danwerner21/ISA_IO/VIDEO/pico/README.md

## This work is derived from the AppleII VGA project located here: https://github.com/markadev/AppleII-VGA
## Many thanks to Mark Aikens and David Kuder for their work on this project

# Set Up Raspberry Pi Pico SDK and build the firmware

## Windows Subsystem for Linux (WSL)
Windows Subsystem for Linux (WSL) allows you to install a complete Ubuntu terminal environment in minutes on your Windows machine, allowing you to develop cross-platform applications without leaving Windows. [Install Ubuntu on WSL for Windows](https://ubuntu.com/tutorials/install-ubuntu-on-wsl2-on-windows-10#1-overview)

## Install development packages
```shell
sudo apt update
sudo apt install -y build-essential git cmake gcc-arm-none-eabi
```

## Download the Pico SDK
```shell
git clone https://github.com/raspberrypi/pico-sdk.git ~/pico-sdk
git -C ~/pico-sdk submodule update --init
```

## Build the firmware 
```shell
cd pico
mkdir build
cd build
cmake  ..
make
## Install the firmware
Hold down the BOOTSEL button and connect the Raspberry Pi Pico to your PC via micro USB cable. Once Pico is
connected release the BOOTSEL button. Pi Pico should be connected to PC with USB mass storage device mode.

A disk volume called RPI-RP2 will appear on your computer. Drag and drop the applevga.uf2 file to that volume.
RPI-RP2 will unmount and Pico will start the program.
