danwerner21/ISA_IO/VIDEO/pico/build/picotool/tmp/picotoolBuild-cfgcmd.txt

cmd='/usr/bin/cmake;--no-warn-unused-cli;-DCMAKE_MAKE_PROGRAM:FILEPATH=/usr/bin/gmake;-DPICO_SDK_PATH:FILEPATH=/home/dwerner/pico-sdk;-DPICOTOOL_NO_LIBUSB=1;-DPICOTOOL_FLAT_INSTALL=1;-DCMAKE_INSTALL_PREFIX=/mnt/fileserver/Vintage/Projects/ISA_IO/VIDEO/pico/build/_deps;-DCMAKE_RULE_MESSAGES=OFF;-DCMAKE_INSTALL_MESSAGE=NEVER;-GUnix Makefiles;<SOURCE_DIR><SOURCE_SUBDIR>'
