danwerner21/ISA_IO/SOUND/schematicv0.95.pdf

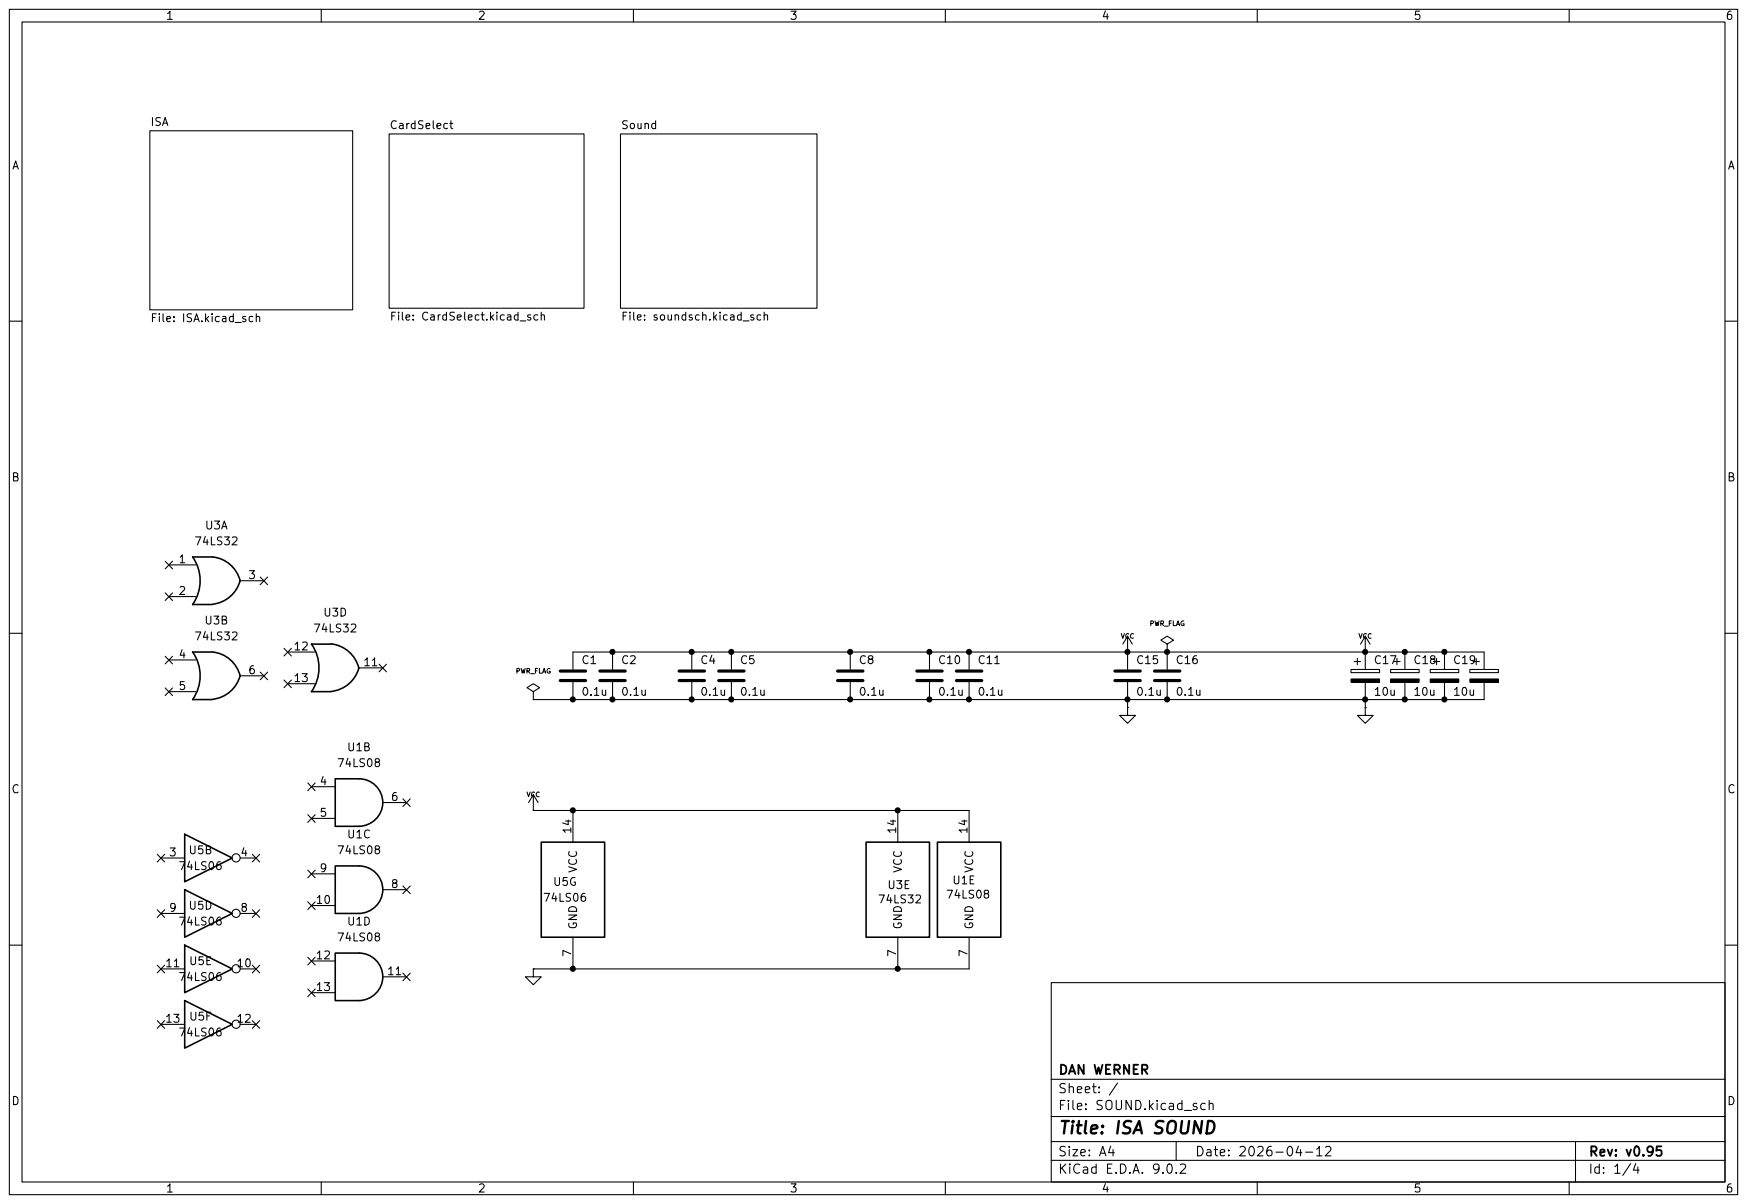
[picture p1: page 1]

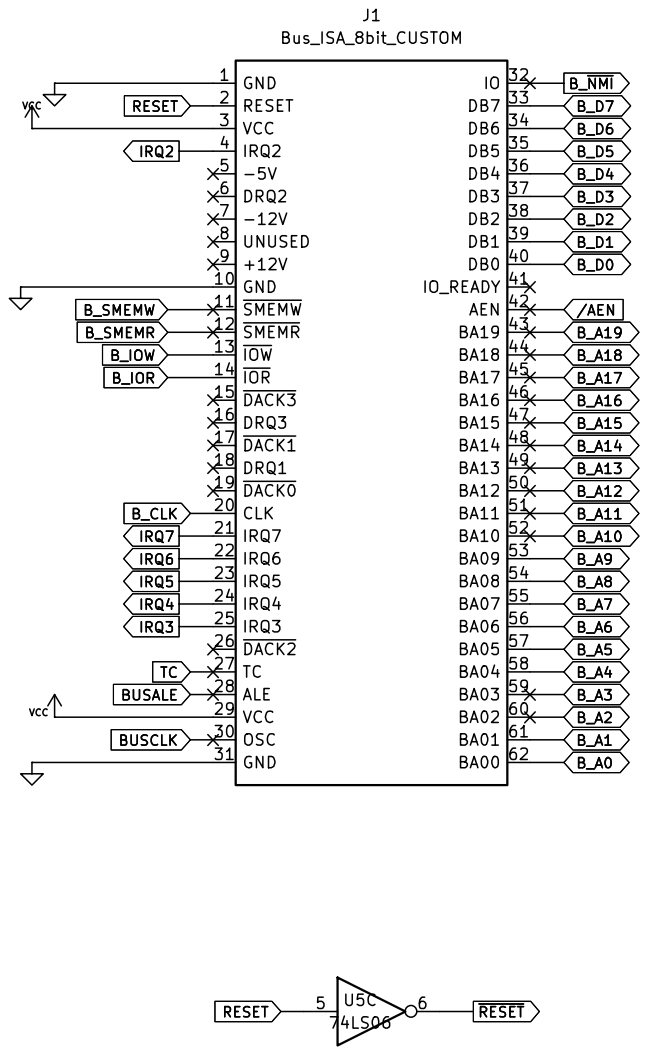
[picture p2: page 2]

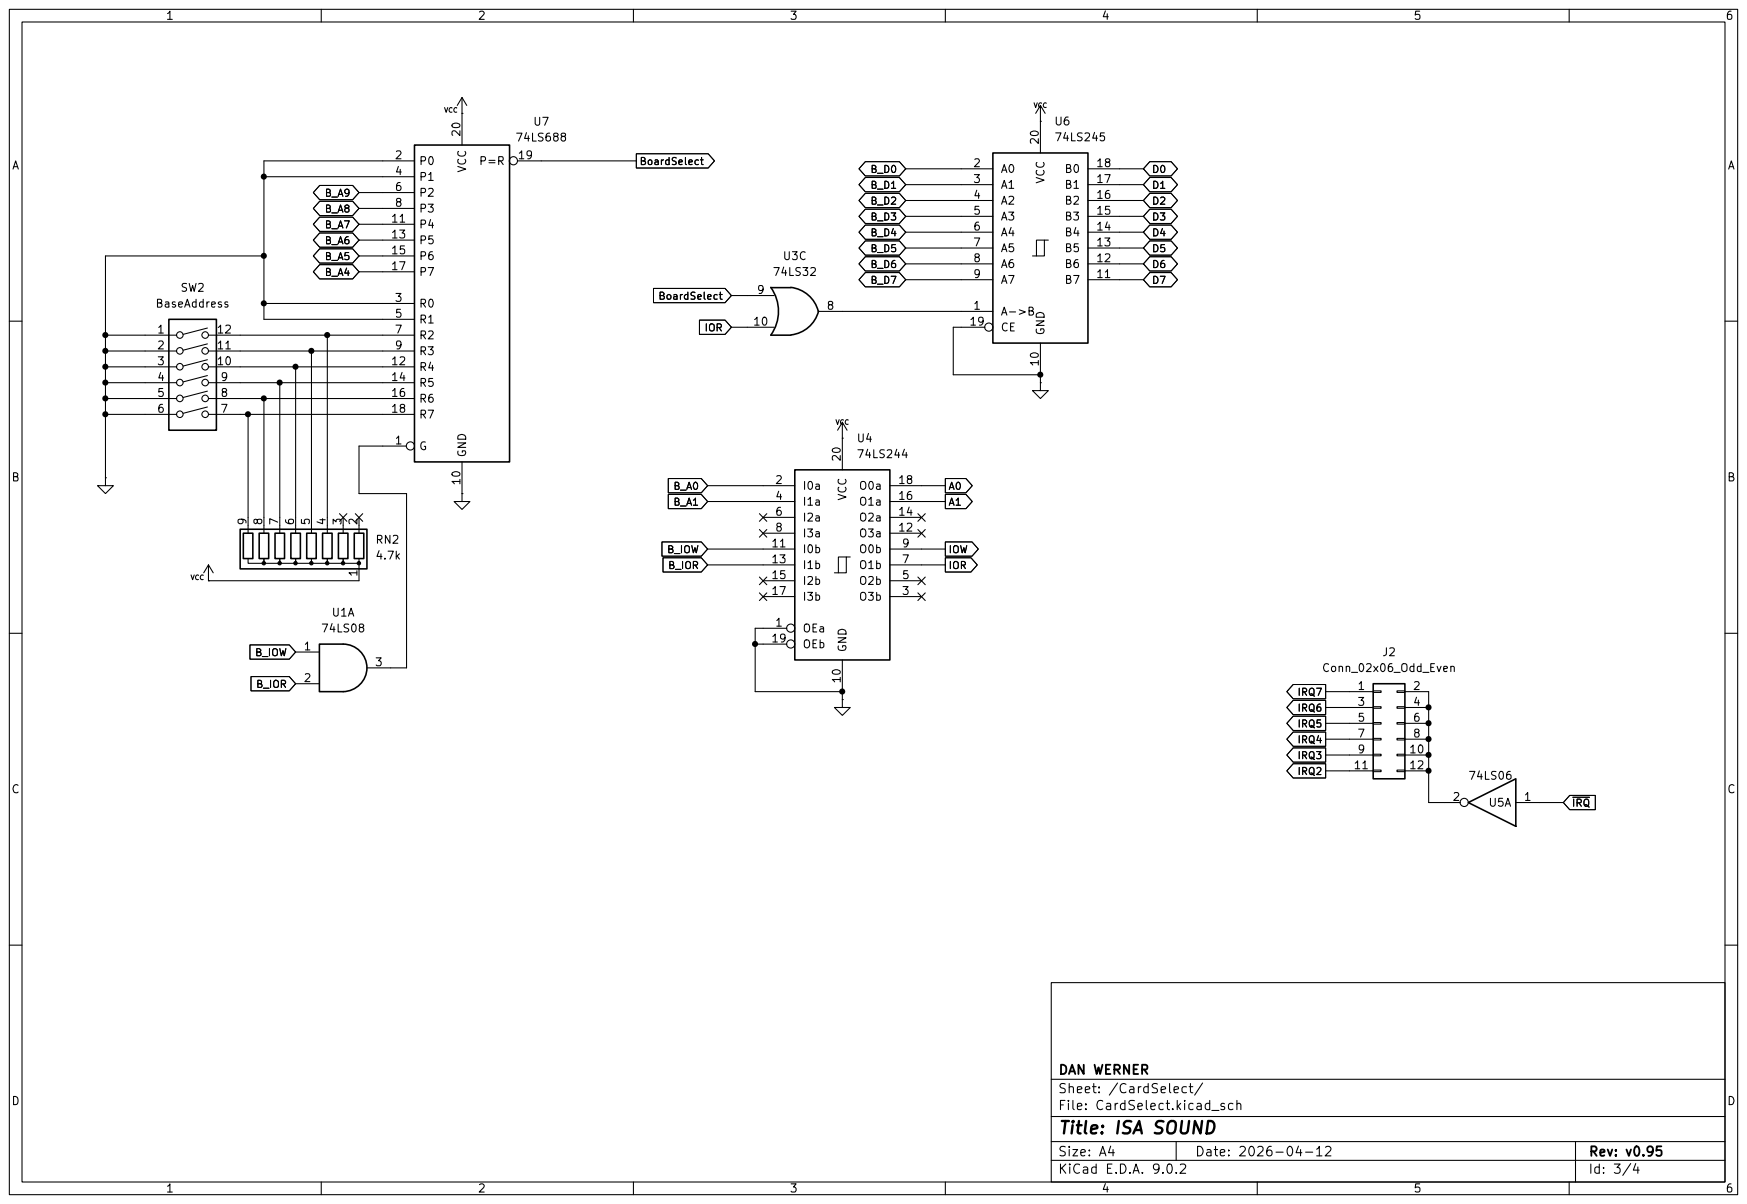
[picture p3: page 3]

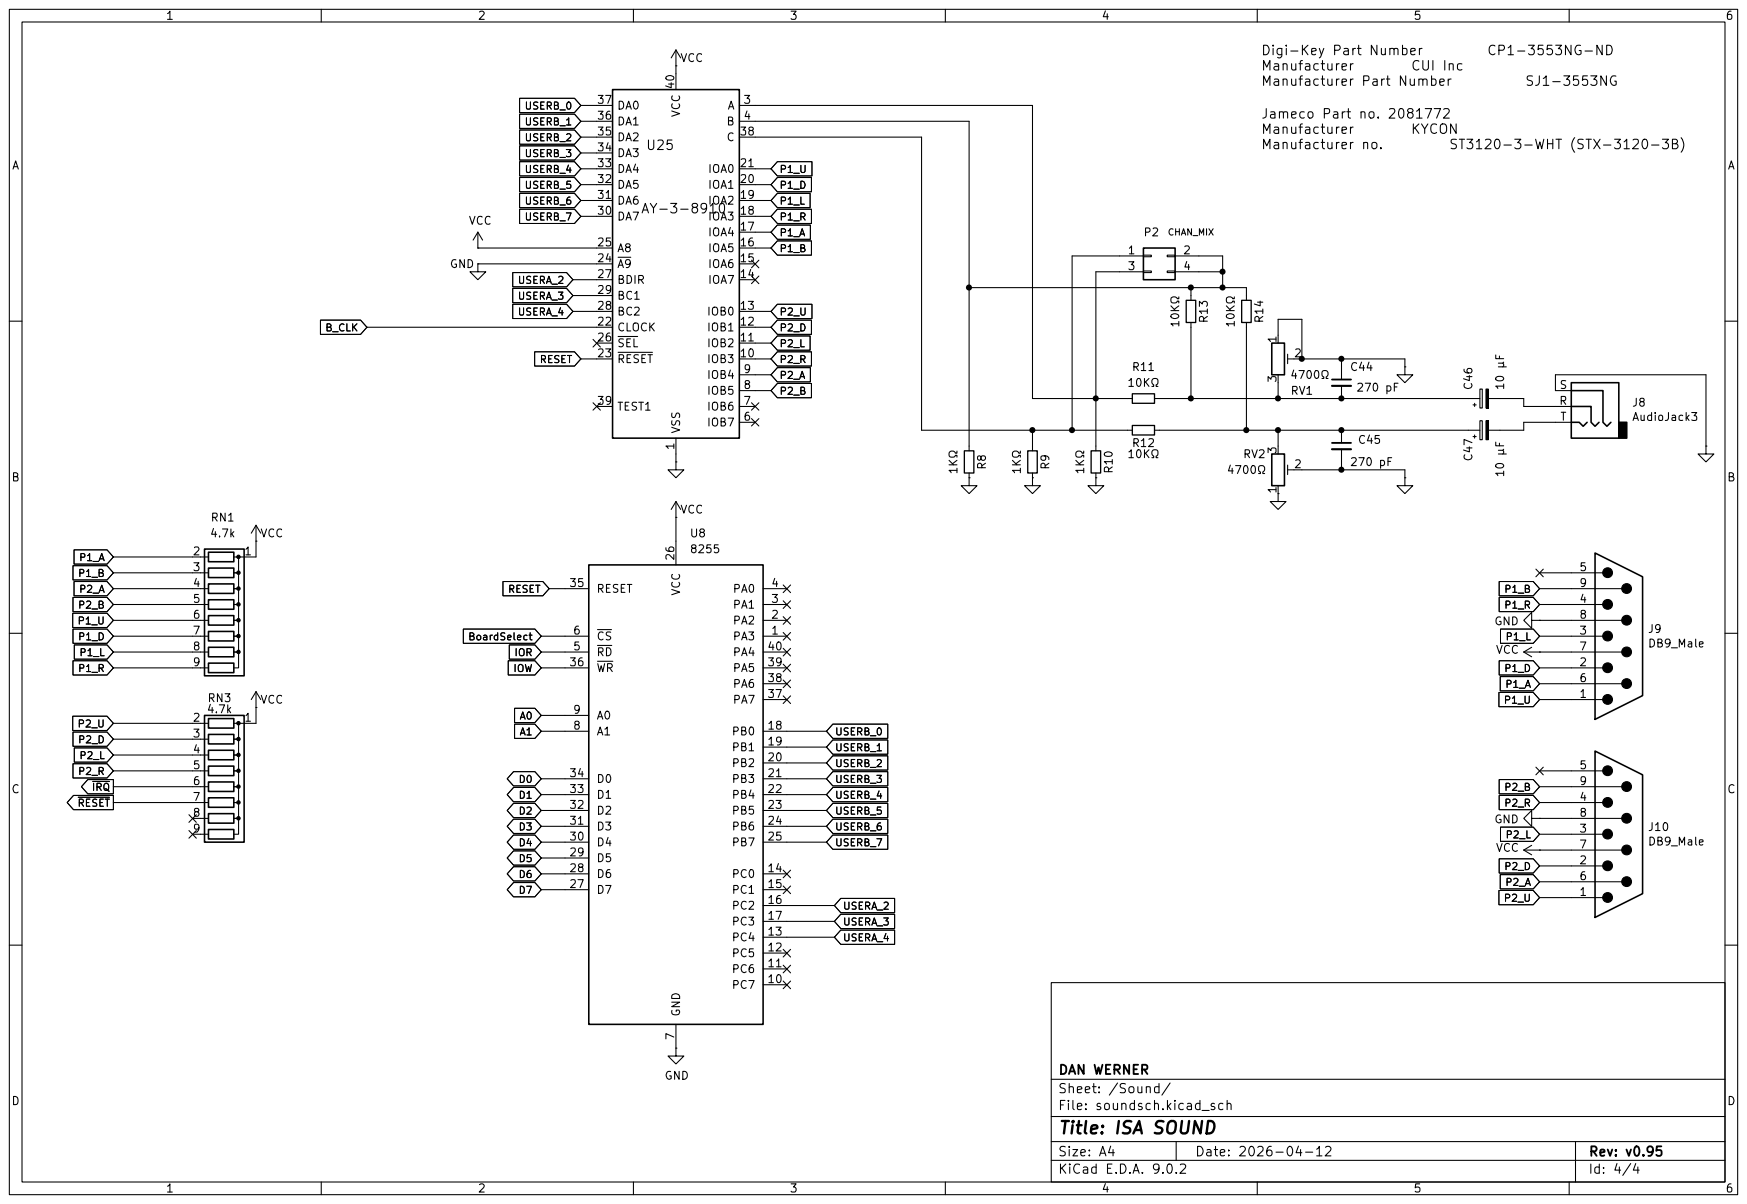
[picture p4: page 4]
