danwerner21/ISA_IO/SOUND/schematicv0.9.pdf

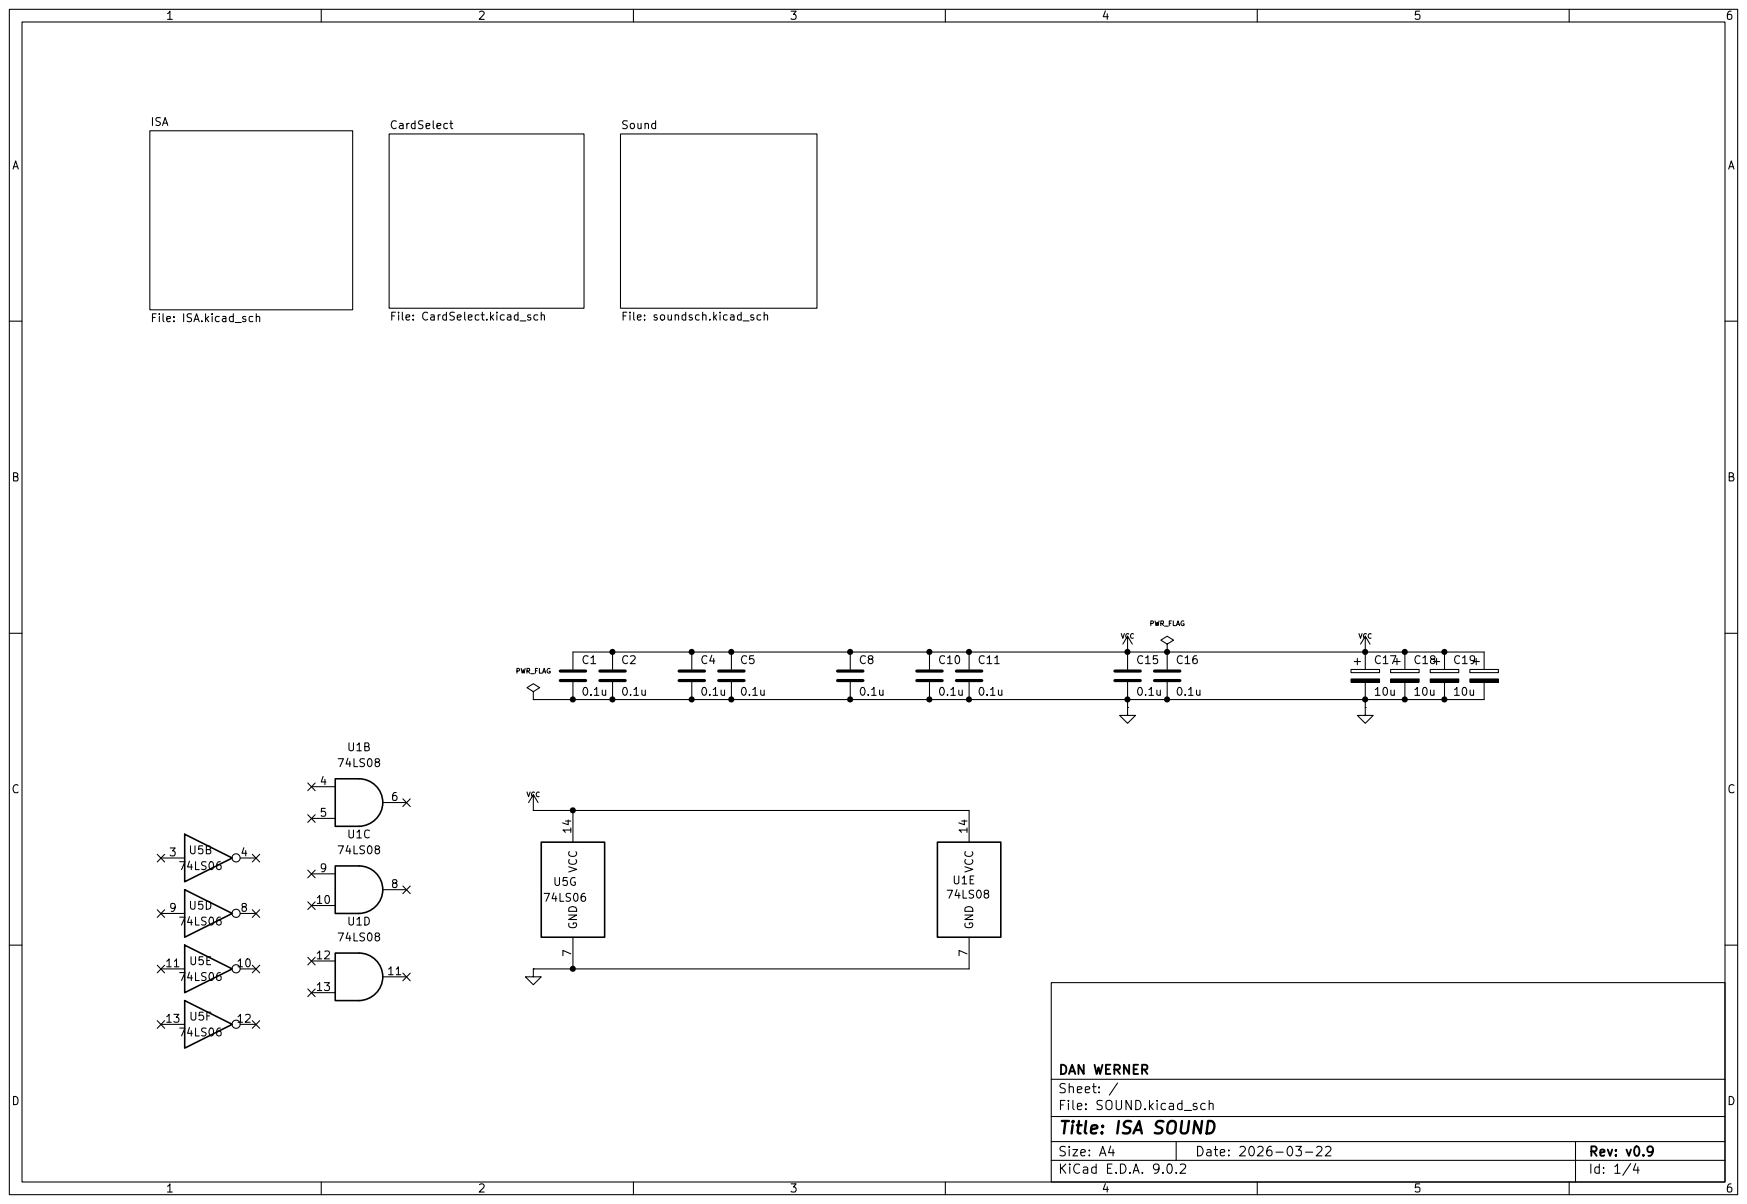
[picture p9: page 1]

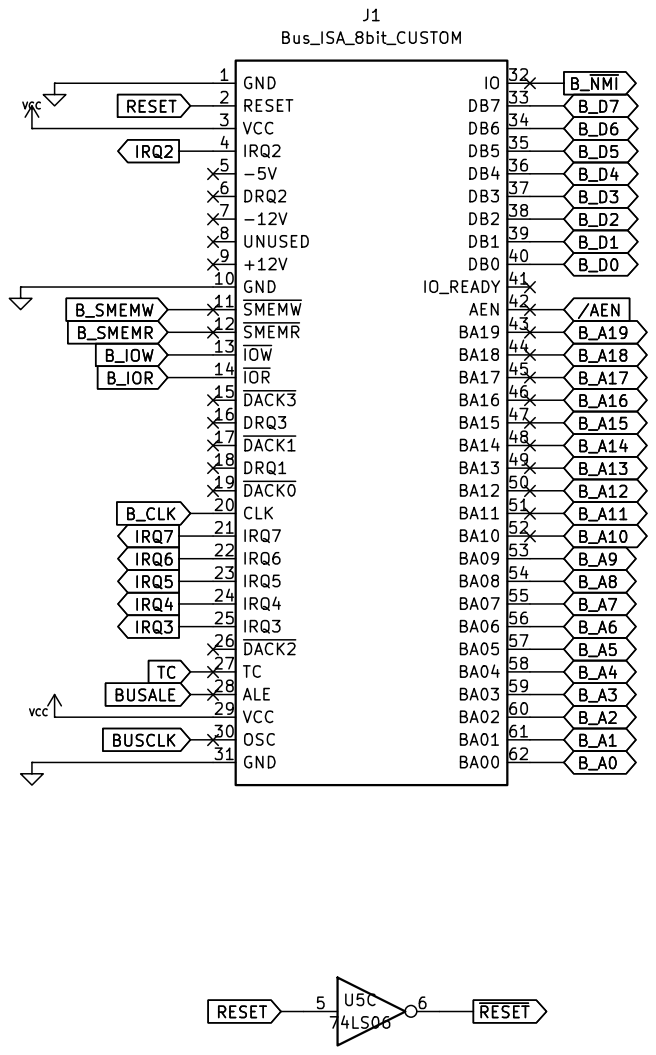
[picture p10: page 2]

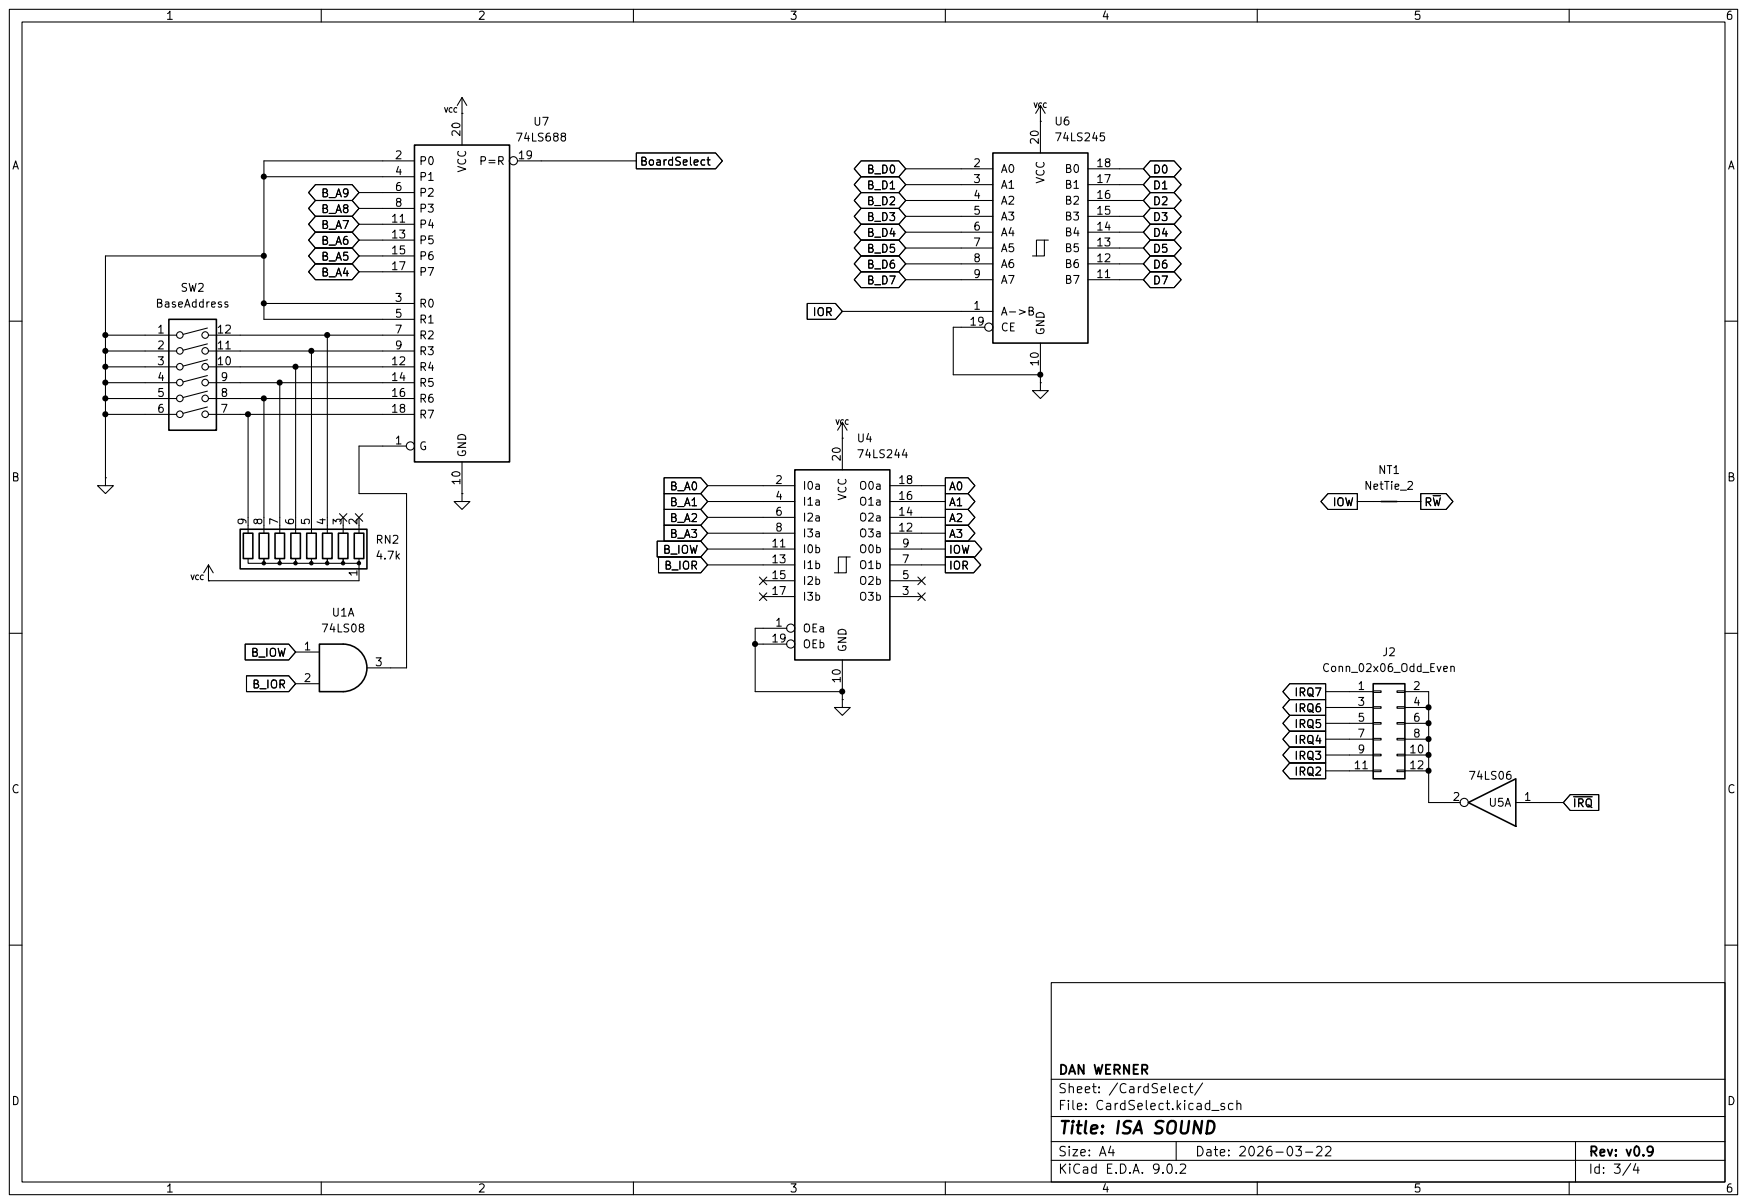
[picture p11: page 3]

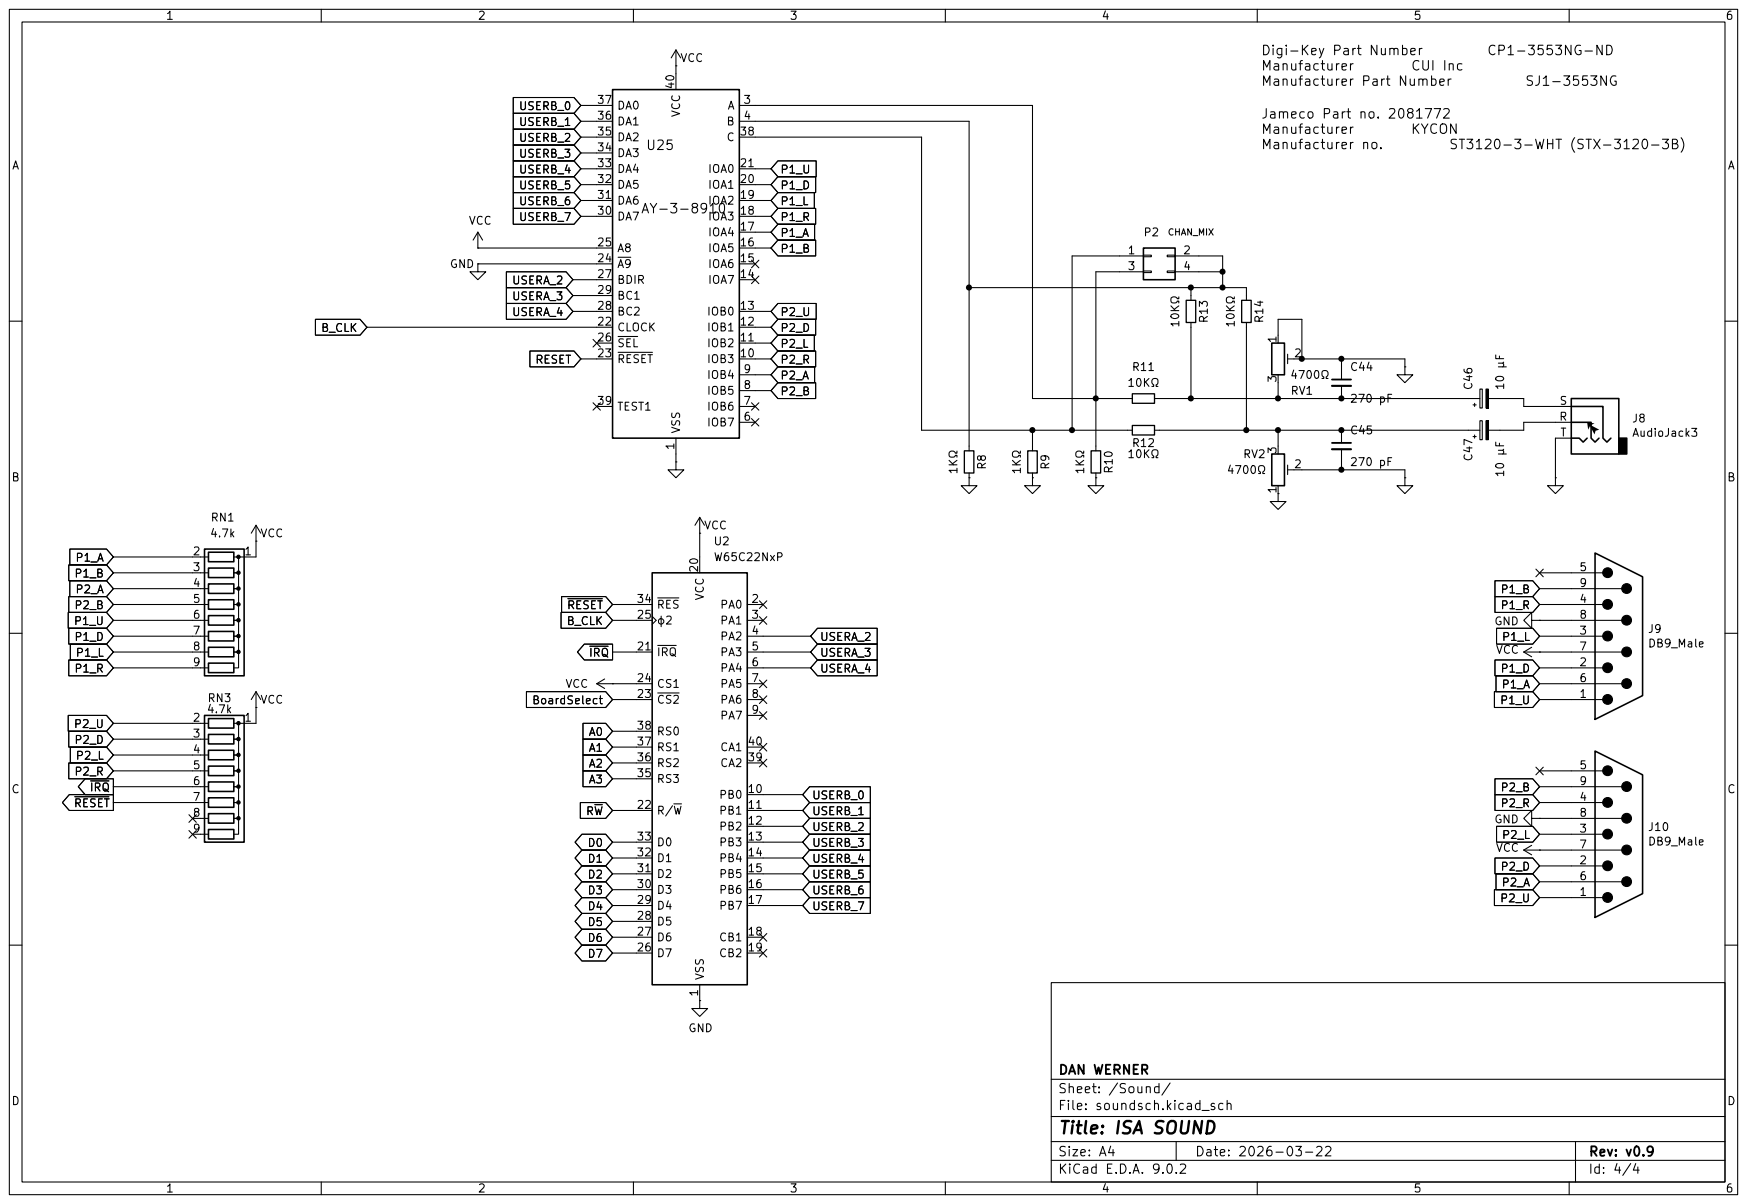
[picture p12: page 4]
