danwerner21/ISA_IO/VIDEO/HARDWARE/pcb-1.5.pdf

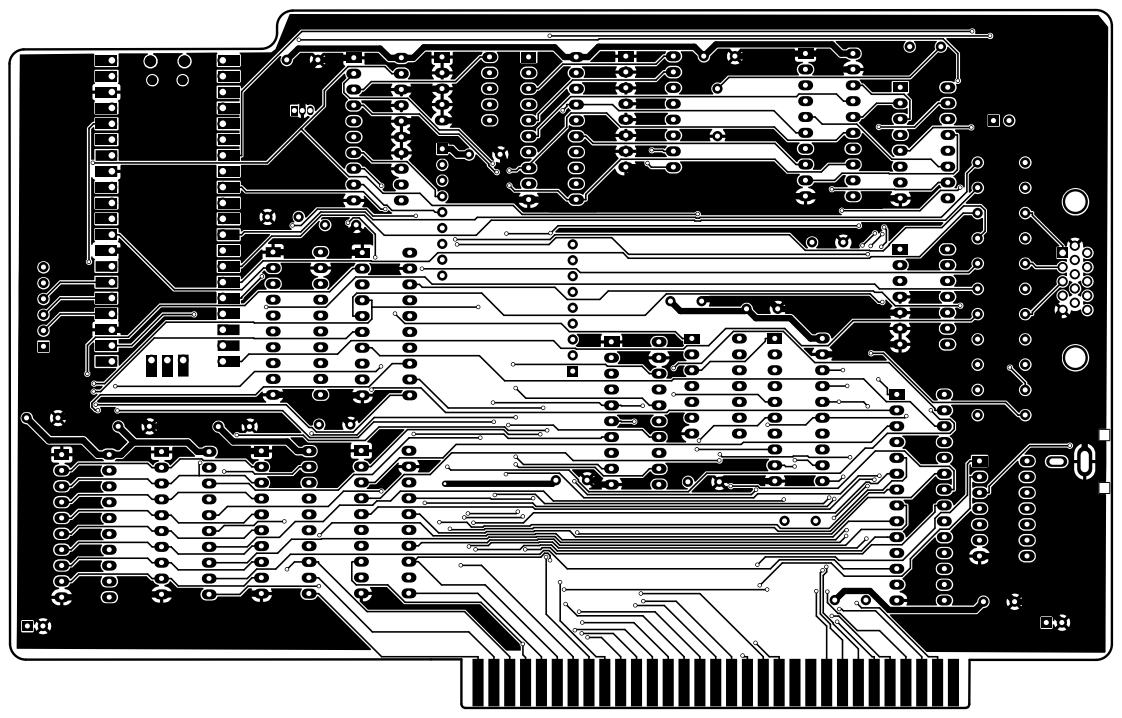
[picture p24: page 1]

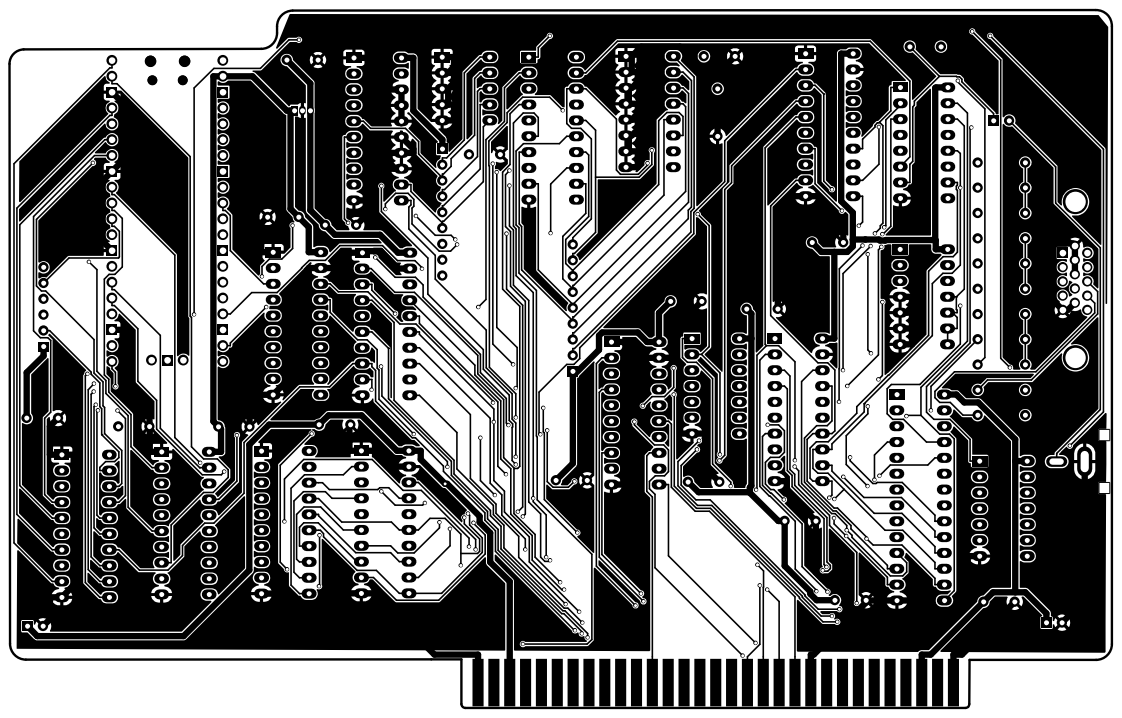
[picture p25: page 2]

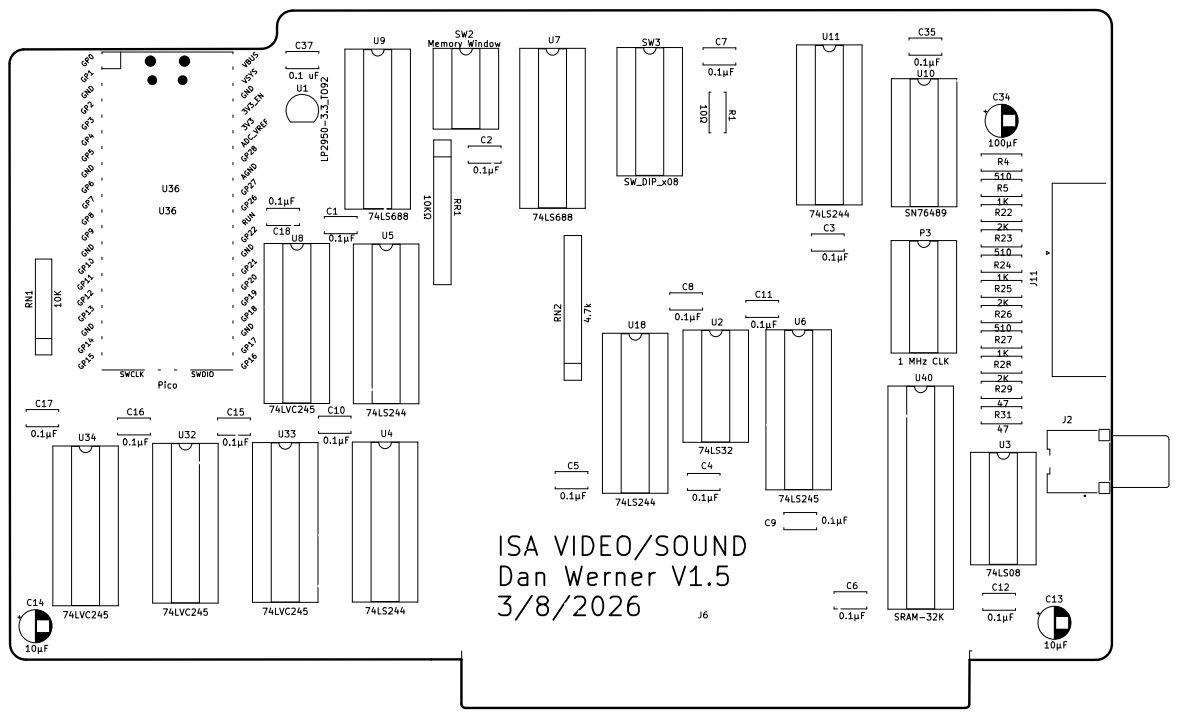
[picture p26: page 3]

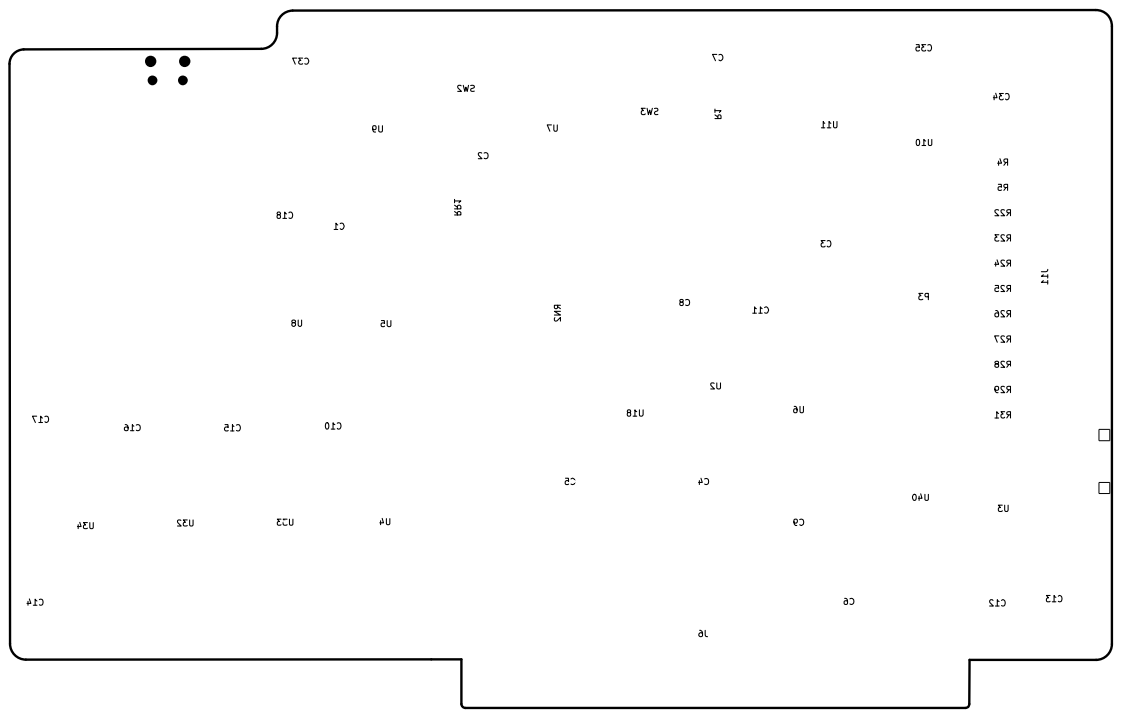
[picture p27: page 4]

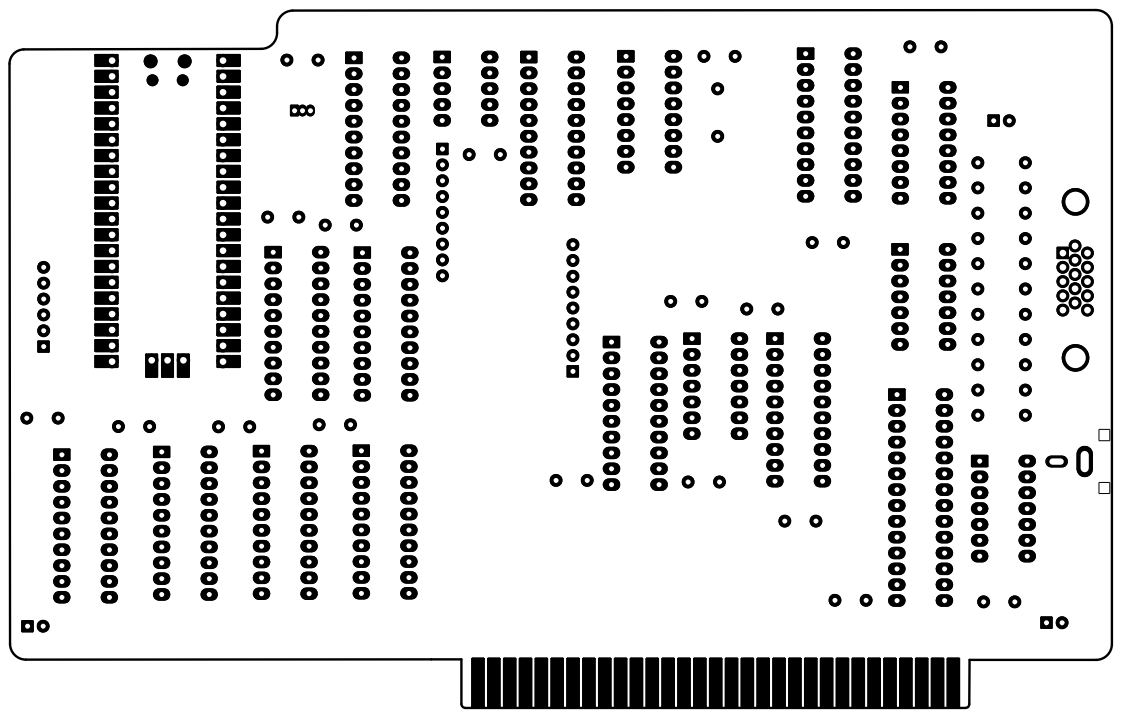
[picture p28: page 5]

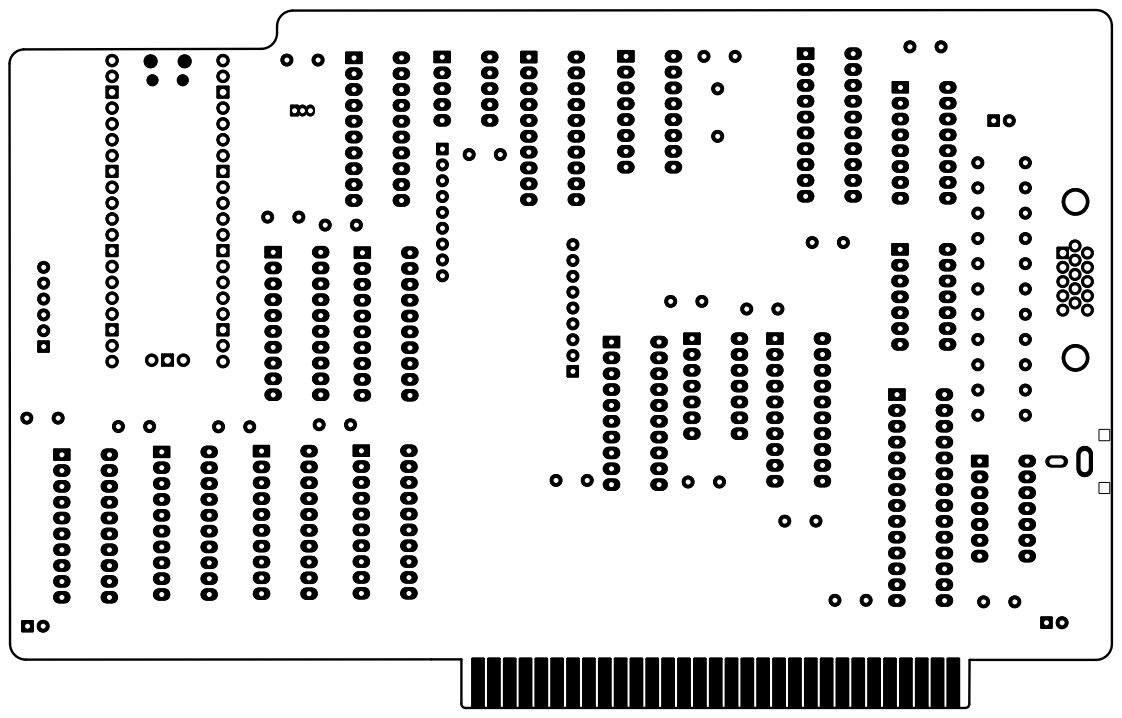
[picture p29: page 6]

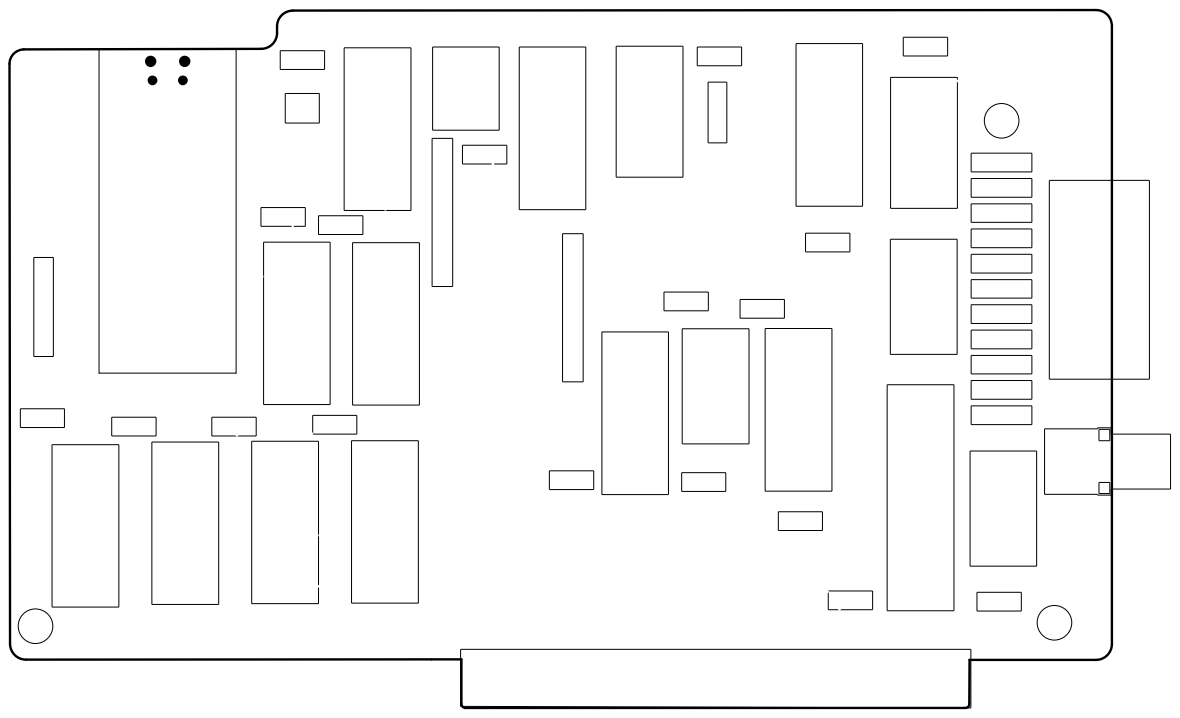
[picture p30: page 7]
