danwerner21/ISA_IO/VIDEO/HARDWARE/pcb-1.6.pdf

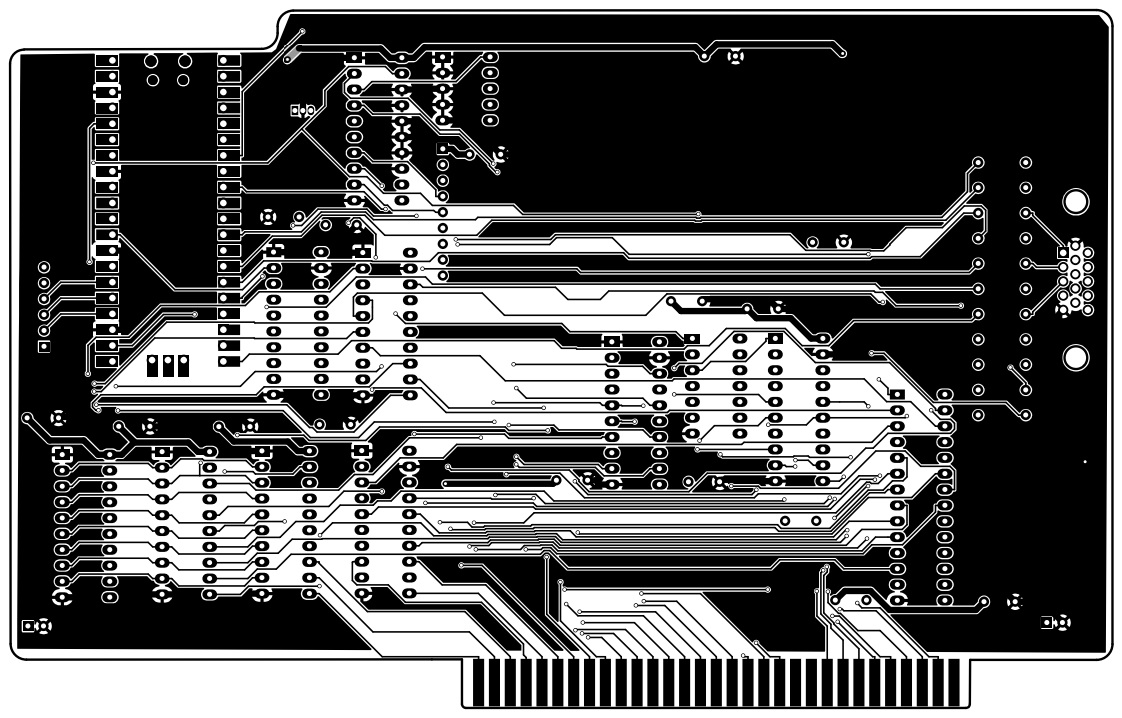
[picture p38: page 1]

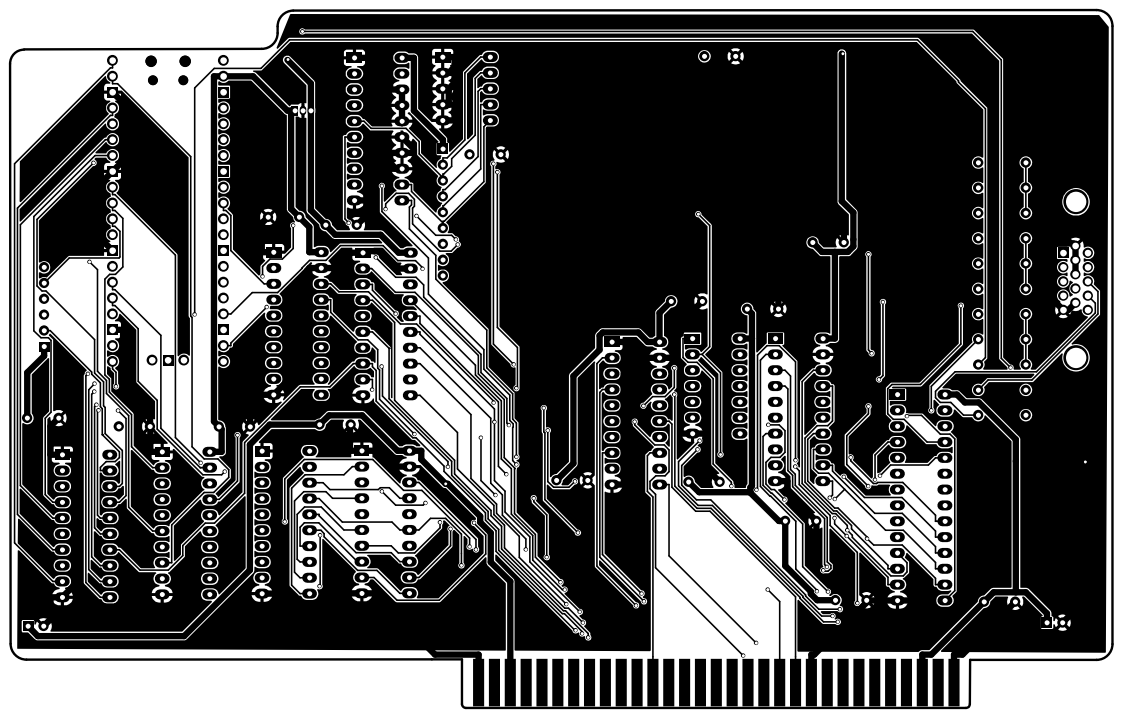
[picture p39: page 2]

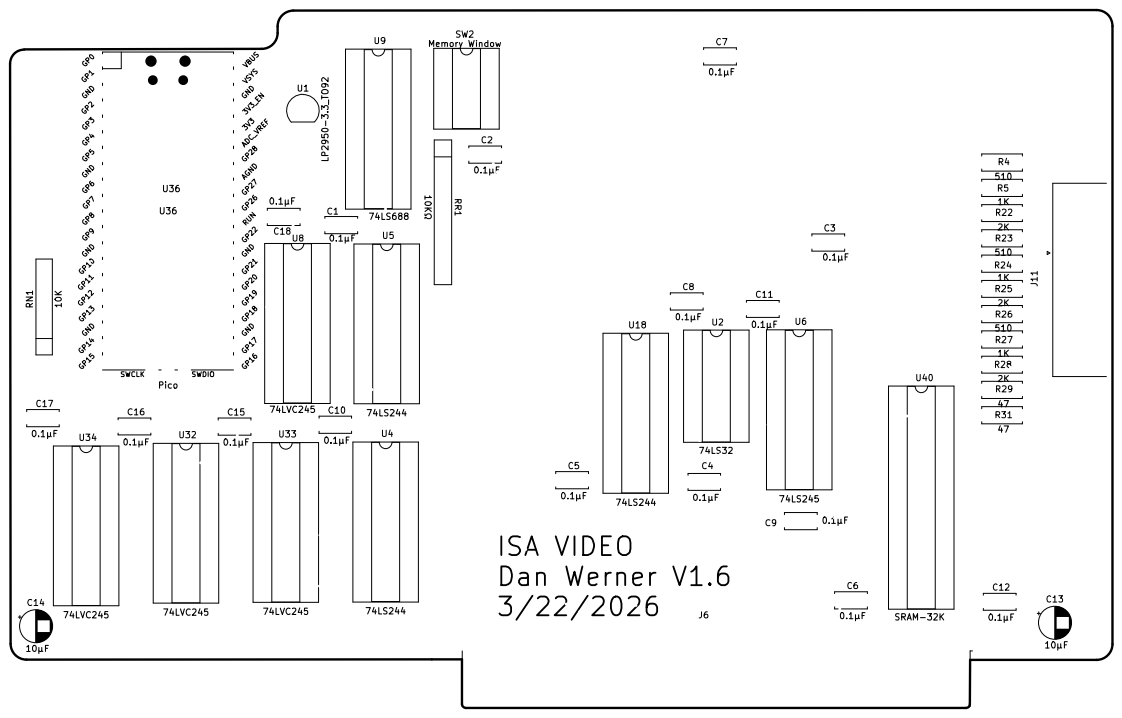
[picture p40: page 3]

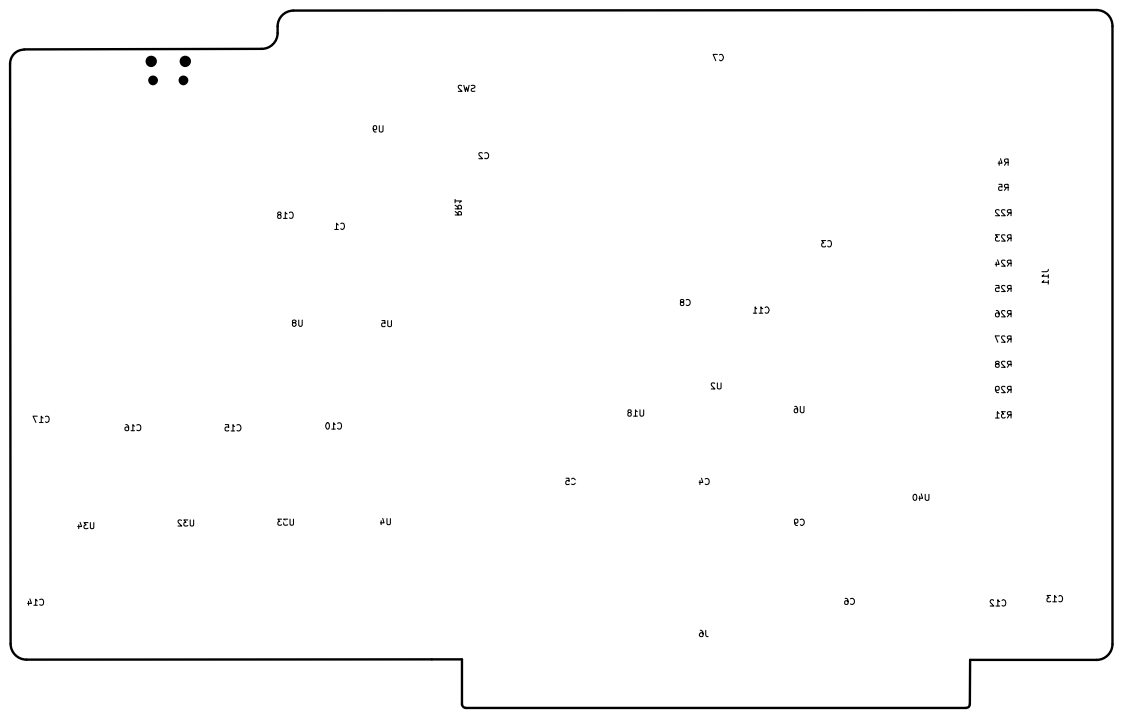
[picture p41: page 4]

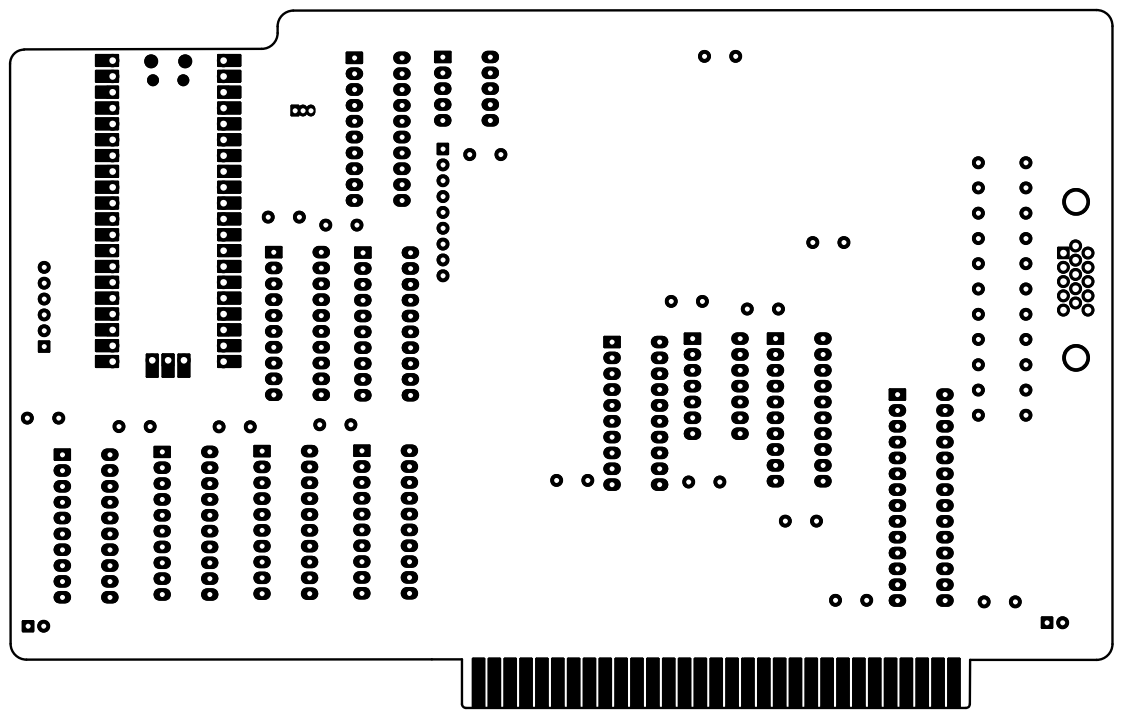
[picture p42: page 5]

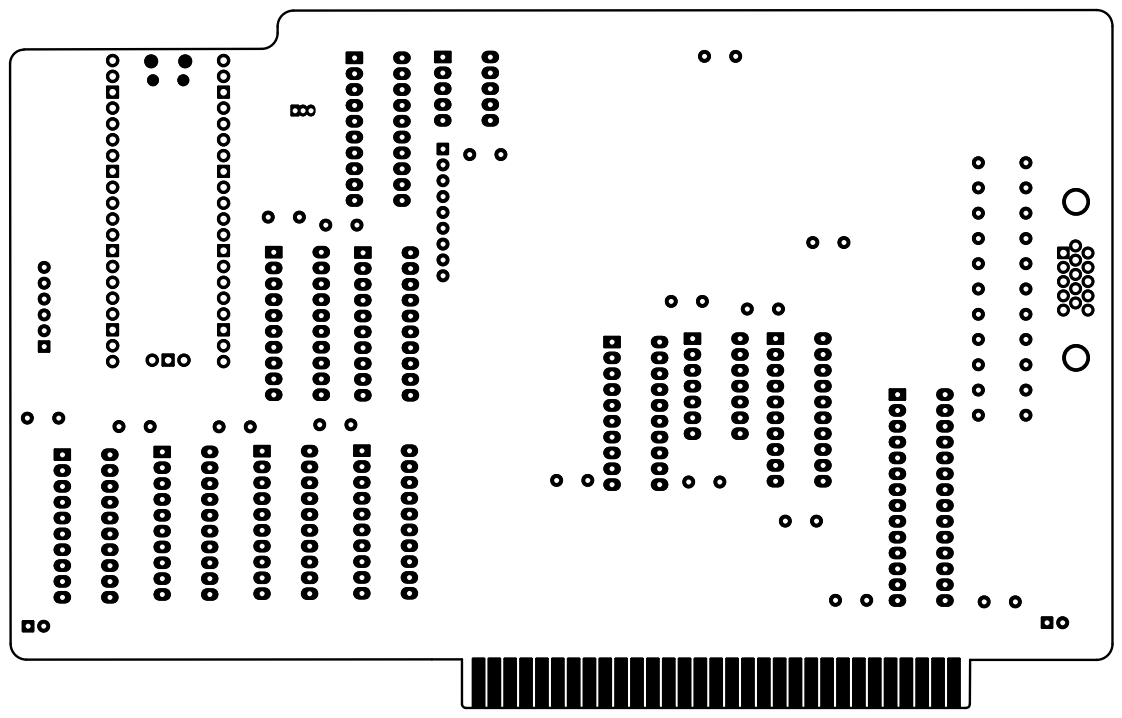
[picture p43: page 6]

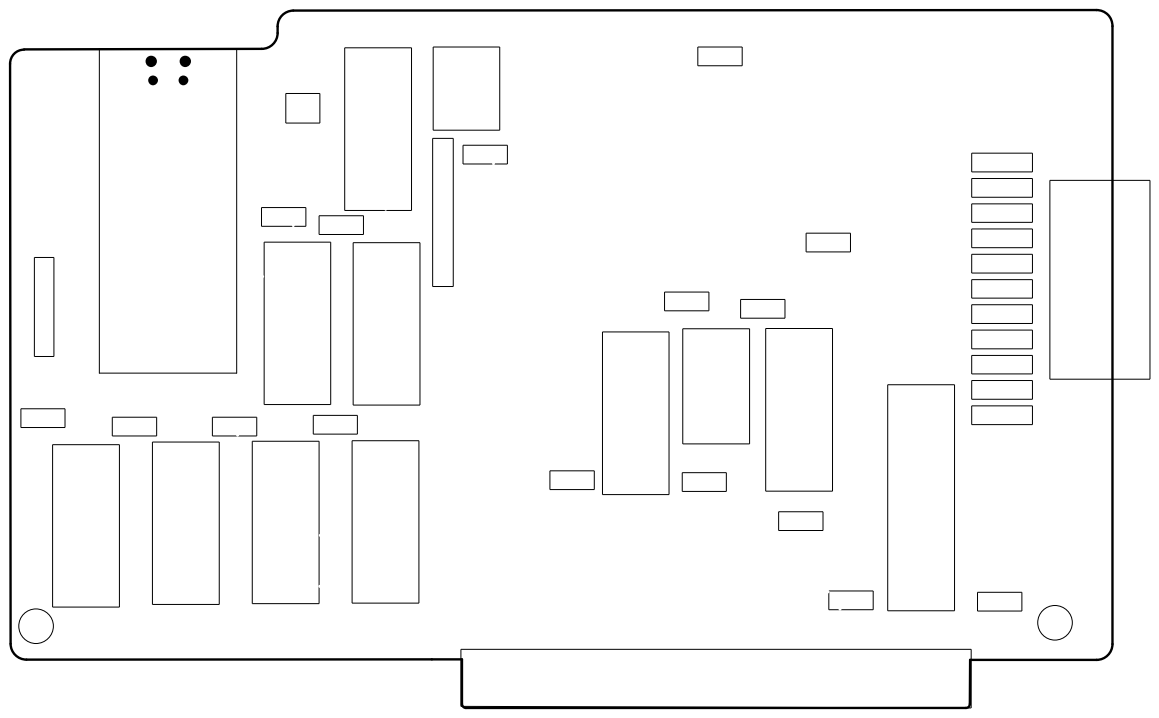
[picture p44: page 7]
