danwerner21/ISA_IO/VIDEO/HARDWARE/schematic-1.2.pdf

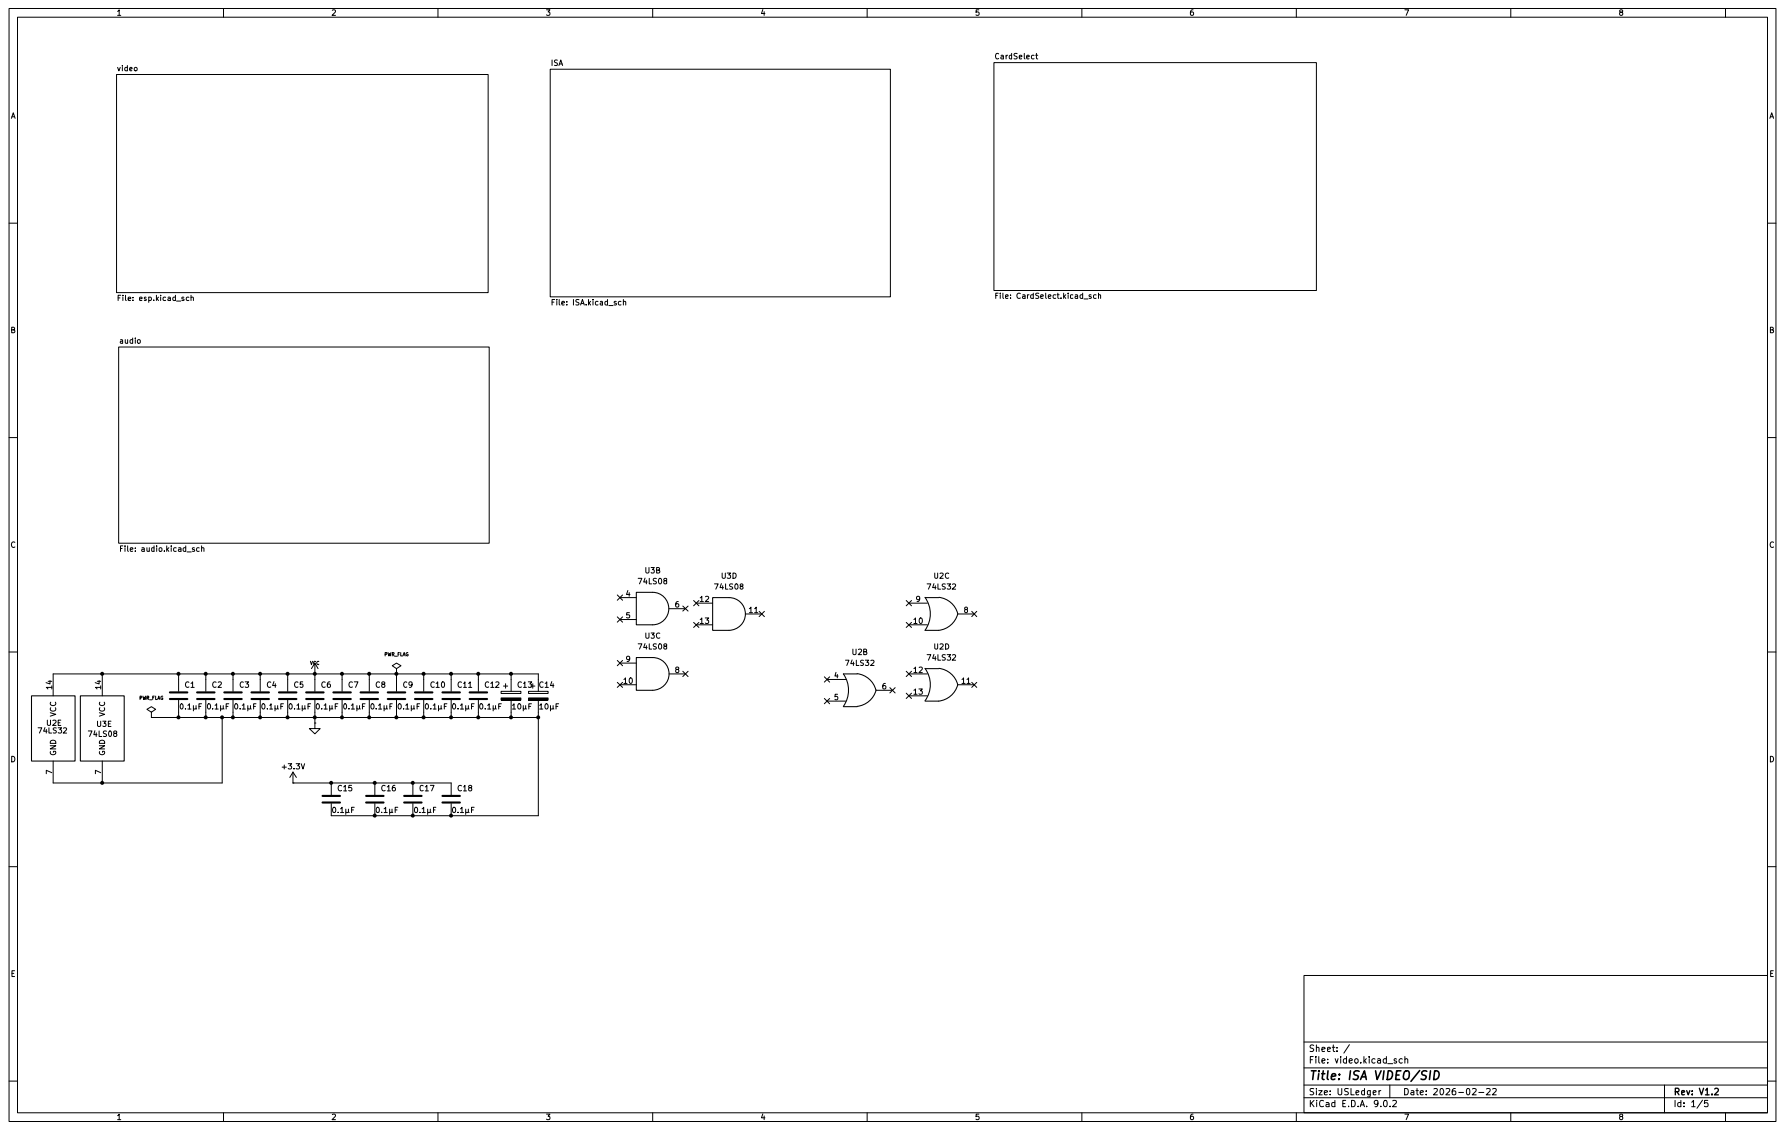
[picture p45: page 1]

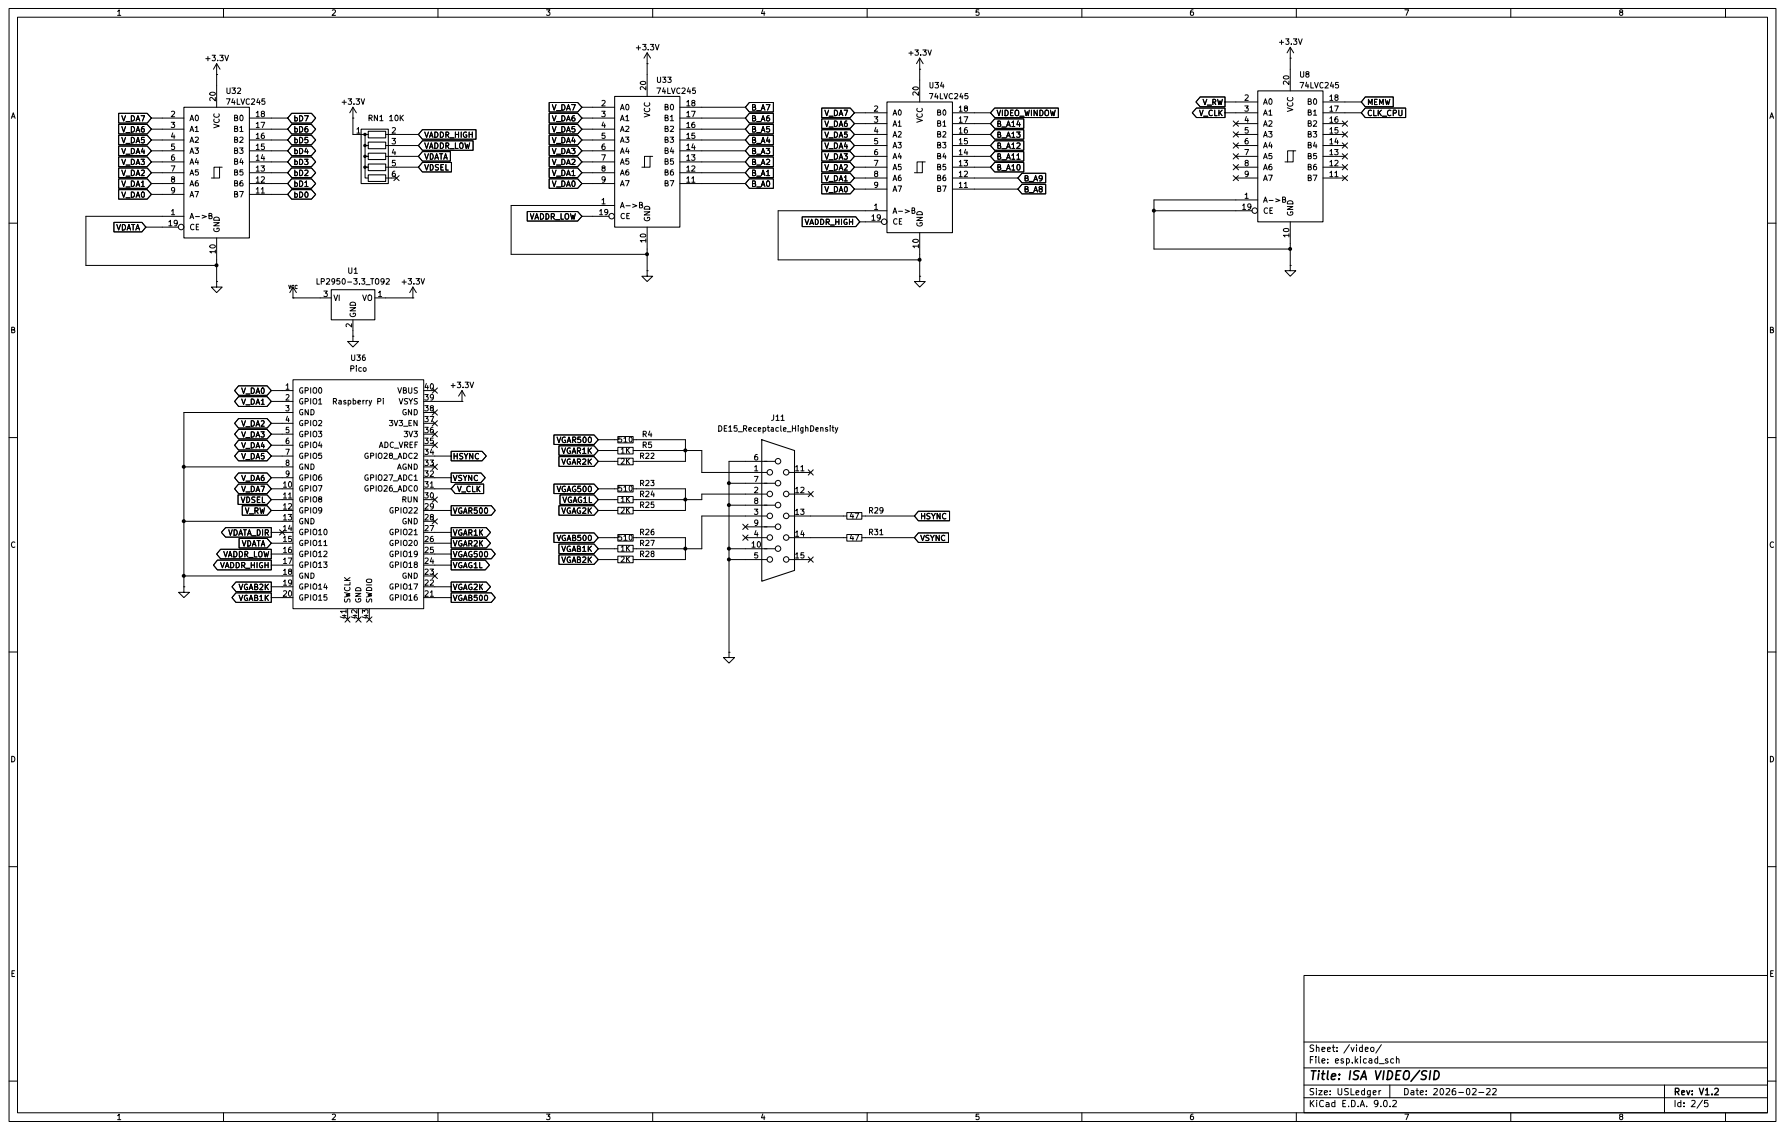
[picture p46: page 2]

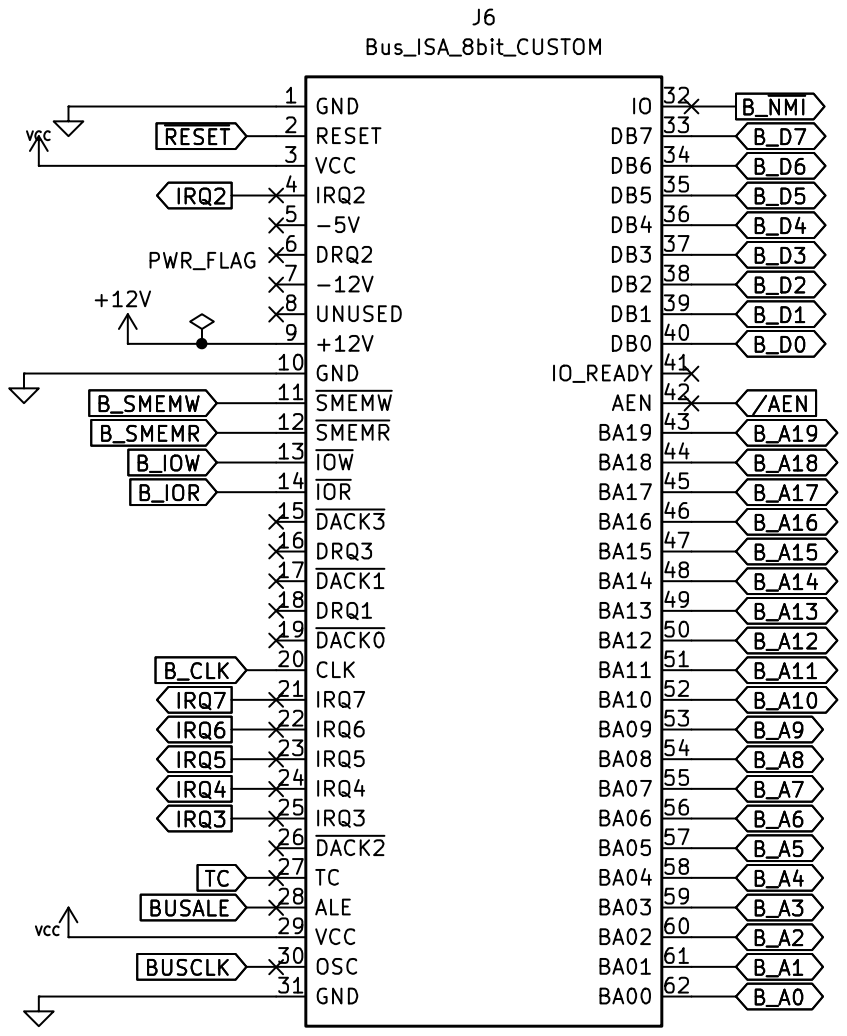
[picture p47: page 3]

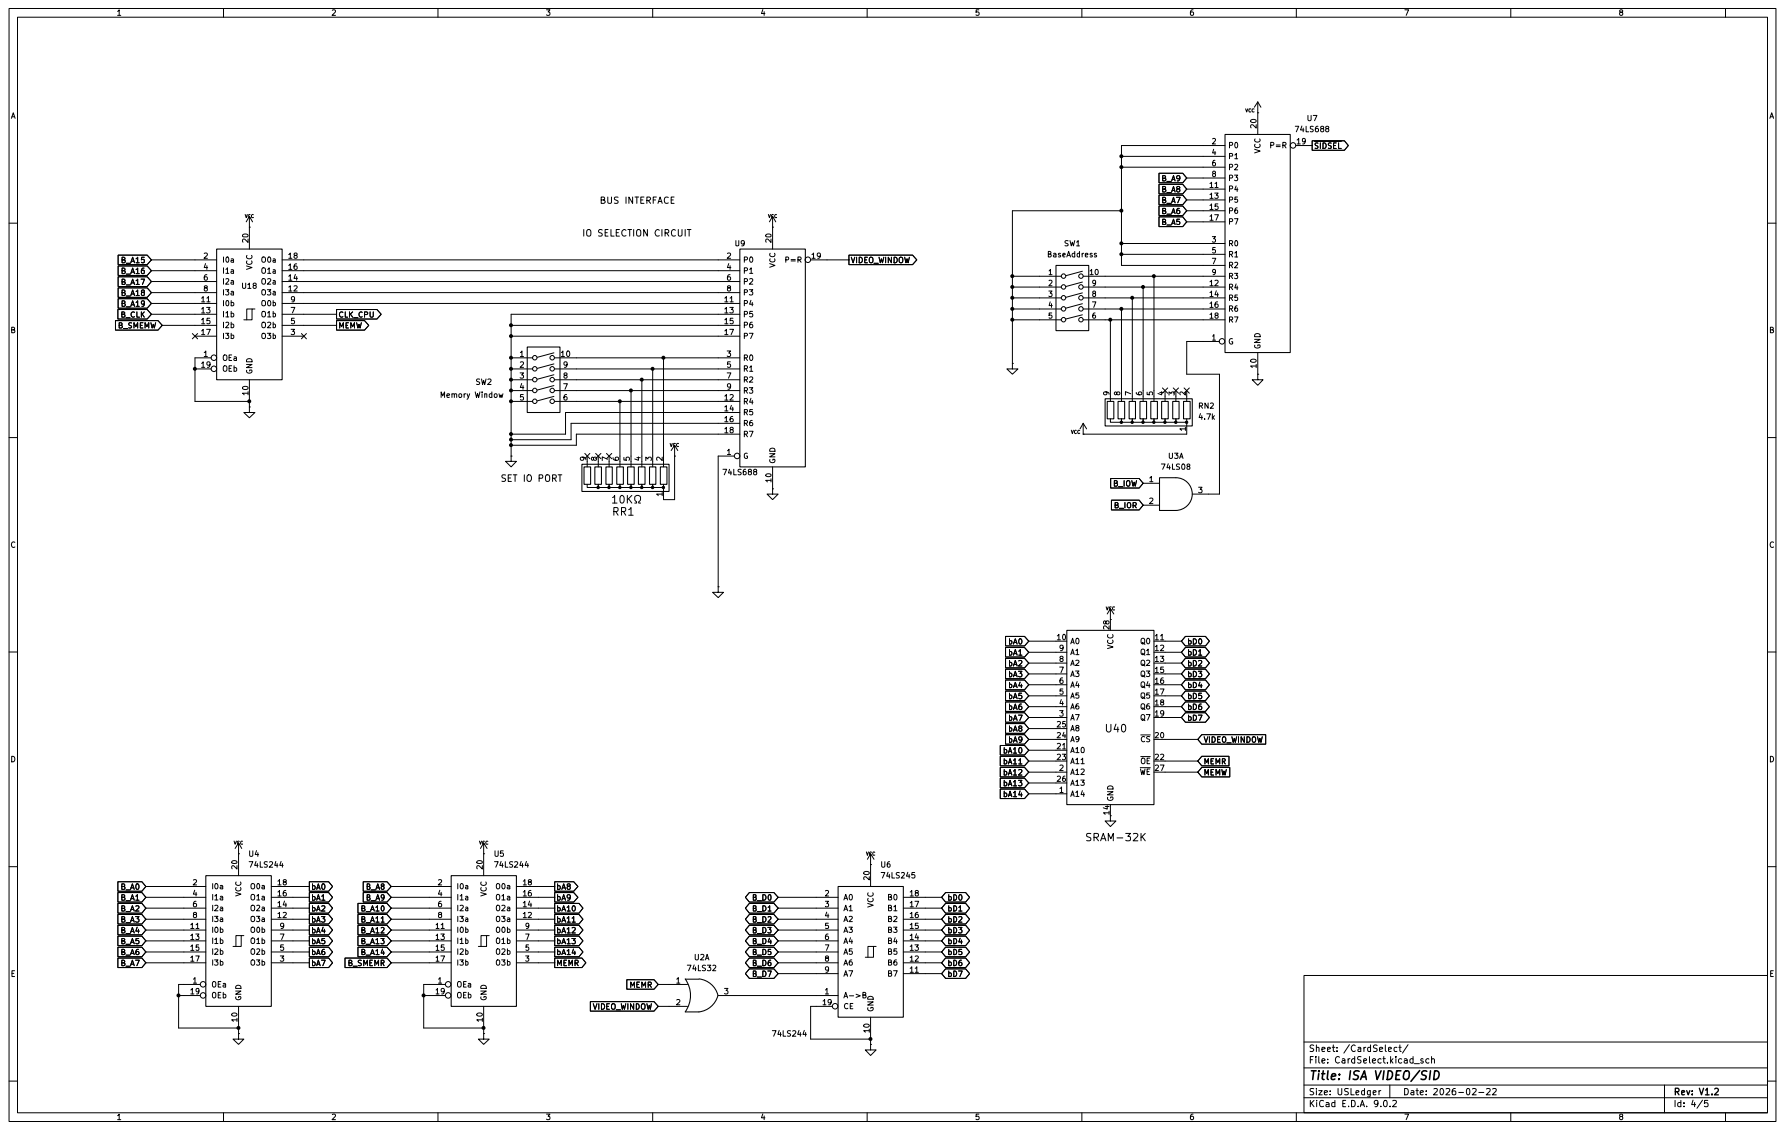
[picture p48: page 4]

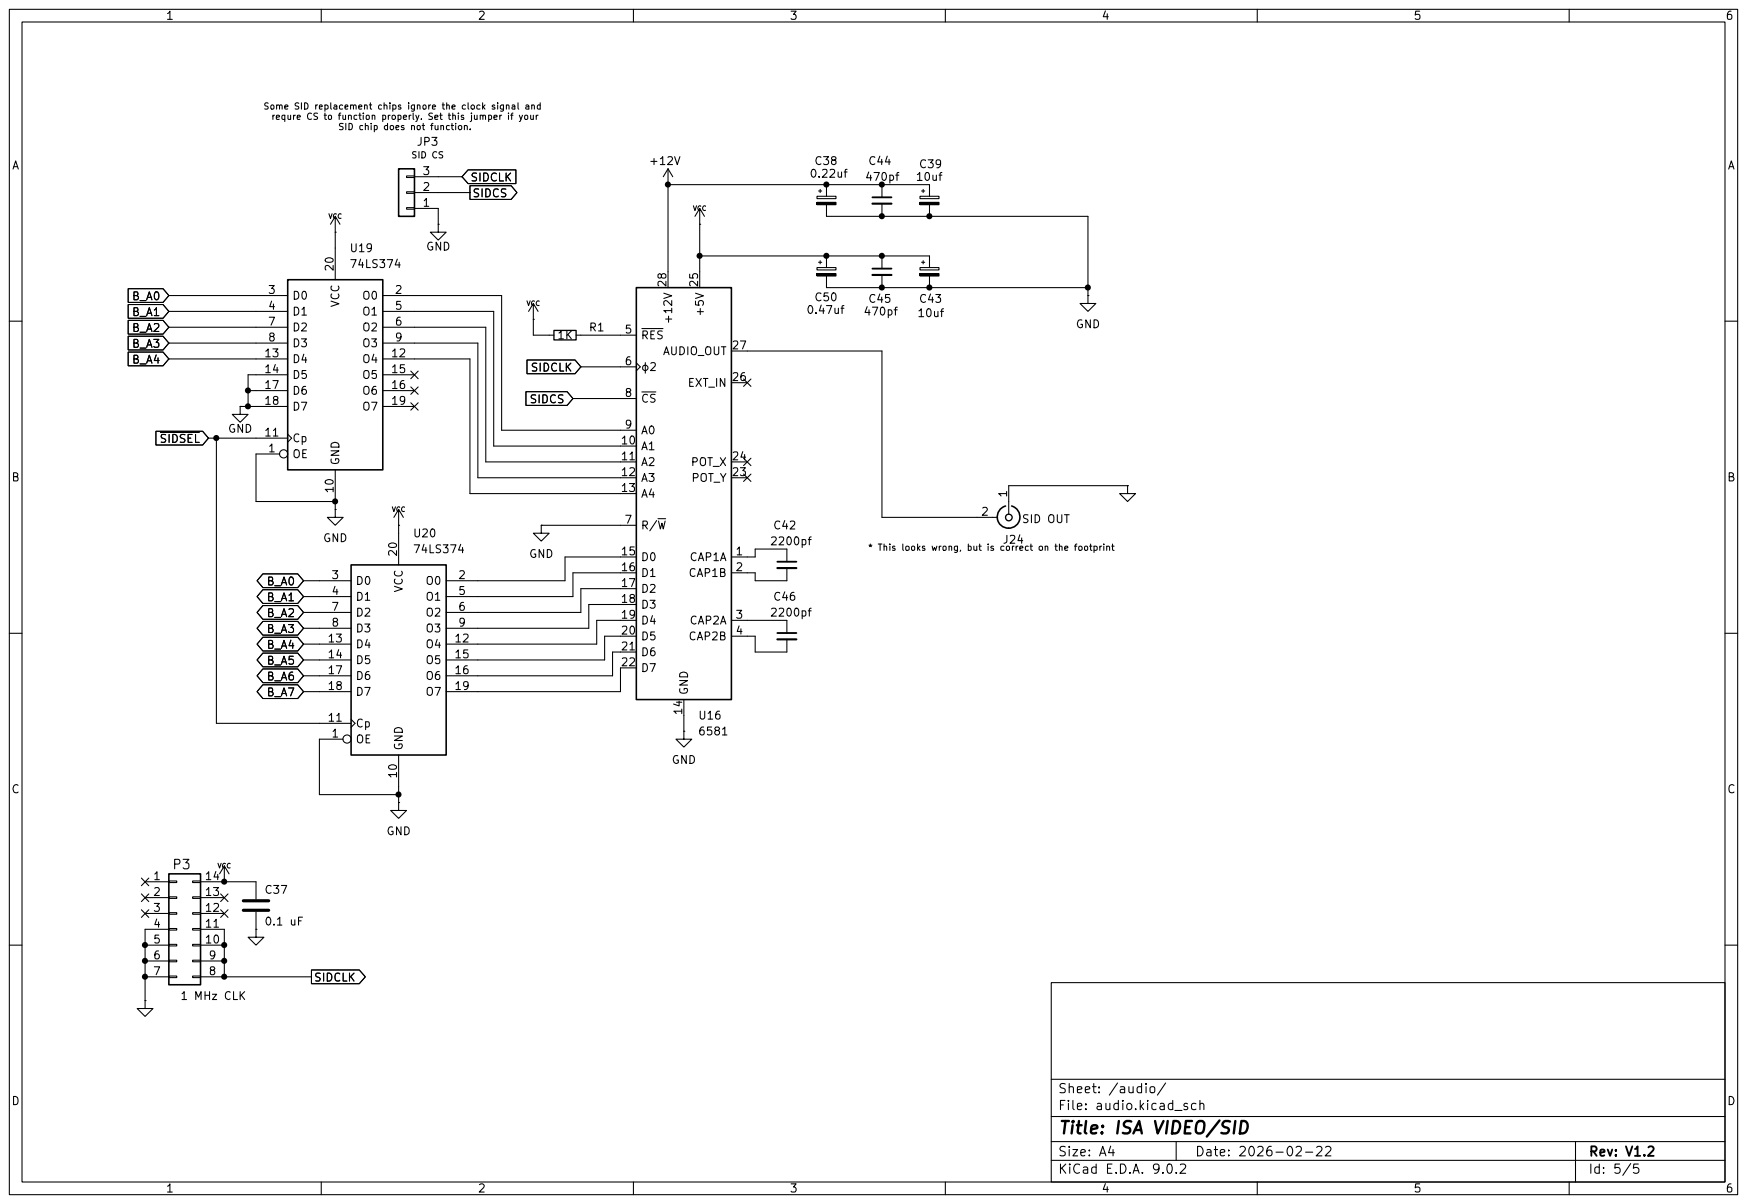
[picture p49: page 5]
