danwerner21/ISA_IO/VIDEO/HARDWARE/schematic-1.51.pdf

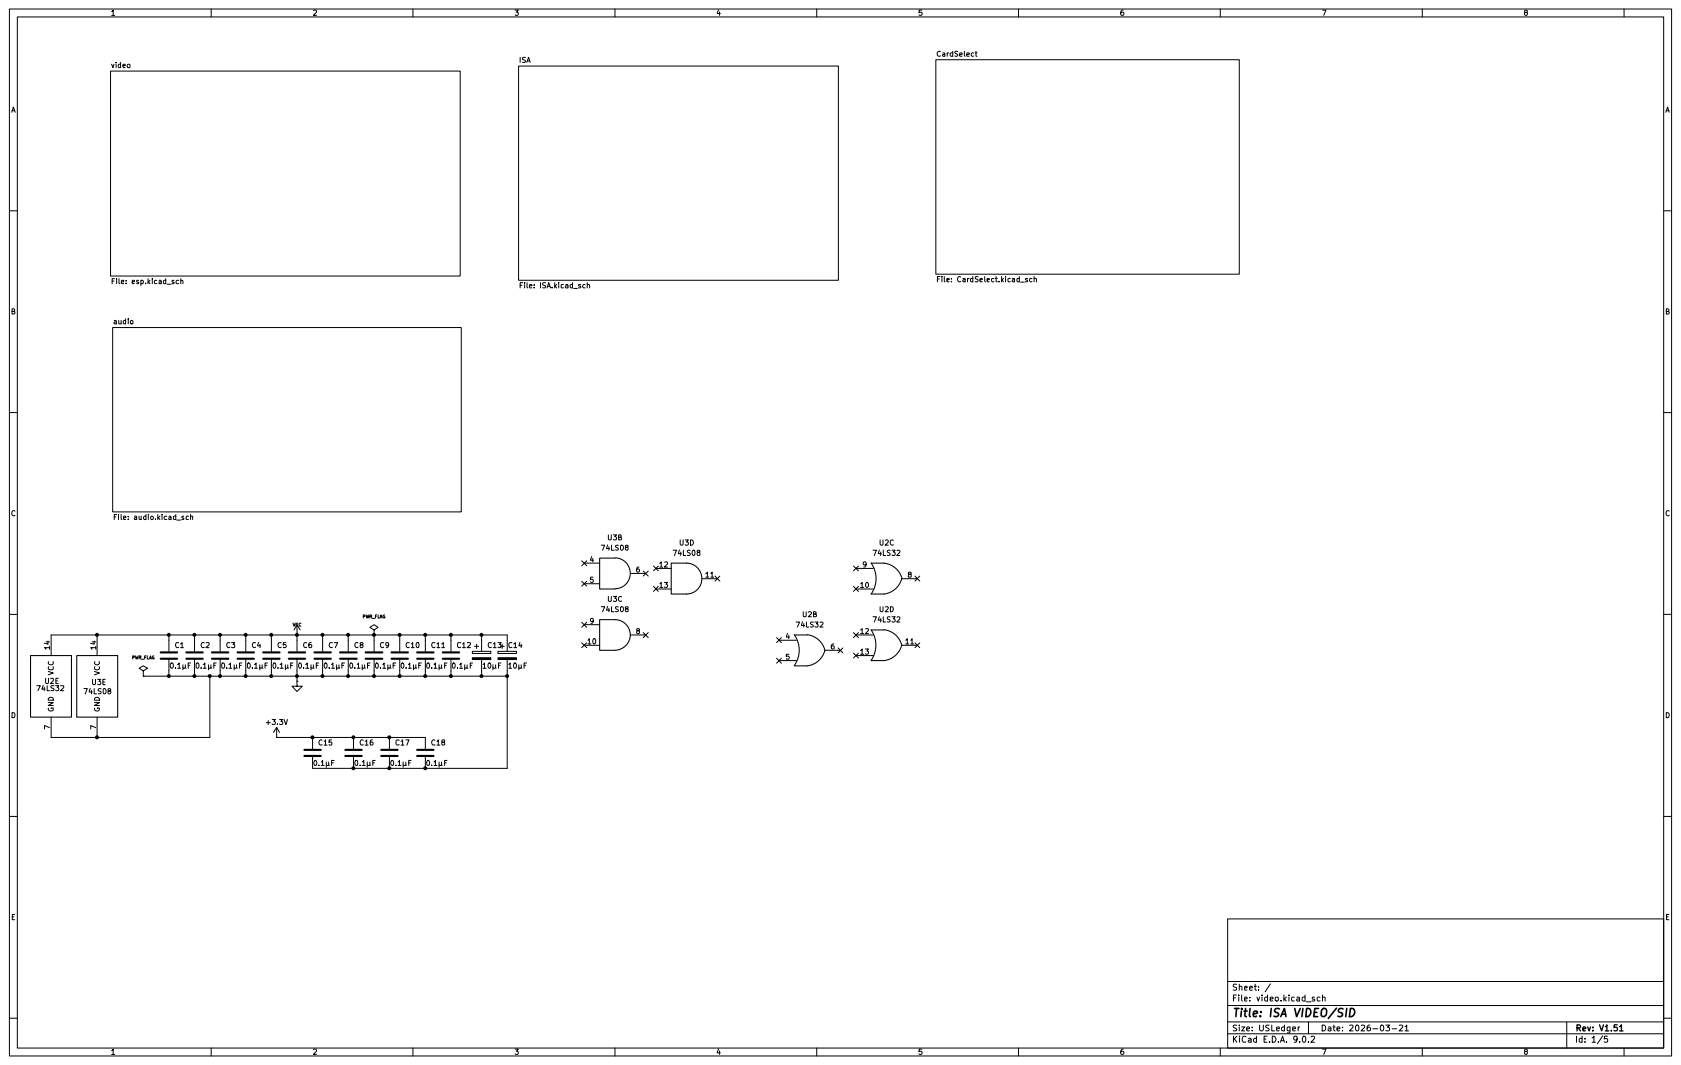
[picture p55: page 1]

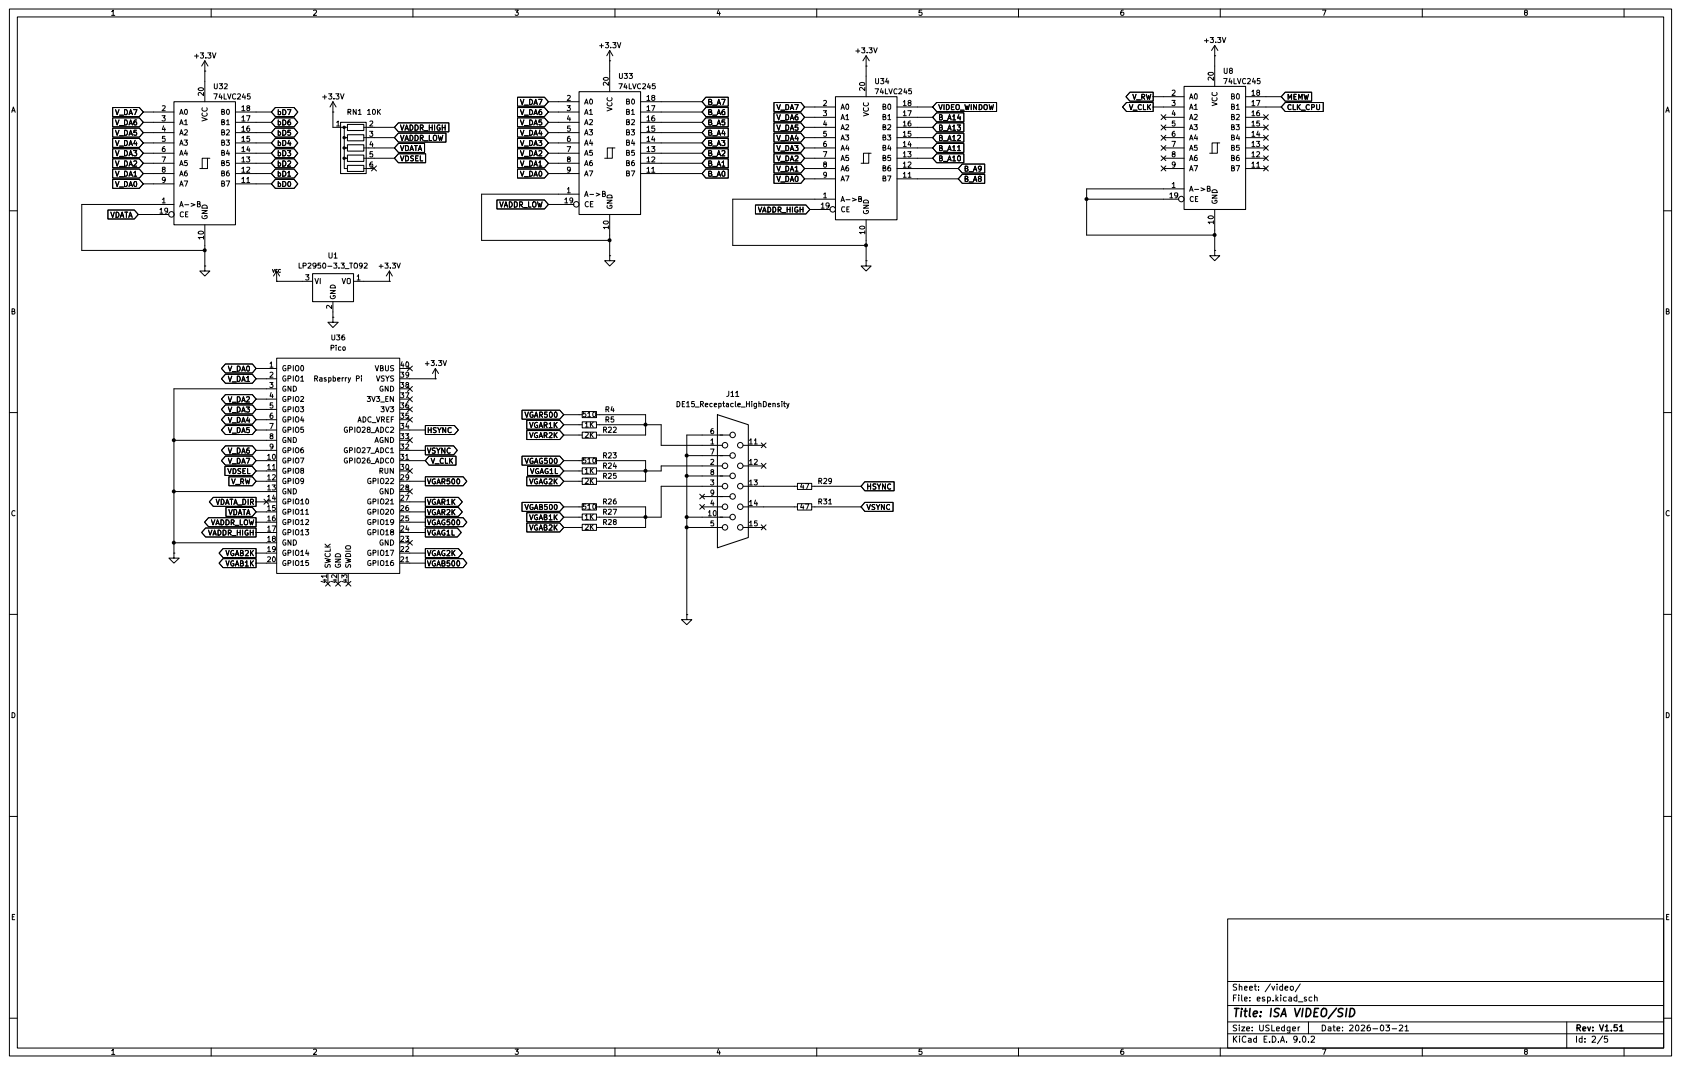
[picture p56: page 2]

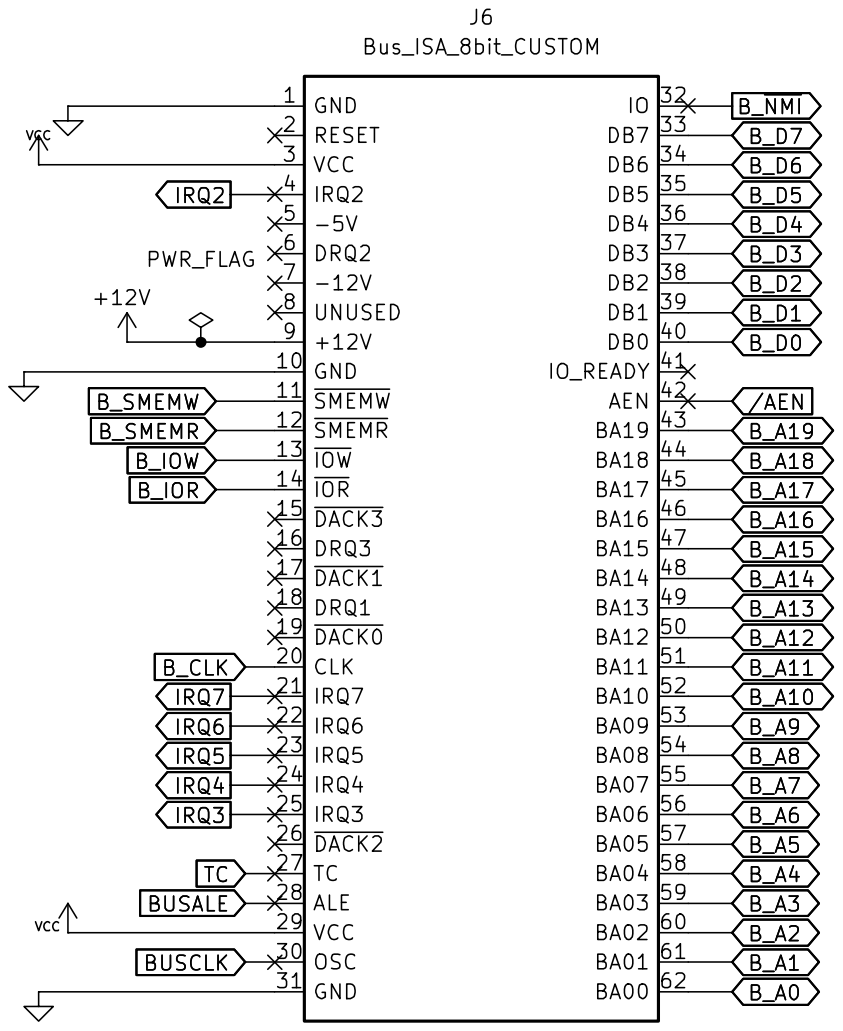
[picture p57: page 3]

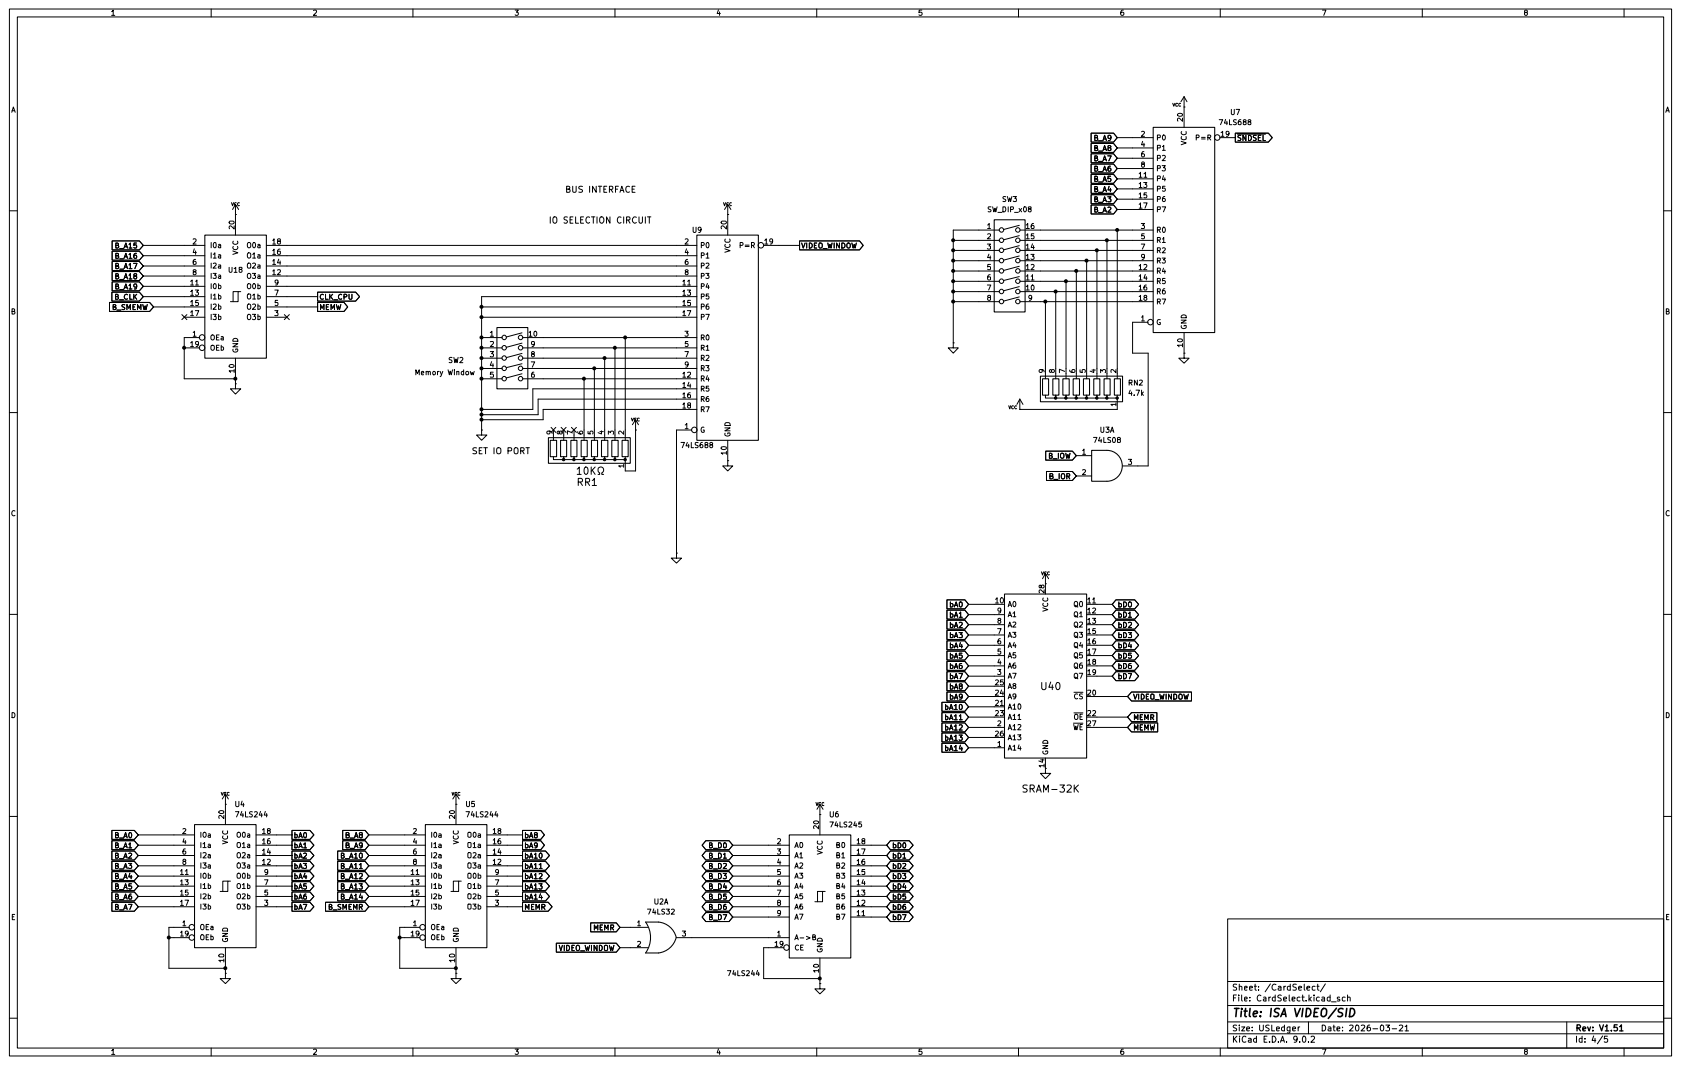
[picture p58: page 4]

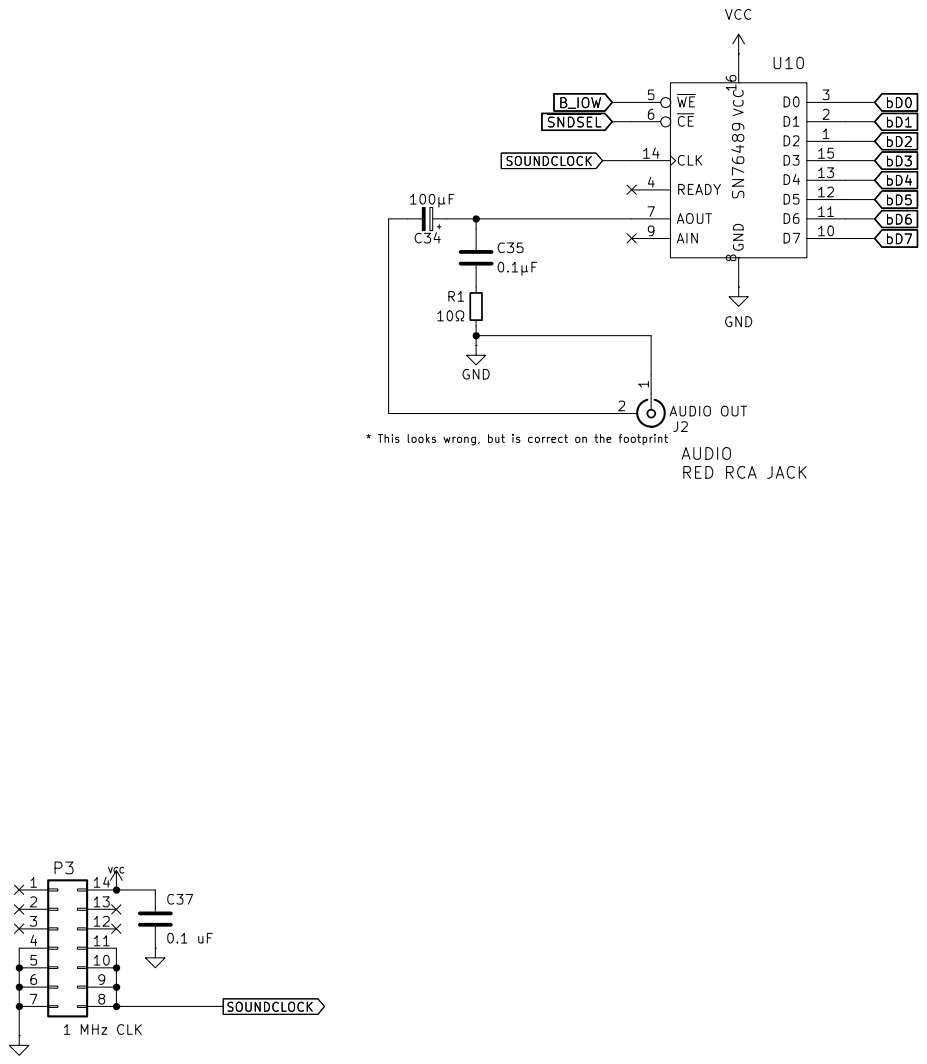
[picture p59: page 5]
