danwerner21/ISA_IO/VIDEO/HARDWARE/schematic-1.6.pdf

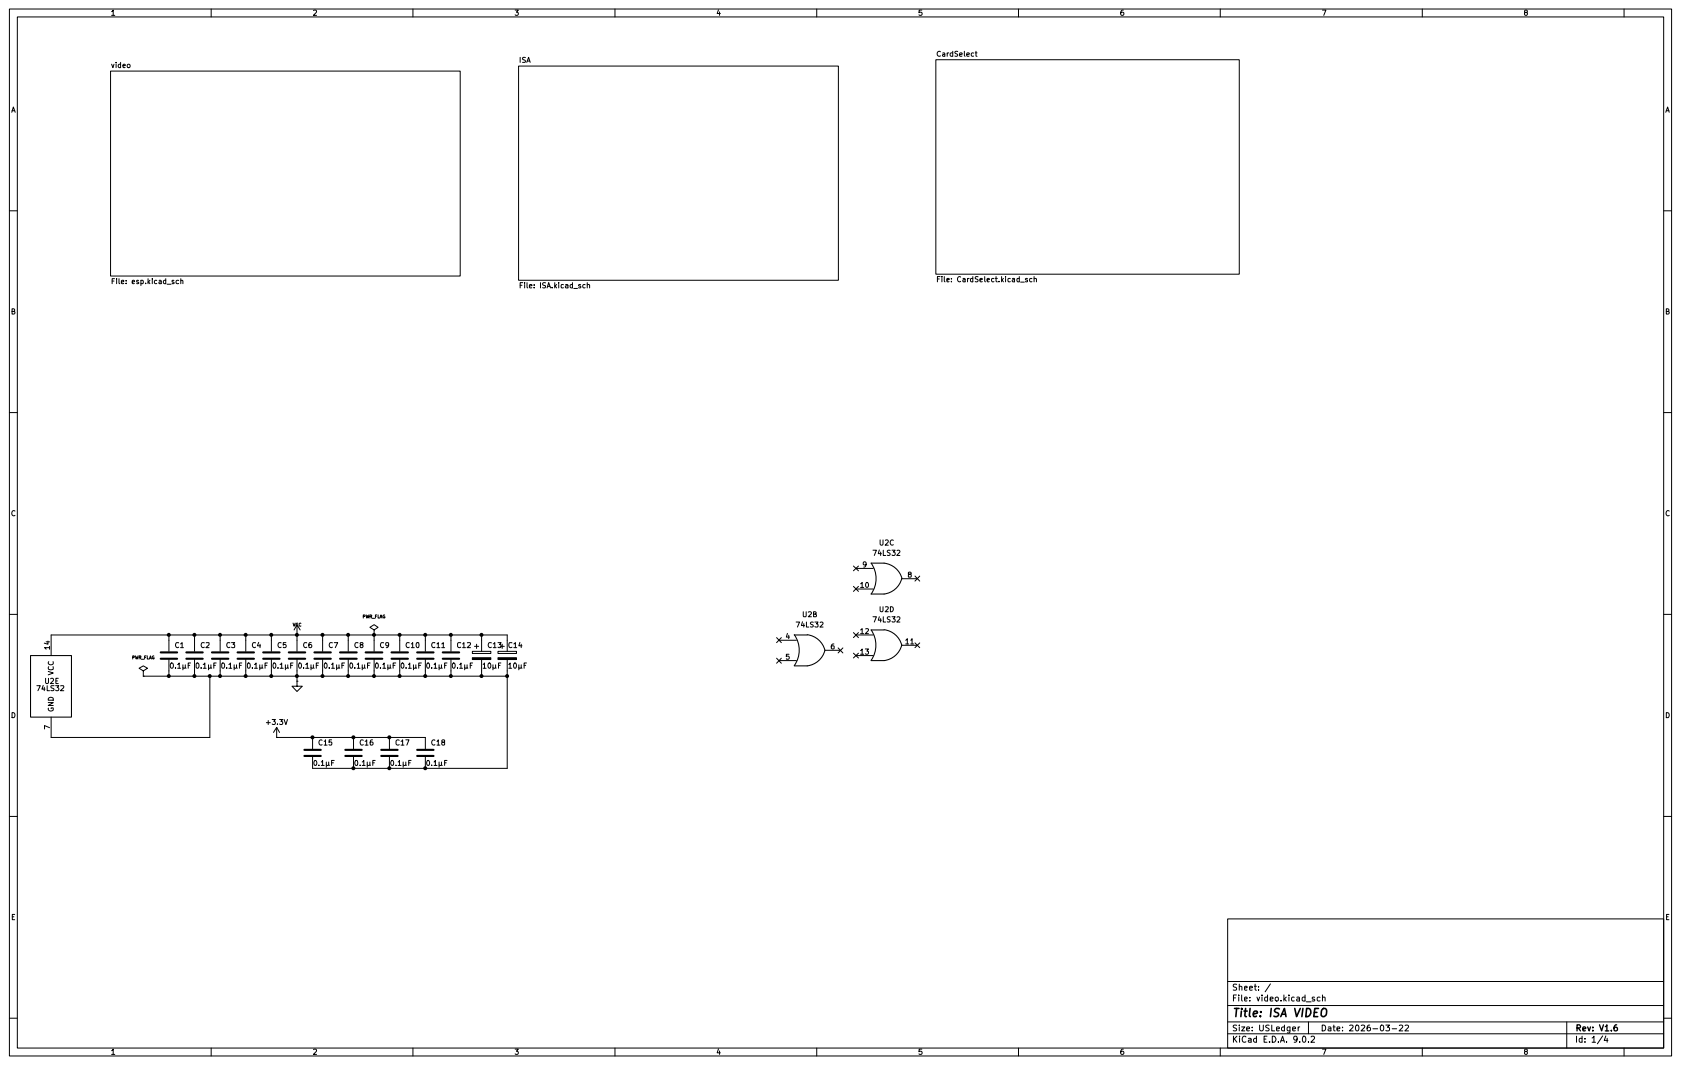
[picture p60: page 1]

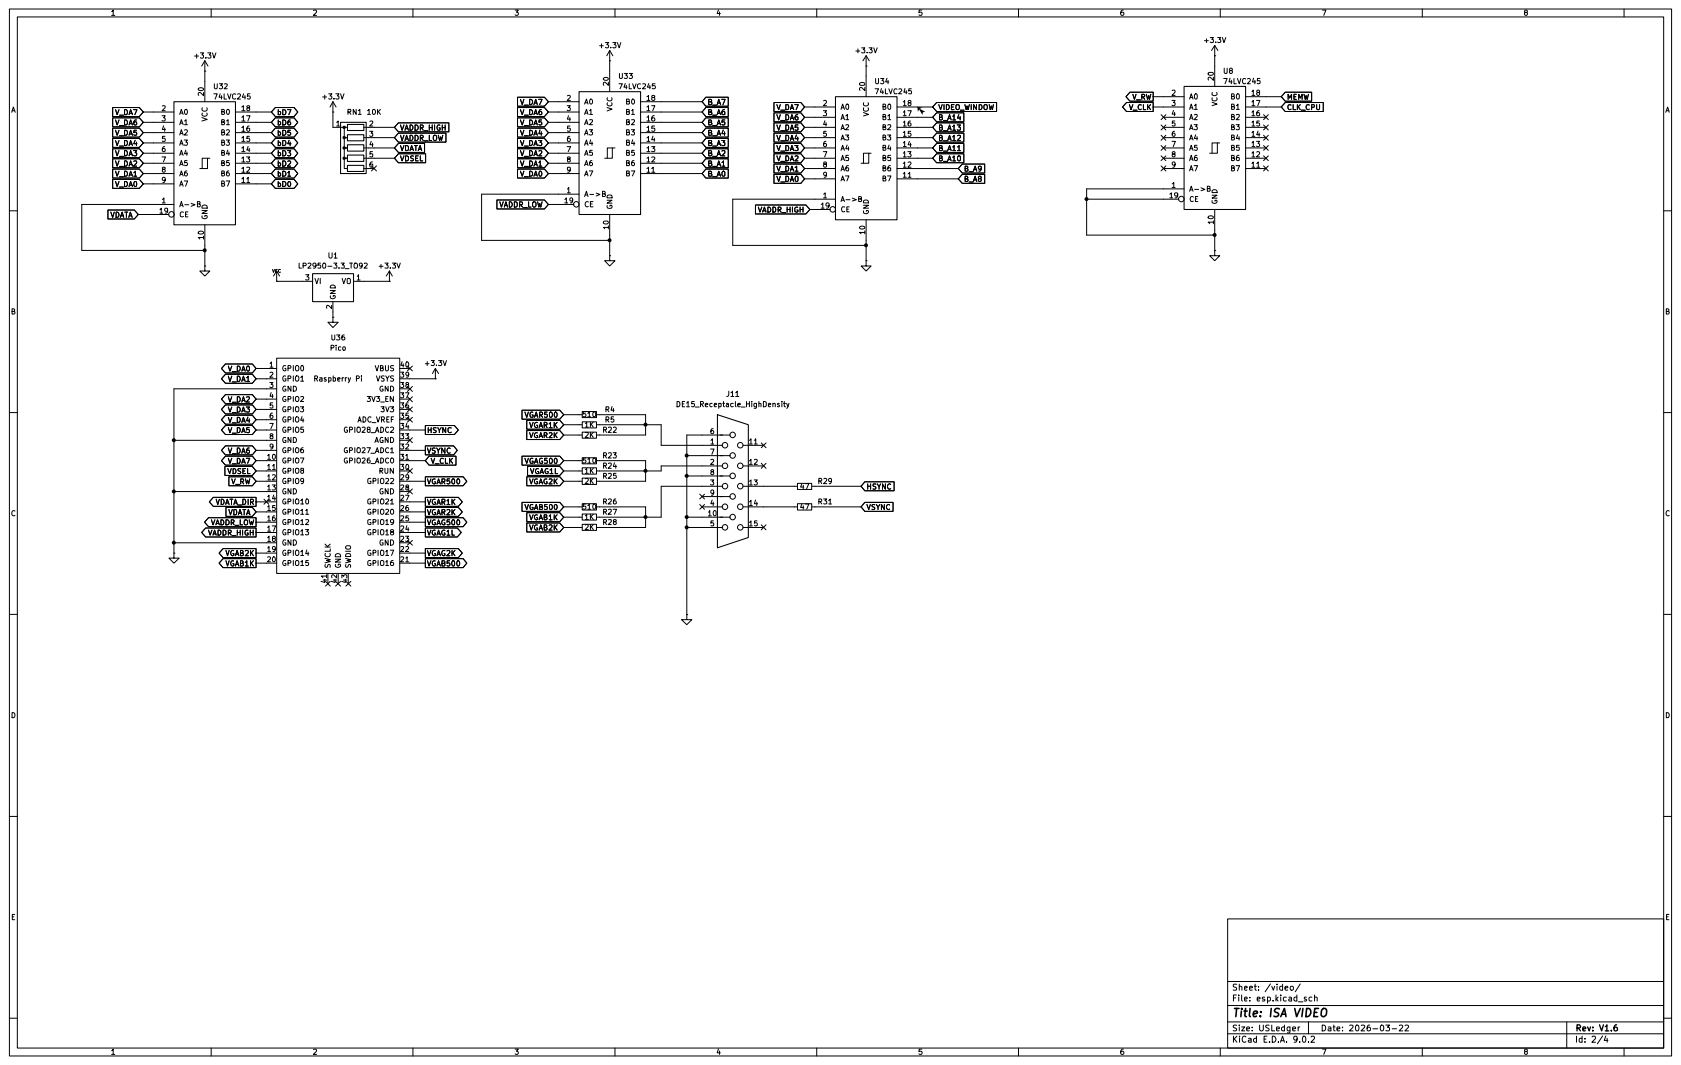
[picture p61: page 2]

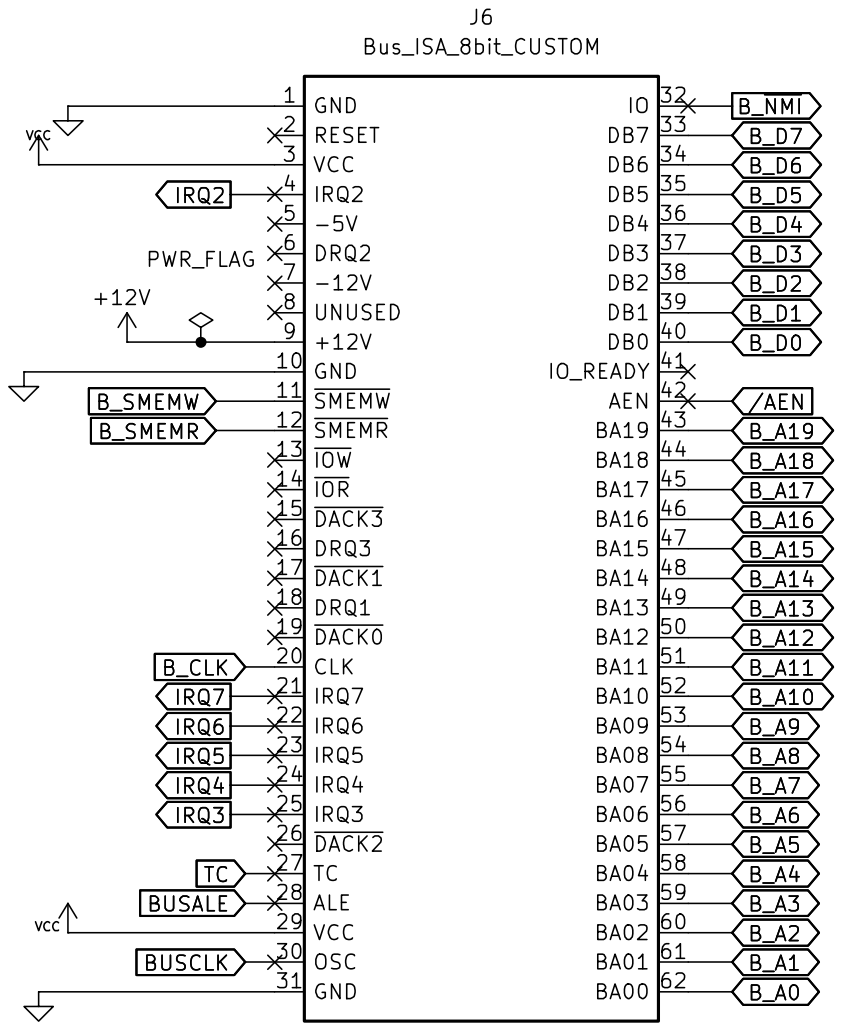
[picture p62: page 3]

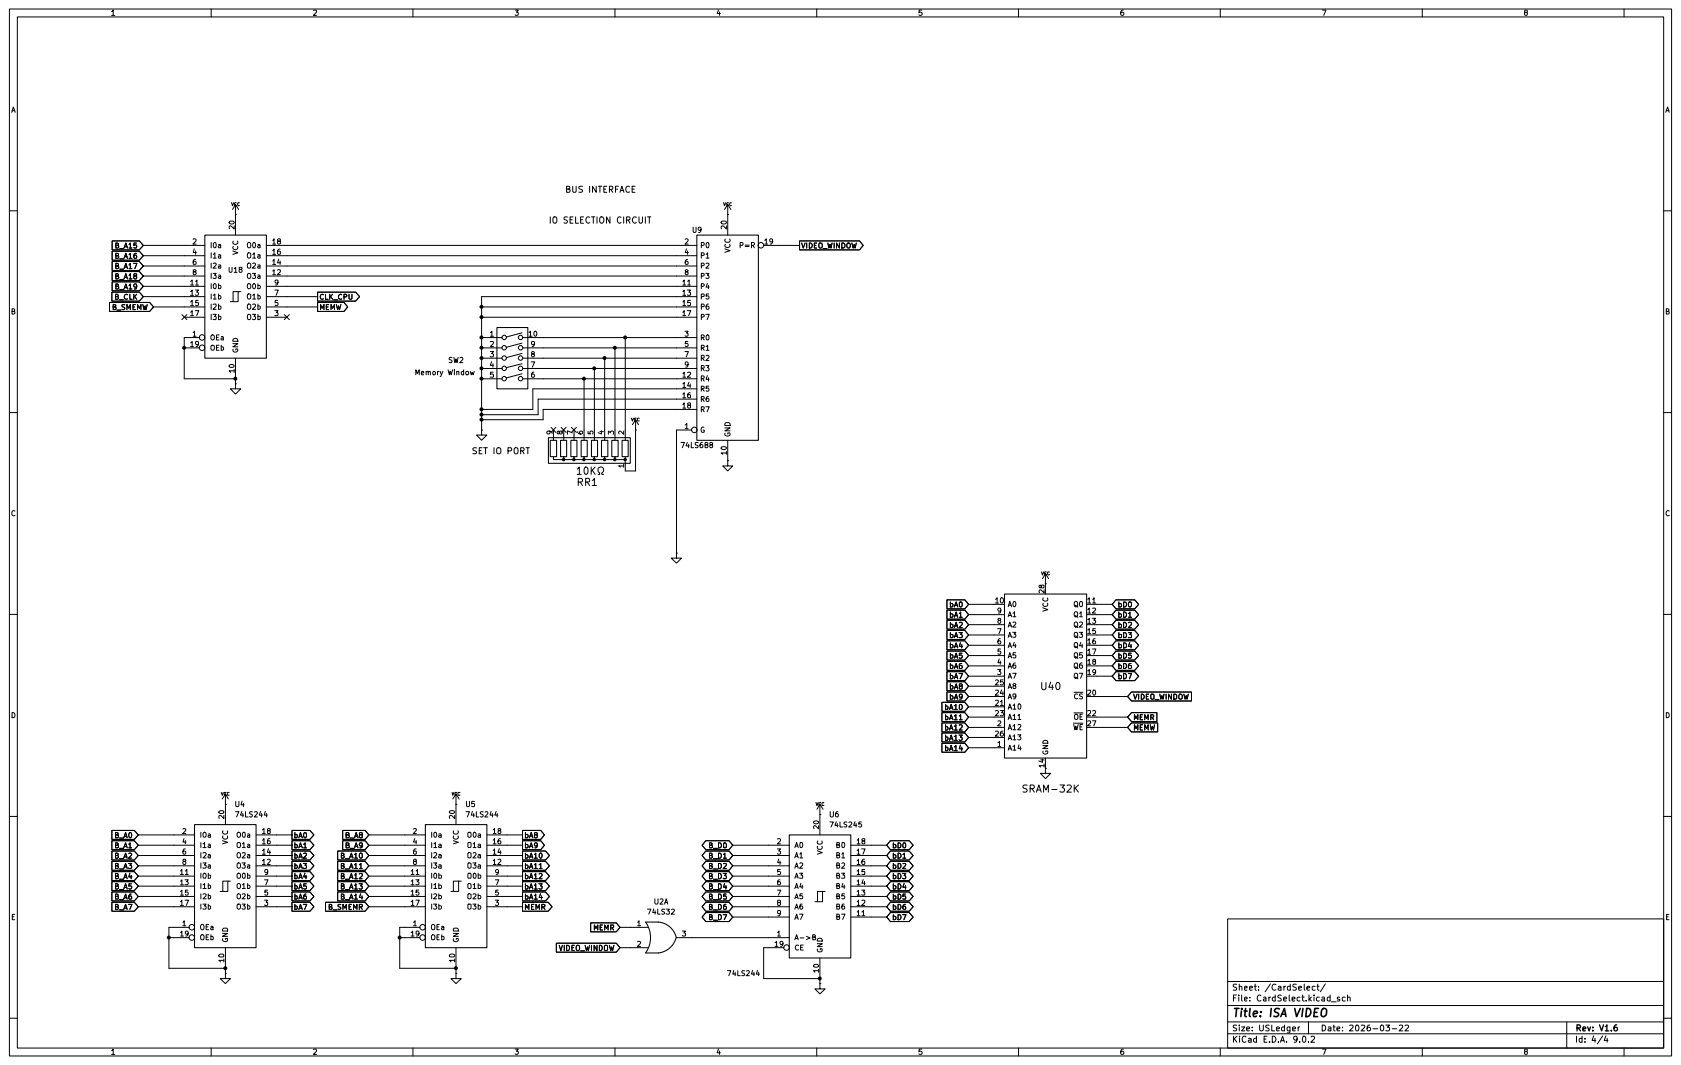
[picture p63: page 4]
