danwerner21/ISA_IO/VIDEO/HARDWARE/pcb-1.1.pdf

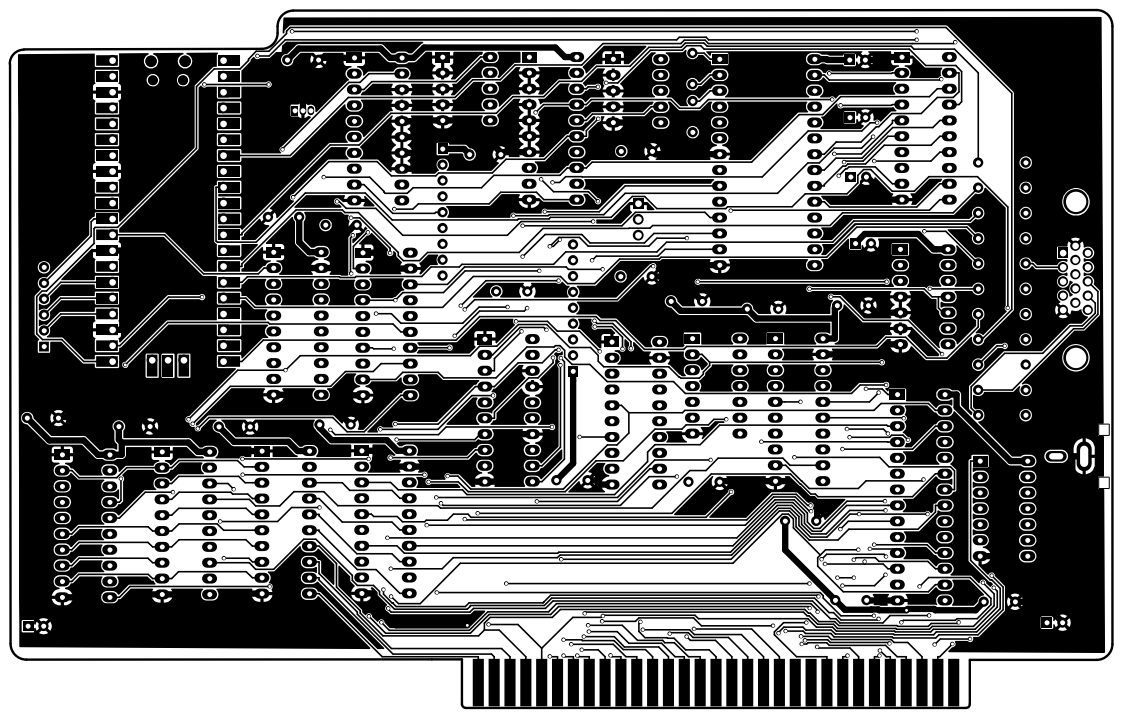
[picture p64: page 1]

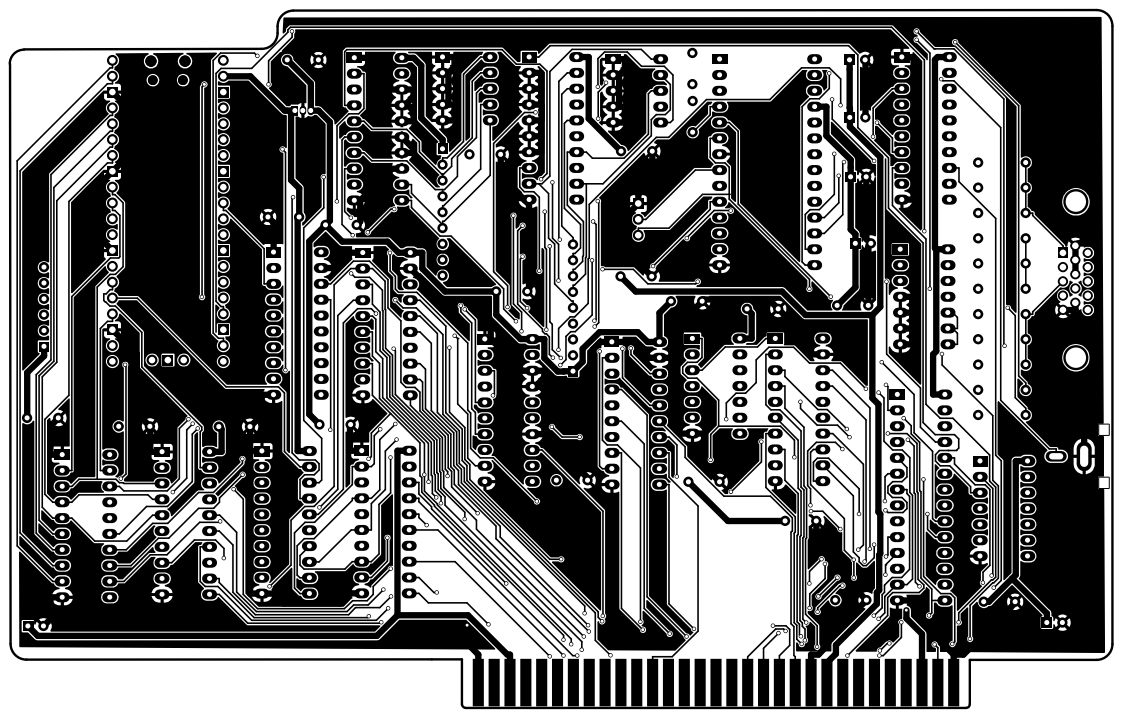
[picture p65: page 2]

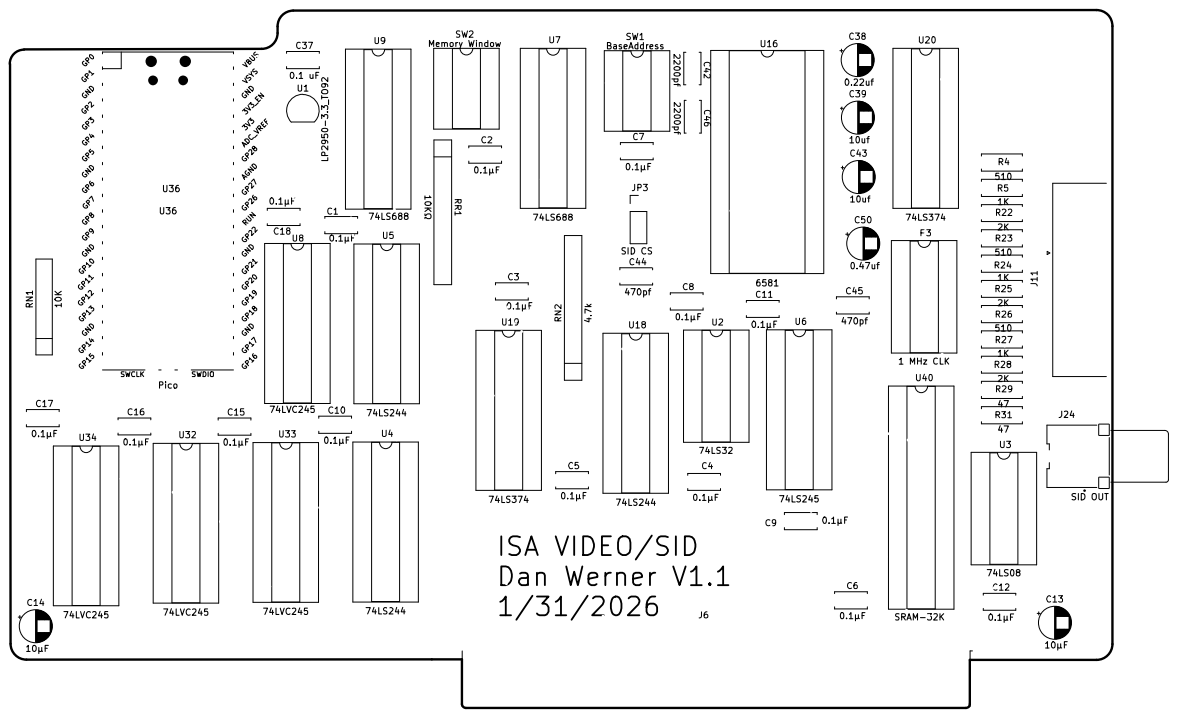
[picture p66: page 3]

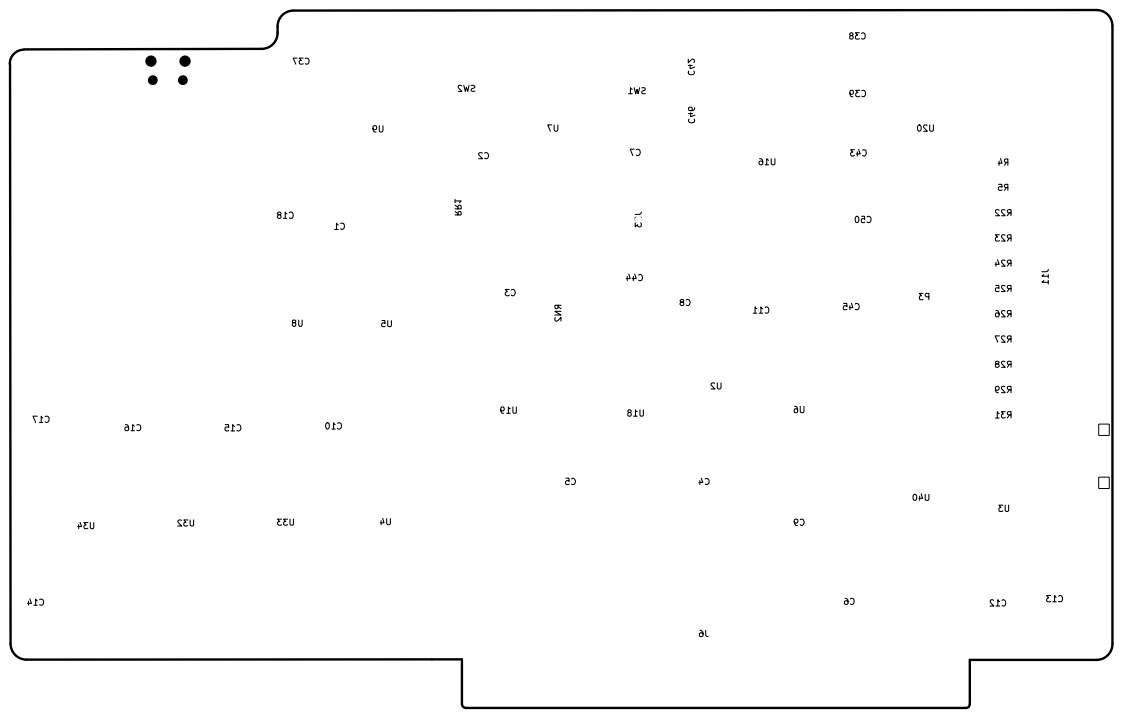
[picture p67: page 4]

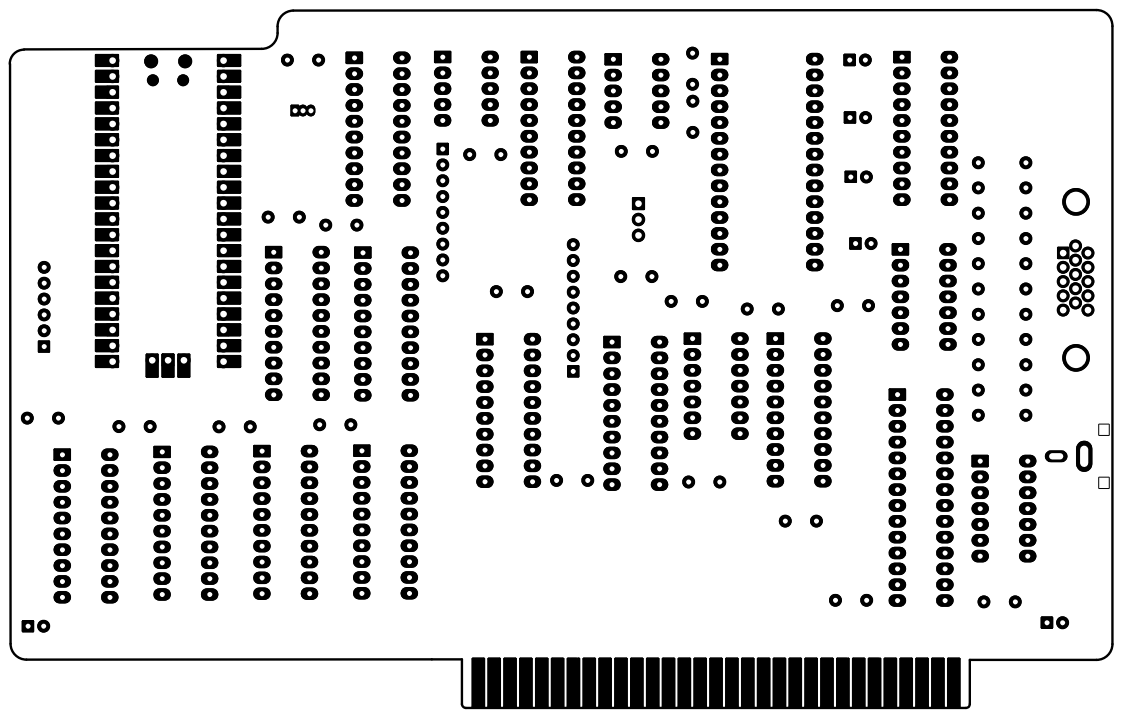
[picture p68: page 5]

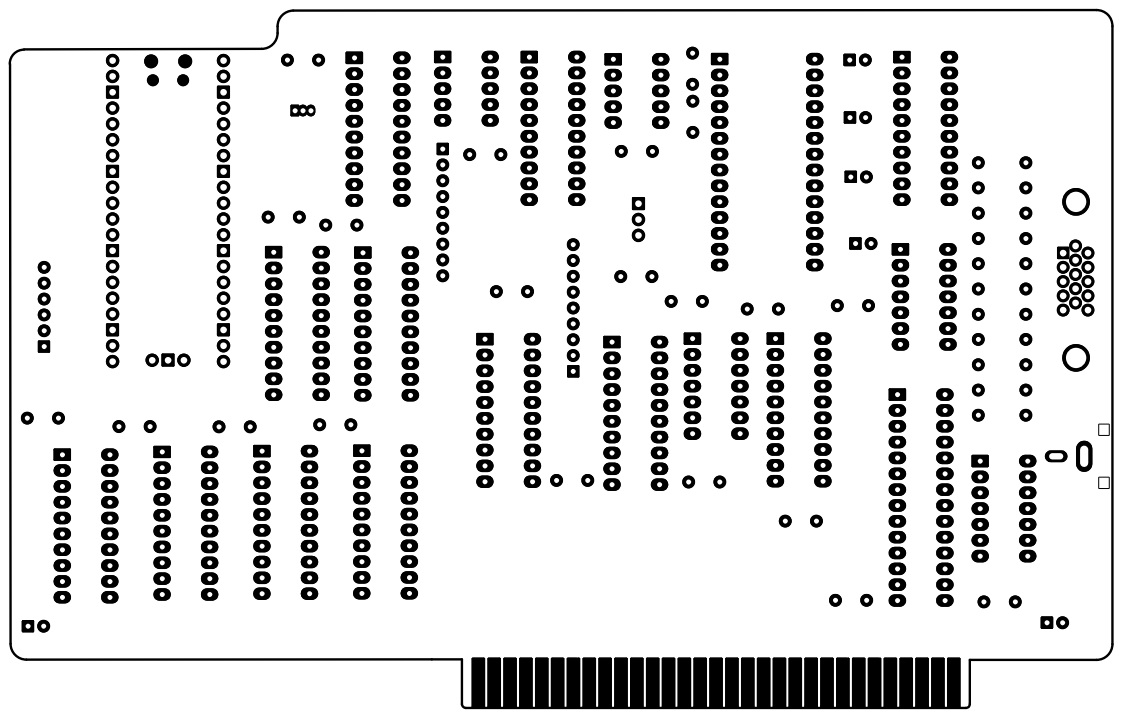
[picture p69: page 6]

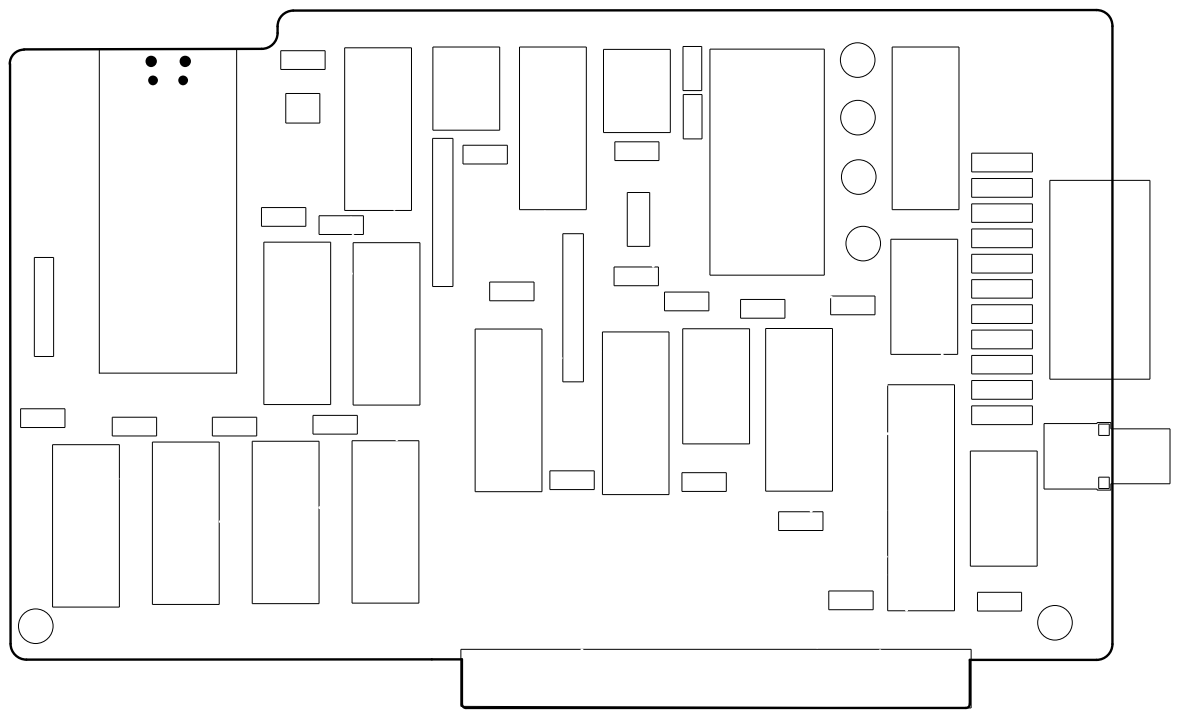
[picture p70: page 7]
