danwerner21/ISA_IO/VIDEO/HARDWARE/schematic-1.1.pdf

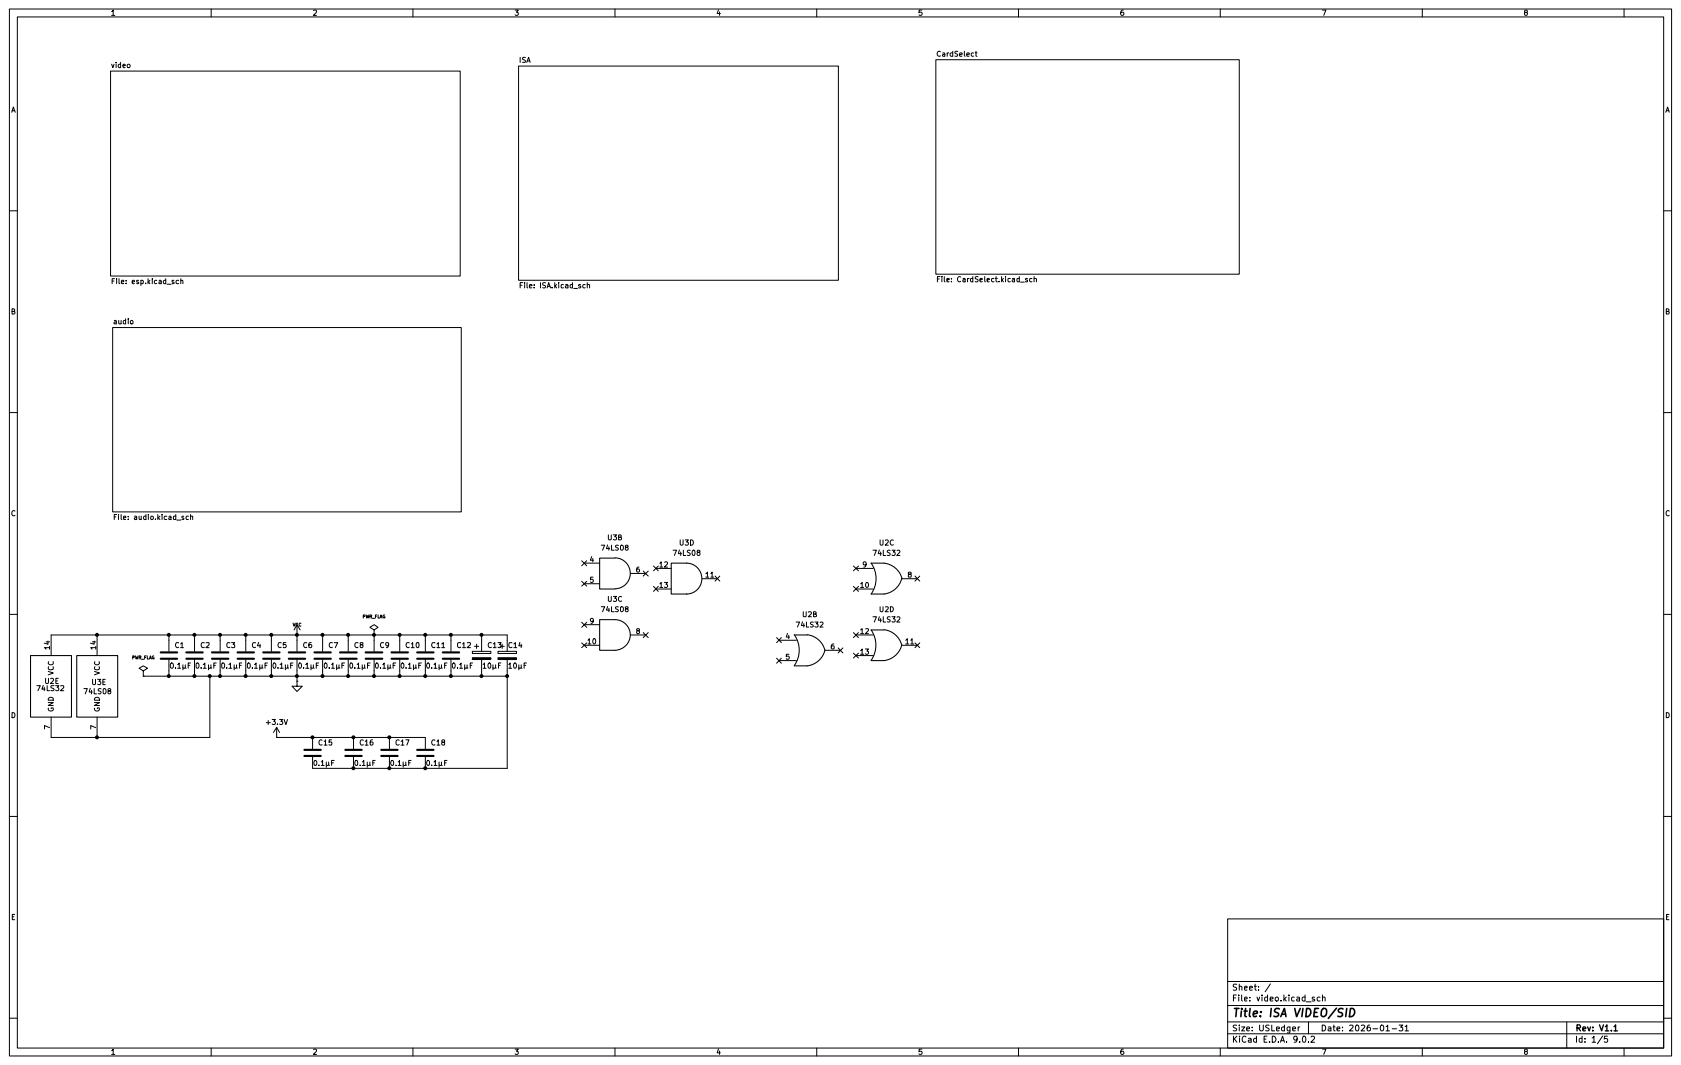
[picture p71: page 1]

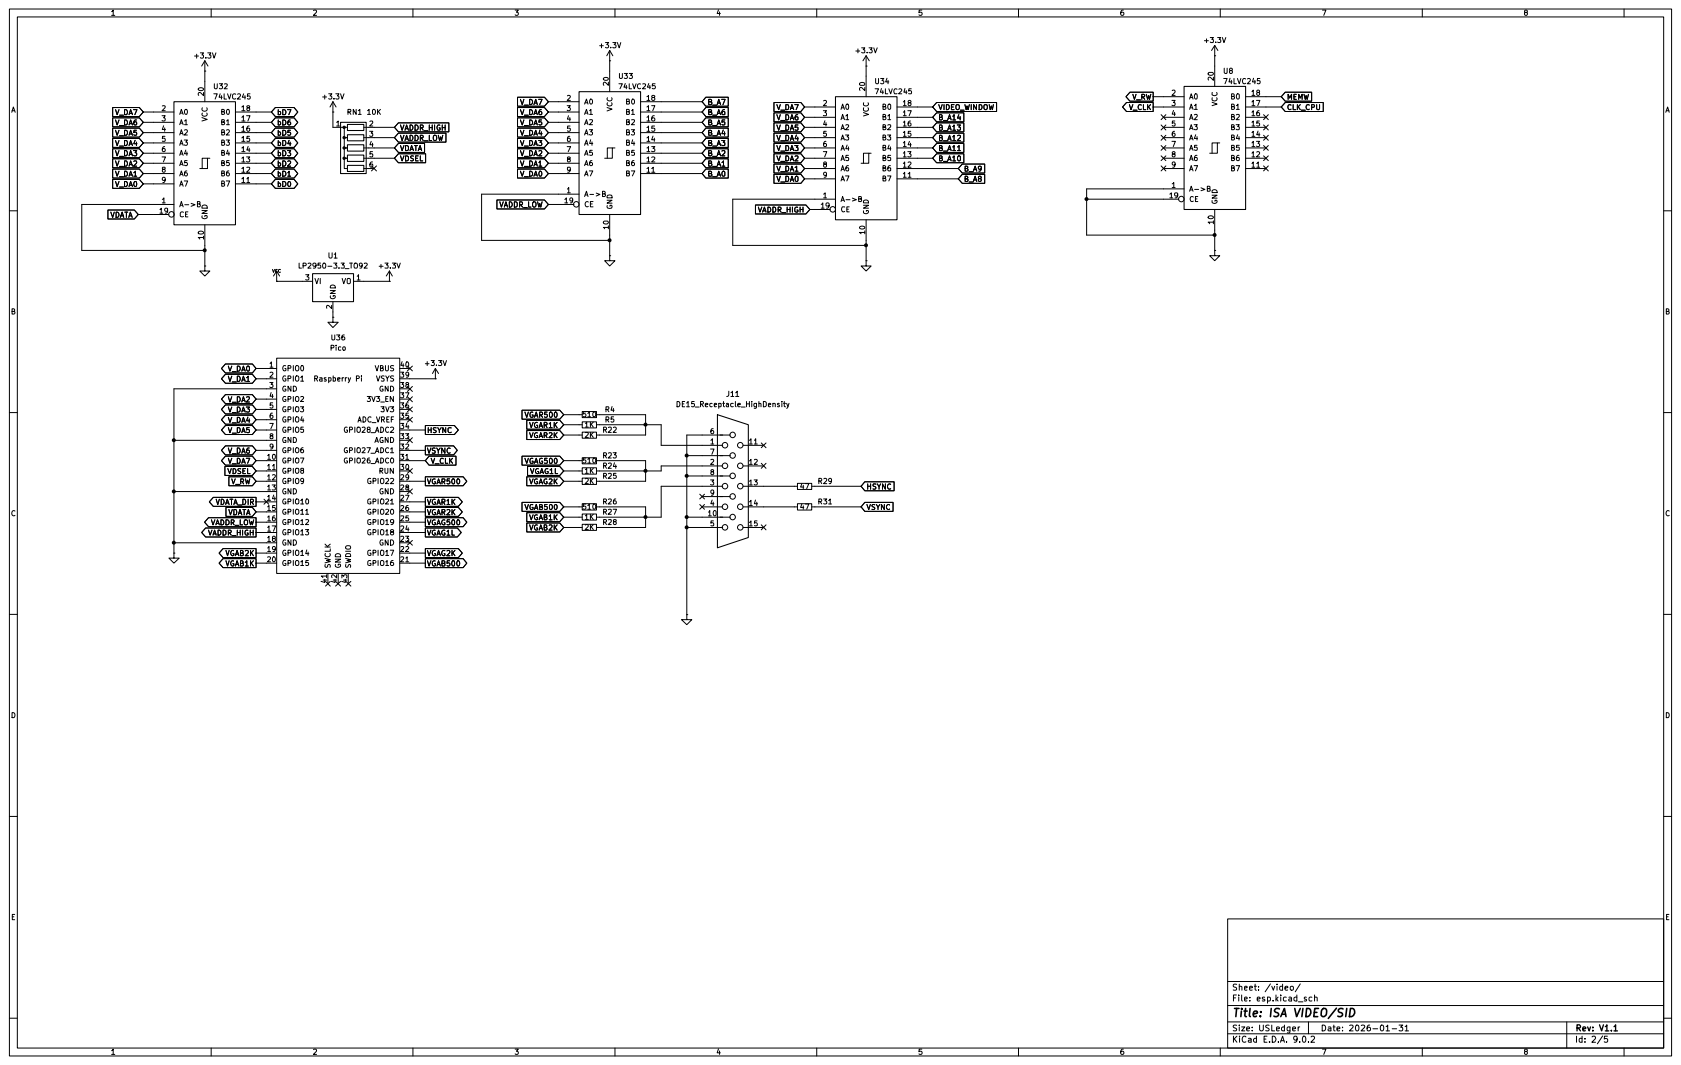
[picture p72: page 2]

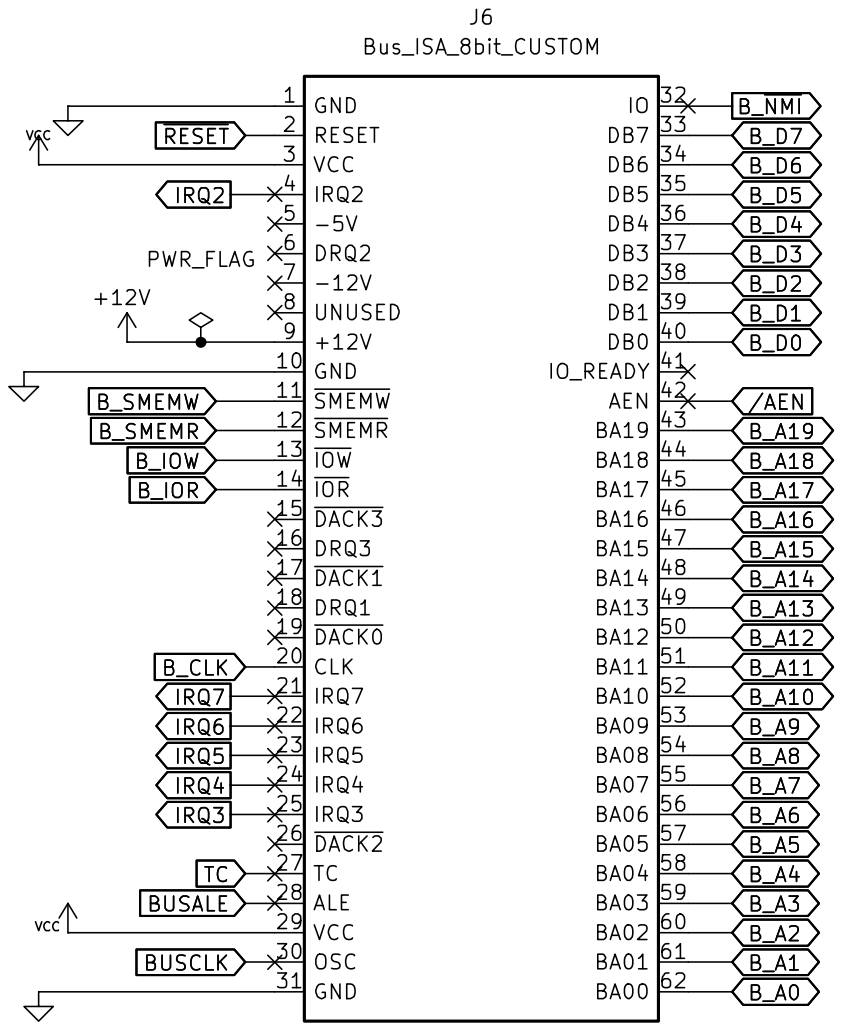
[picture p73: page 3]

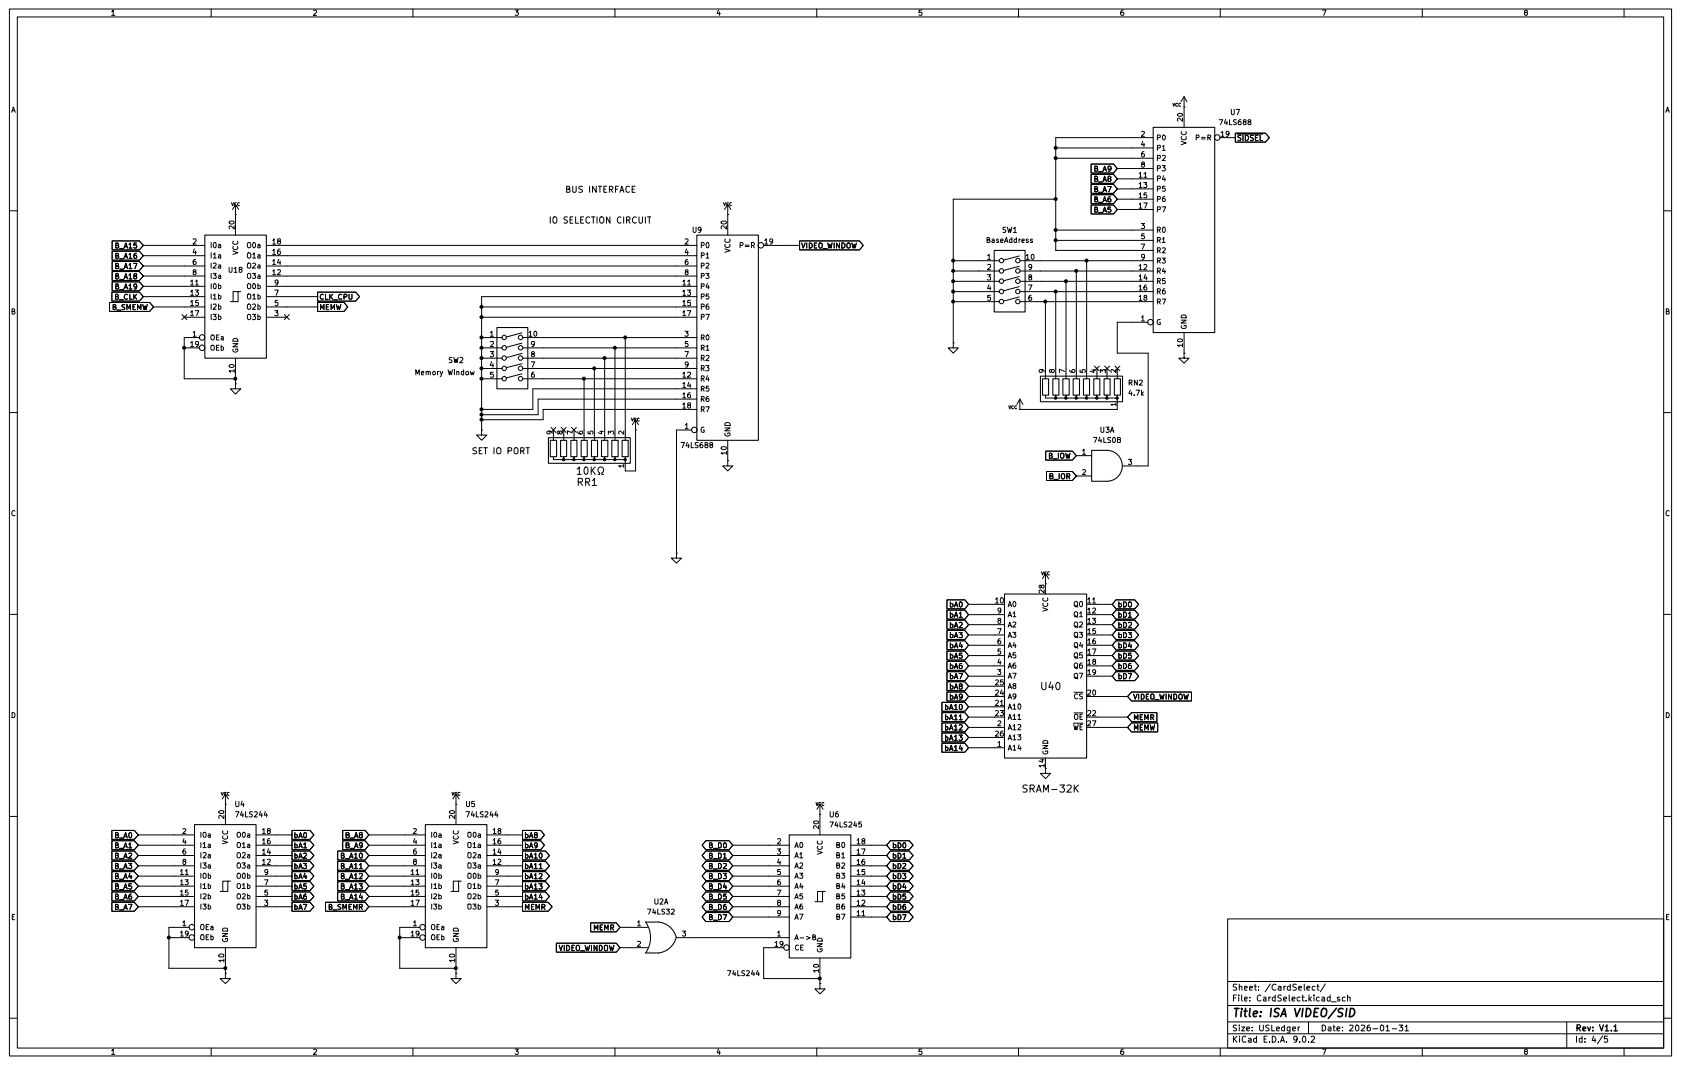
[picture p74: page 4]

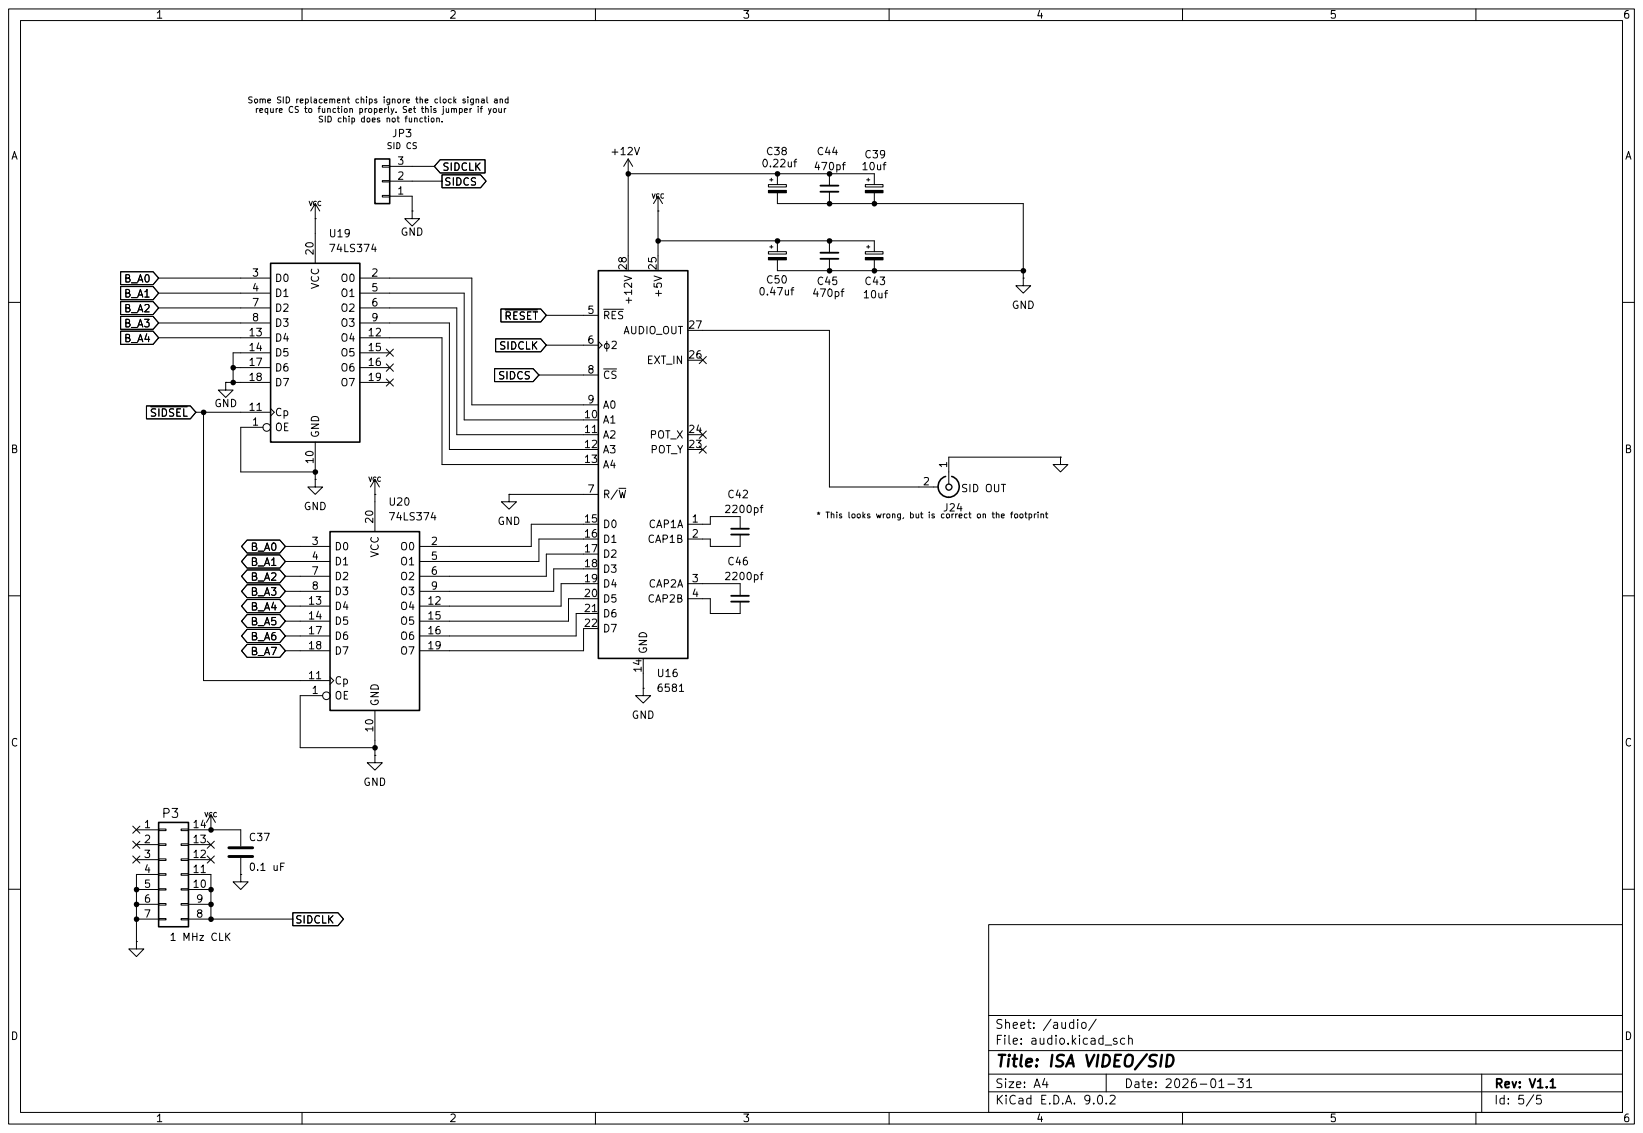
[picture p75: page 5]
