danwerner21/ISA_IO/VIDEO/HARDWARE/pcb-0.9.pdf

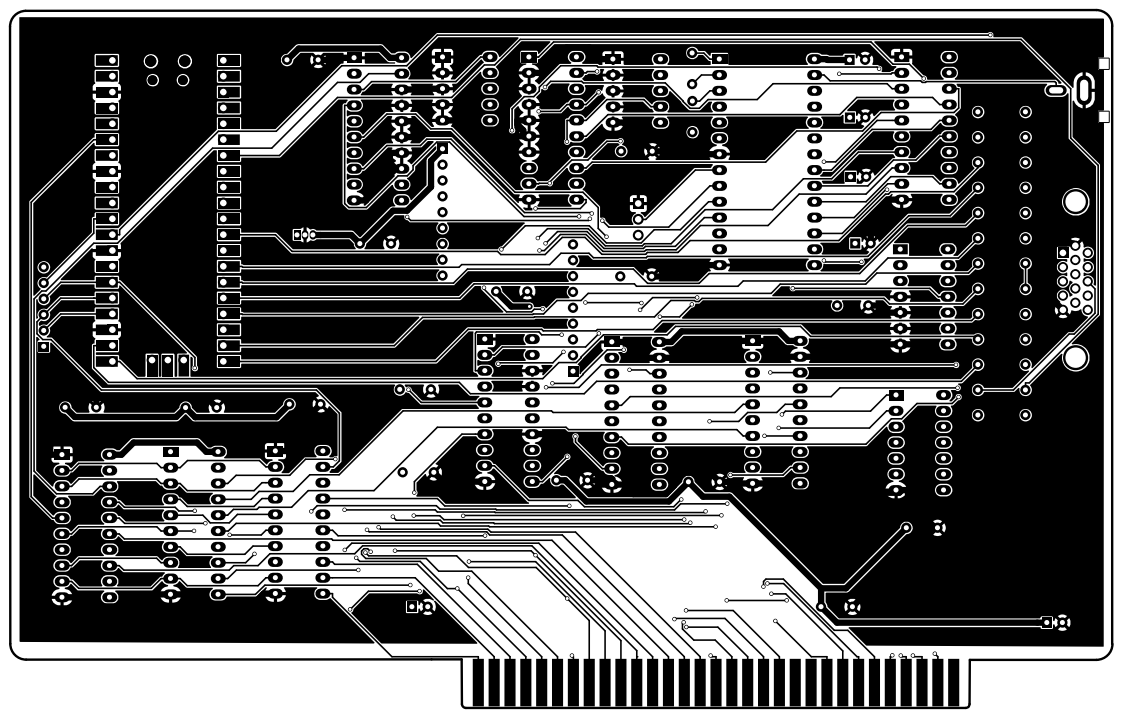
[picture p76: page 1]

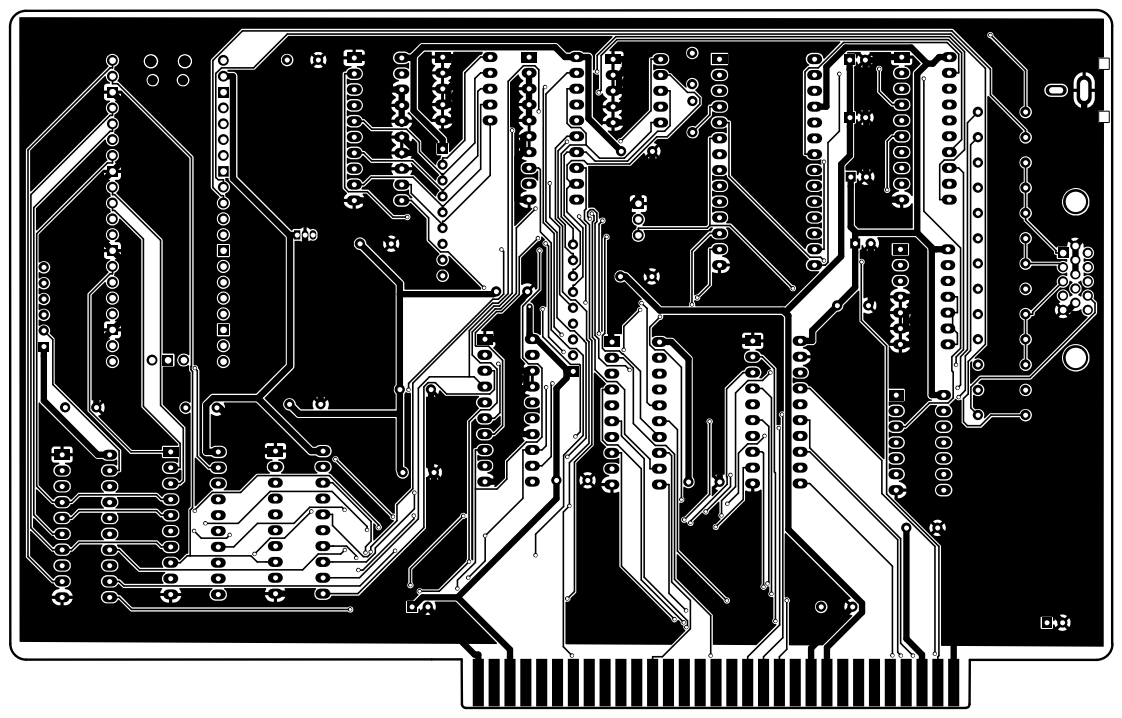
[picture p77: page 2]

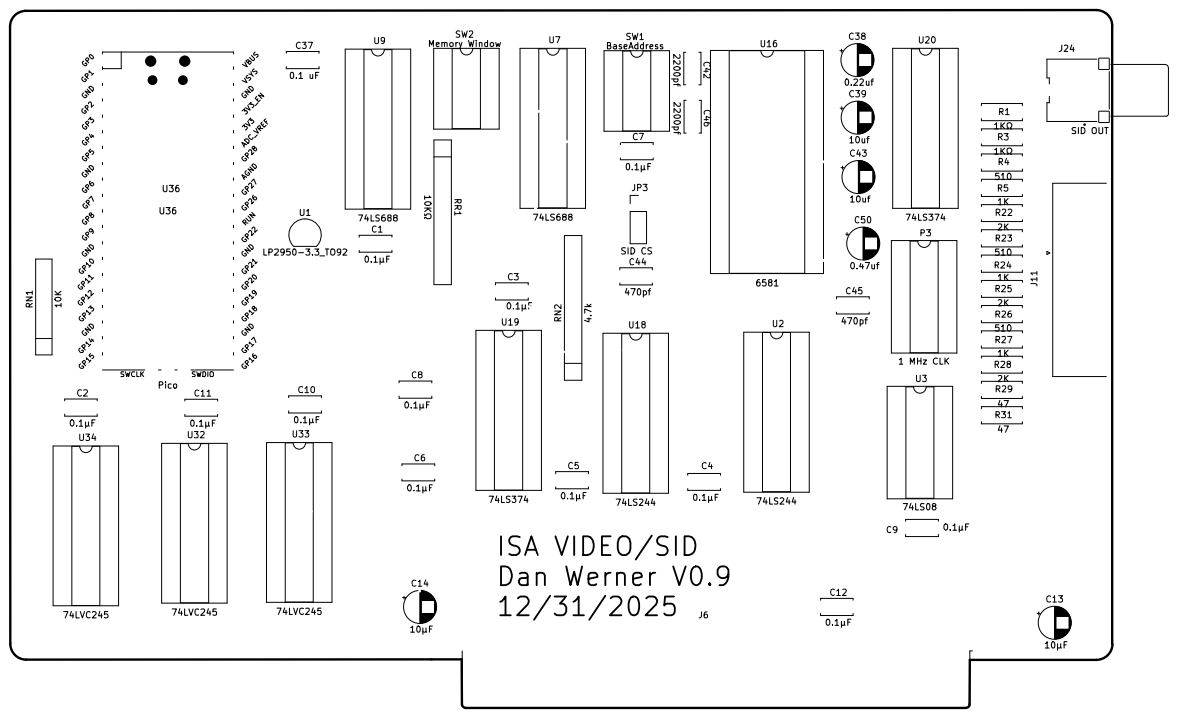
[picture p78: page 3]

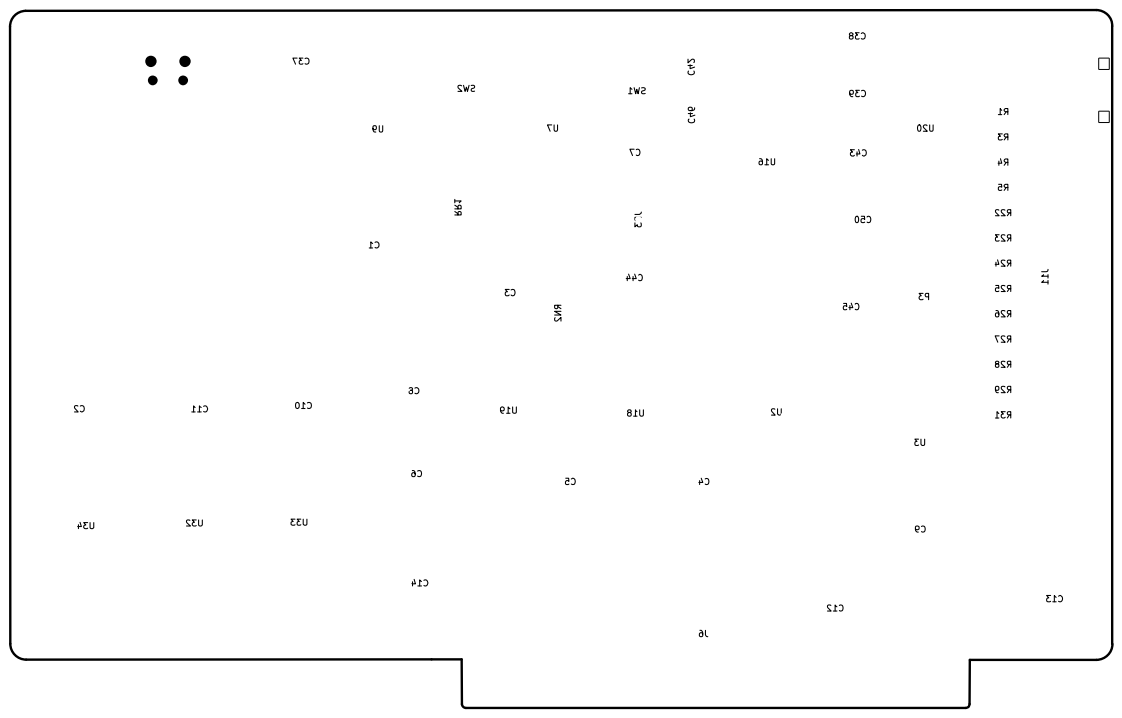
[picture p79: page 4]

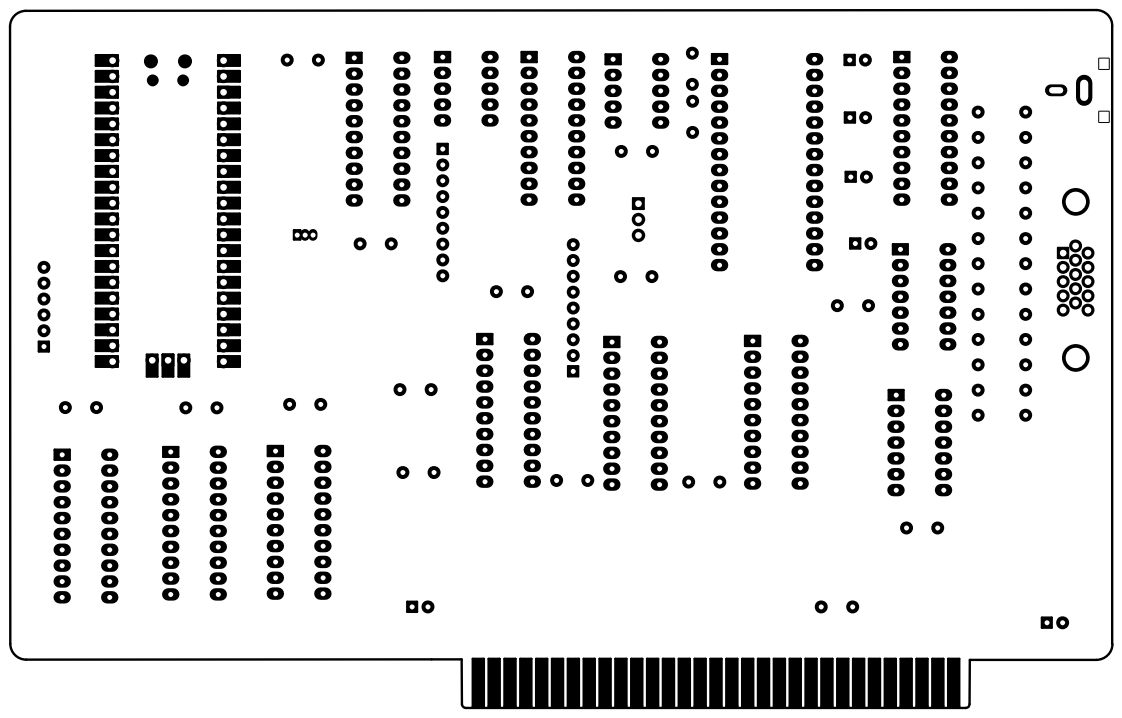
[picture p80: page 5]

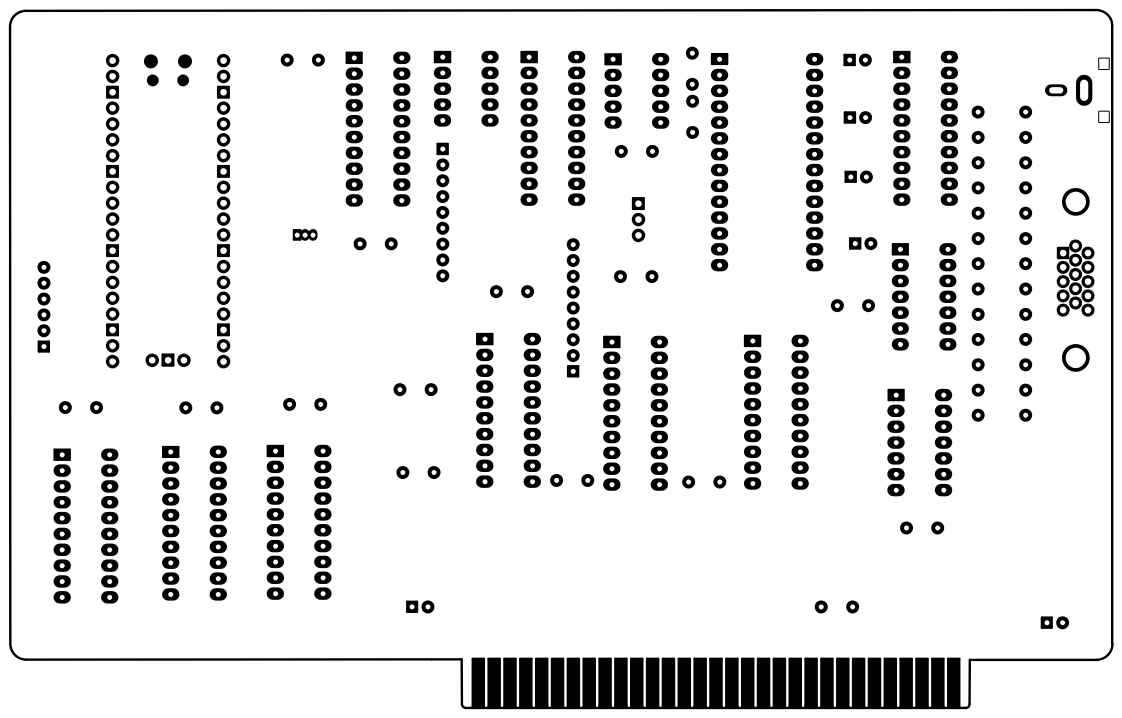
[picture p81: page 6]

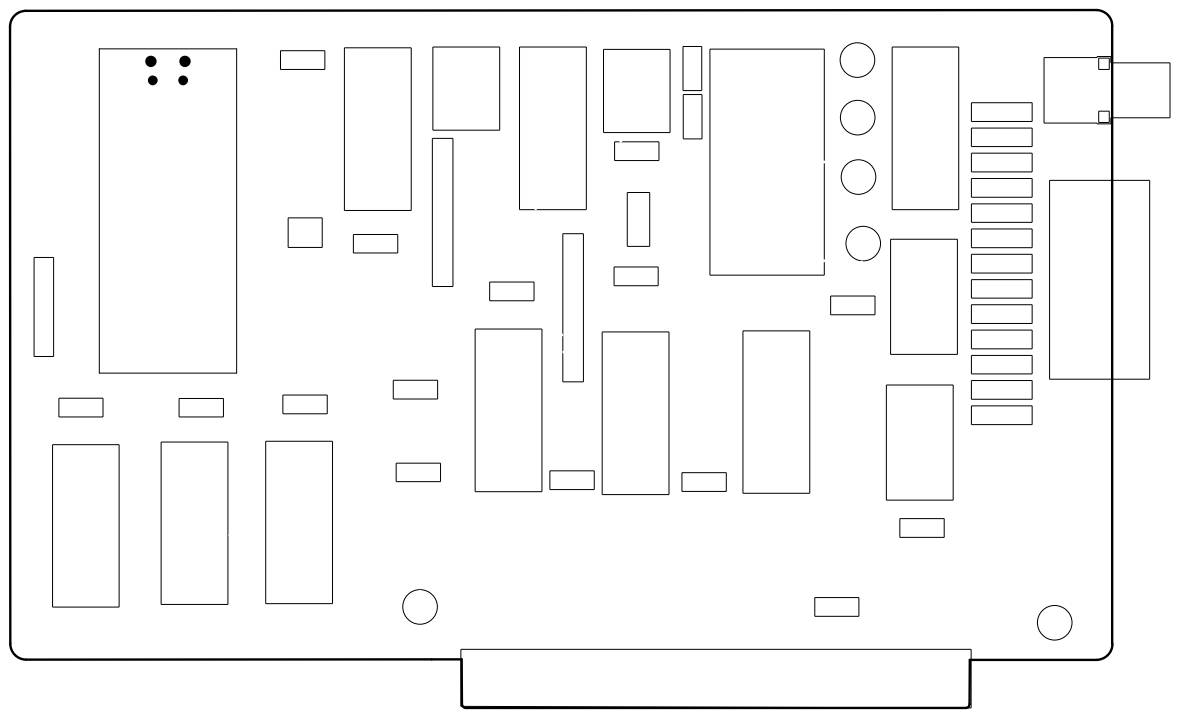
[picture p82: page 7]
