danwerner21/ISA_IO/VIDEO/HARDWARE/pcb-1.0.pdf

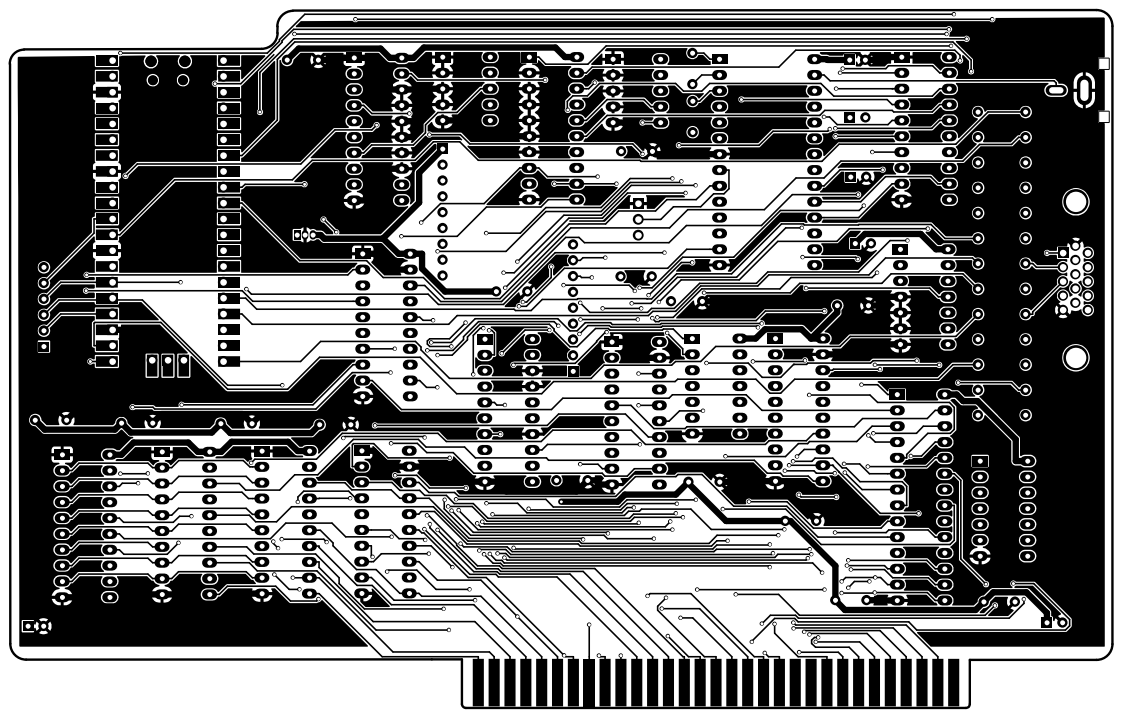
[picture p83: page 1]

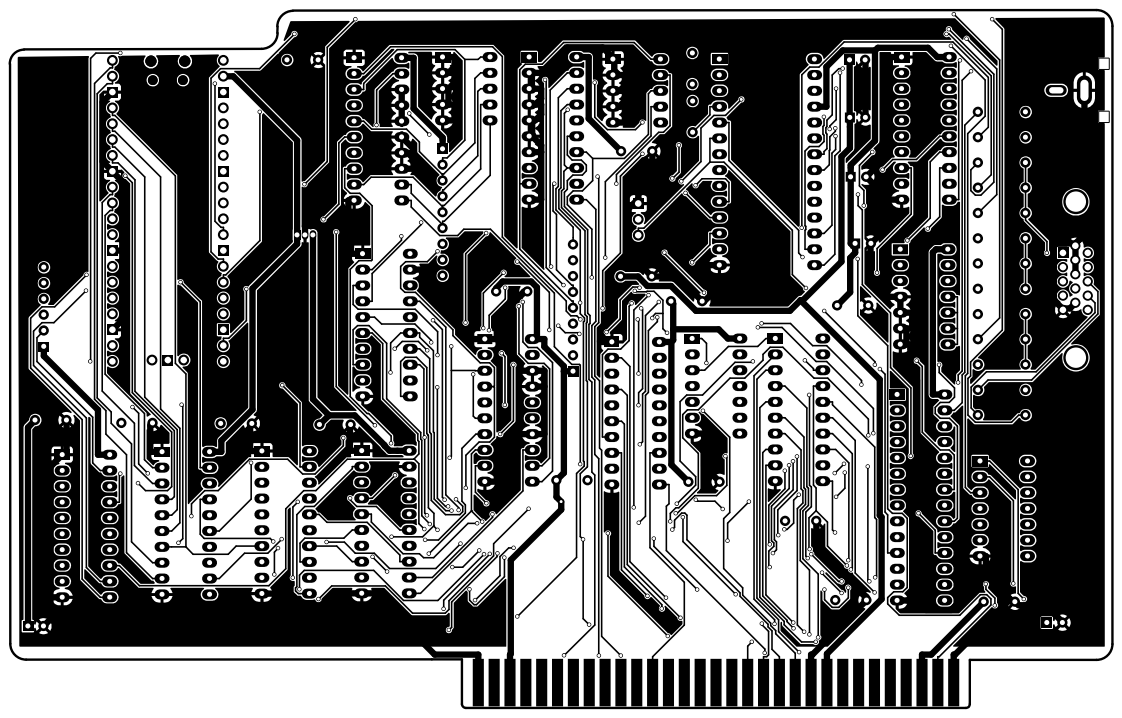
[picture p84: page 2]

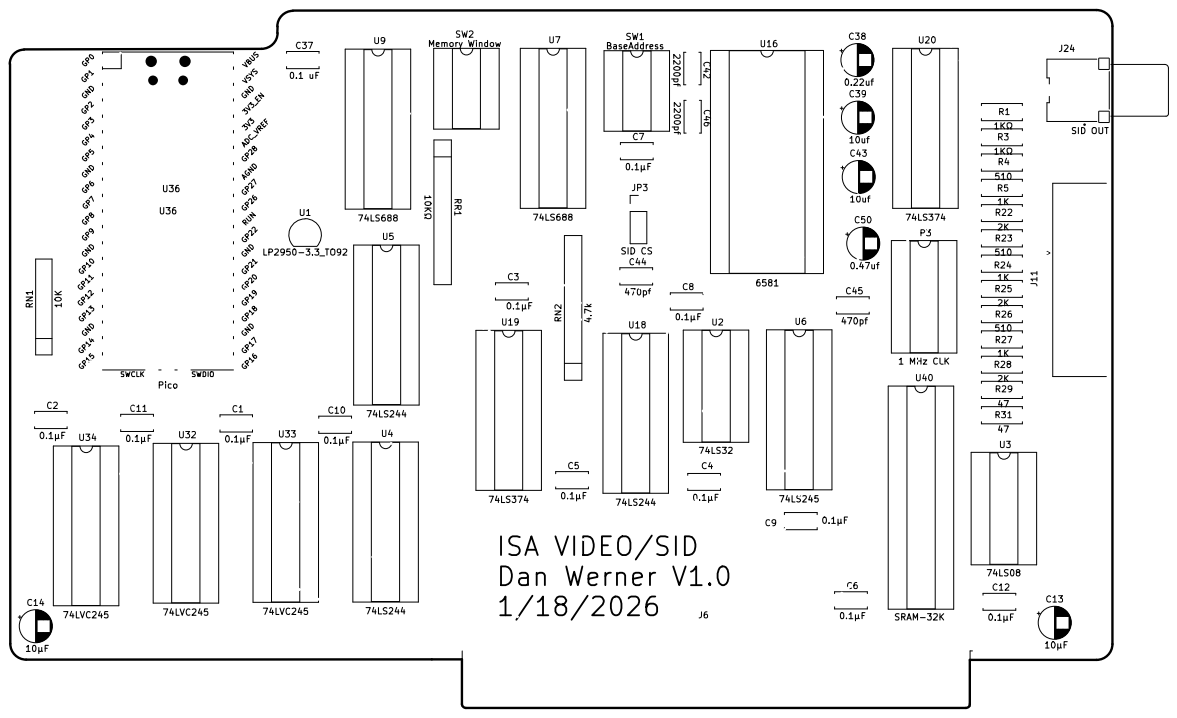
[picture p85: page 3]

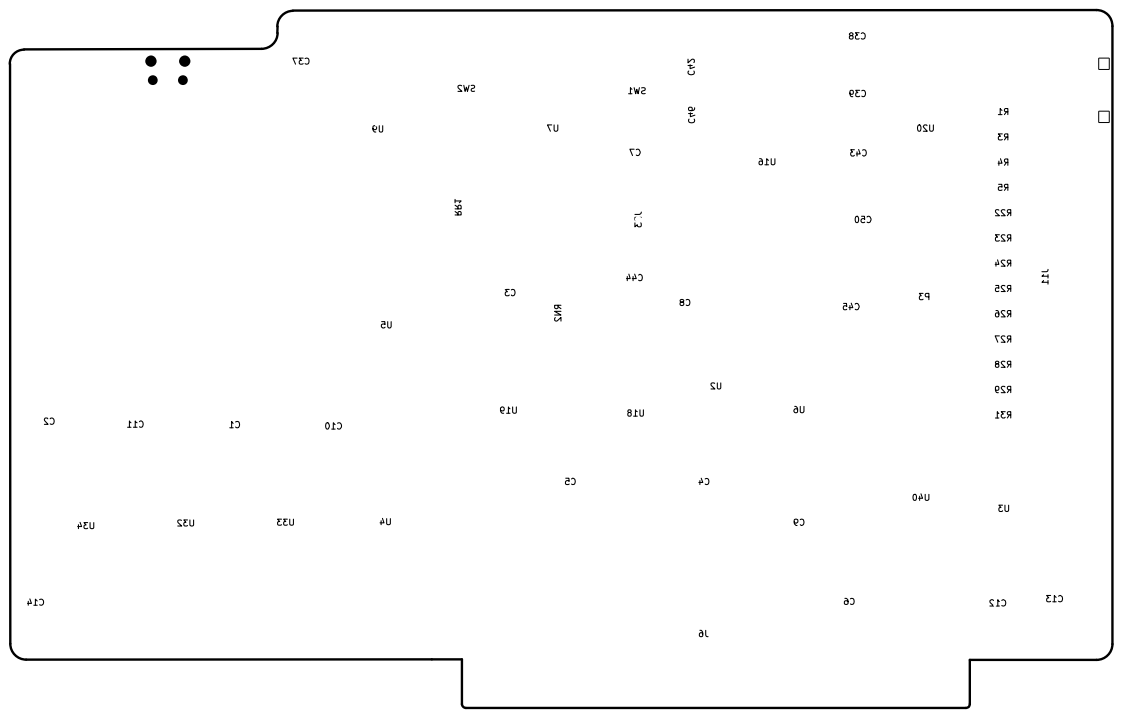
[picture p86: page 4]

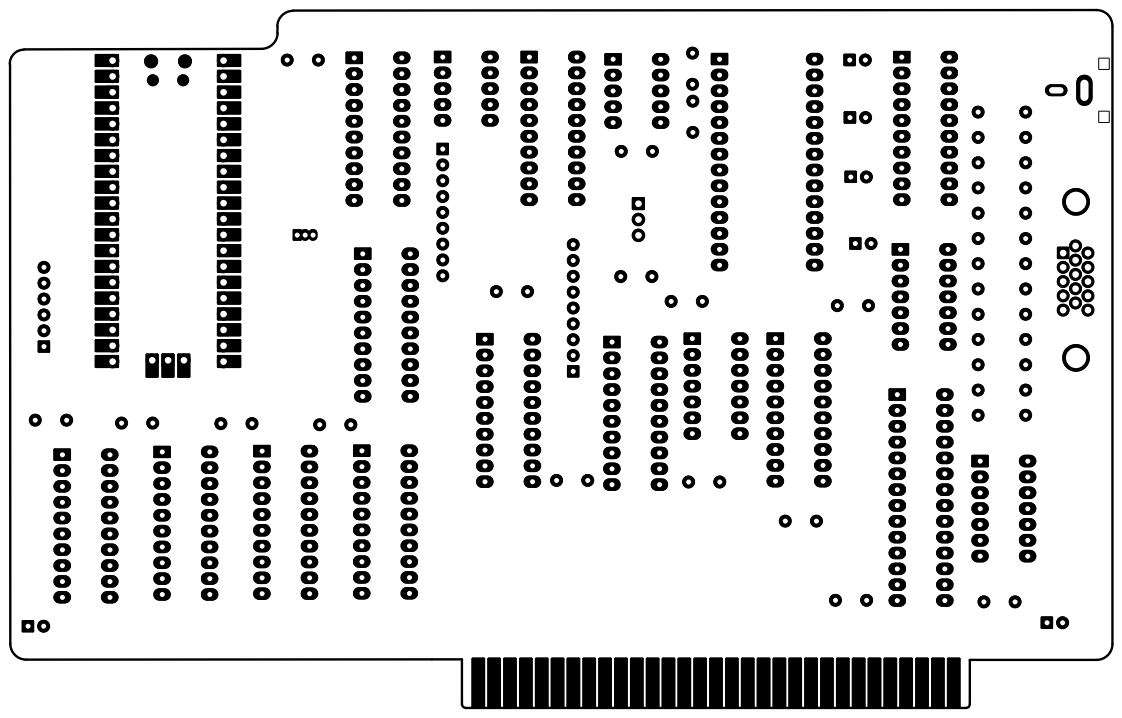
[picture p87: page 5]

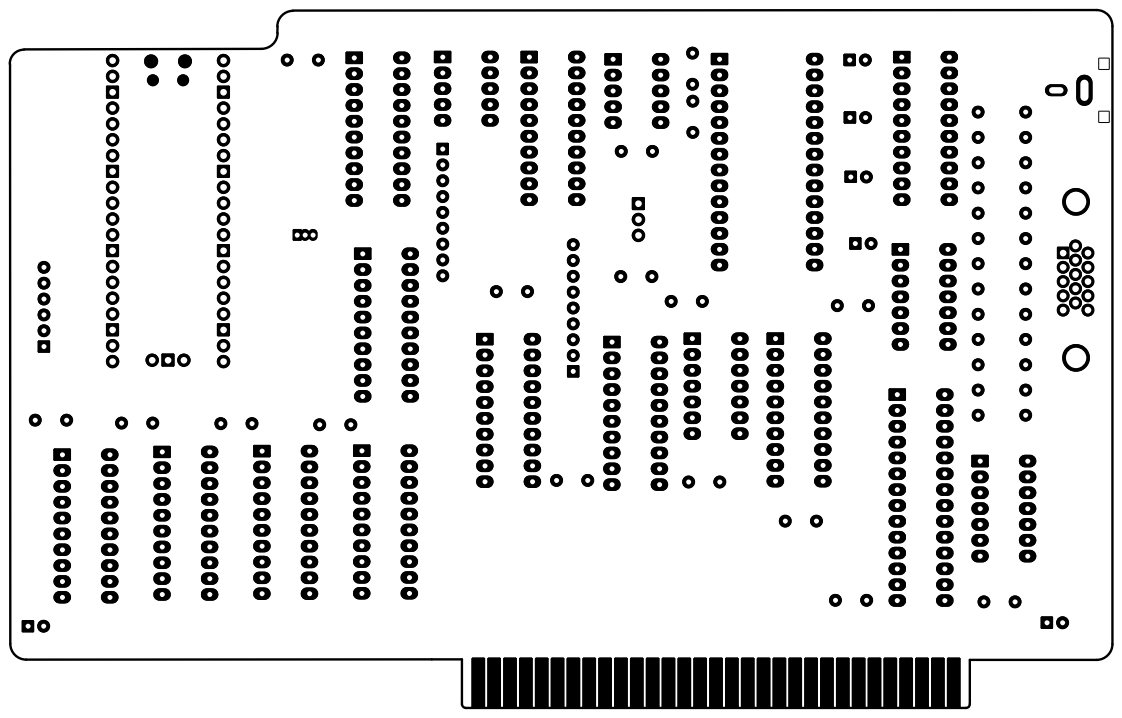
[picture p88: page 6]

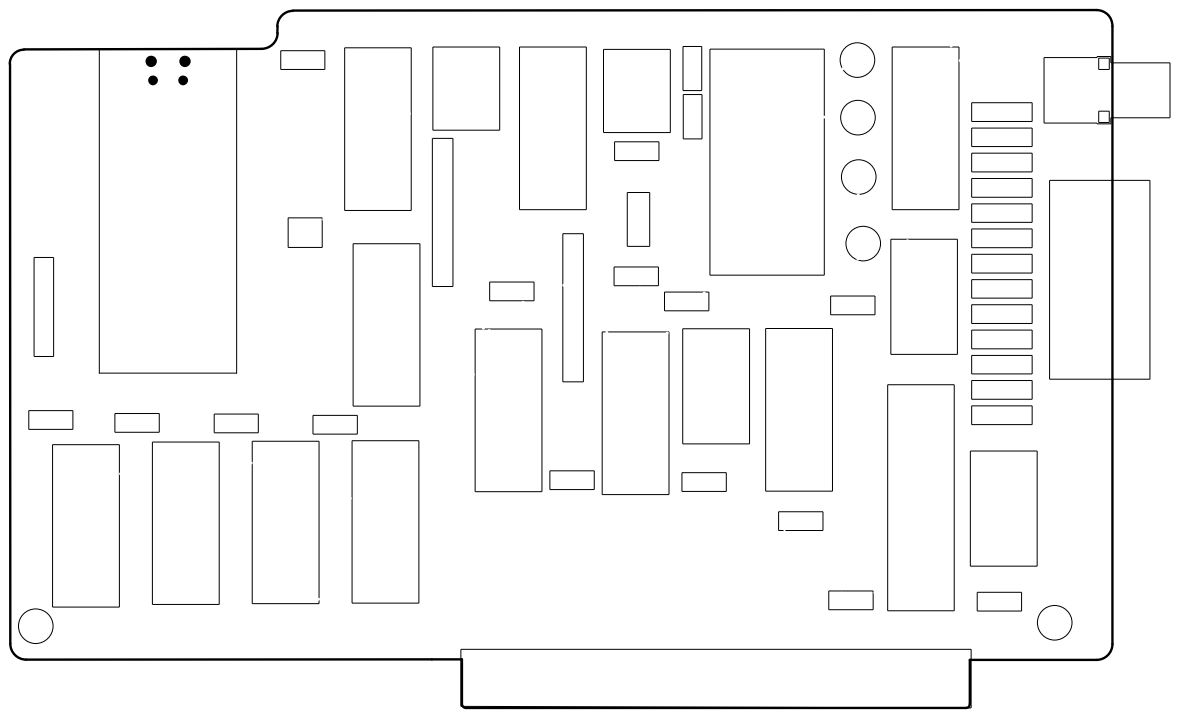
[picture p89: page 7]
