danwerner21/ISA_IO/VIDEO/HARDWARE/schematic-1.0.pdf

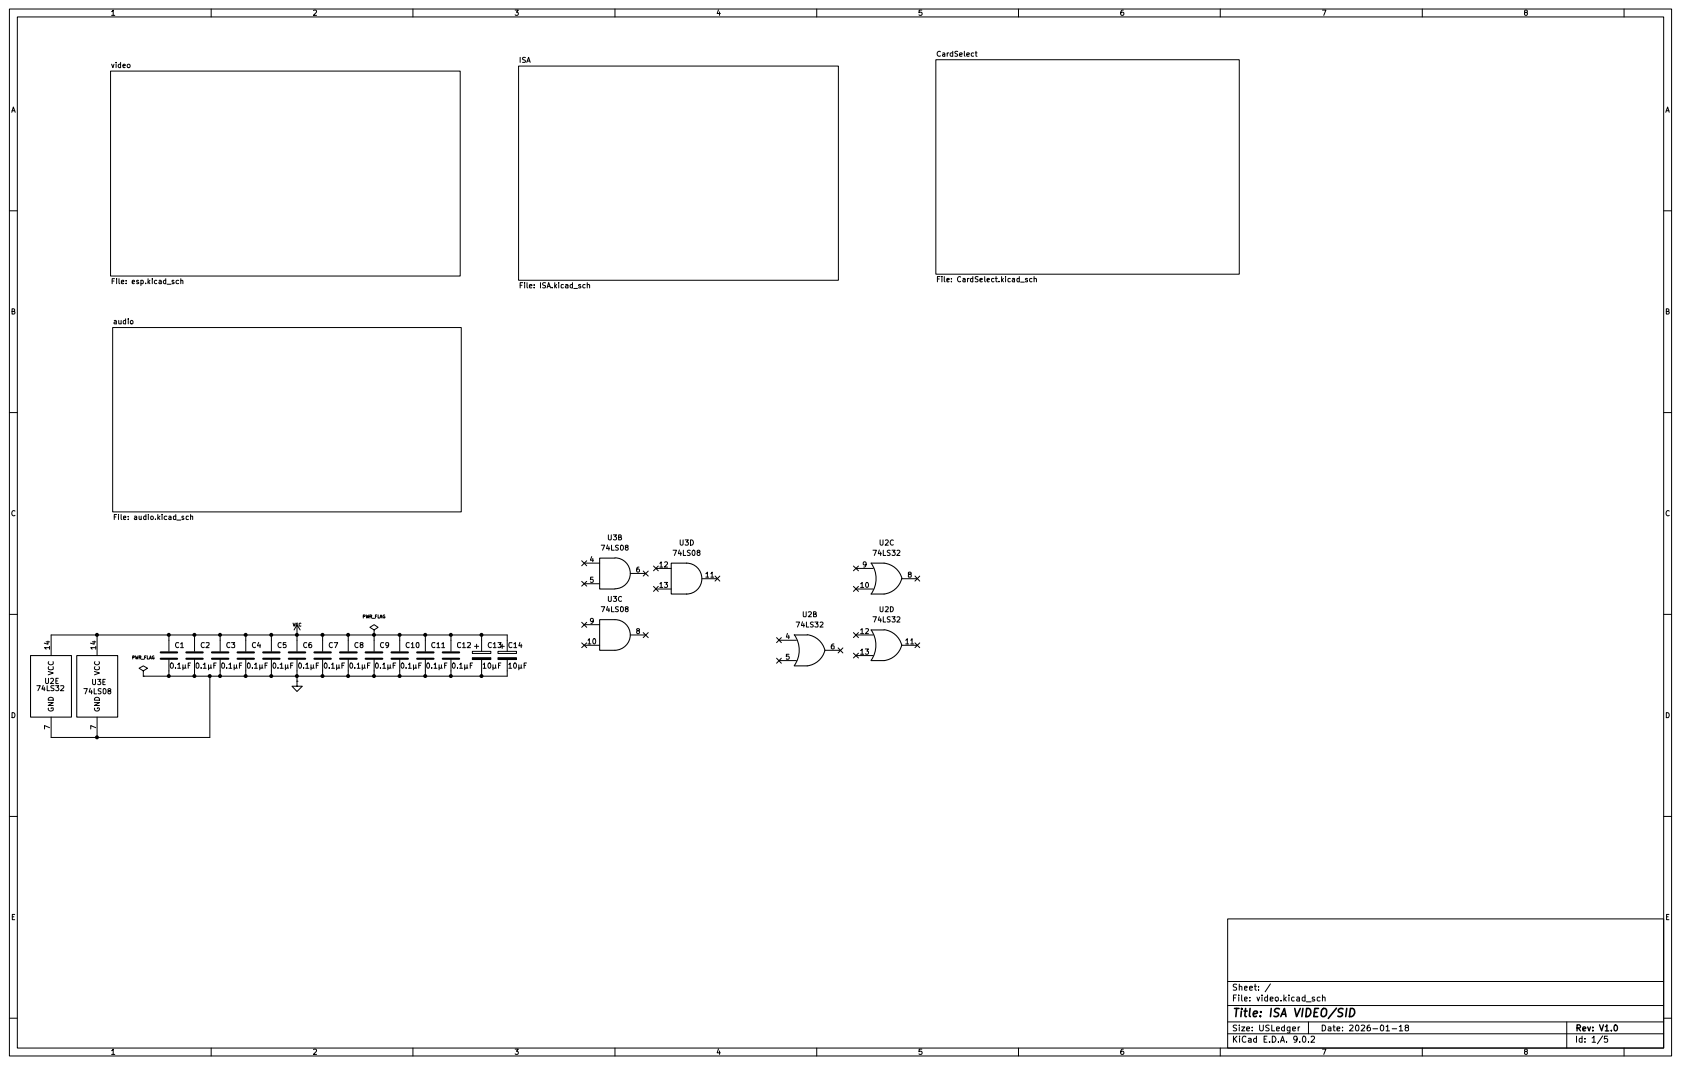
[picture p95: page 1]

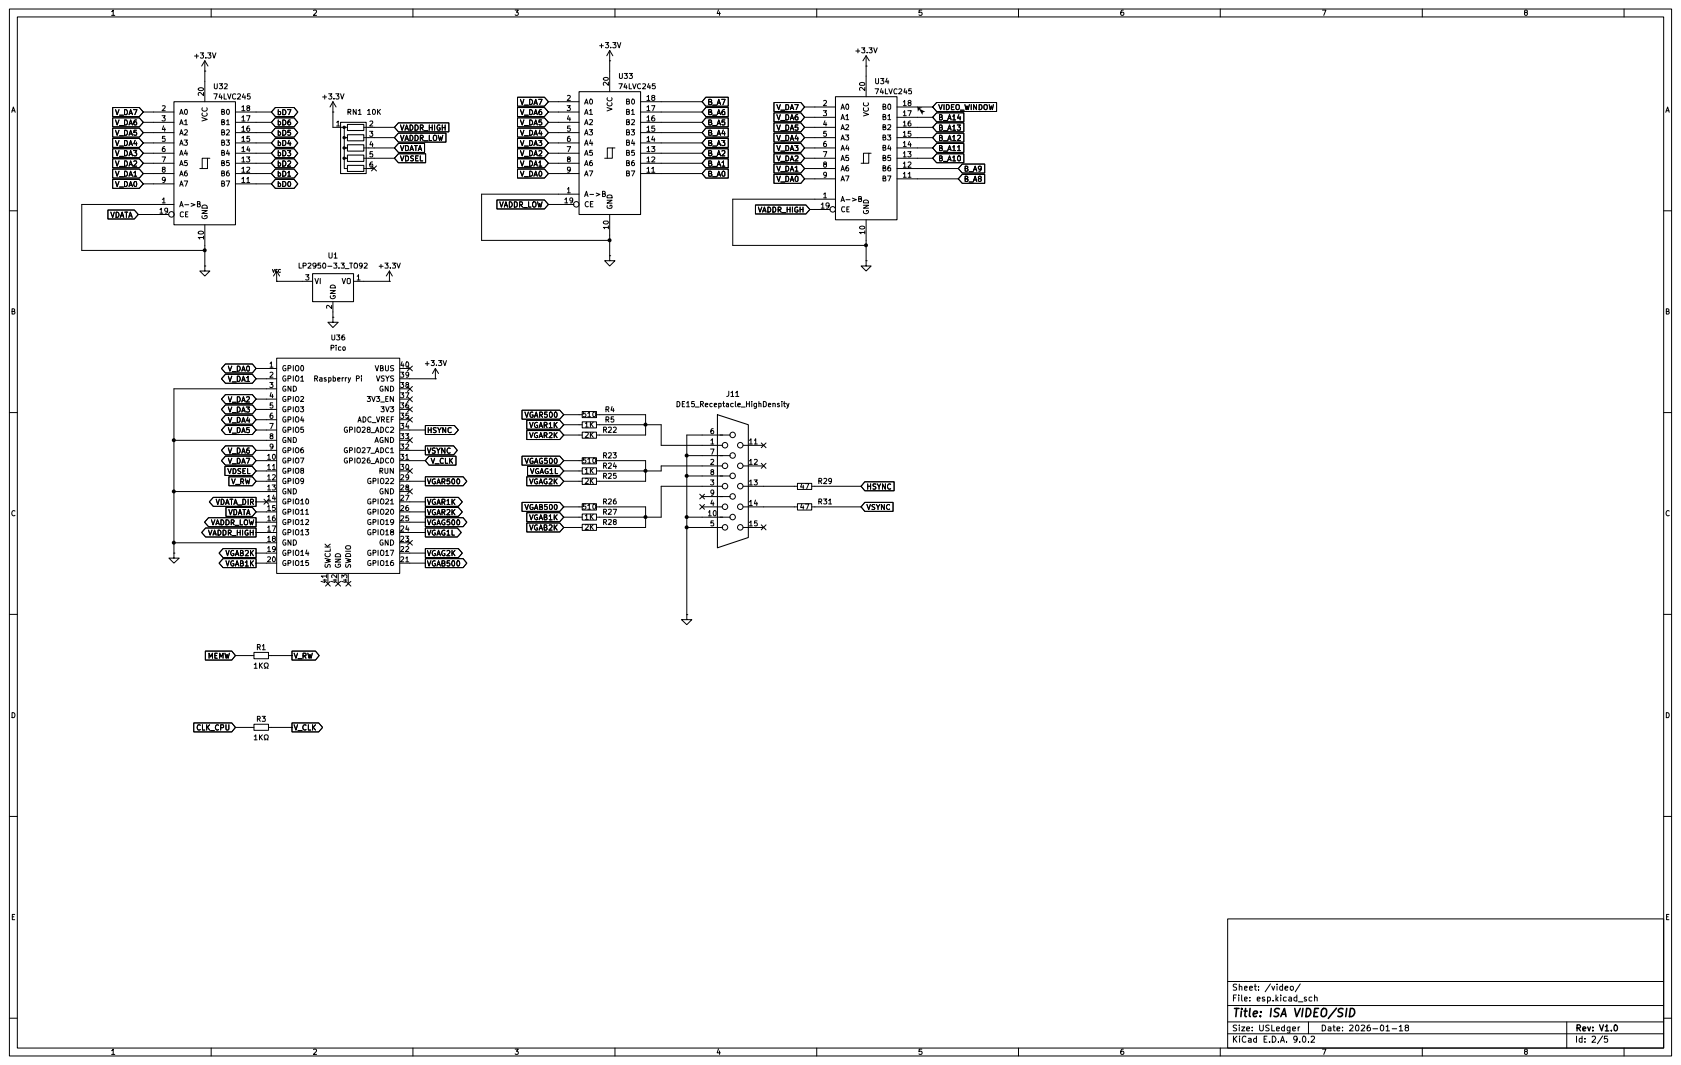
[picture p96: page 2]


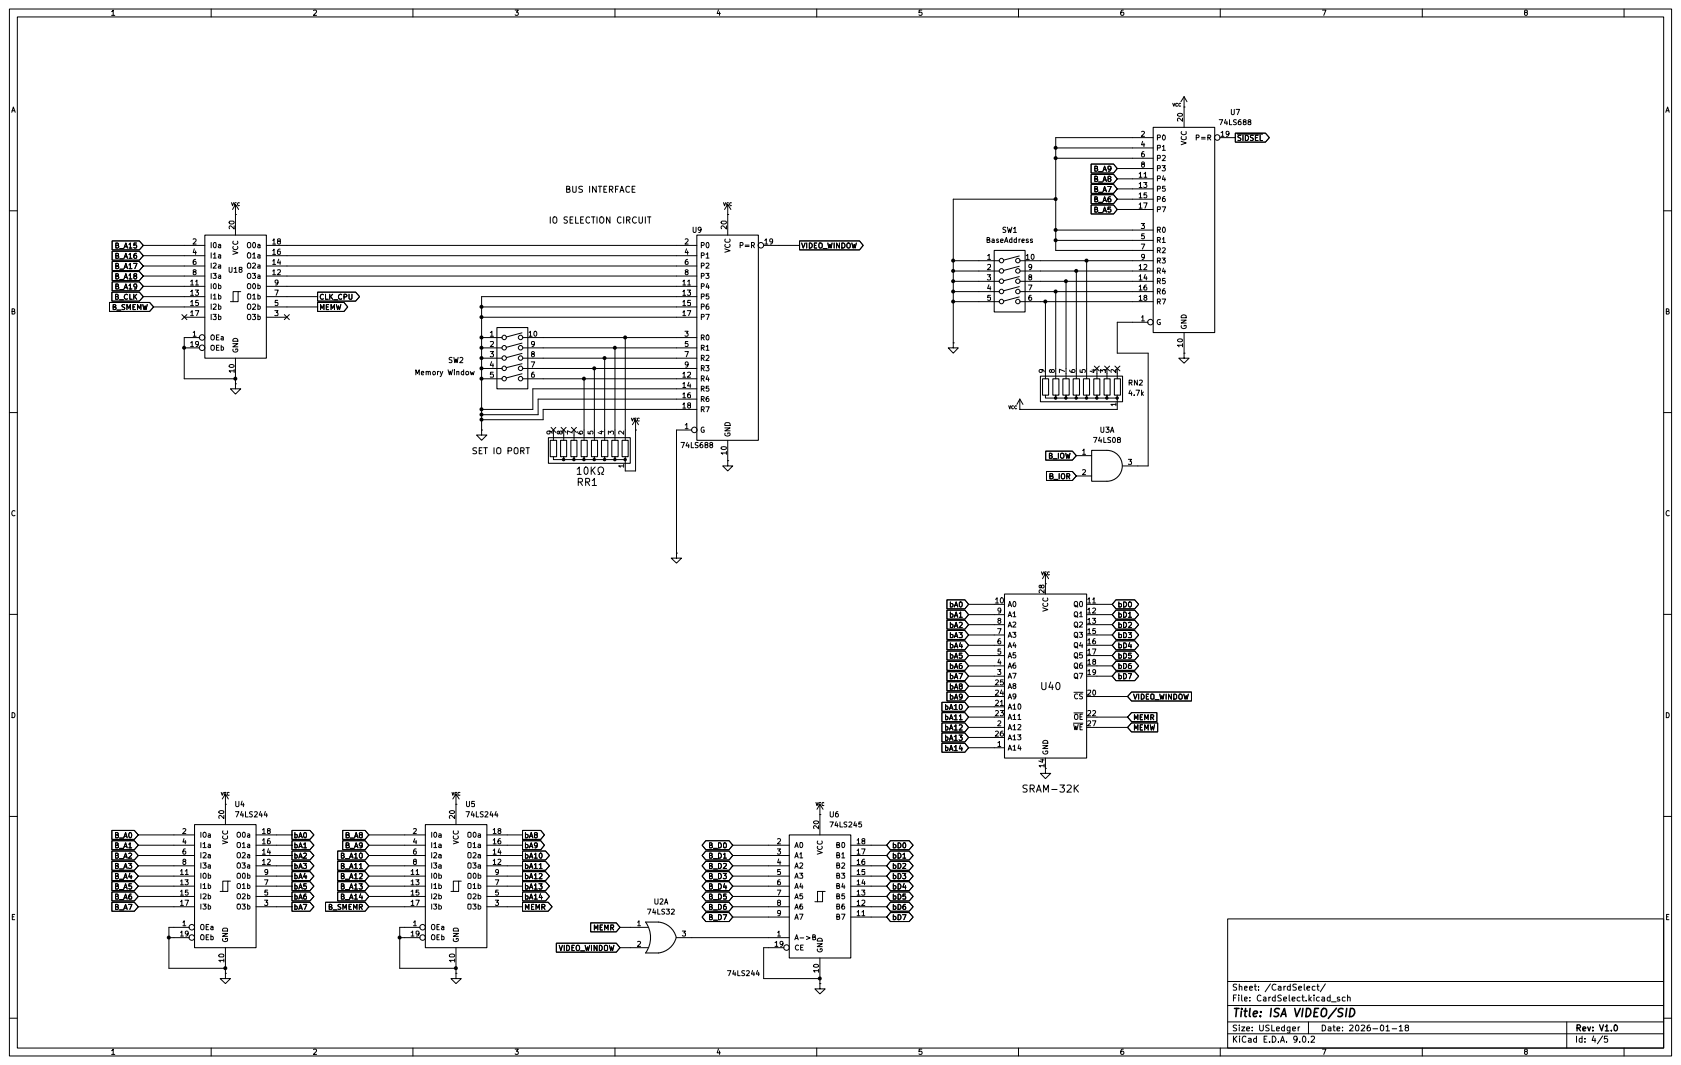
[picture p97: page 4]

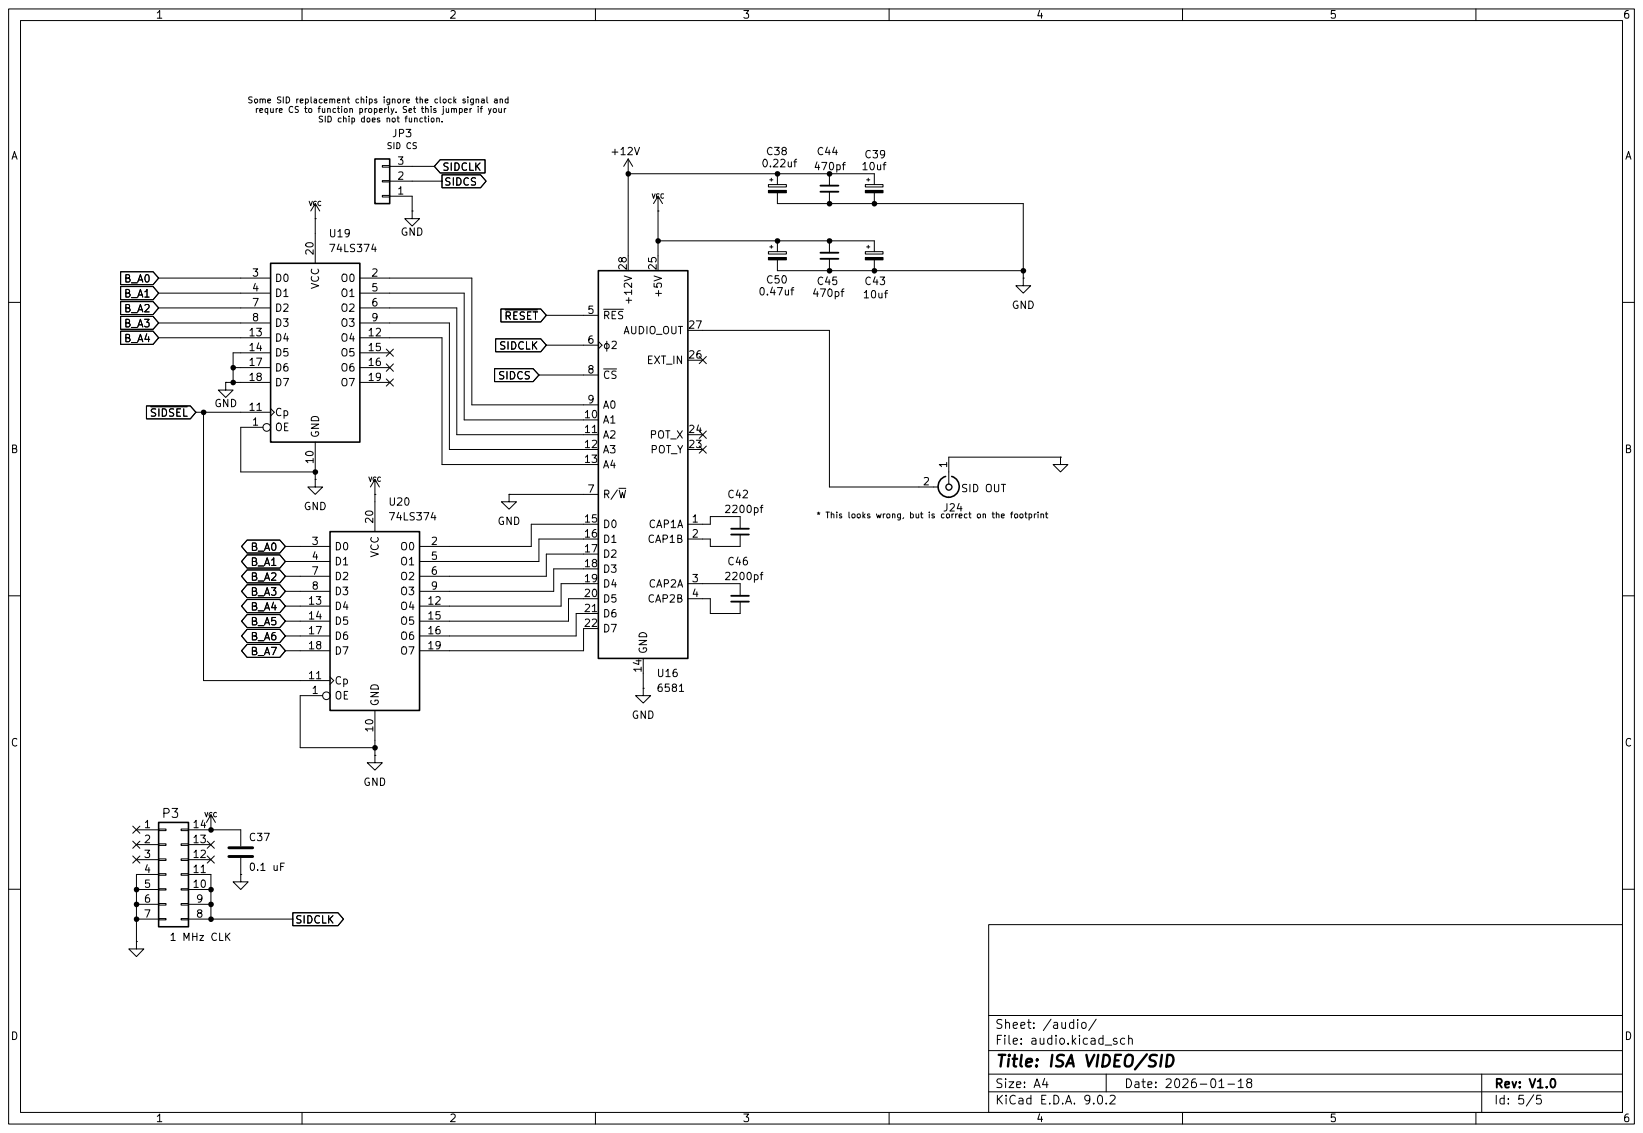
[picture p98: page 5]
