danwerner21/ISA_IO/SOUND/PCBV0.96.pdf

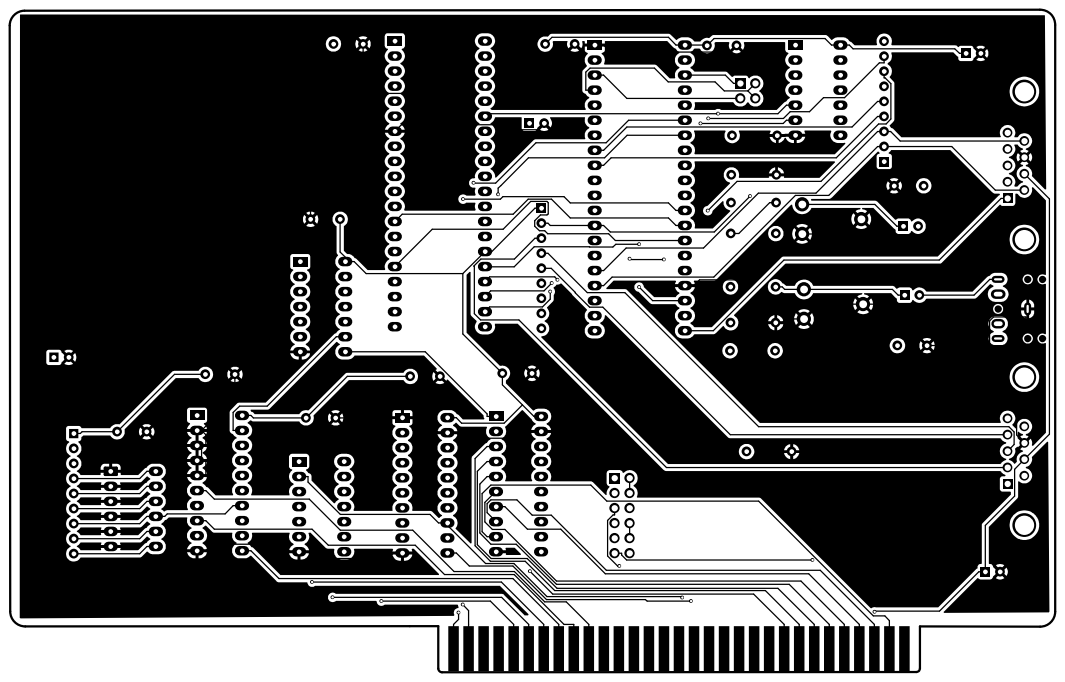
[picture p111: page 1]

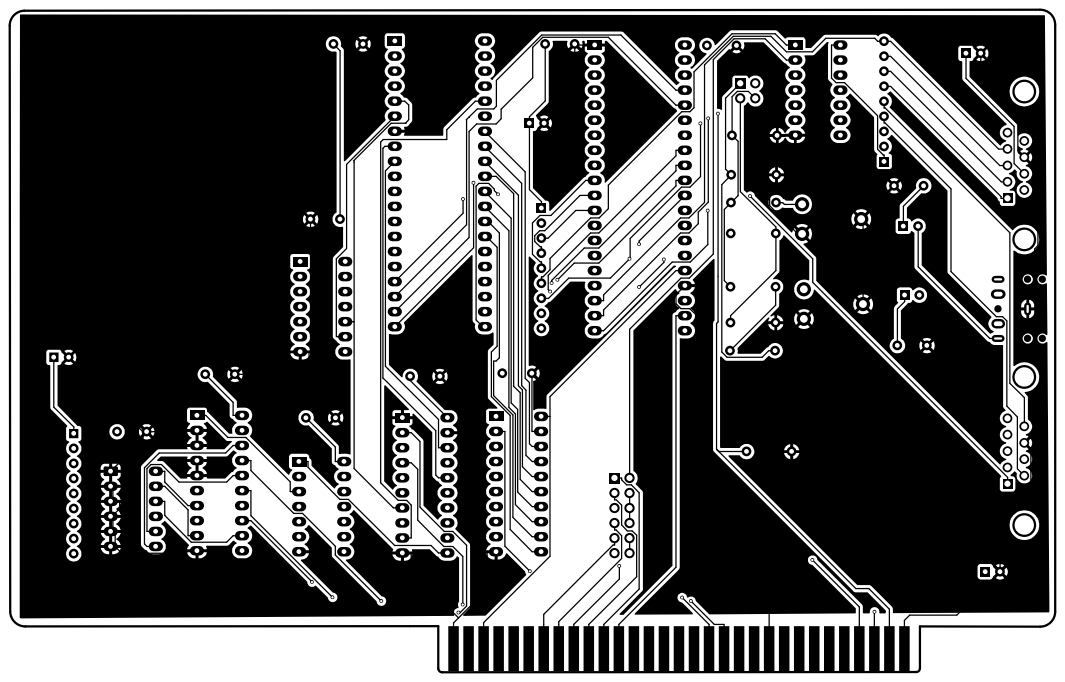
[picture p112: page 2]

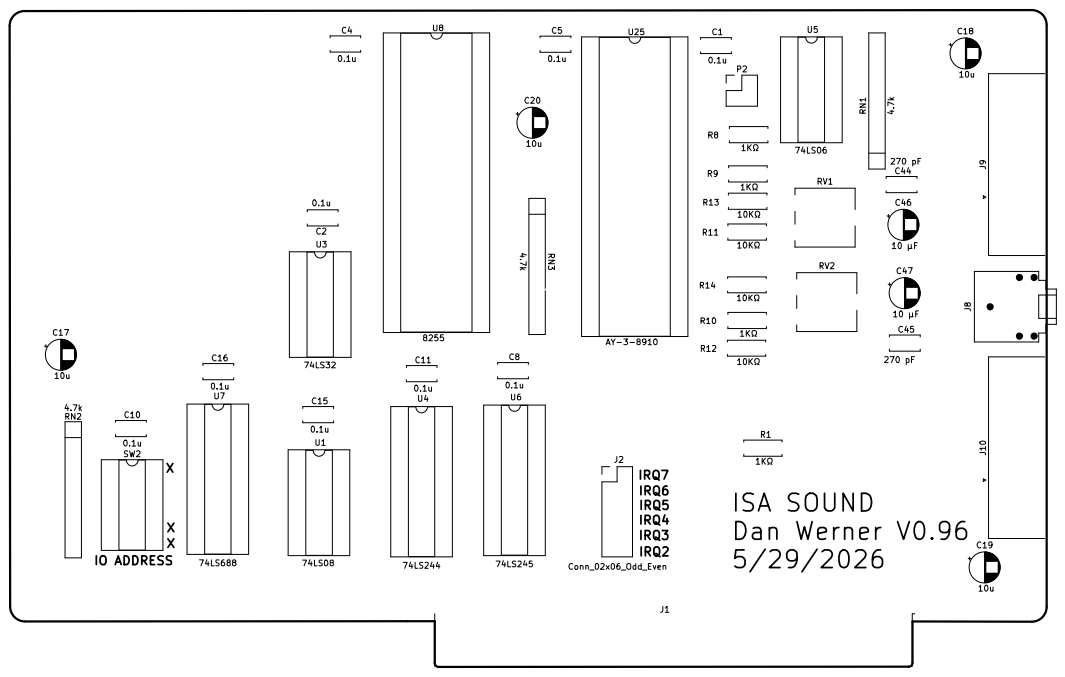
[picture p113: page 3]

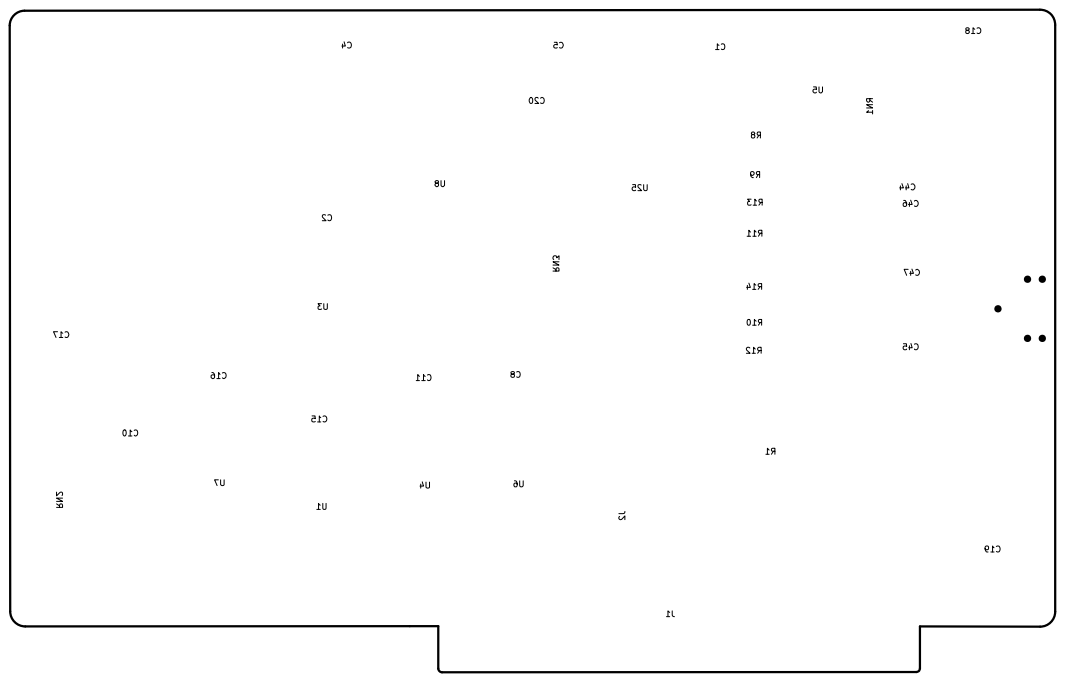
[picture p114: page 4]

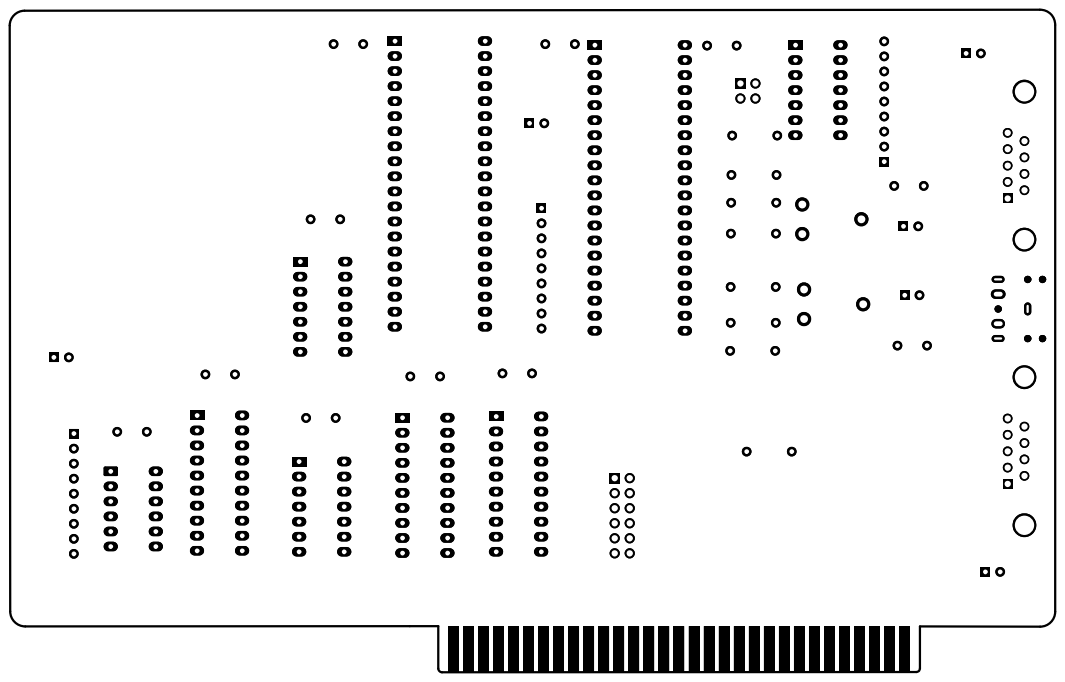
[picture p115: page 5]

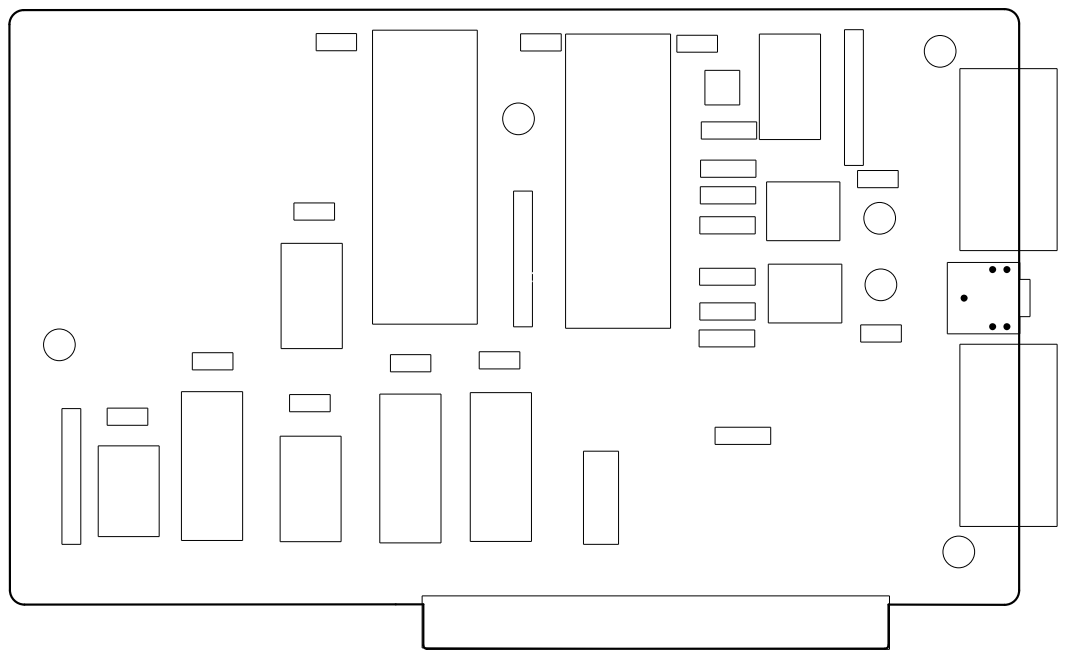
[picture p116: page 7]
