danwerner21/ISA_IO/DUALESP/DUALESP_PCB_V1.2.pdf

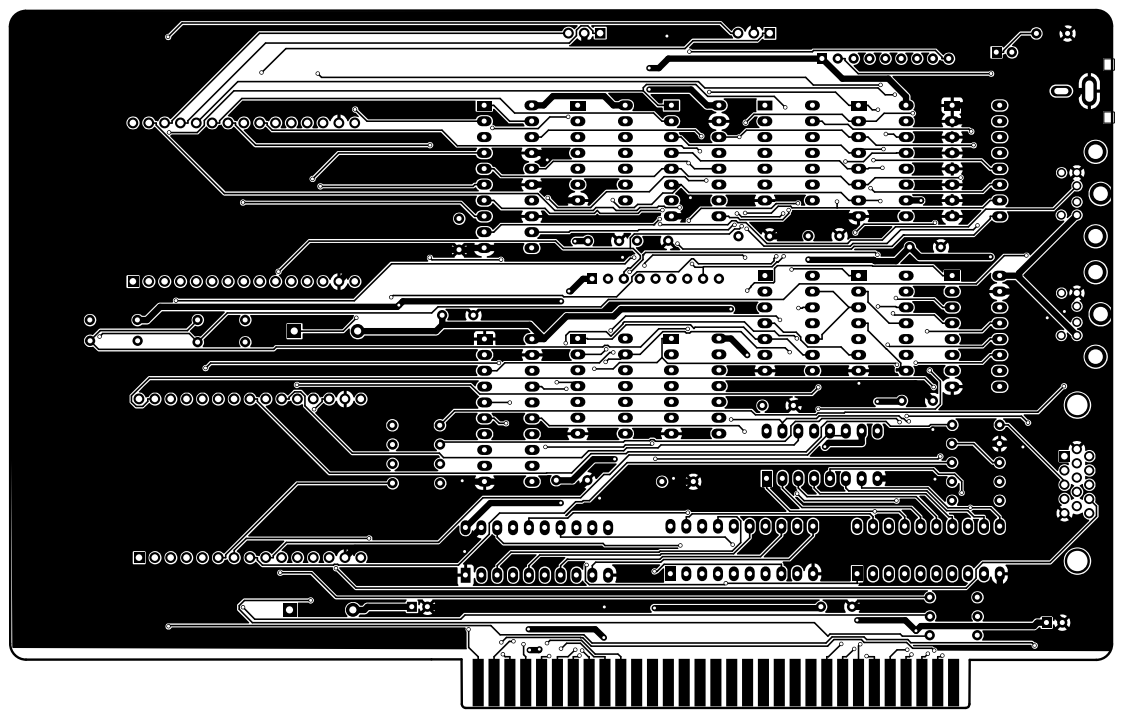
[picture p123: page 1]

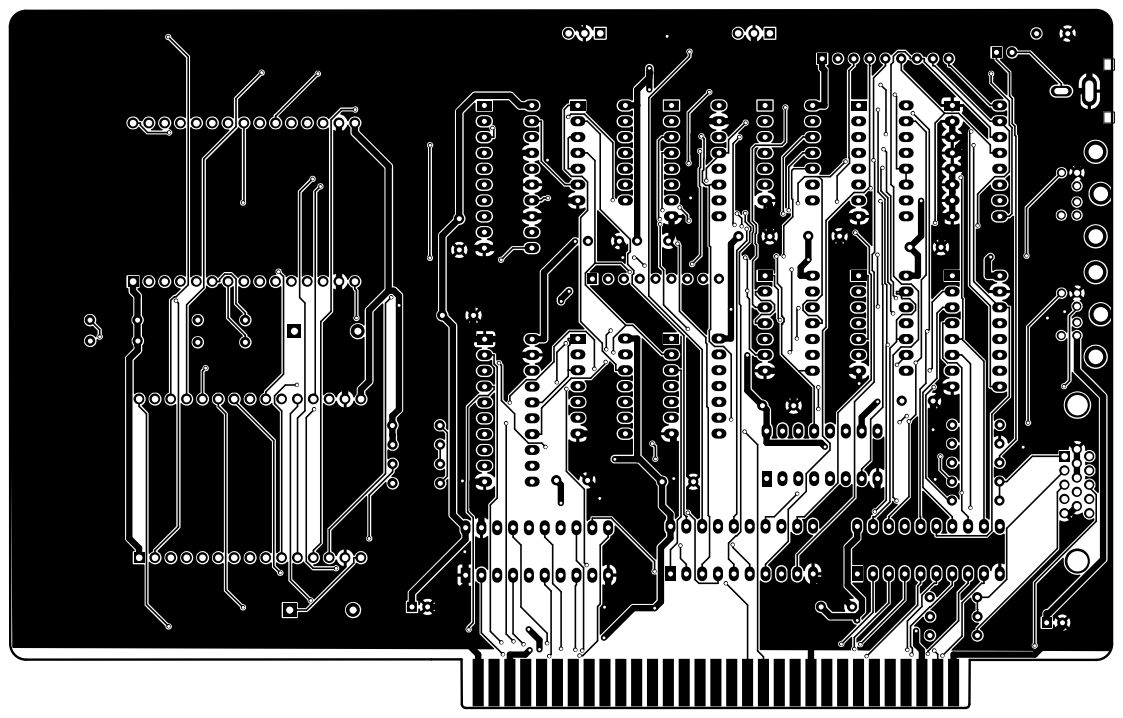
[picture p124: page 2]

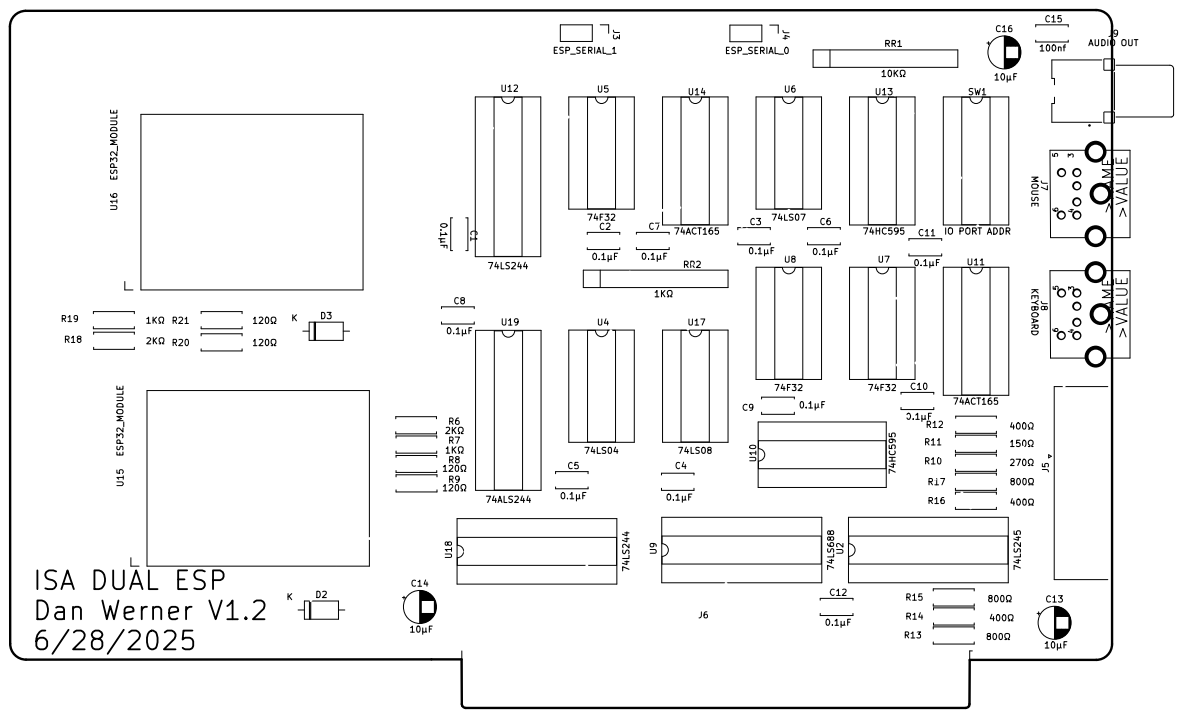
[picture p125: page 3]

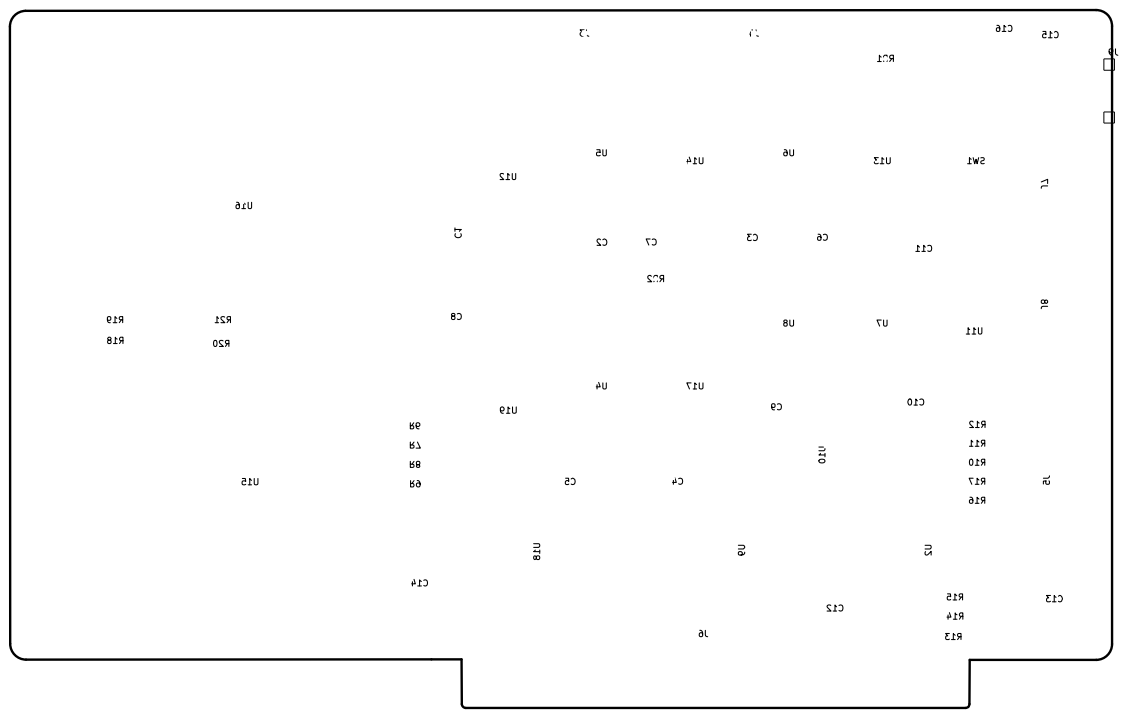
[picture p126: page 4]

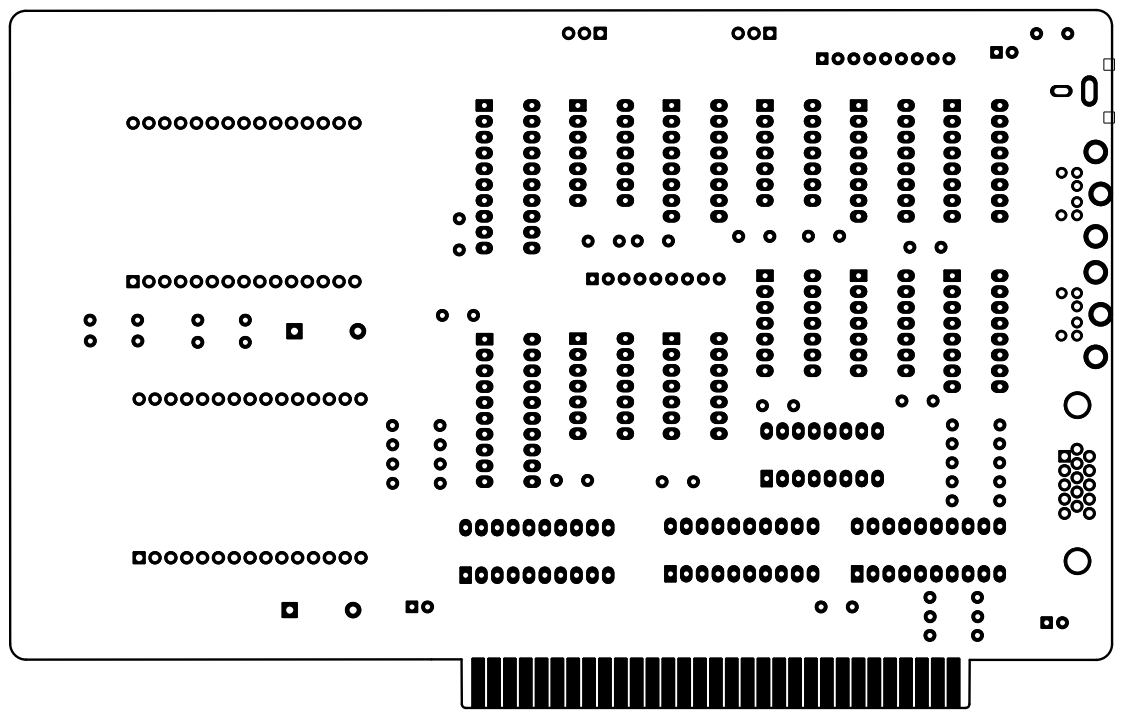
[picture p127: page 5]

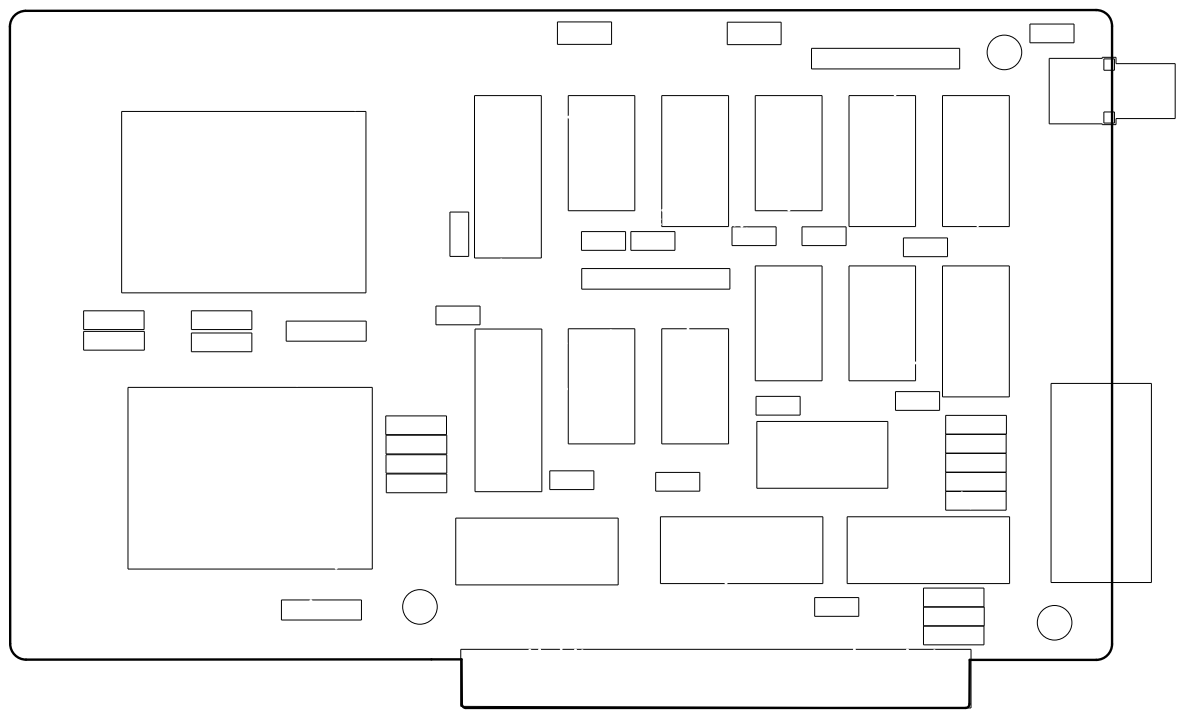
[picture p128: page 7]
