danwerner21/ISA_IO/MULTIIO/MULTIIO/PCB-v1.1.pdf

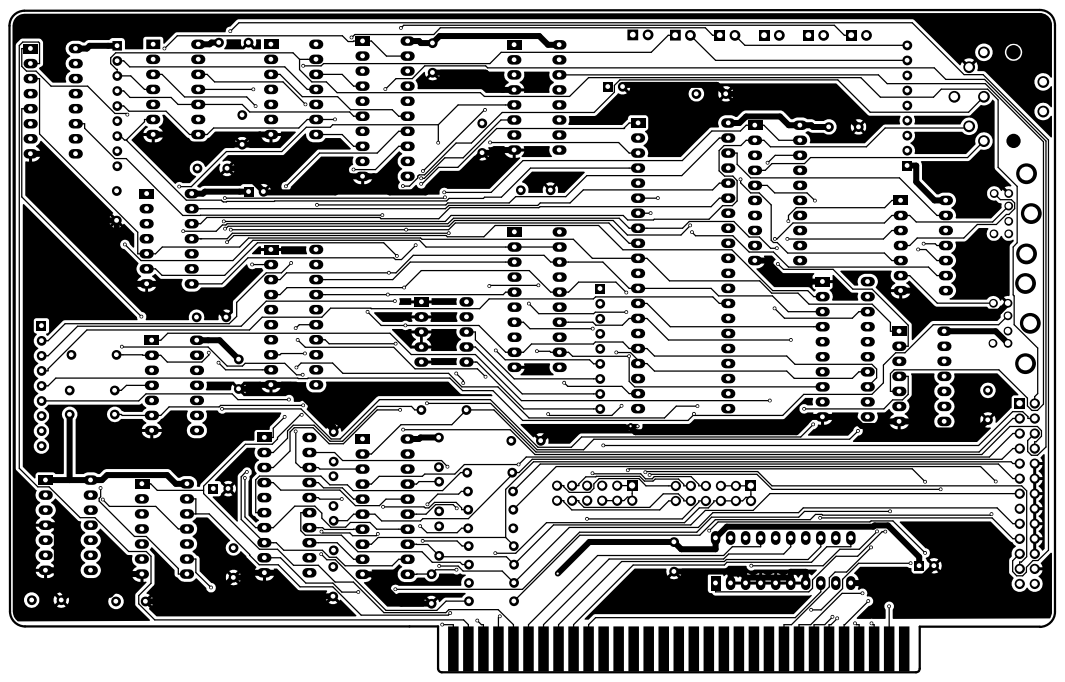
[picture p129: page 1]

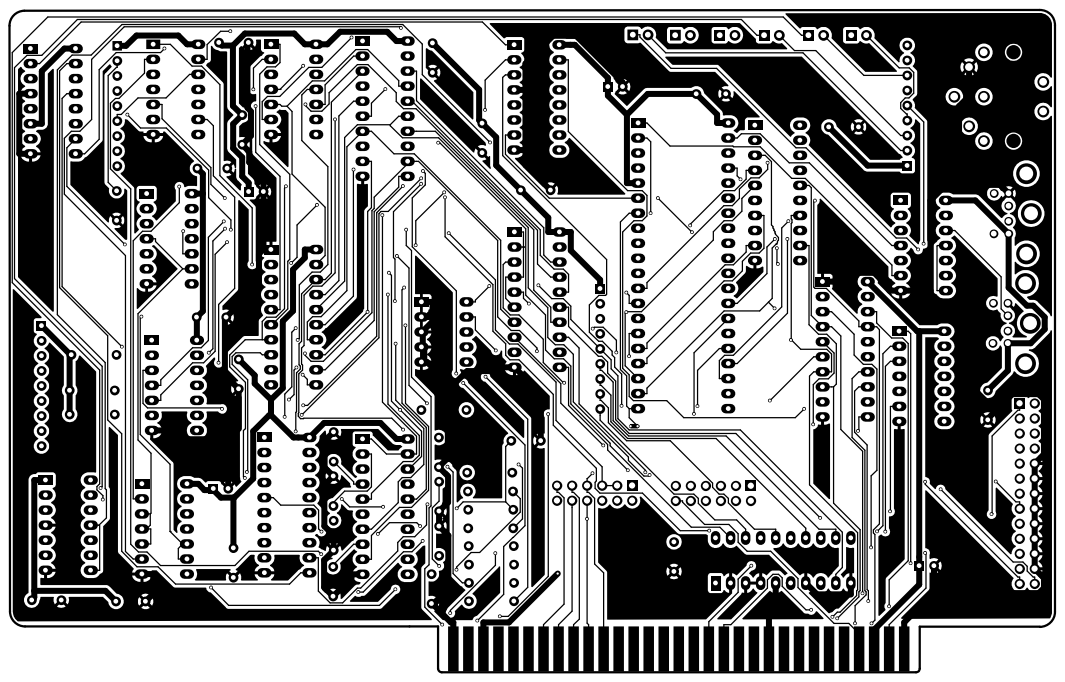
[picture p130: page 2]

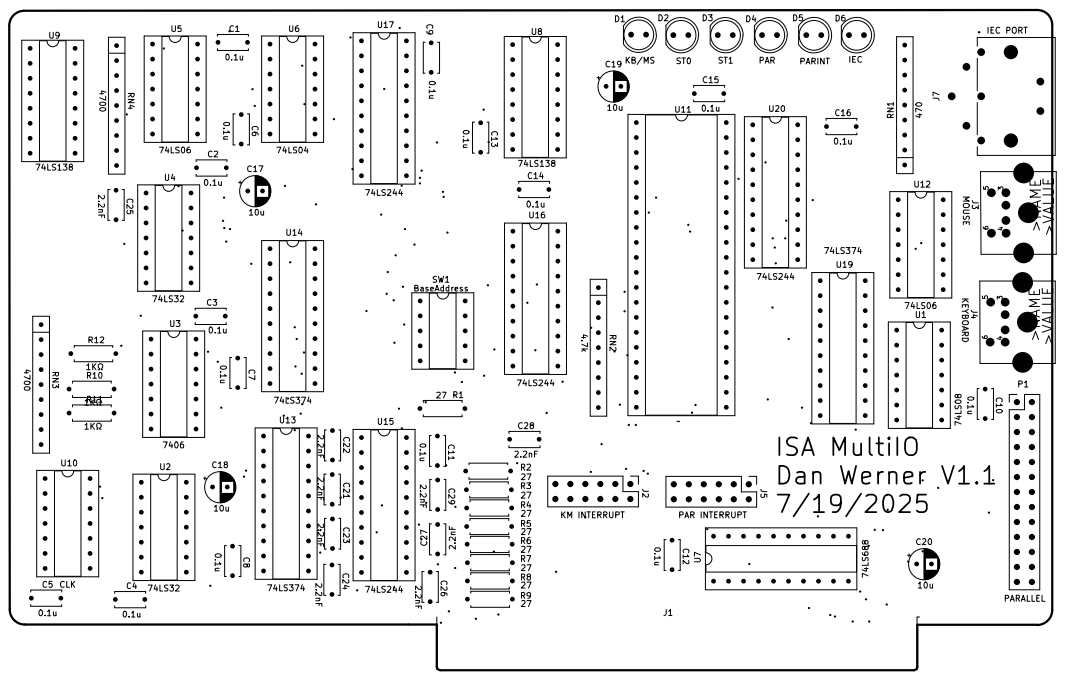
[picture p131: page 3]

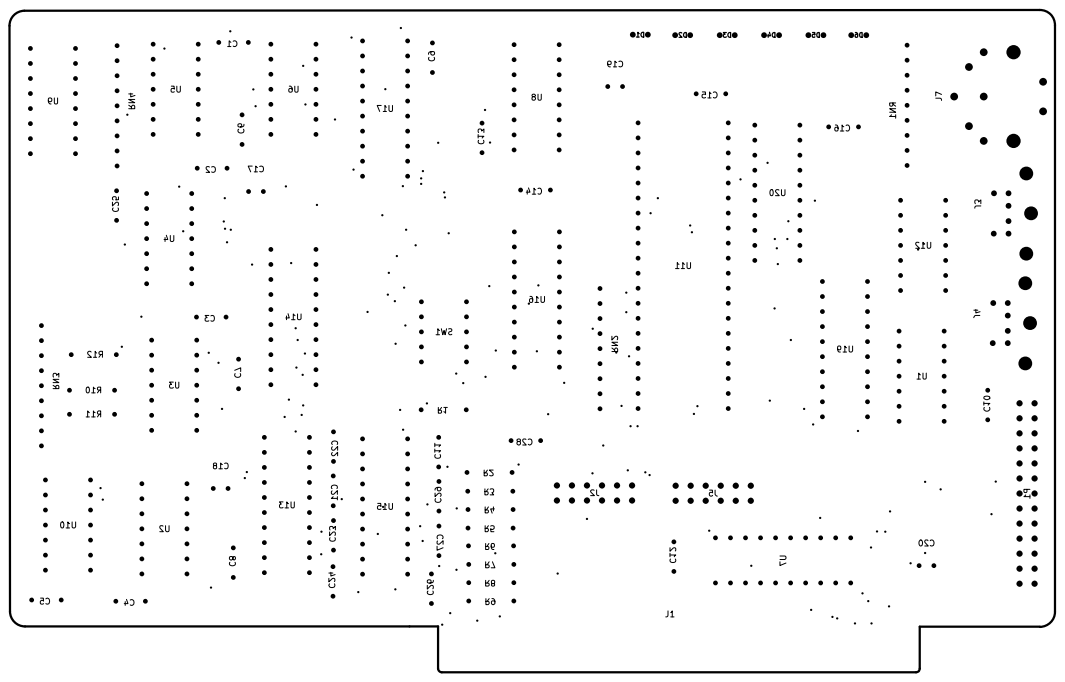
[picture p132: page 4]

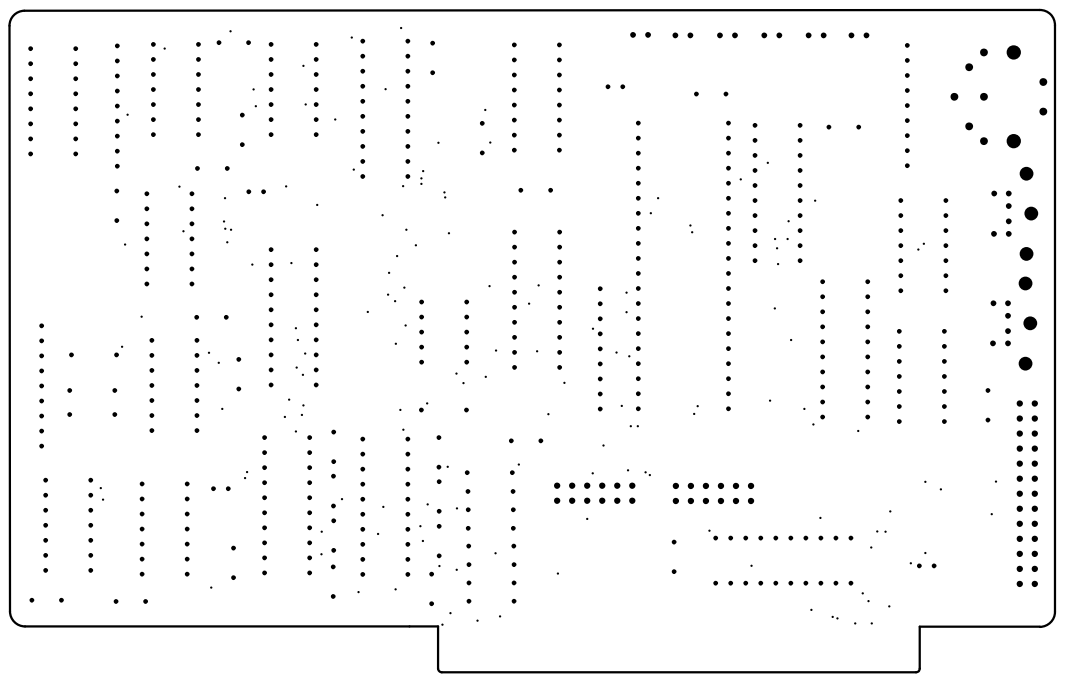
[picture p133: page 5]
