danwerner21/ISA_IO/DUALESP/DUALESP_schematic_V1.1.pdf

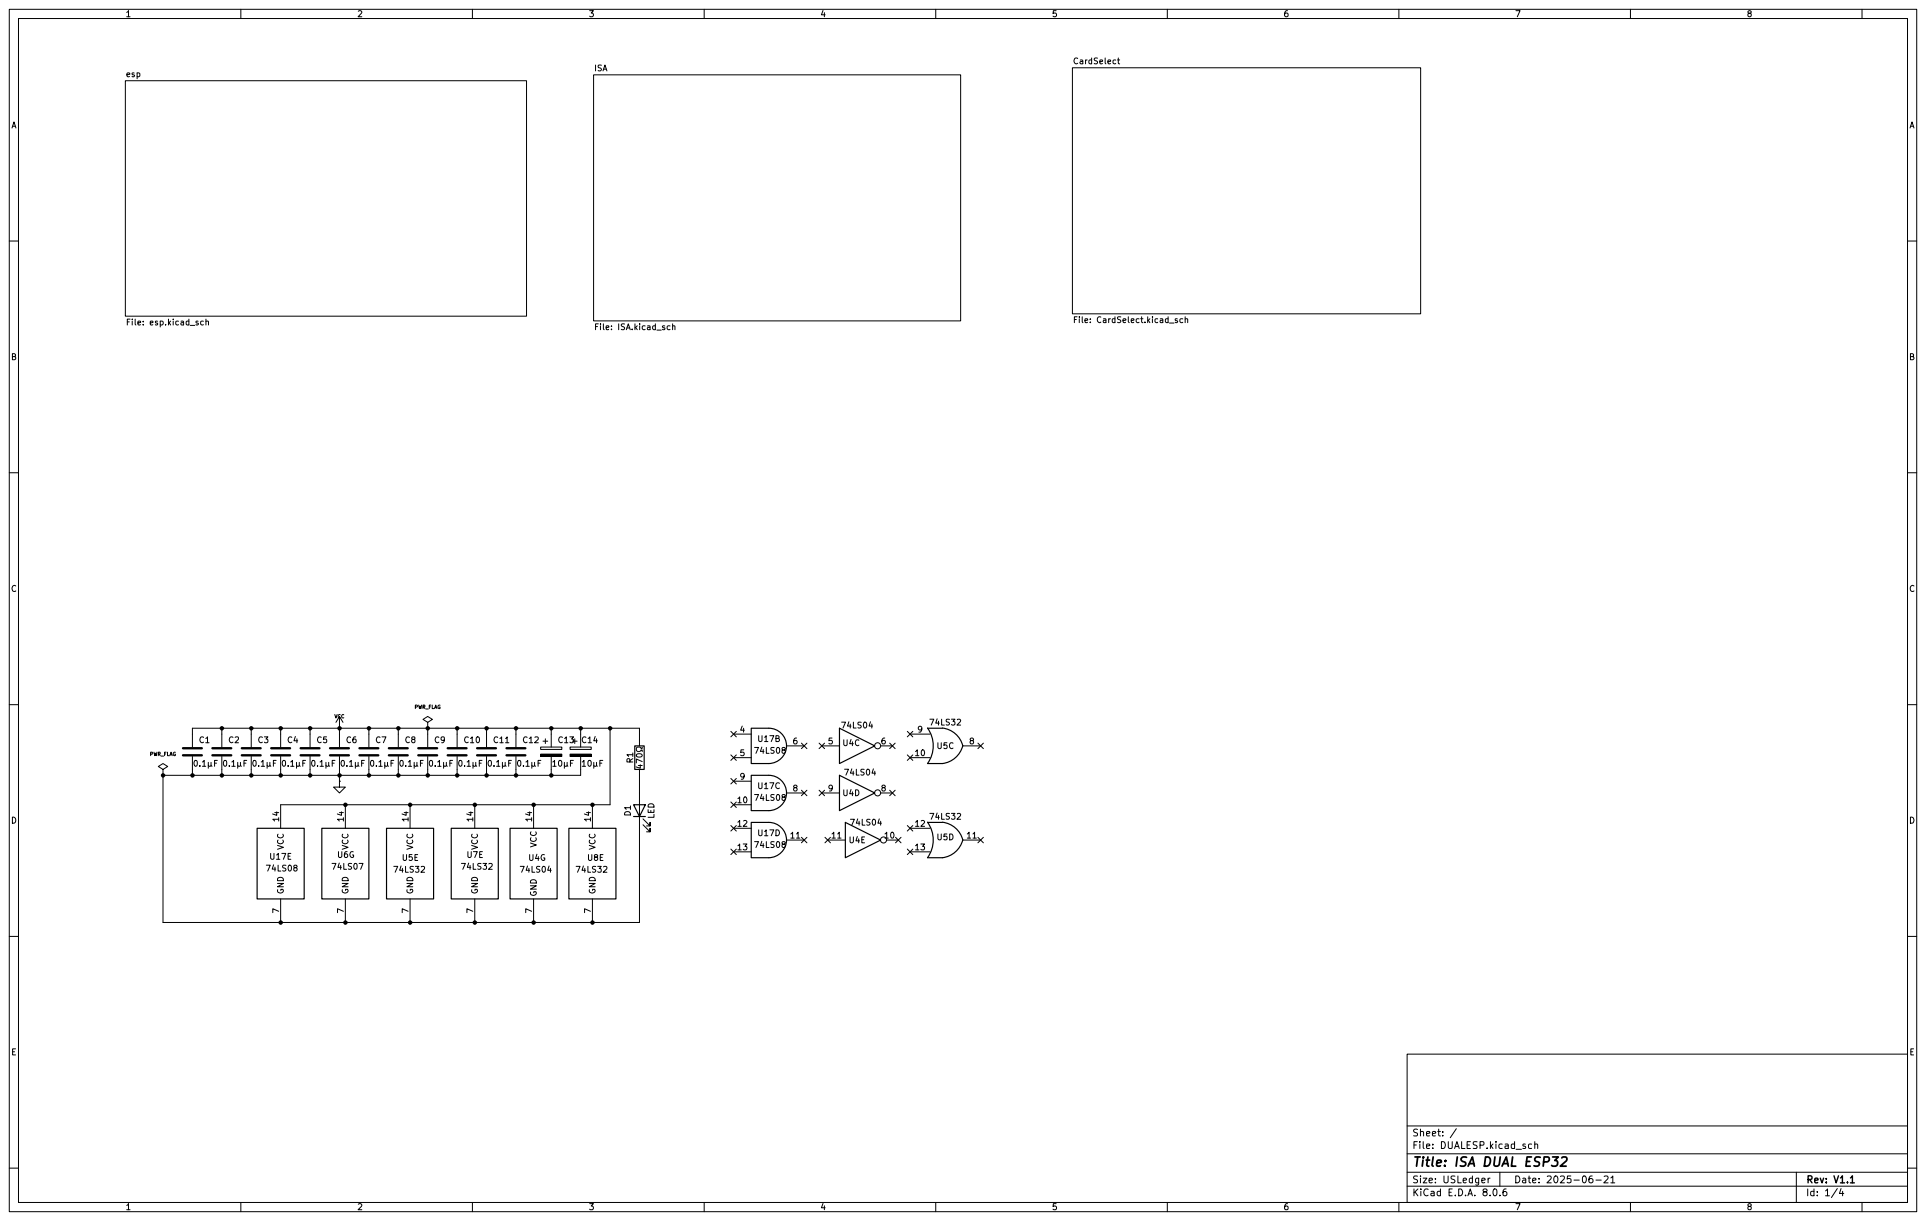
[picture p134: page 1]

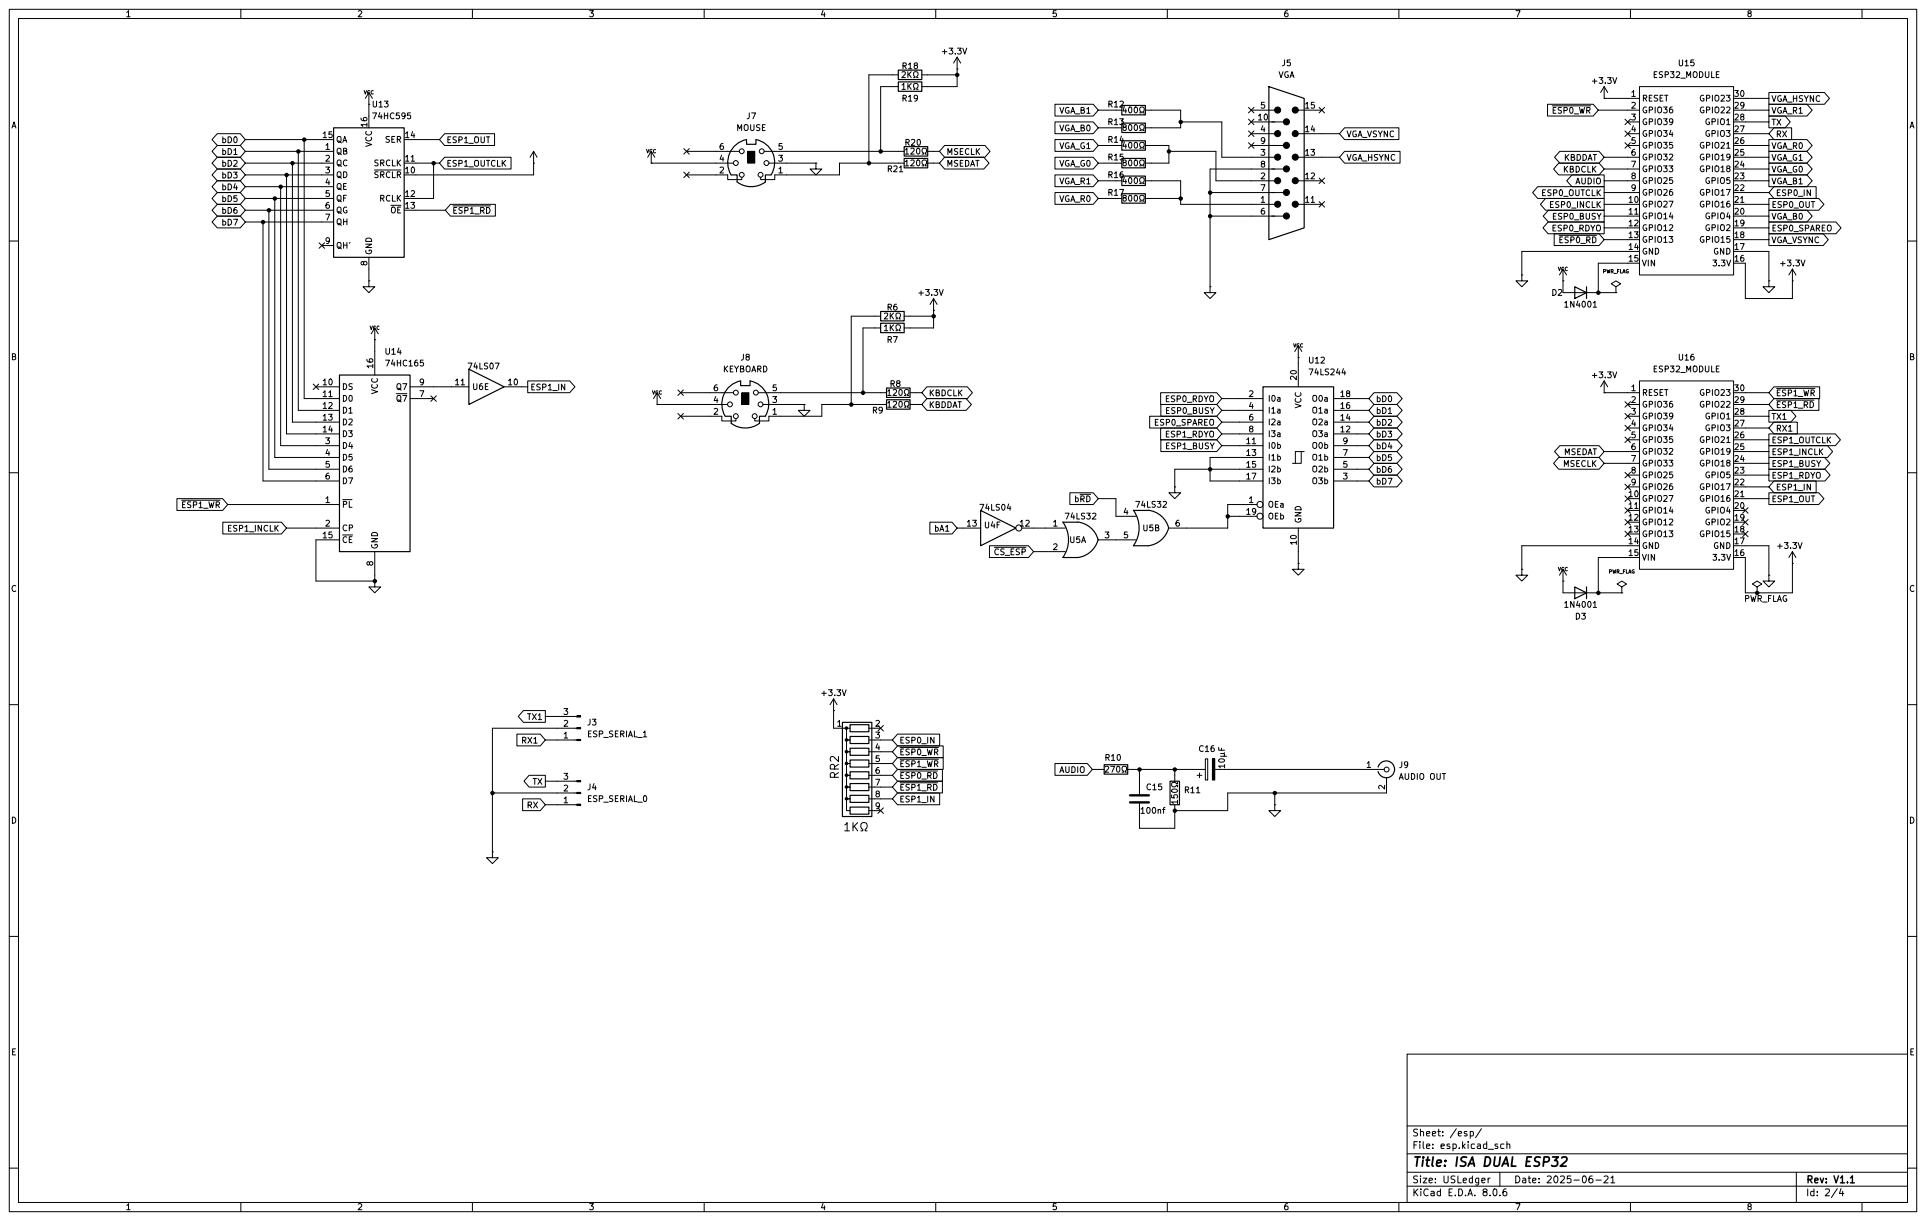
[picture p135: page 2]

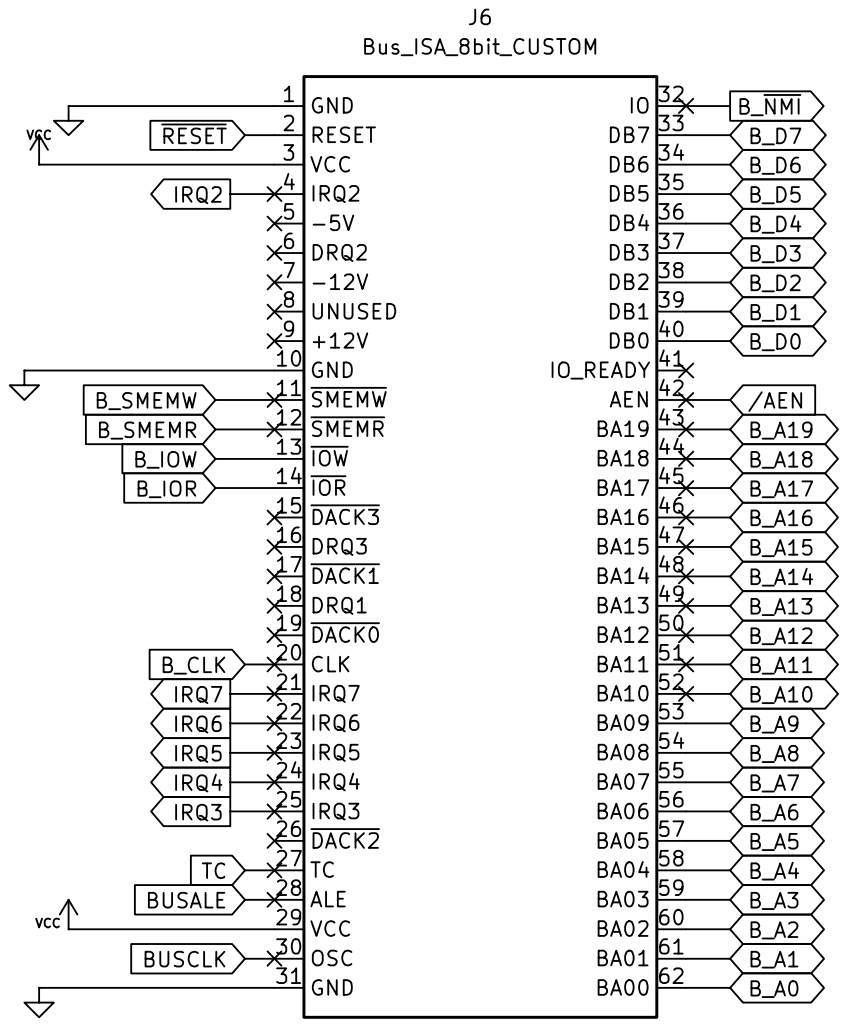
[picture p136: page 3]

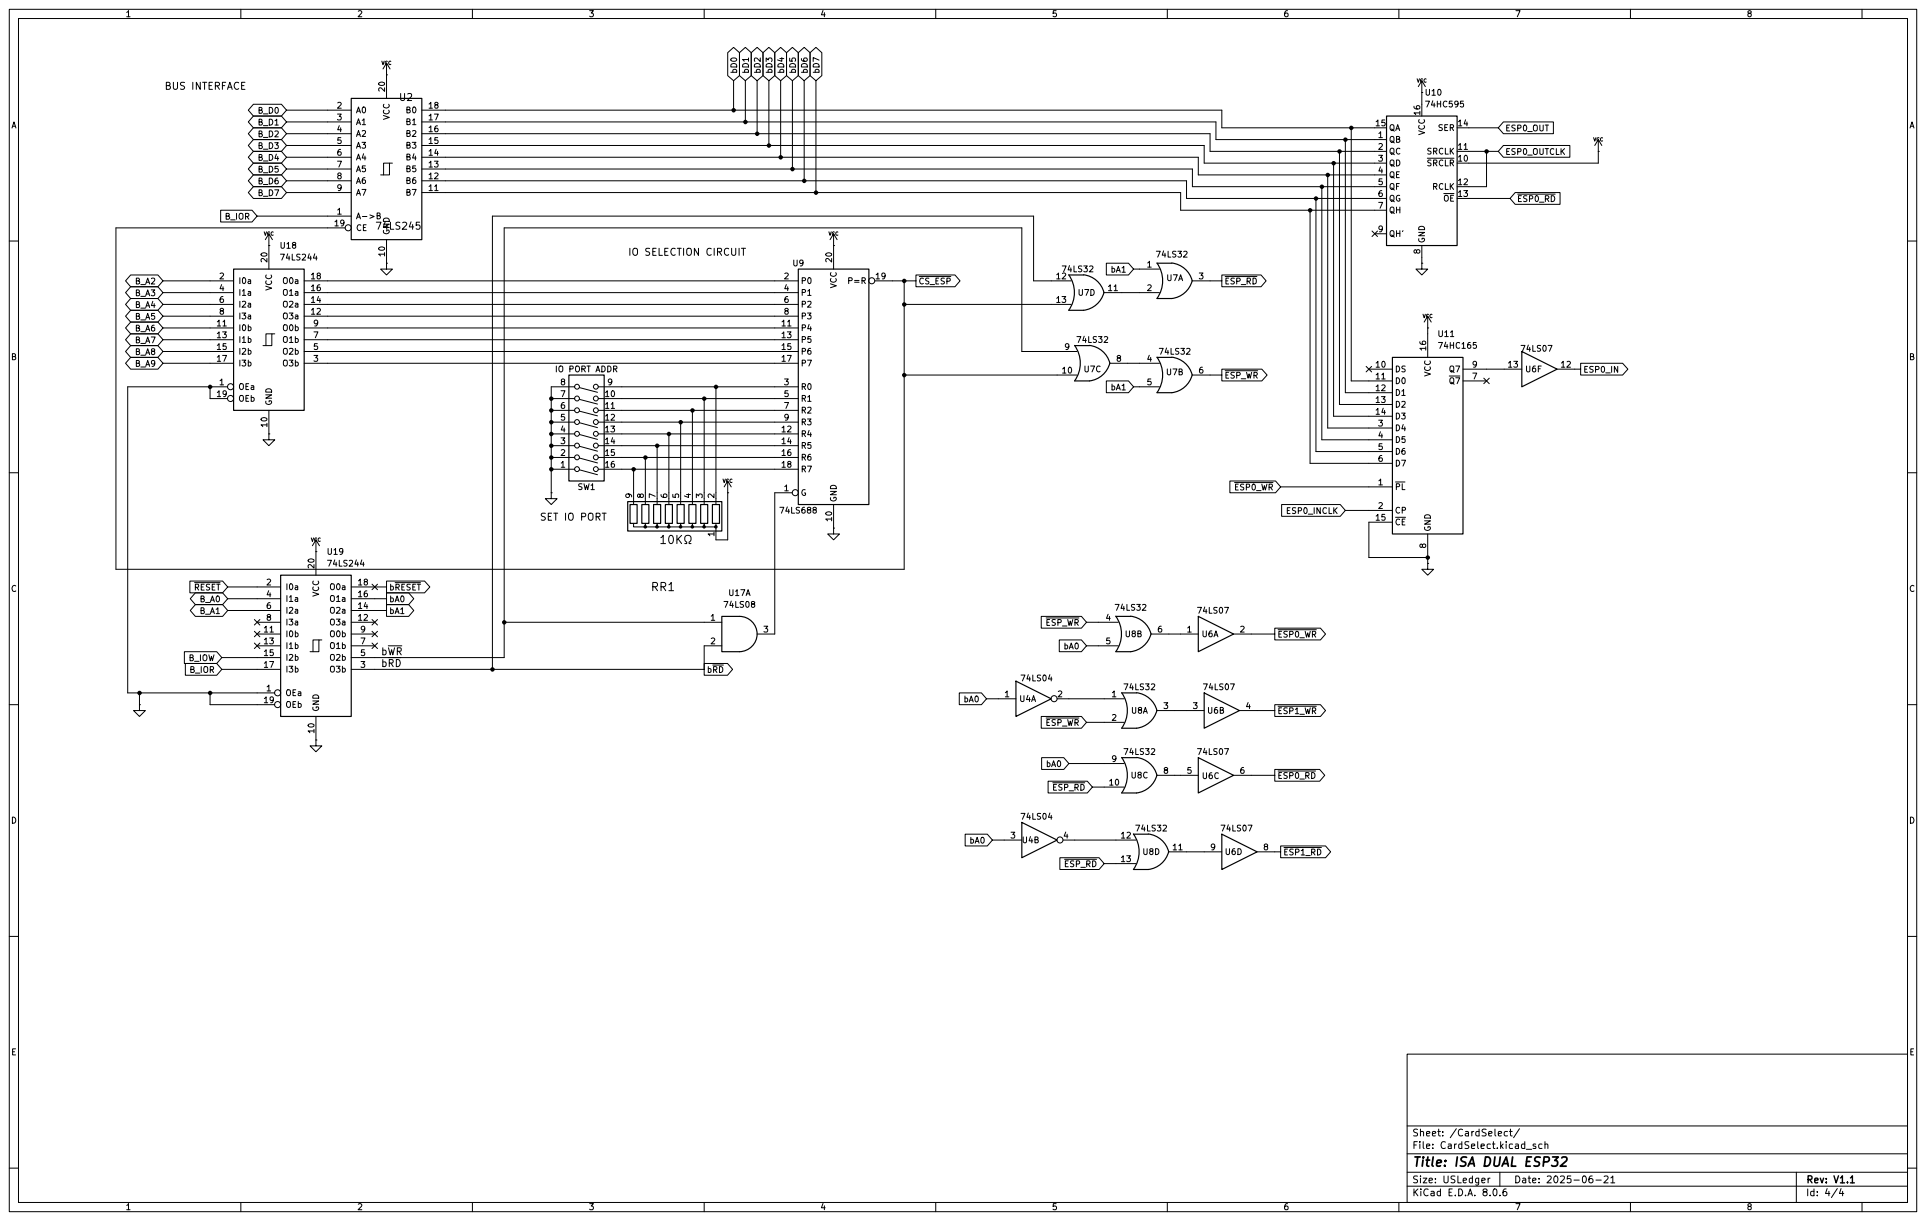
[picture p137: page 4]
