danwerner21/ISA_IO/DUALESP/DUALESP_schematic_V1.pdf

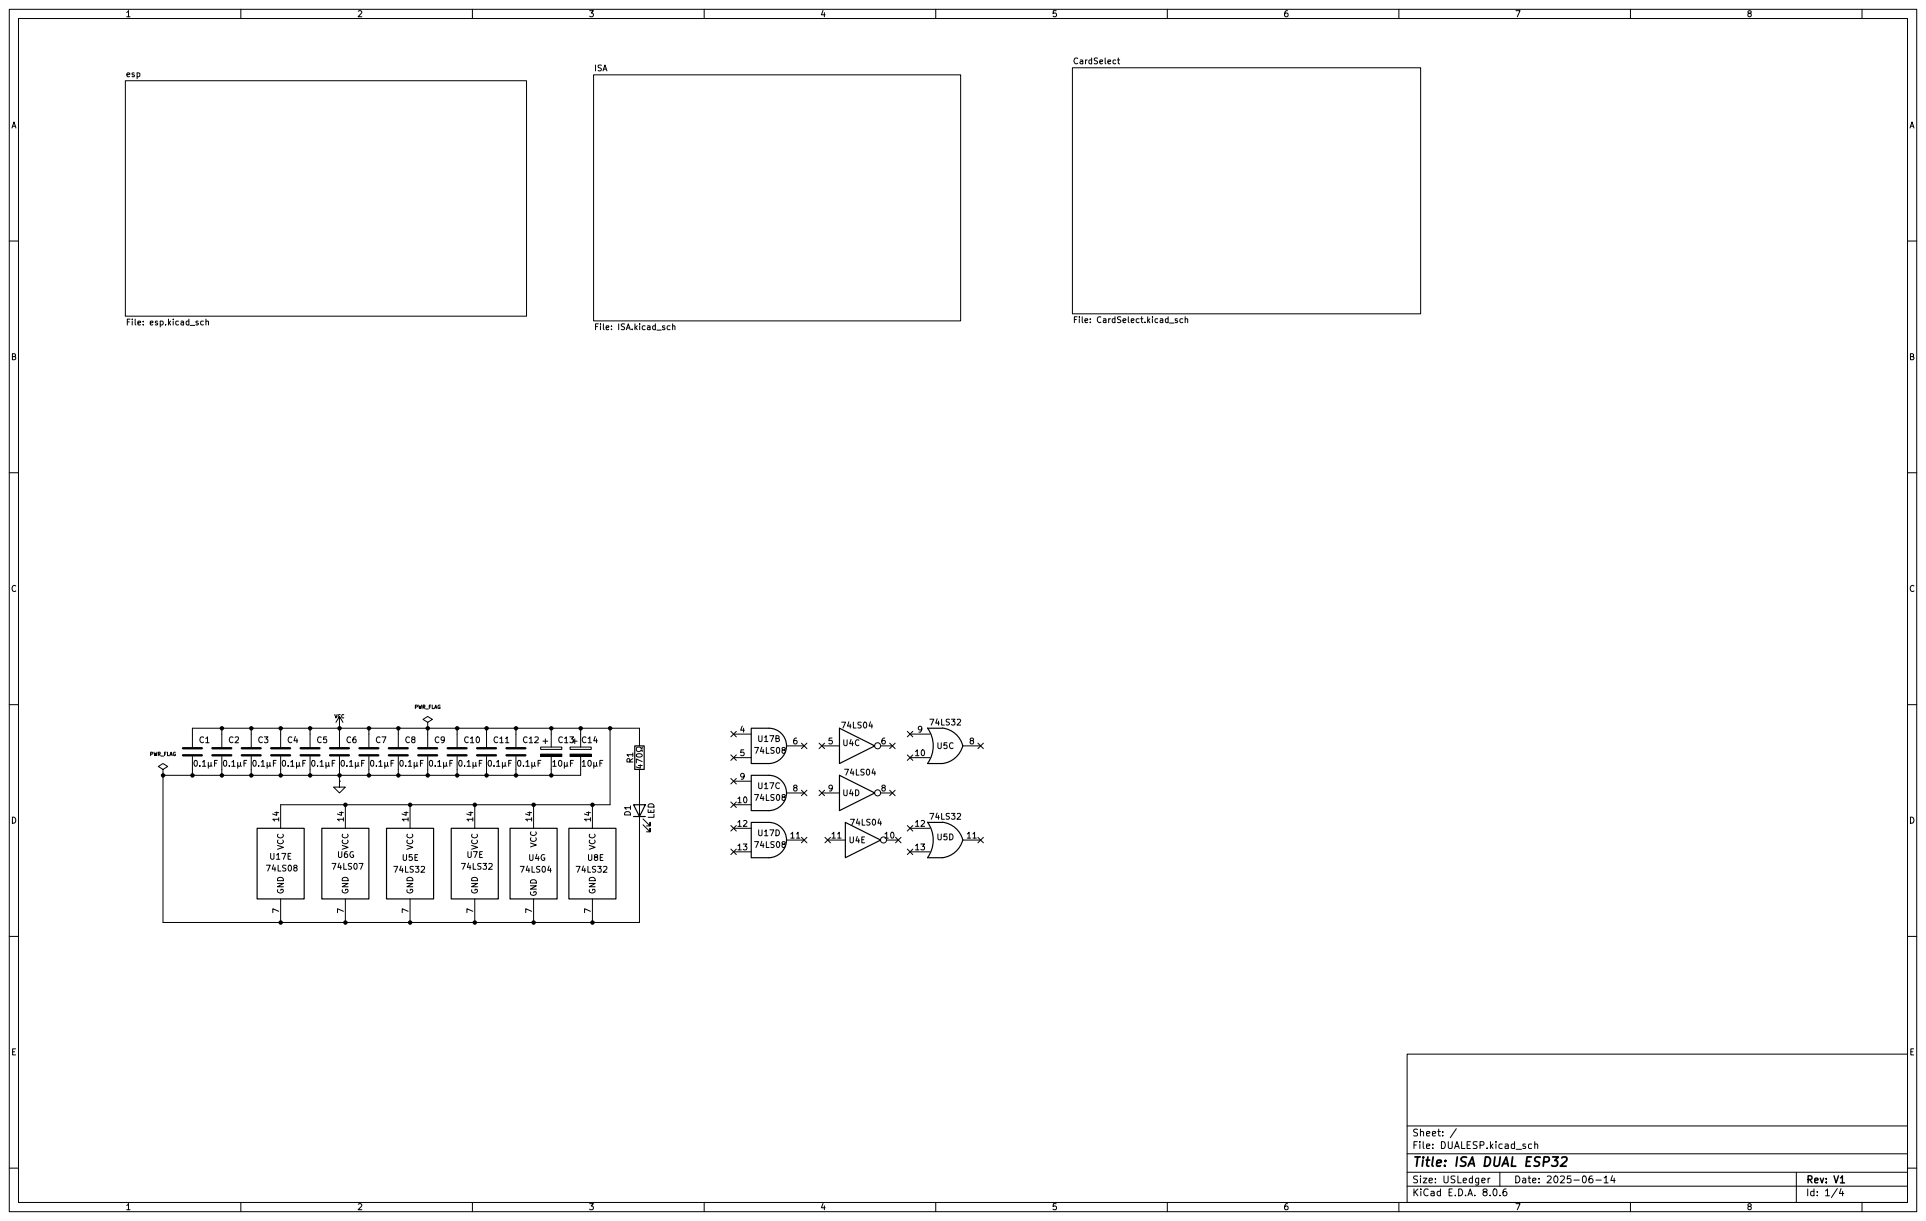
[picture p138: page 1]

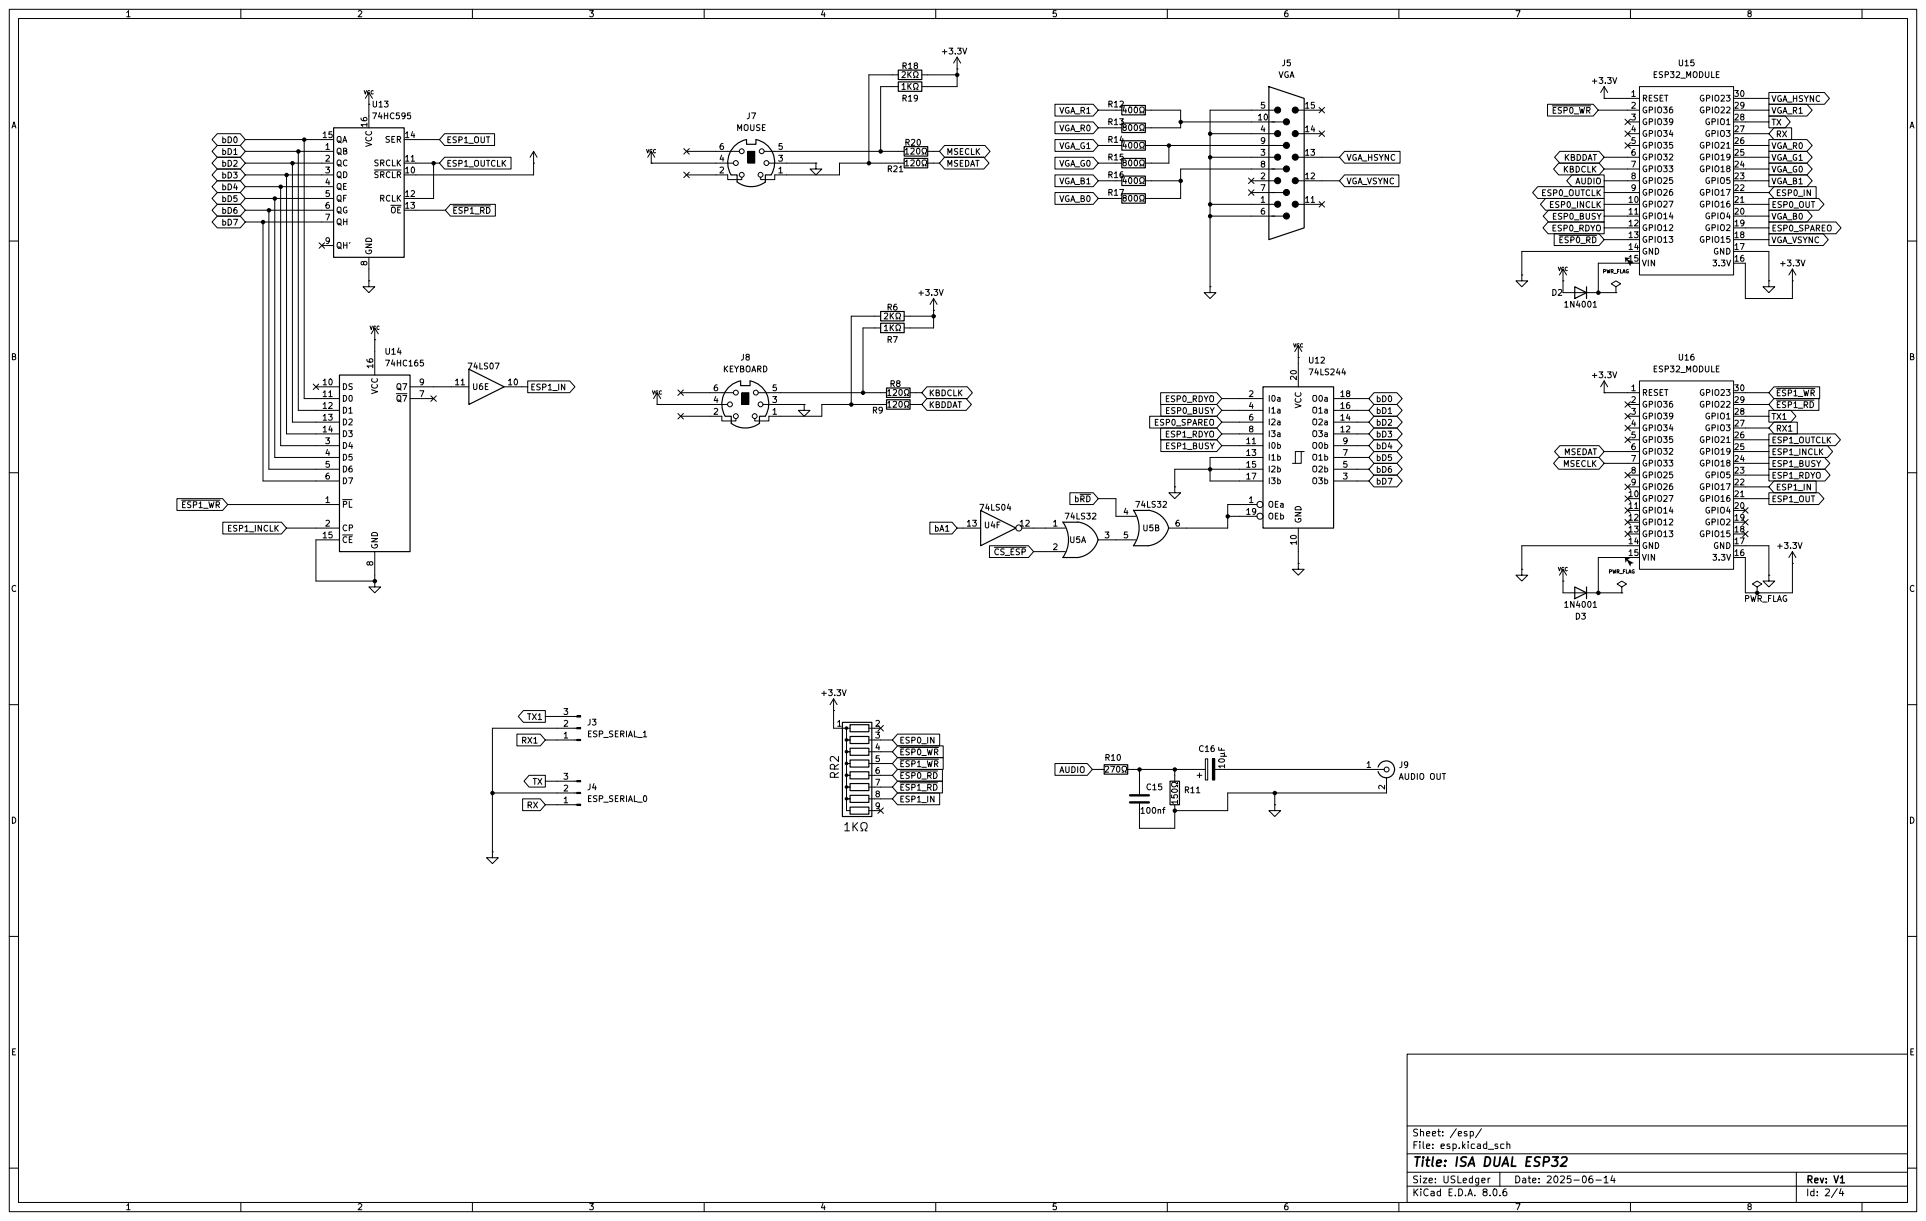
[picture p139: page 2]


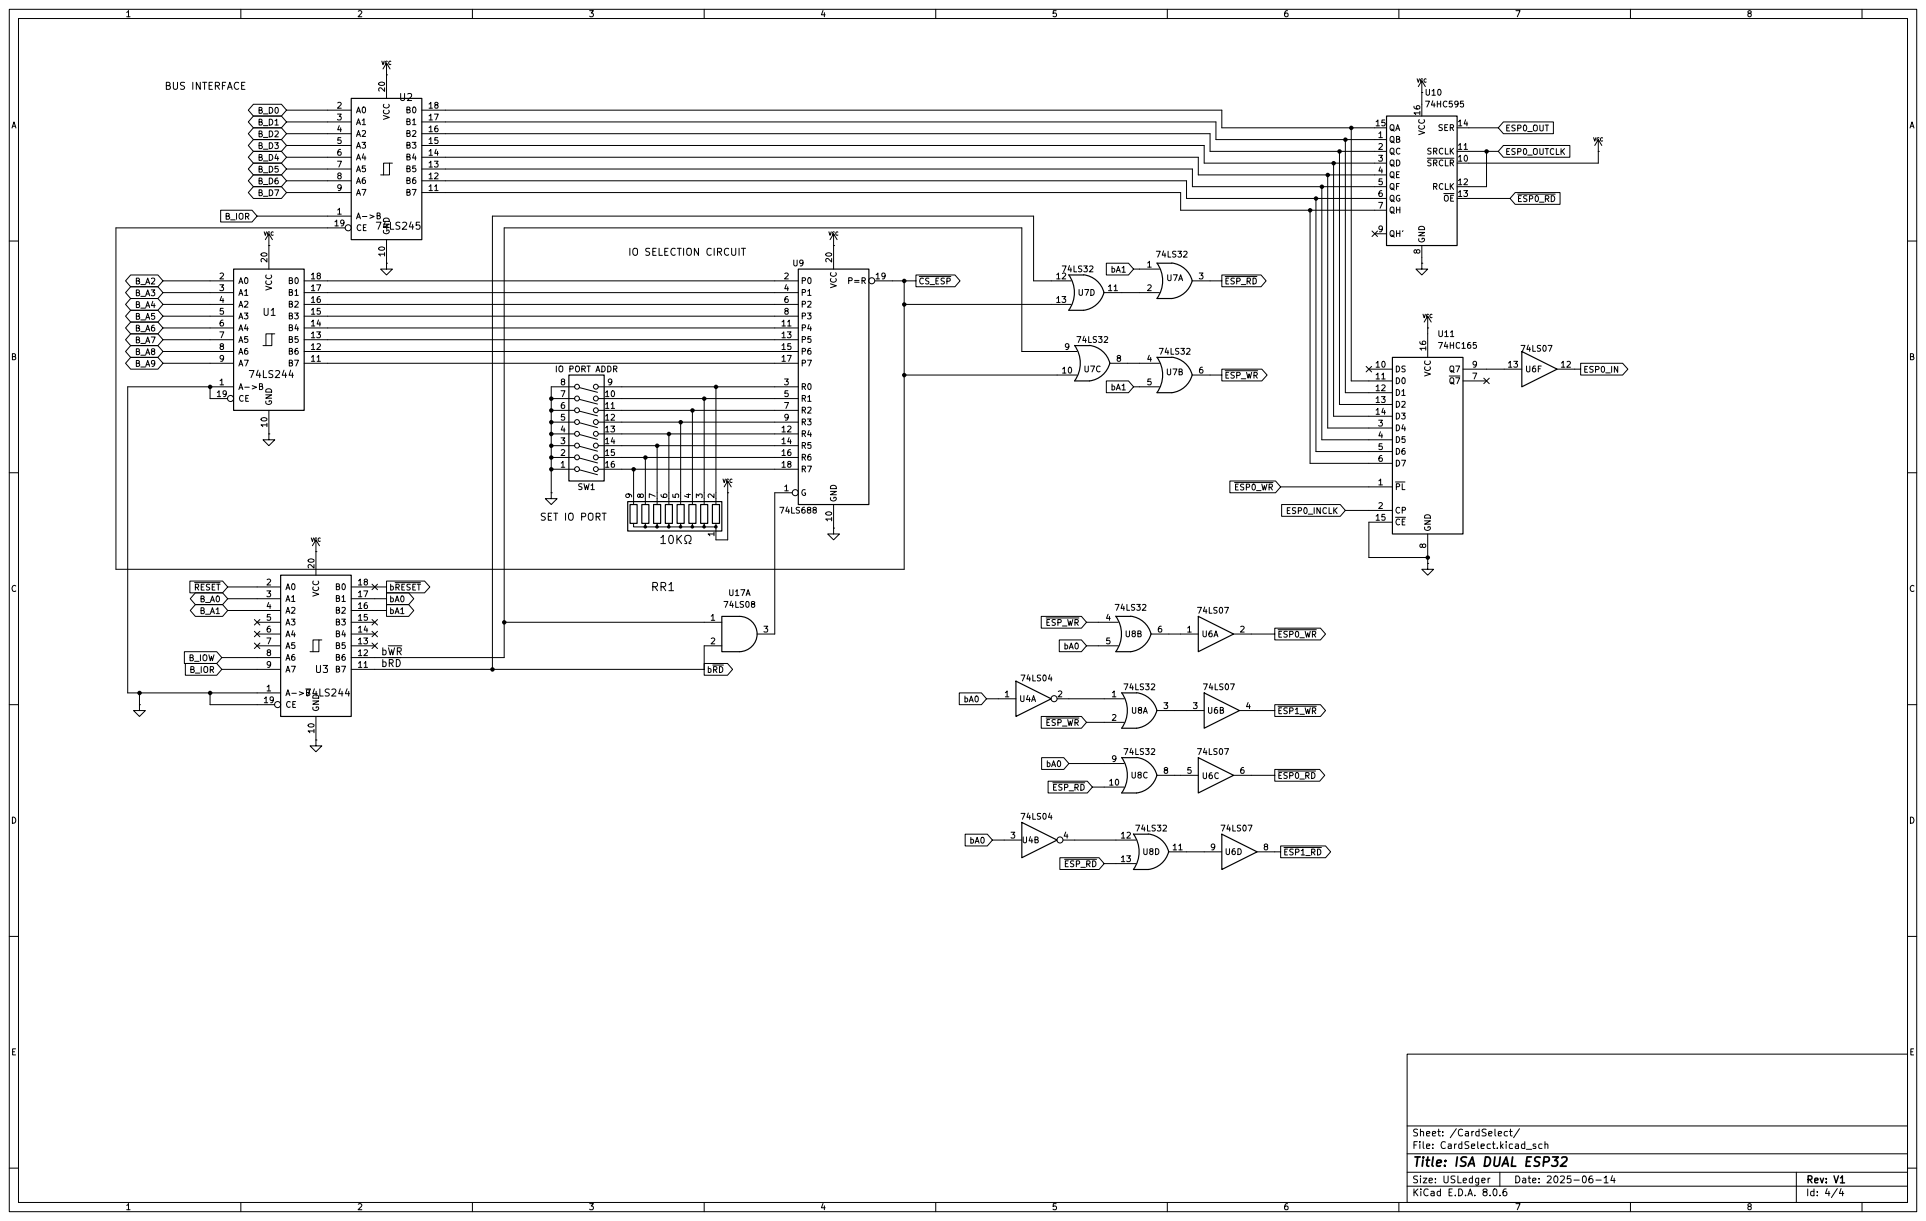
[picture p140: page 4]
