danwerner21/ISA_IO/MULTIIO/MULTIIO/SCHEMATIC-v0.5.pdf

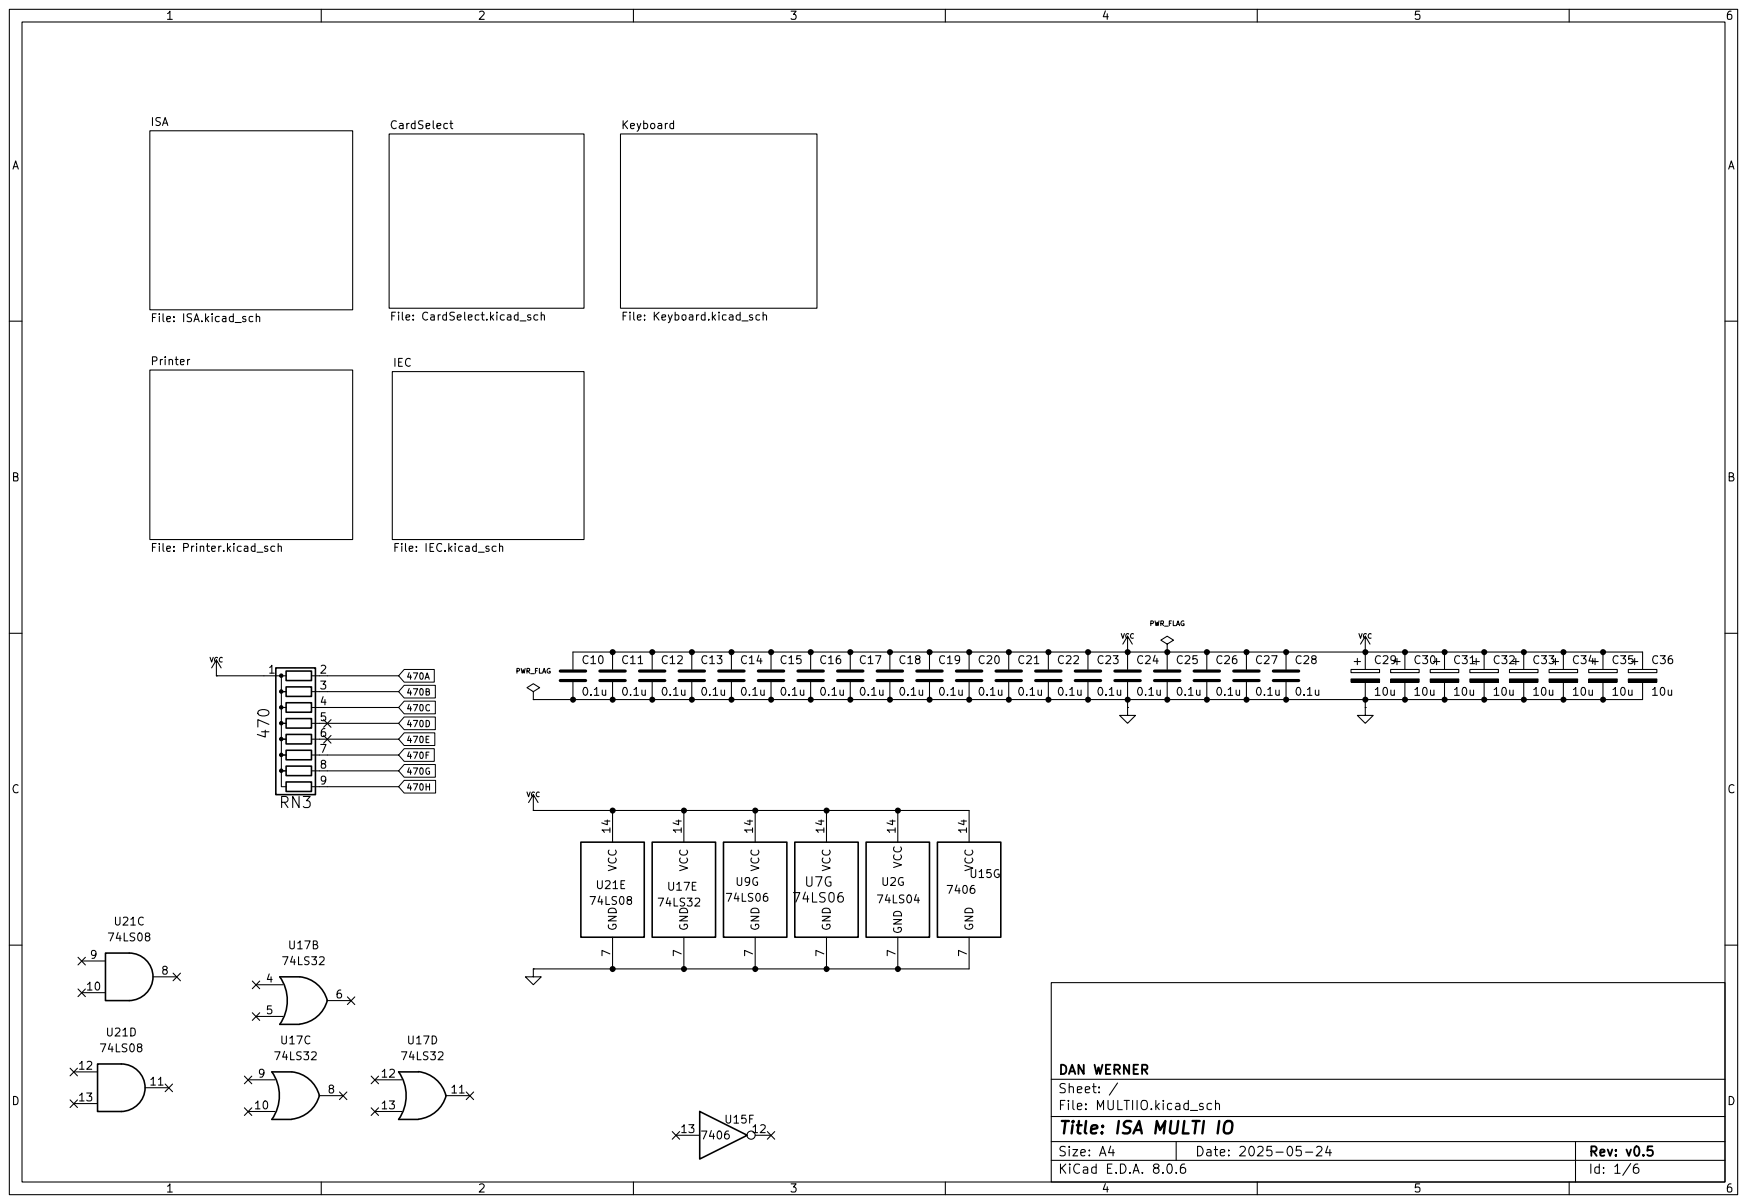
[picture p141: page 1]

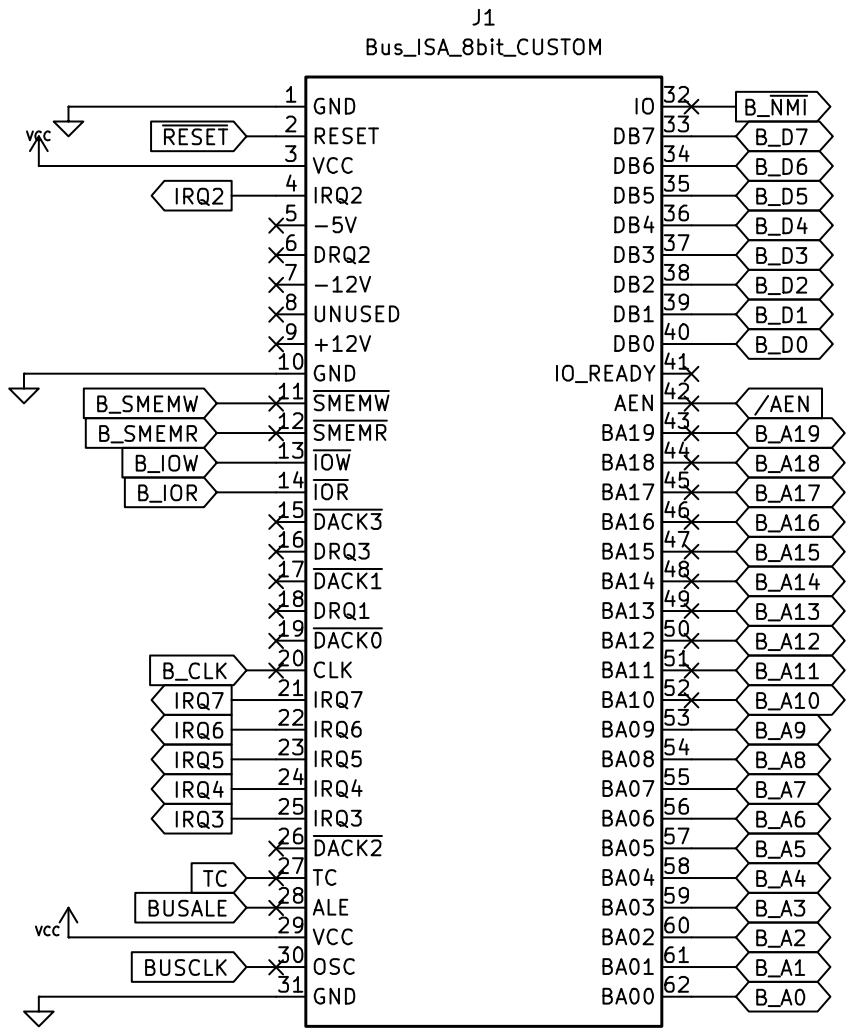
[picture p142: page 2]

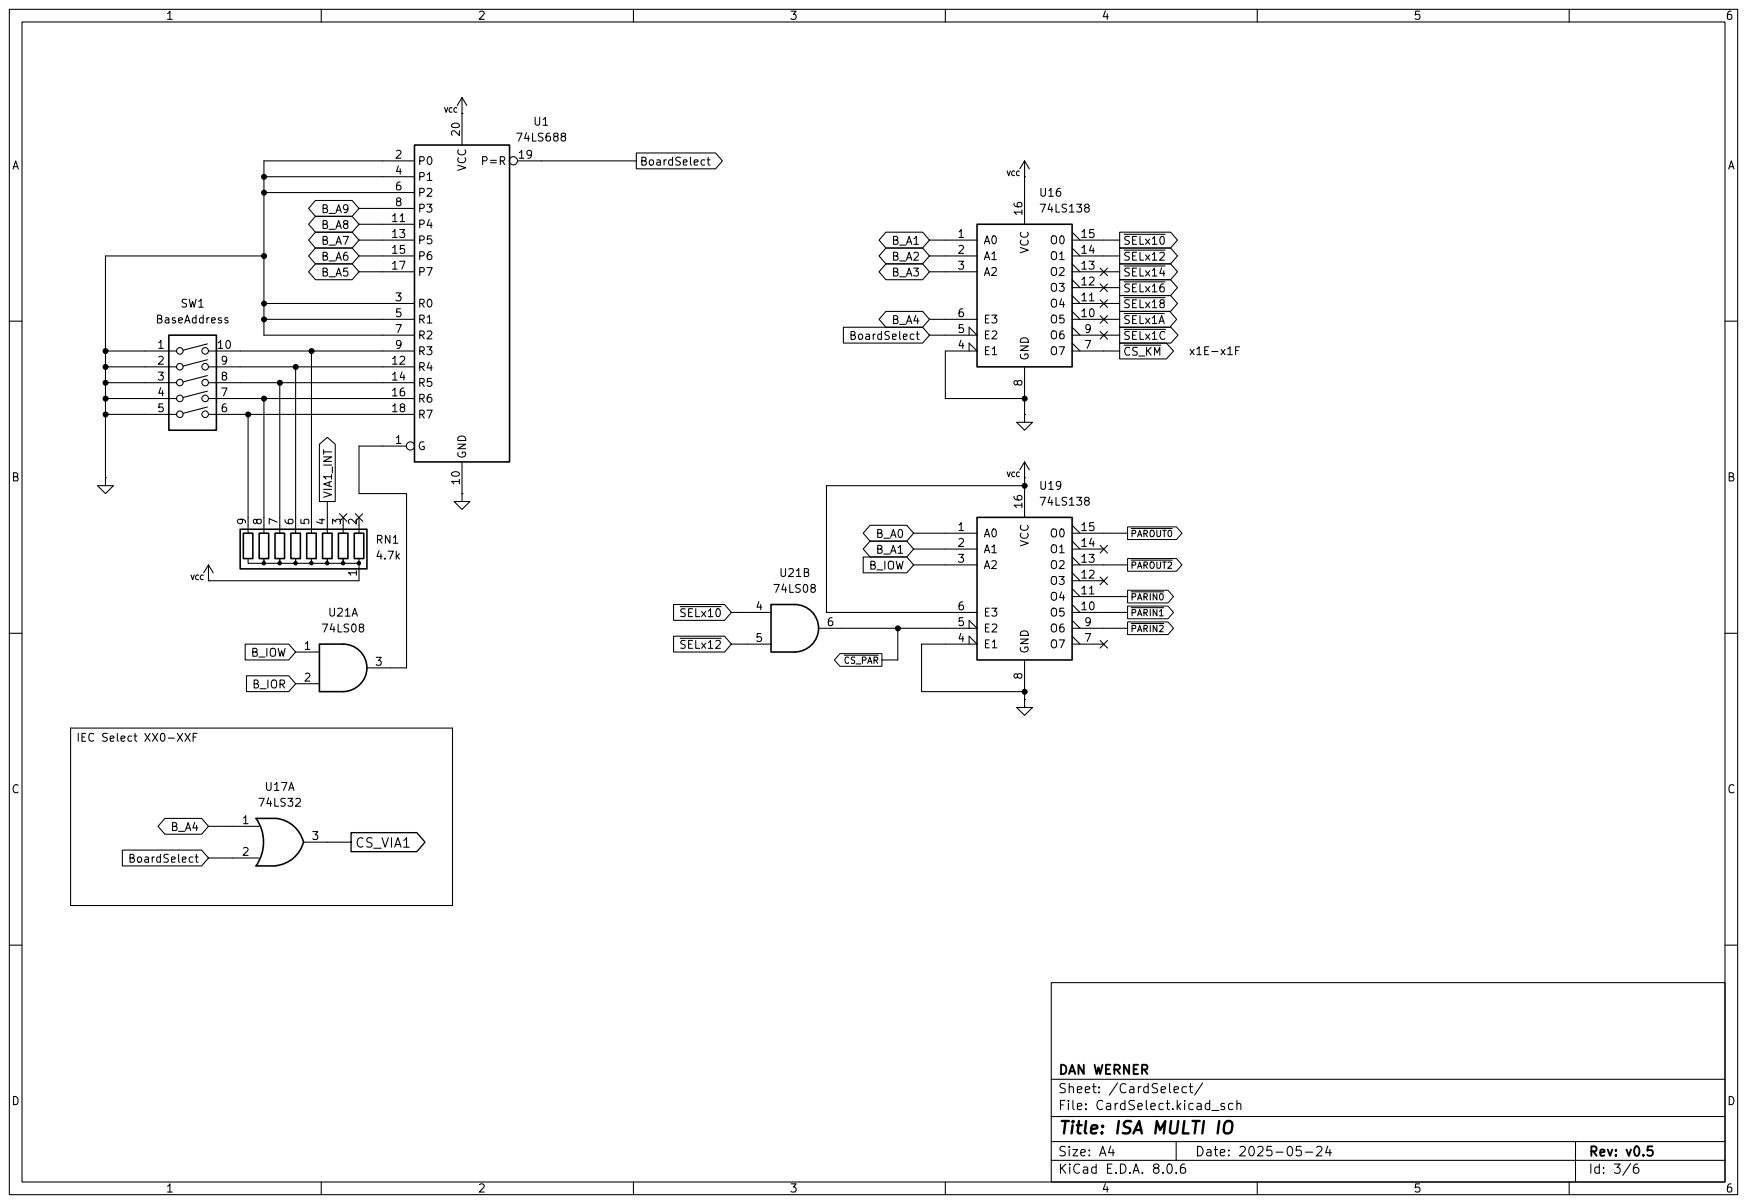
[picture p143: page 3]

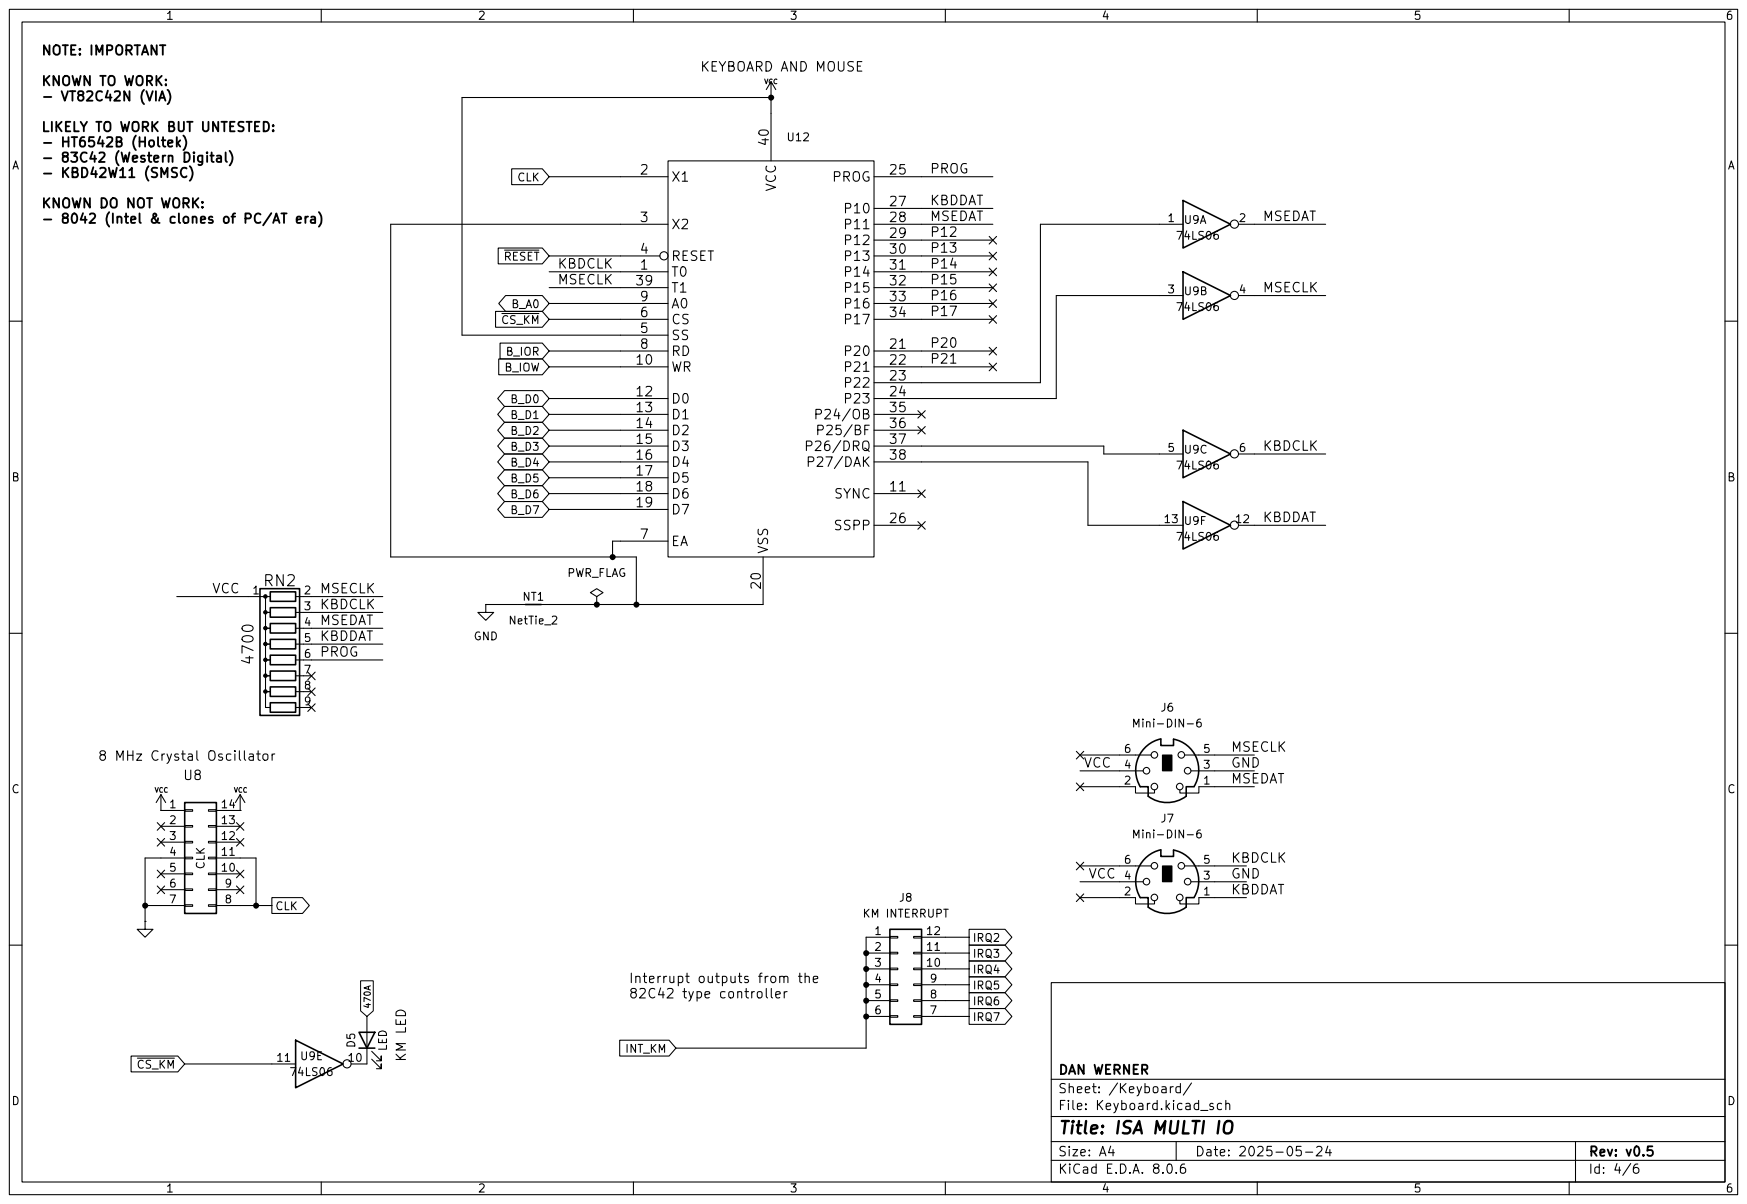
[picture p144: page 4]

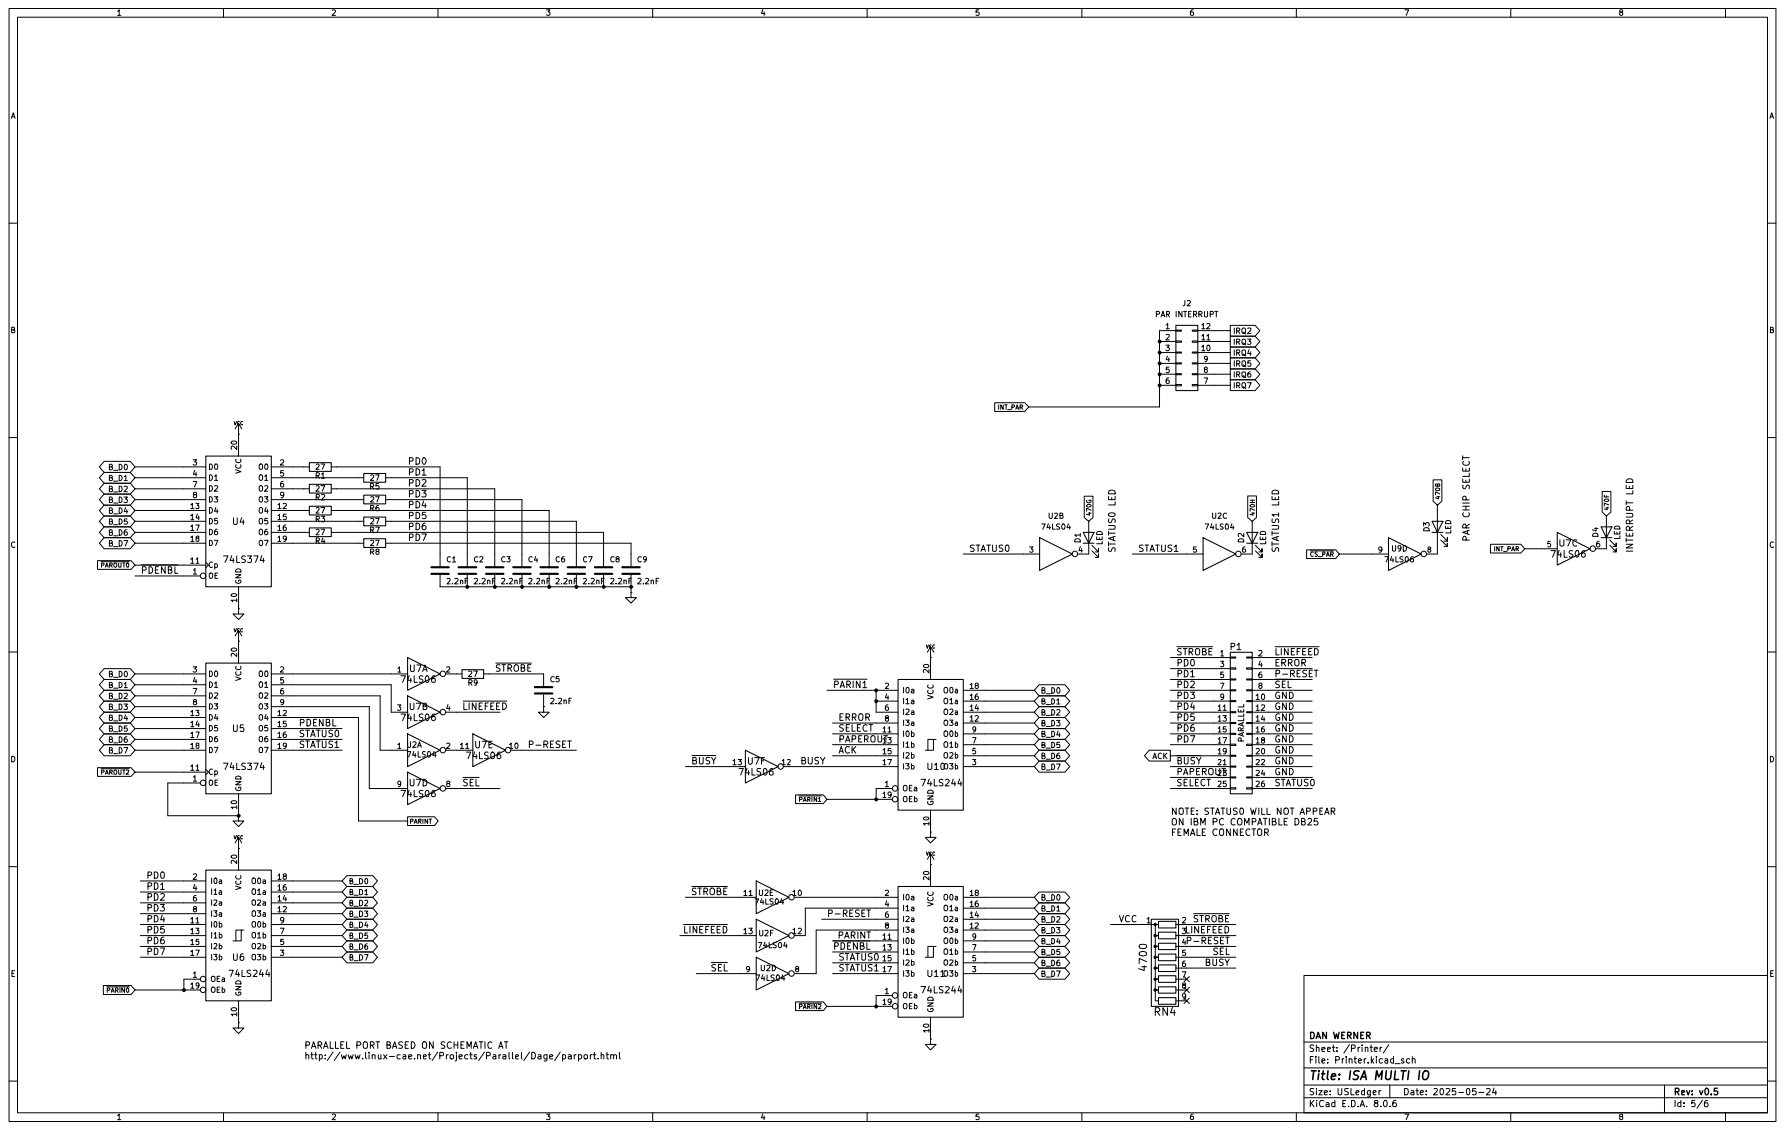
[picture p145: page 5]

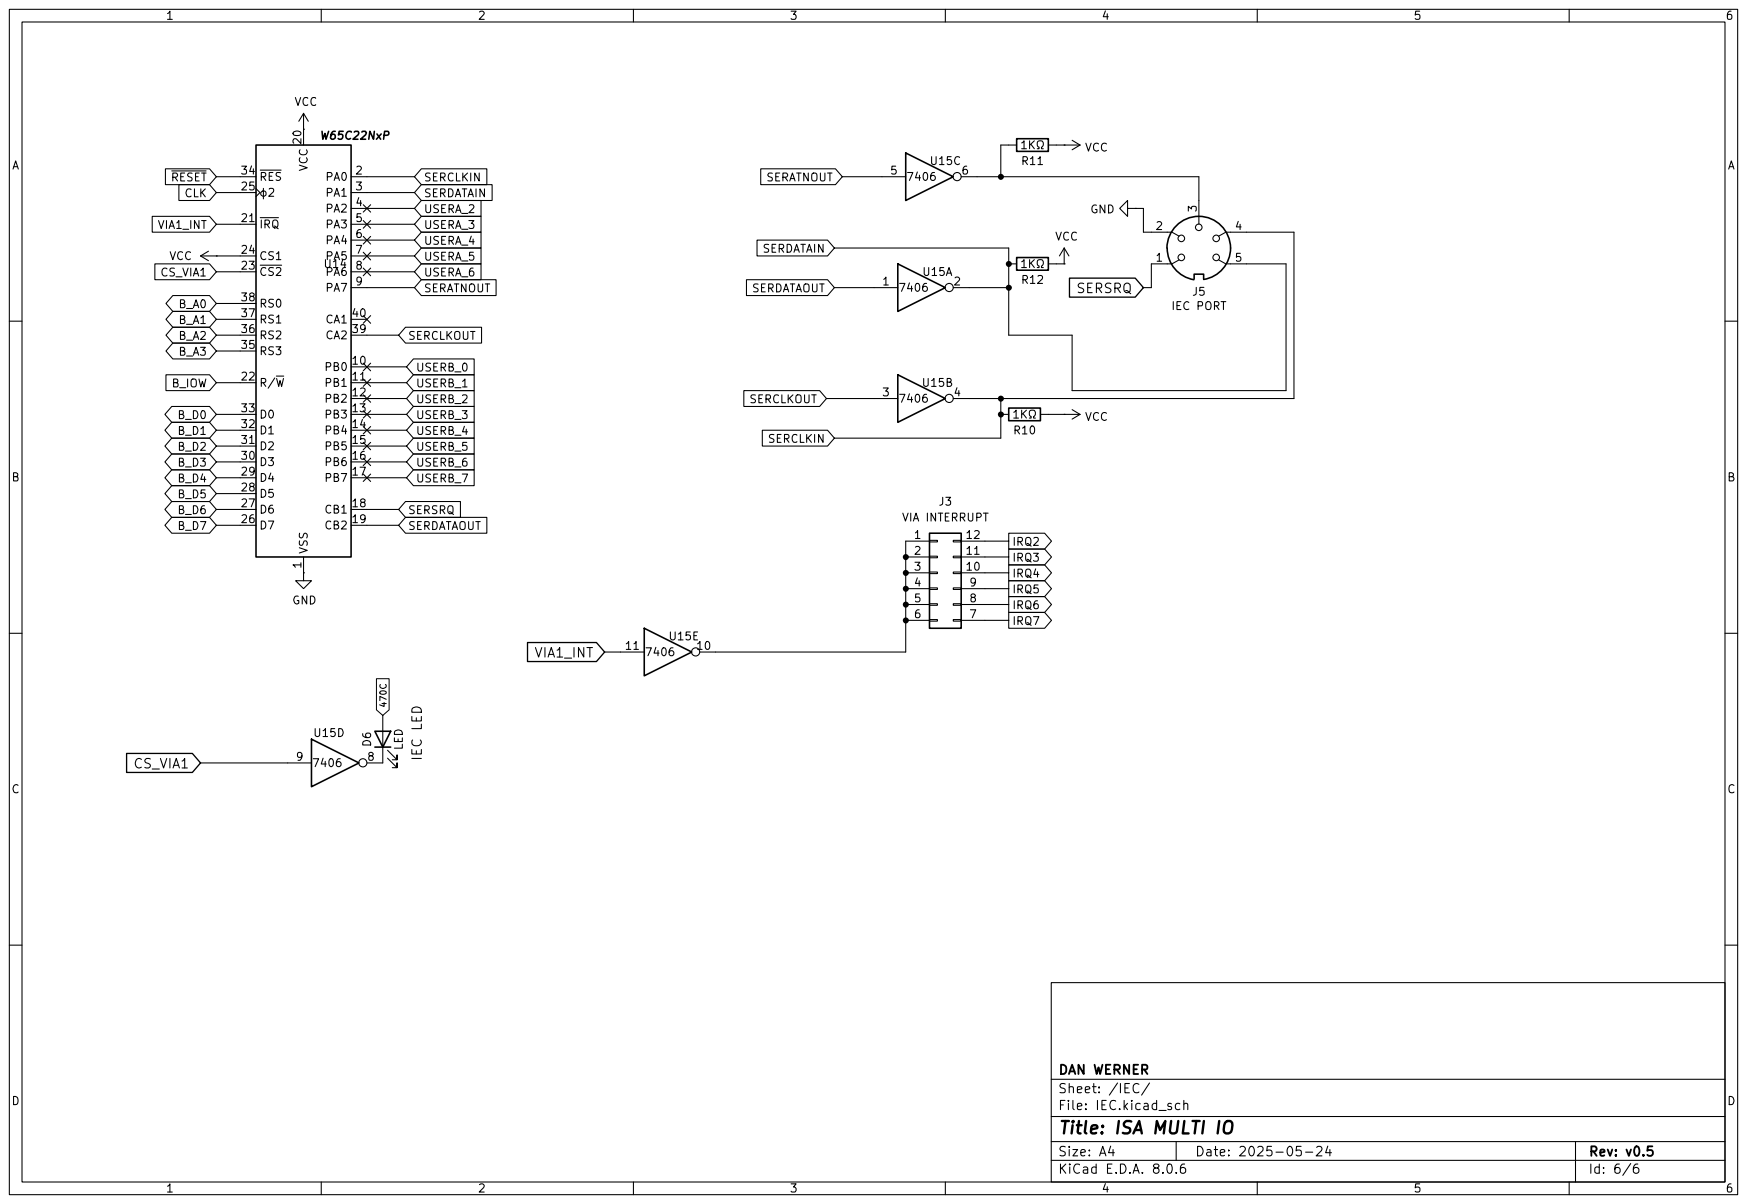
[picture p146: page 6]
