danwerner21/ISA_IO/DUALESP/DUALESP_PCB_V1.1.pdf

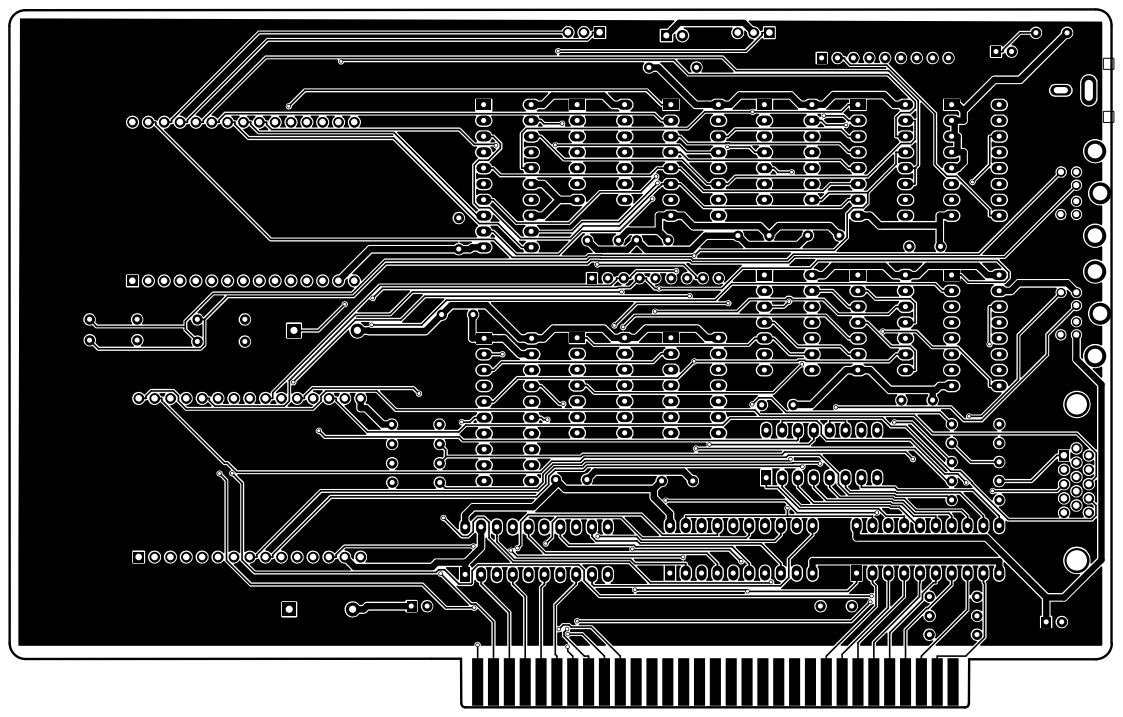
[picture p147: page 1]

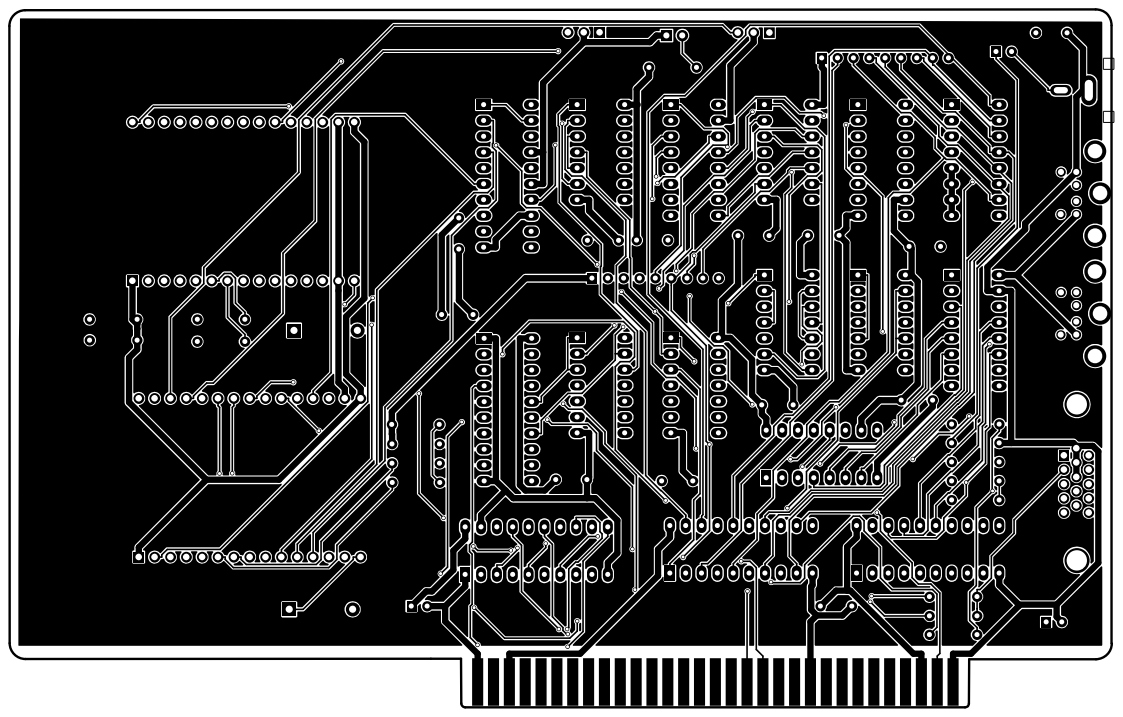
[picture p148: page 2]

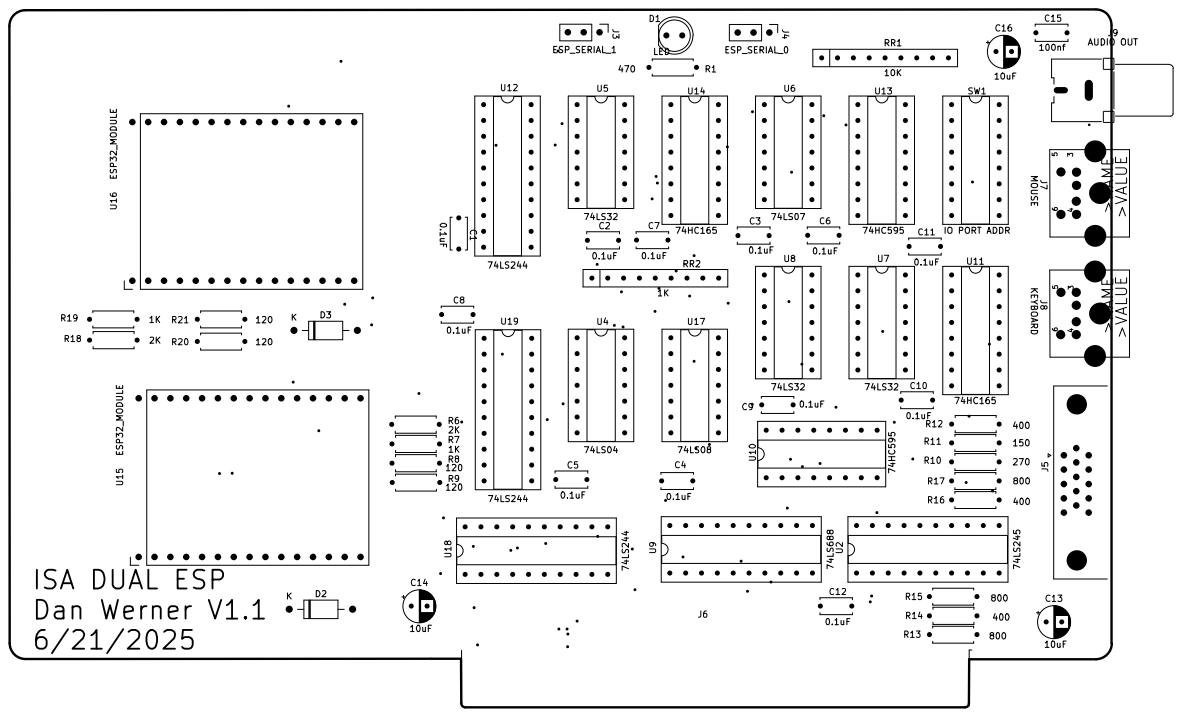
[picture p149: page 3]

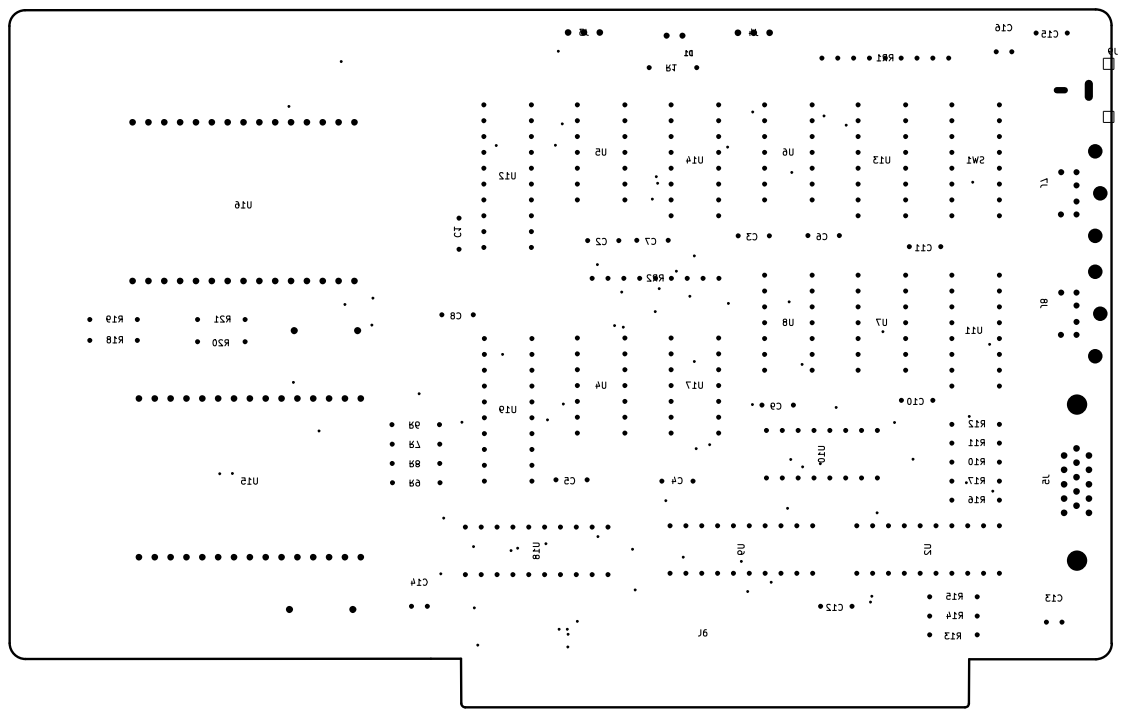
[picture p150: page 4]

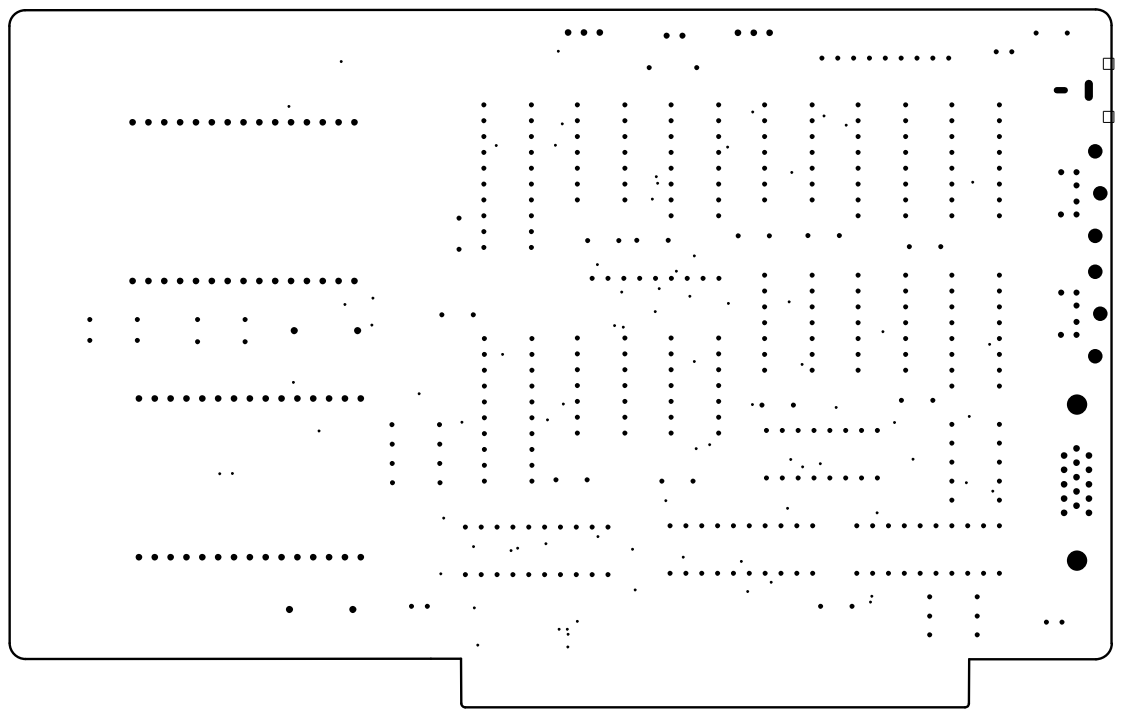
[picture p151: page 5]
