danwerner21/ISA_IO/DUALESP/DUALESP_PCB_V1.pdf

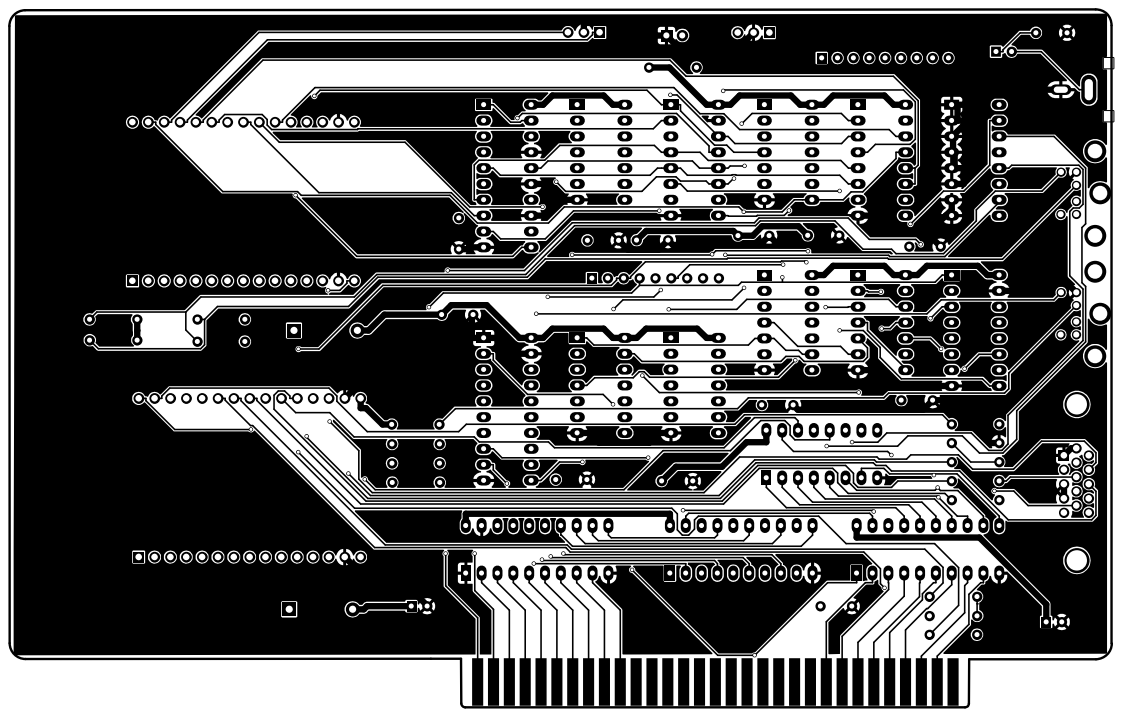
[picture p152: page 1]

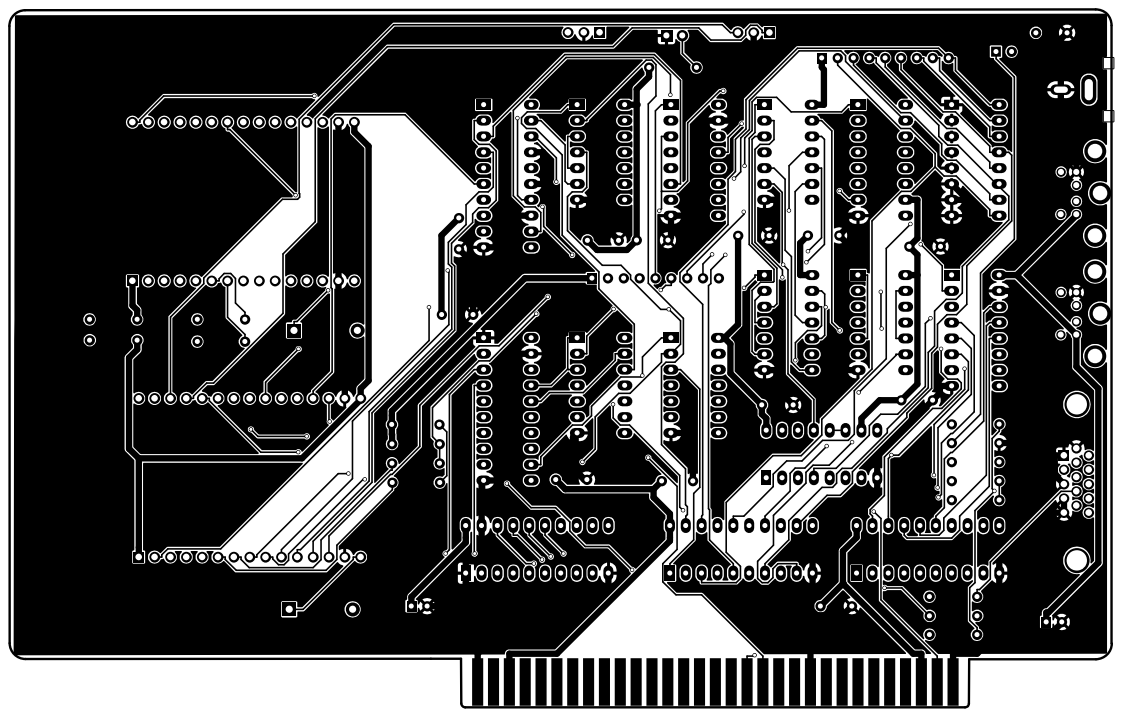
[picture p153: page 2]

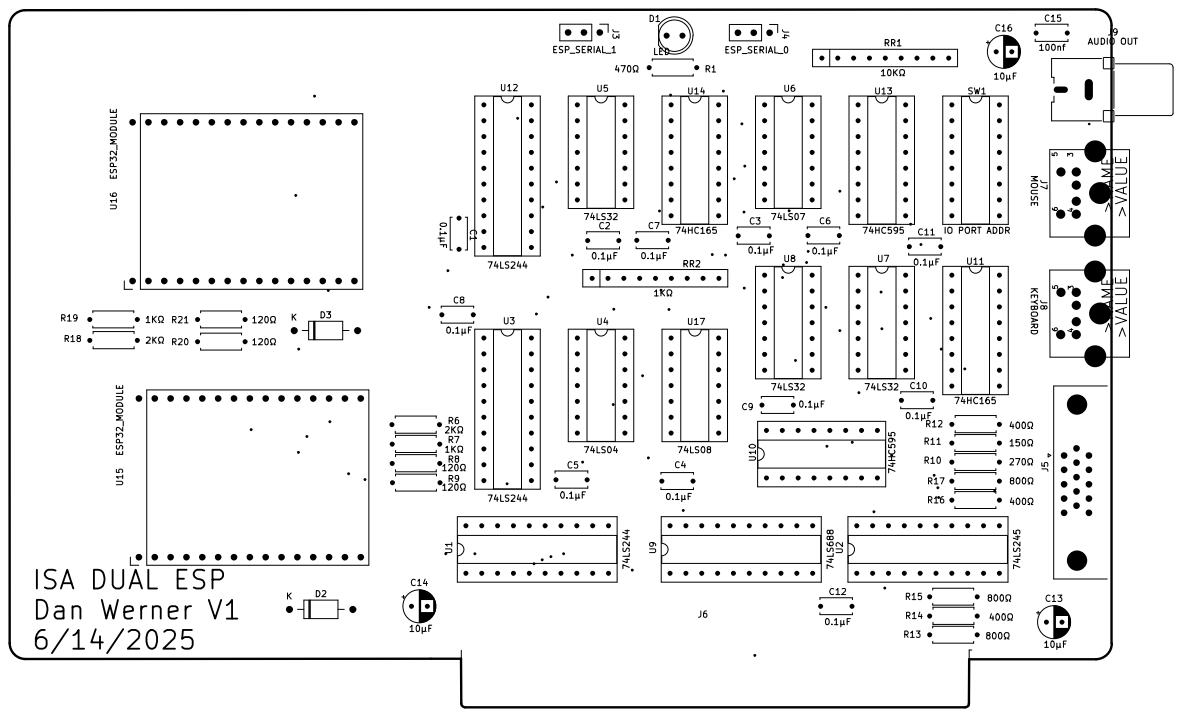
[picture p154: page 3]

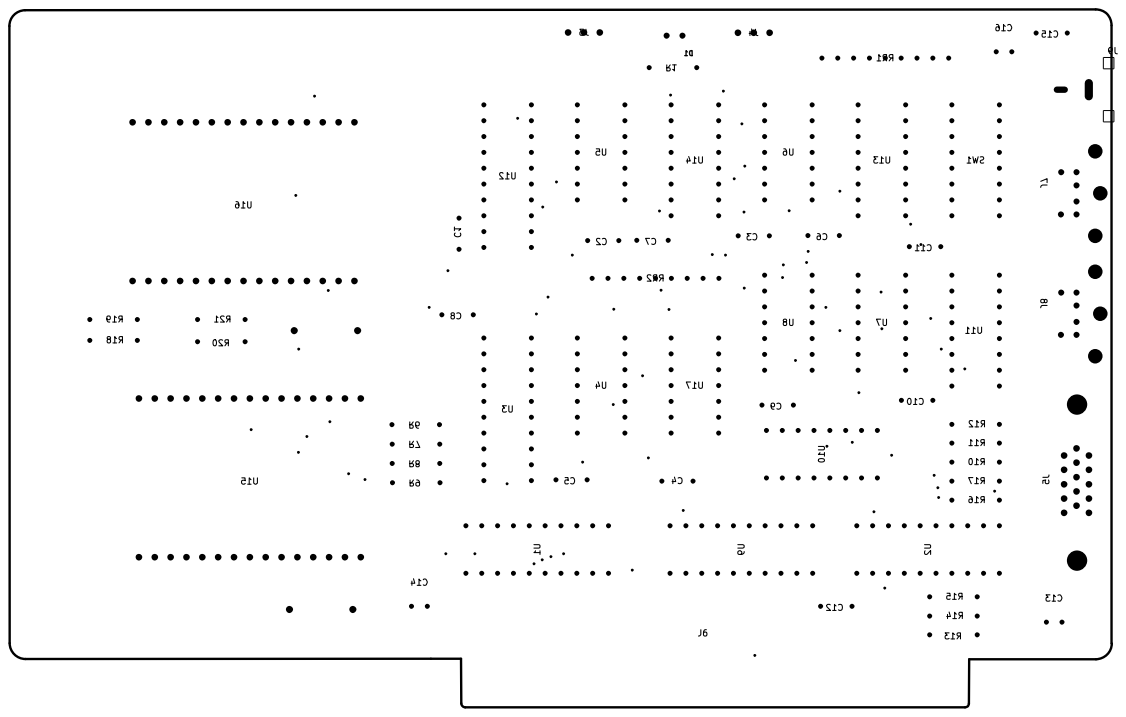
[picture p155: page 4]

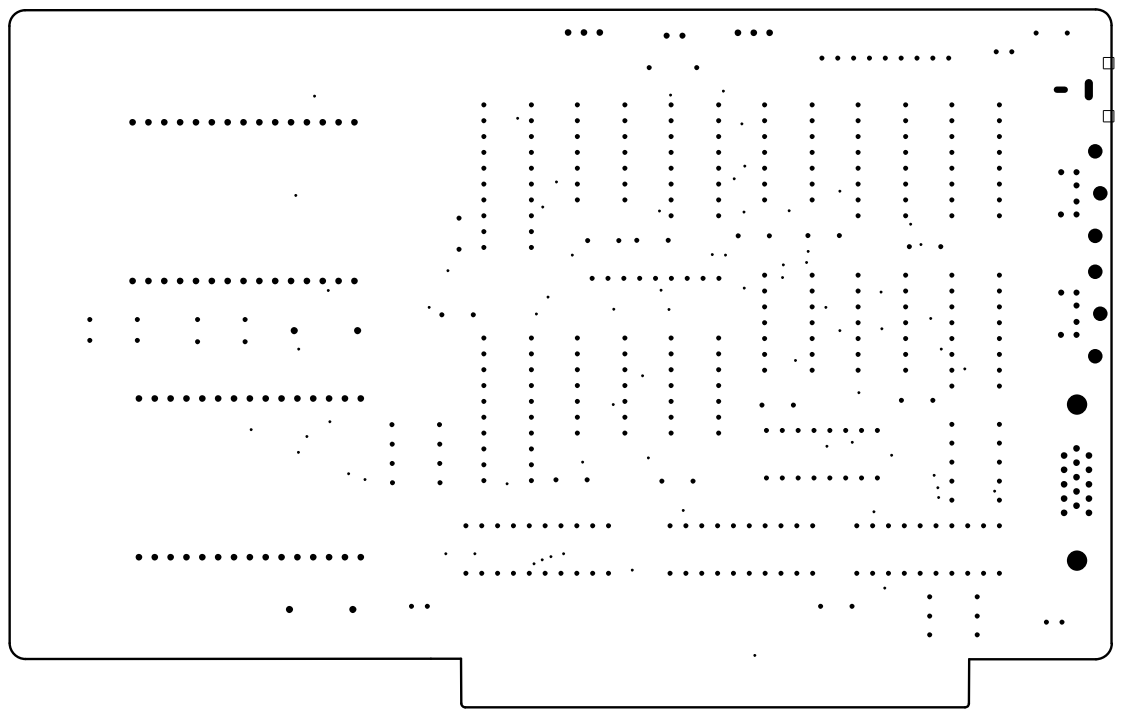
[picture p156: page 5]
