danwerner21/ISA_IO/MULTIIO/MULTIIO/PCB-v0.5.pdf

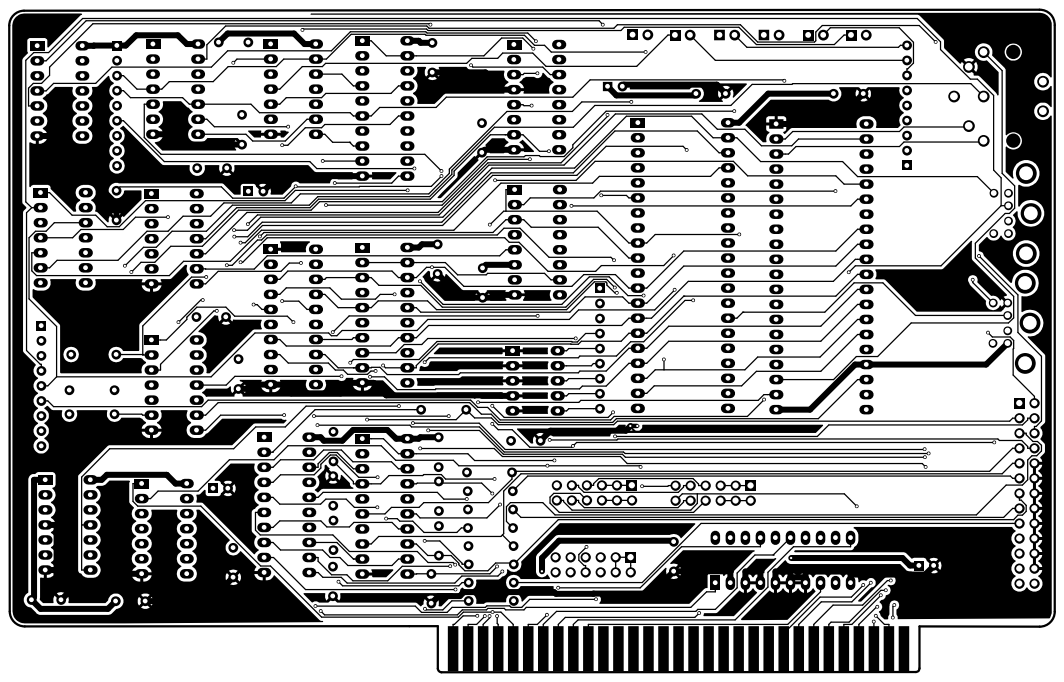
[picture p157: page 1]

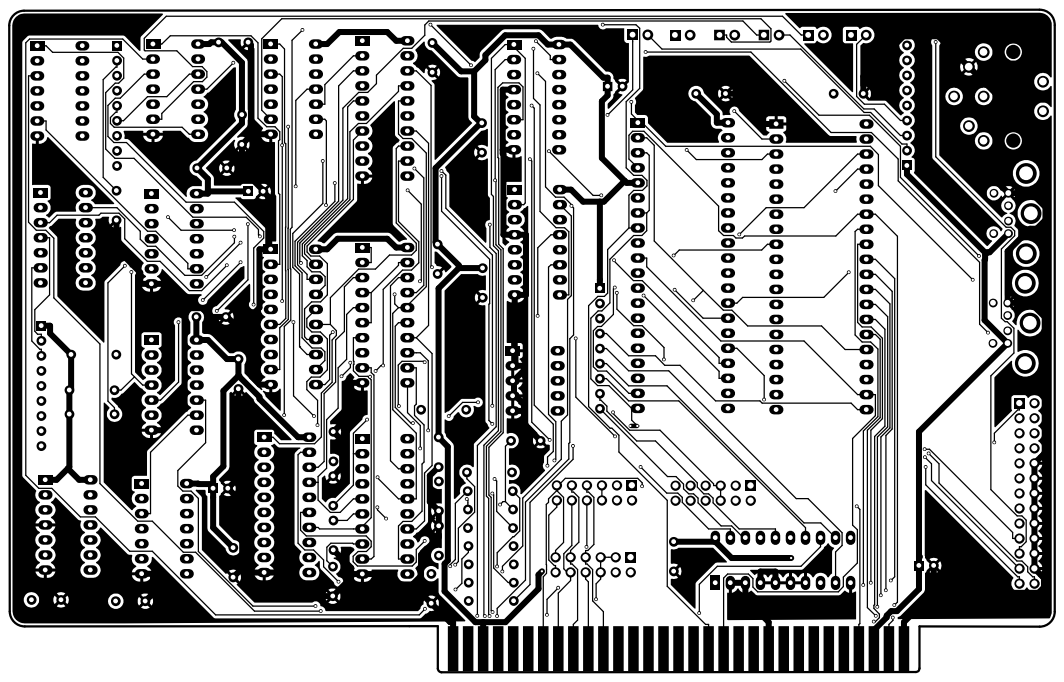
[picture p158: page 2]

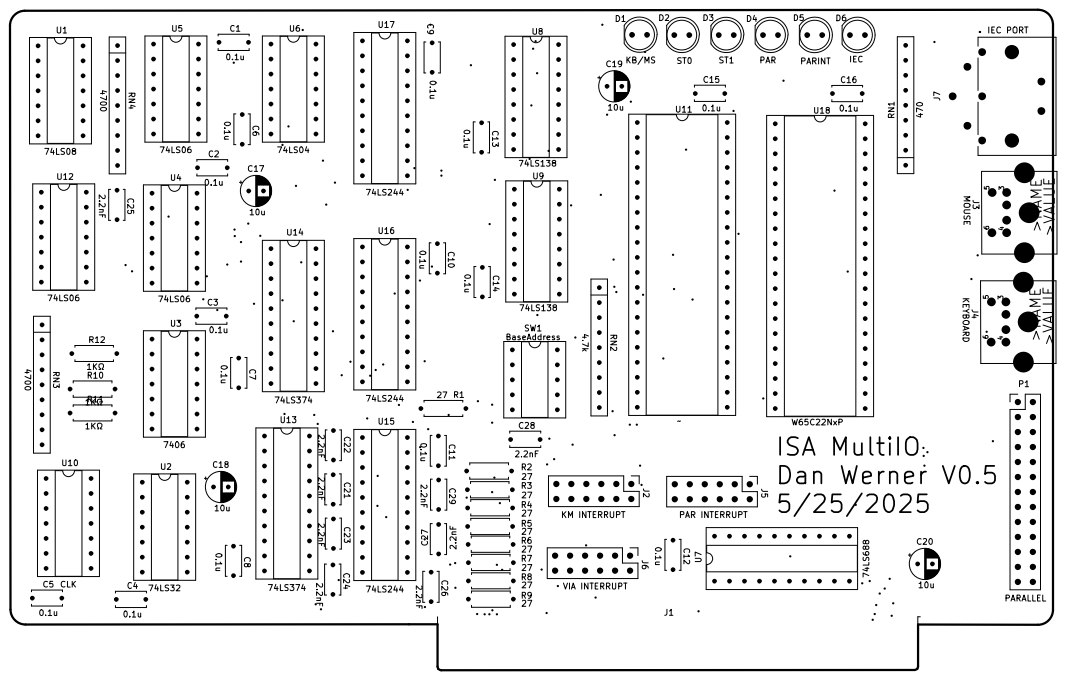
[picture p159: page 3]

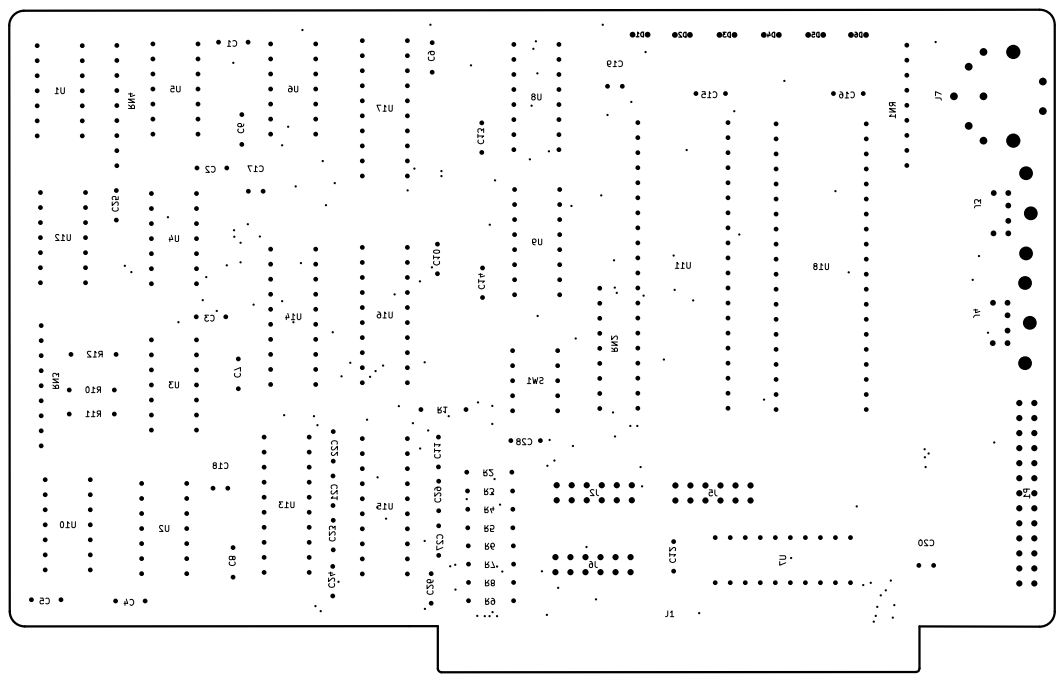
[picture p160: page 4]

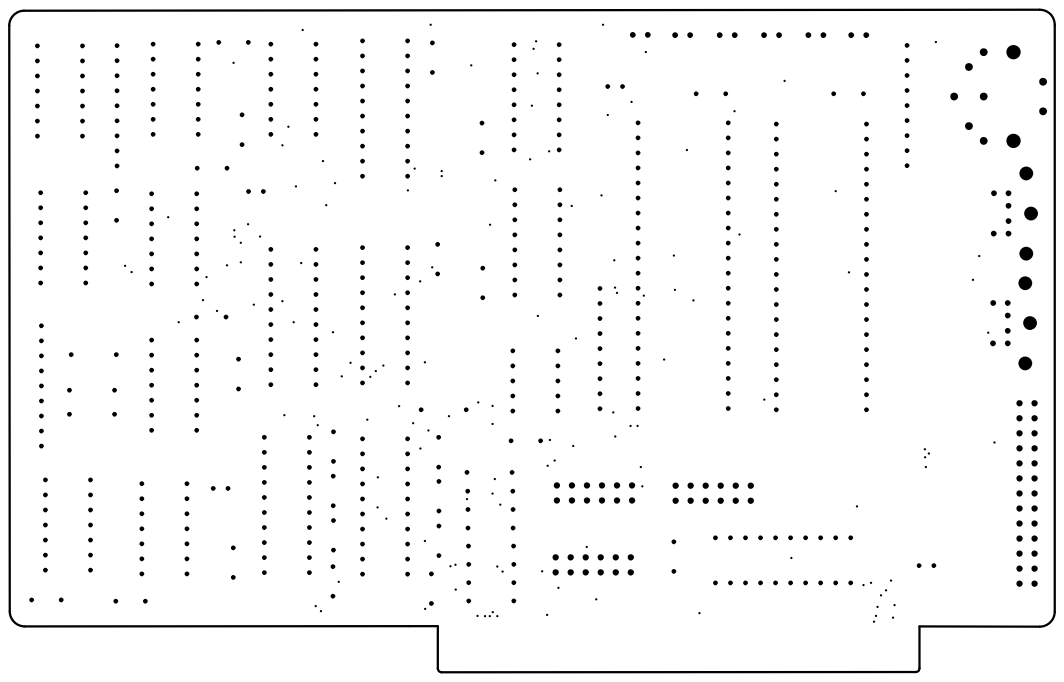
[picture p161: page 5]
