danwerner21/ISA_IO/MULTIIO/MULTIIO/PCB-v1.pdf

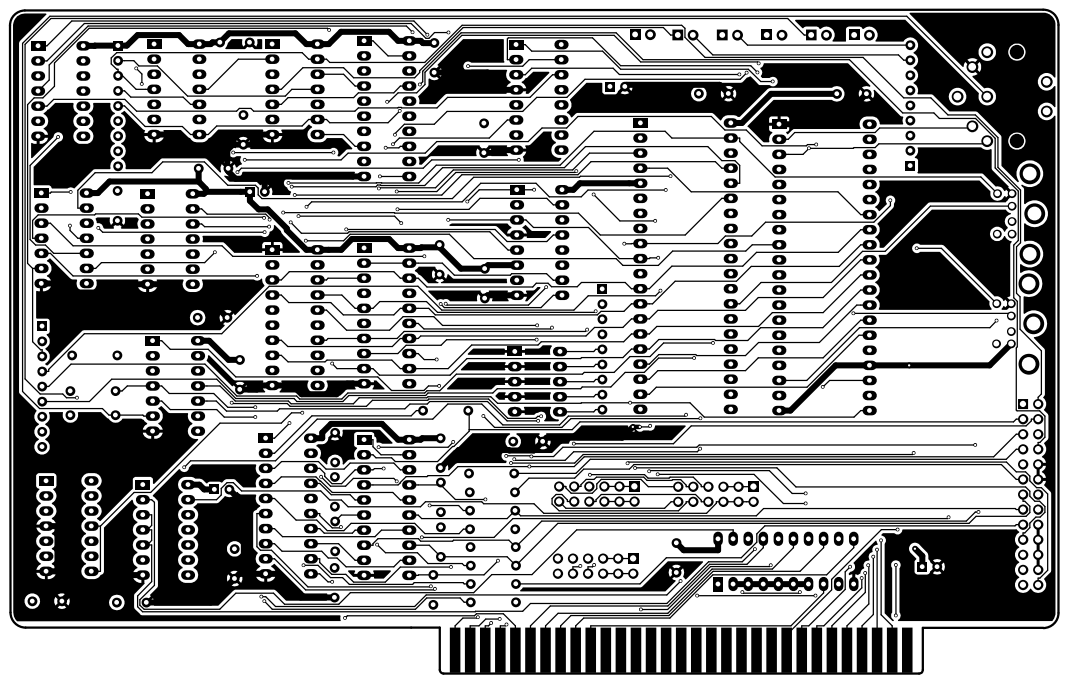
[picture p162: page 1]

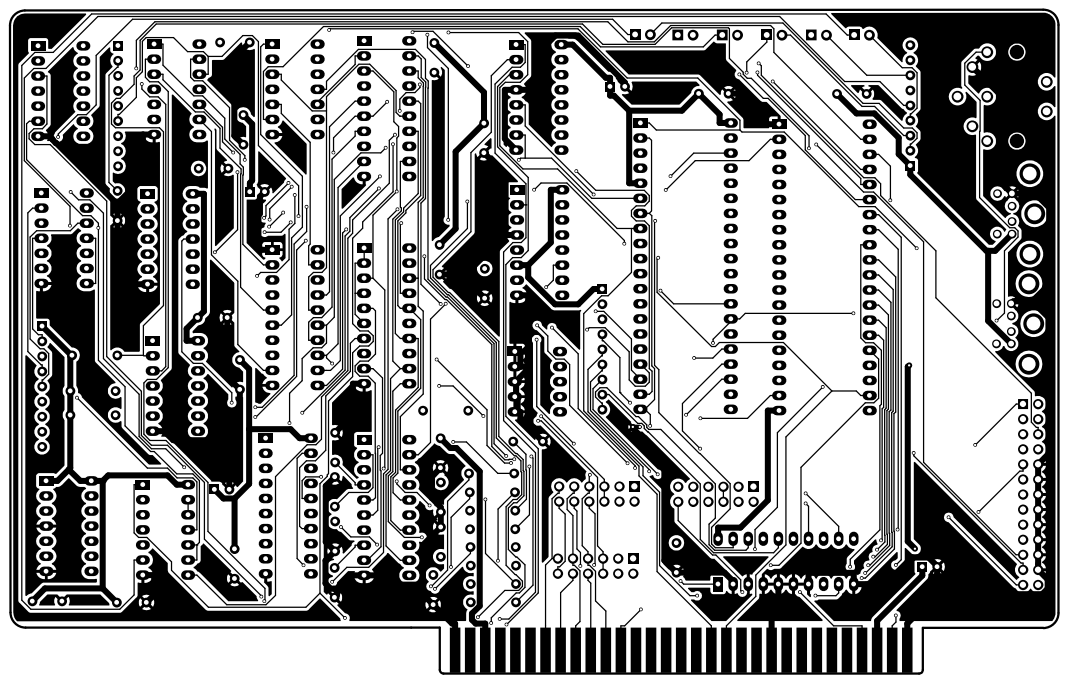
[picture p163: page 2]

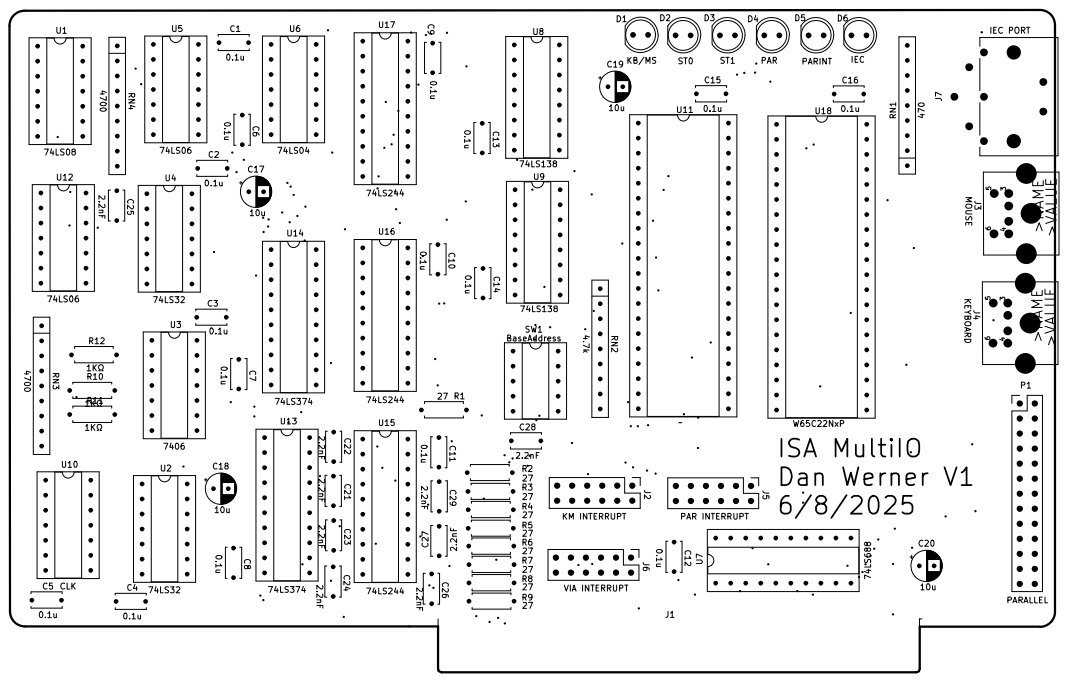
[picture p164: page 3]

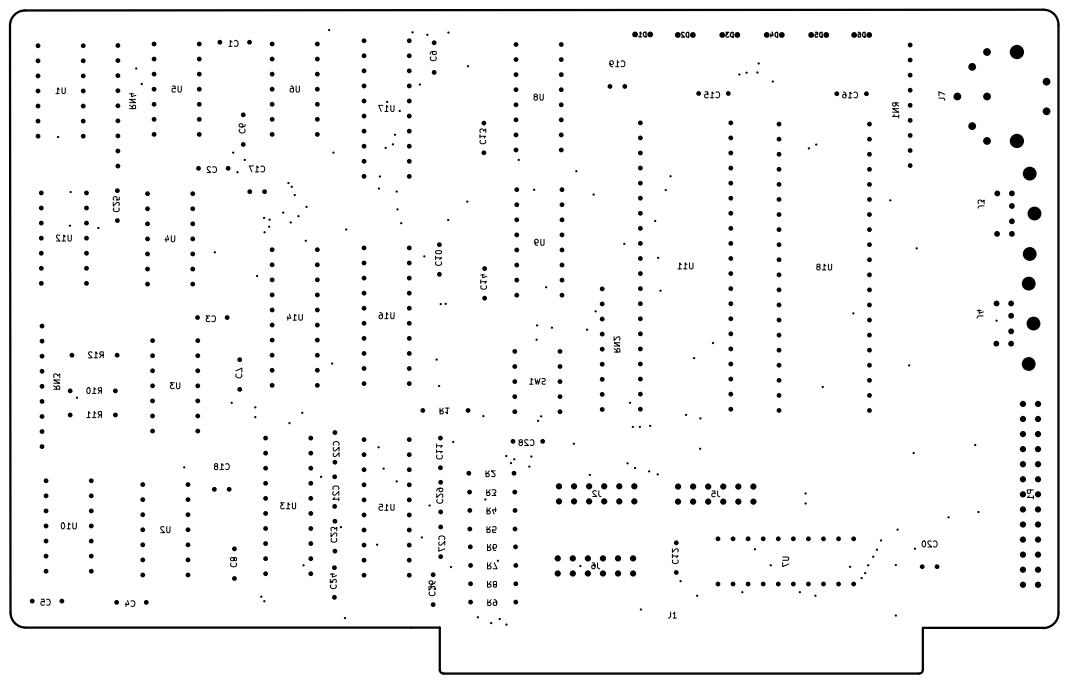
[picture p165: page 4]

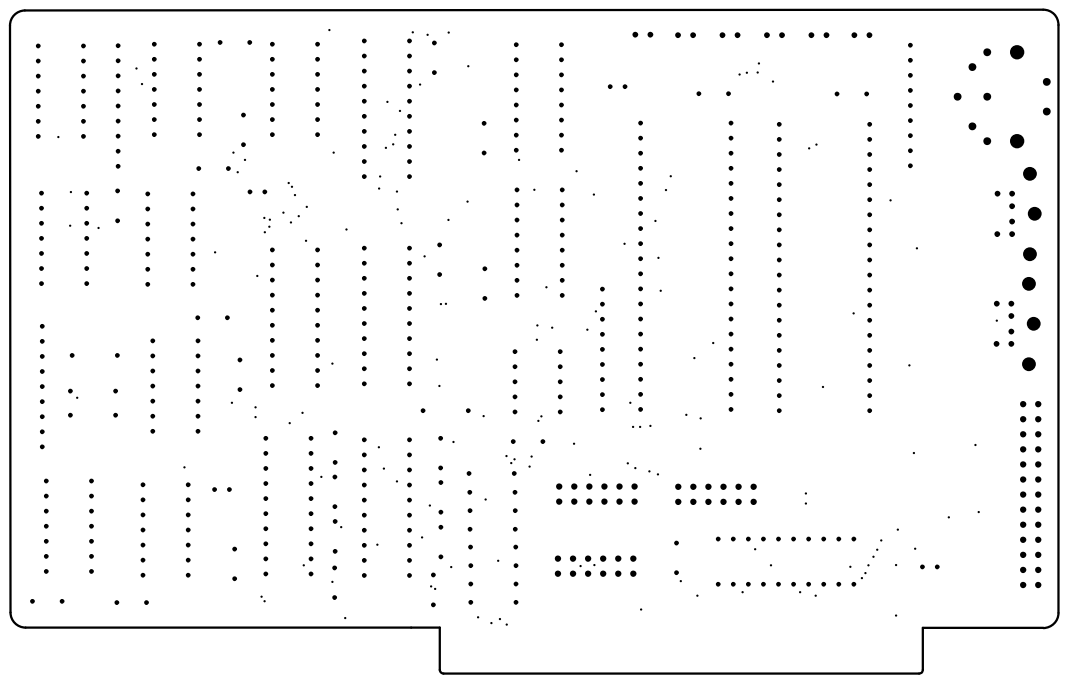
[picture p166: page 5]
