danwerner21/ISA_IO/(list of files, drawings)

Other design files:
MULTIIO/MULTIIO/MULTIIO.dsn
SOUND/SOUND.dsn
VIDEO/HARDWARE/video.dsn
