danwerner21/ISA_IO/SOUND/SOUND.kicad_pcb

## KiCad design SOUND/SOUND.kicad_pcb (2026-06-07)

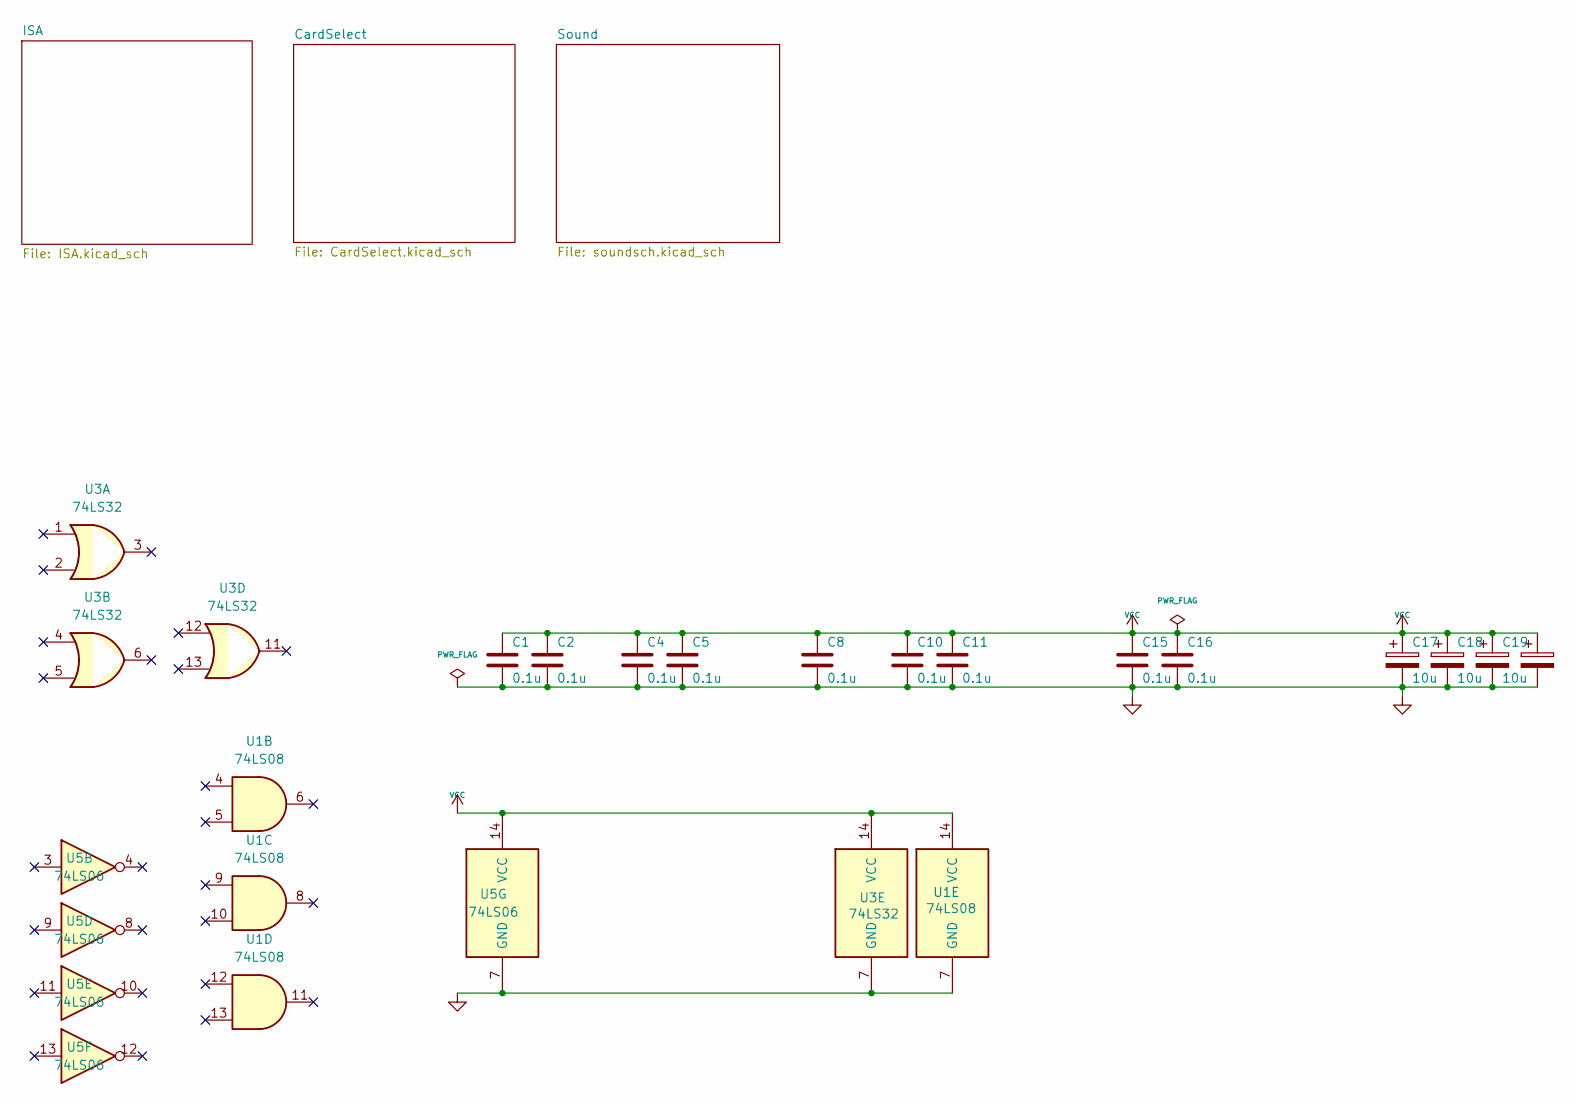
[picture p167: schematic SOUND.kicad_sch, ISA SOUND]

Parts:
C1, C2, C4, C5, C8, C10, C11, C15, C16: 0.1u; STD_DDW_CAP
C17, C18, C19, C20: 10u; STD_DDW_PCAP
U1: 74LS08; STD_DDW_DIP14
U3: 74LS32; STD_DDW_DIP14
U5: 74LS06; STD_DDW_DIP14

Connections:
GND: C1.2, C2.2, C4.2, C5.2, C8.2, C10.2, C11.2, C15.2, C16.2, C17.2, C18.2, C19.2, C20.2, U1.7 (GND), U3.7 (GND), U5.7 (GND); also elsewhere on the board
VCC: C1.1, C2.1, C4.1, C5.1, C8.1, C10.1, C11.1, C15.1, C16.1, C17.1, C18.1, C19.1, C20.1, U1.14 (VCC), U3.14 (VCC), U5.14 (VCC); also elsewhere on the board

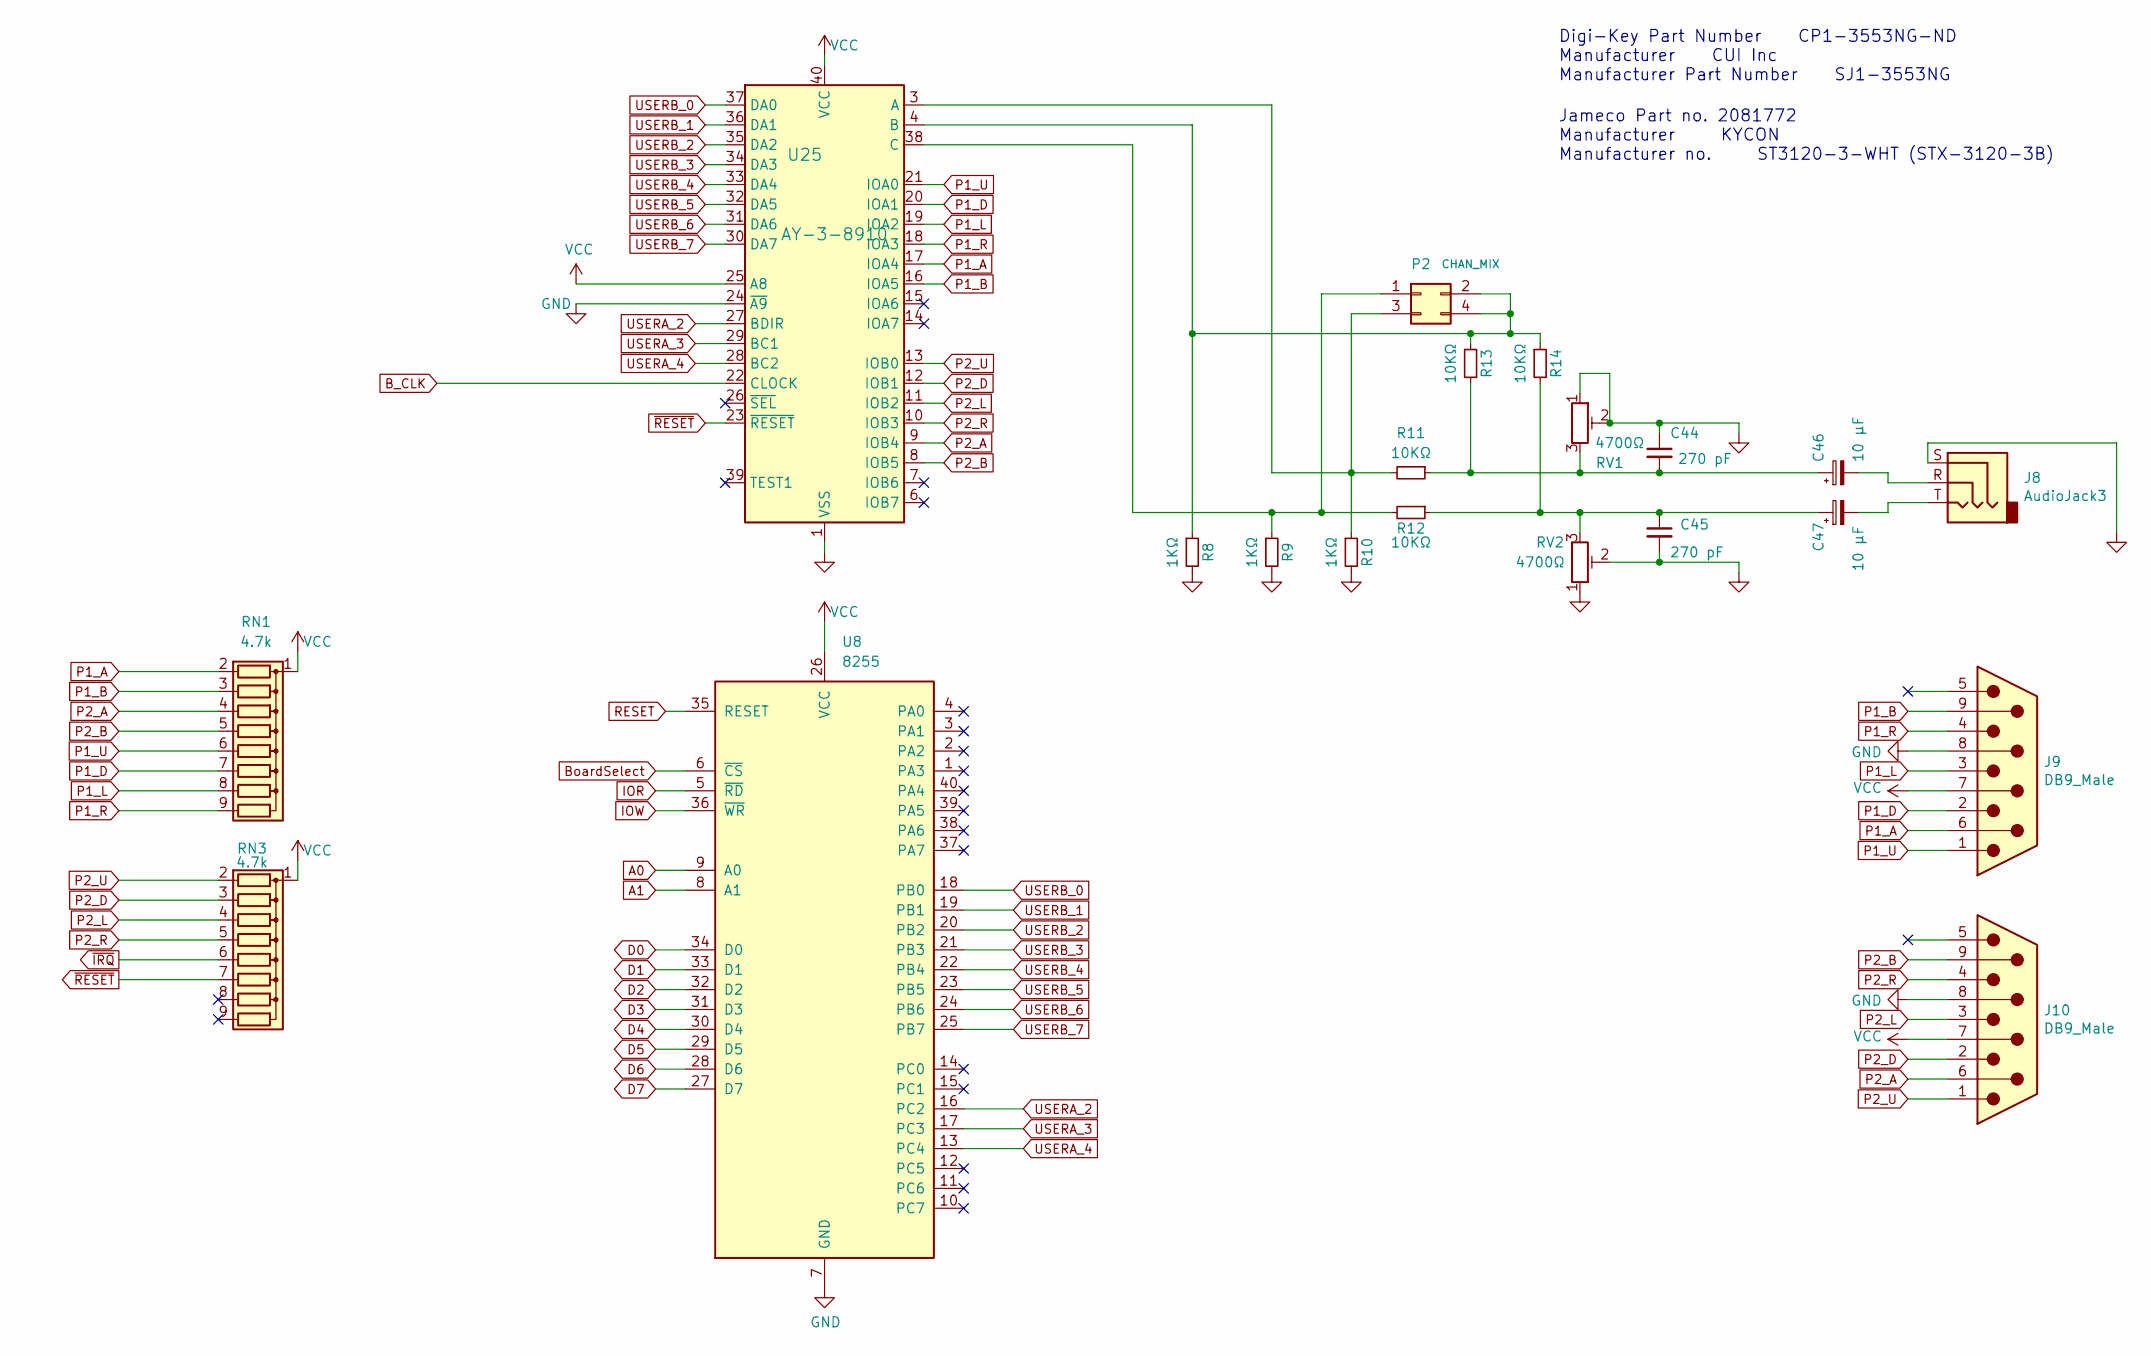
[picture p168: schematic soundsch.kicad_sch, ISA SOUND]

Parts:
C44, C45: 270 pF; STD_DDW_CAP
C46, C47: 10 µF; STD_DDW_PCAP
J8: AudioJack3; ddw_Jack_3.5mm_CUI_SJ1-3525N_Horizontal
J9, J10: DB9_Male; DSUB-9_Pins_Horizontal_P2.77x2.84mm_EdgePinOffset4.94mm_Hou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
P2: CHAN_MIX; PinHeader_2x02_P2.54mm_Vertical
R8, R9, R10: 1KΩ; STD_DDW_RESISTOR
R11, R12, R13, R14: 10KΩ; STD_DDW_RESISTOR
RN1, RN3: 4.7k; STD_DDW_SIP9
RV1, RV2: 4700Ω; Potentiometer_ACP_CA9-V10_Vertical
U8: 8255; STD_DDW_DIP40
U25: AY-3-8910; STD_DDW_DIP40

Connections:
A0: U8.9 (A0); also elsewhere on the board
A1: U8.8 (A1); also elsewhere on the board
B_CLK: U25.22 (CLOCK); also elsewhere on the board
BoardSelect: U8.6 (~CS); also elsewhere on the board
D0: U8.34 (D0); also elsewhere on the board
D1: U8.33 (D1); also elsewhere on the board
D2: U8.32 (D2); also elsewhere on the board
D3: U8.31 (D3); also elsewhere on the board
D4: U8.30 (D4); also elsewhere on the board
D5: U8.29 (D5); also elsewhere on the board
D6: U8.28 (D6); also elsewhere on the board
D7: U8.27 (D7); also elsewhere on the board
GND: C44.1, C45.2, J8.S, J9.8, J10.8, R8.2, R9.2, R10.2, RV1.1, RV1.2, RV2.1, RV2.2, U8.7 (GND), U25.1 (VSS), U25.24 (~A9); also elsewhere on the board
IOR: U8.5 (~RD); also elsewhere on the board
IOW: U8.36 (~WR); also elsewhere on the board
unnamed: C44.2, C46.1, R11.1, R13.2, RV1.3
unnamed: C45.1, C47.1, R12.1, R14.2, RV2.3
unnamed: C46.2, J8.R
unnamed: C47.2, J8.T
unnamed: P2.1, R9.1, R12.2, U25.38 (C)
unnamed: P2.2, P2.4, R8.1, R13.1, R14.1, U25.4 (B)
unnamed: P2.3, R10.1, R11.2, U25.3 (A)
P1_A: J9.6, RN1.2 (R1), U25.17 (IOA4)
P1_B: J9.9, RN1.3 (R2), U25.16 (IOA5)
P1_D: J9.2, RN1.7 (R6), U25.20 (IOA1)
P1_L: J9.3, RN1.8 (R7), U25.19 (IOA2)
P1_R: J9.4, RN1.9 (R8), U25.18 (IOA3)
P1_U: J9.1, RN1.6 (R5), U25.21 (IOA0)
P2_A: J10.6, RN1.4 (R3), U25.9 (IOB4)
P2_B: J10.9, RN1.5 (R4), U25.8 (IOB5)
P2_D: J10.2, RN3.3 (R2), U25.12 (IOB1)
P2_L: J10.3, RN3.4 (R3), U25.11 (IOB2)
P2_R: J10.4, RN3.5 (R4), U25.10 (IOB3)
P2_U: J10.1, RN3.2 (R1), U25.13 (IOB0)
RESET: U8.35 (RESET); also elsewhere on the board
USERA_2: U8.16 (PC2), U25.27 (BDIR)
USERA_3: U8.17 (PC3), U25.29 (BC1)
USERA_4: U8.13 (PC4), U25.28 (BC2)
USERB_0: U8.18 (PB0), U25.37 (DA0)
USERB_1: U8.19 (PB1), U25.36 (DA1)
USERB_2: U8.20 (PB2), U25.35 (DA2)
USERB_3: U8.21 (PB3), U25.34 (DA3)
USERB_4: U8.22 (PB4), U25.33 (DA4)
USERB_5: U8.23 (PB5), U25.32 (DA5)
USERB_6: U8.24 (PB6), U25.31 (DA6)
USERB_7: U8.25 (PB7), U25.30 (DA7)
VCC: J9.7, J10.7, RN1.1 (common), RN3.1 (common), U8.26 (VCC), U25.25 (A8), U25.40 (VCC); also elsewhere on the board
~IRQ: RN3.6 (R5); also elsewhere on the board
~RESET: RN3.7 (R6), U25.23 (~RESET); also elsewhere on the board

Notes on the sheet:
Jameco Part no. 2081772 Manufacturer KYCON Manufacturer no. ST3120-3-WHT (STX-3120-3B)
Digi-Key Part Number CP1-3553NG-ND Manufacturer CUI Inc Manufacturer Part Number SJ1-3553NG

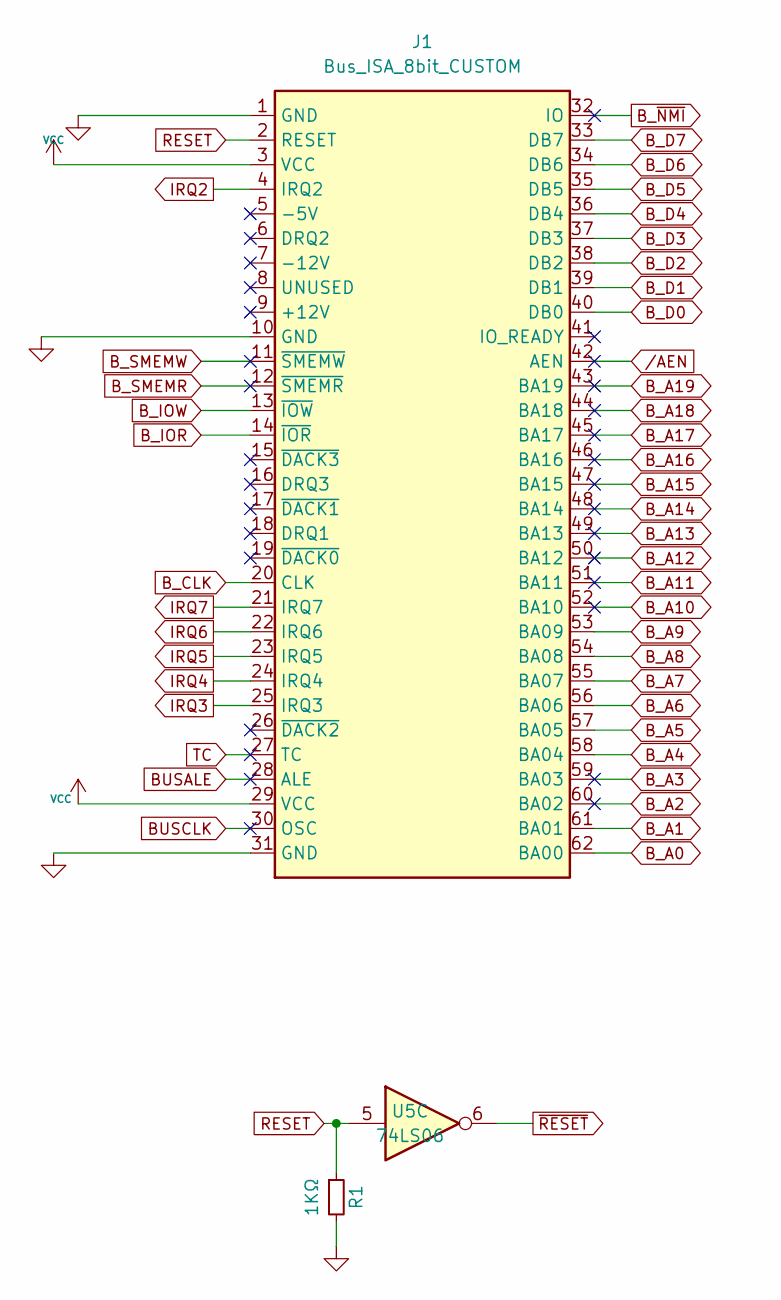
[picture p169: schematic ISA.kicad_sch, ISA SOUND]

Parts:
J1: Bus_ISA_8bit_CUSTOM; BUSEDGE_XT
R1: 1KΩ; STD_DDW_RESISTOR
U5: 74LS06; STD_DDW_DIP14

Connections:
BUSALE: J1.28 (ALE)
BUSCLK: J1.30 (OSC)
B_A0: J1.62 (BA00); also elsewhere on the board
B_A1: J1.61 (BA01); also elsewhere on the board
B_A2: J1.60 (BA02)
B_A3: J1.59 (BA03)
B_A4: J1.58 (BA04); also elsewhere on the board
B_A5: J1.57 (BA05); also elsewhere on the board
B_A6: J1.56 (BA06); also elsewhere on the board
B_A7: J1.55 (BA07); also elsewhere on the board
B_A8: J1.54 (BA08); also elsewhere on the board
B_A9: J1.53 (BA09); also elsewhere on the board
B_A10: J1.52 (BA10)
B_A11: J1.51 (BA11)
B_A12: J1.50 (BA12)
B_A13: J1.49 (BA13)
B_A14: J1.48 (BA14)
B_A15: J1.47 (BA15)
B_A16: J1.46 (BA16)
B_A17: J1.45 (BA17)
B_A18: J1.44 (BA18)
B_A19: J1.43 (BA19)
B_CLK: J1.20 (CLK); also elsewhere on the board
B_D0: J1.40 (DB0); also elsewhere on the board
B_D1: J1.39 (DB1); also elsewhere on the board
B_D2: J1.38 (DB2); also elsewhere on the board
B_D3: J1.37 (DB3); also elsewhere on the board
B_D4: J1.36 (DB4); also elsewhere on the board
B_D5: J1.35 (DB5); also elsewhere on the board
B_D6: J1.34 (DB6); also elsewhere on the board
B_D7: J1.33 (DB7); also elsewhere on the board
B_IOR: J1.14 (~IOR); also elsewhere on the board
B_IOW: J1.13 (~IOW); also elsewhere on the board
B_SMEMR: J1.12 (~SMEMR)
B_SMEMW: J1.11 (~SMEMW)
B_~NMI: J1.32 (IO)
GND: J1.1 (GND), J1.10 (GND), J1.31 (GND), R1.2; also elsewhere on the board
IRQ2: J1.4 (IRQ2); also elsewhere on the board
IRQ3: J1.25 (IRQ3); also elsewhere on the board
IRQ4: J1.24 (IRQ4); also elsewhere on the board
IRQ5: J1.23 (IRQ5); also elsewhere on the board
IRQ6: J1.22 (IRQ6); also elsewhere on the board
IRQ7: J1.21 (IRQ7); also elsewhere on the board
RESET: J1.2 (RESET), R1.1, U5.5; also elsewhere on the board
TC: J1.27 (TC)
VCC: J1.3 (VCC), J1.29 (VCC); also elsewhere on the board
/AEN: J1.42 (AEN)
~RESET: U5.6; also elsewhere on the board

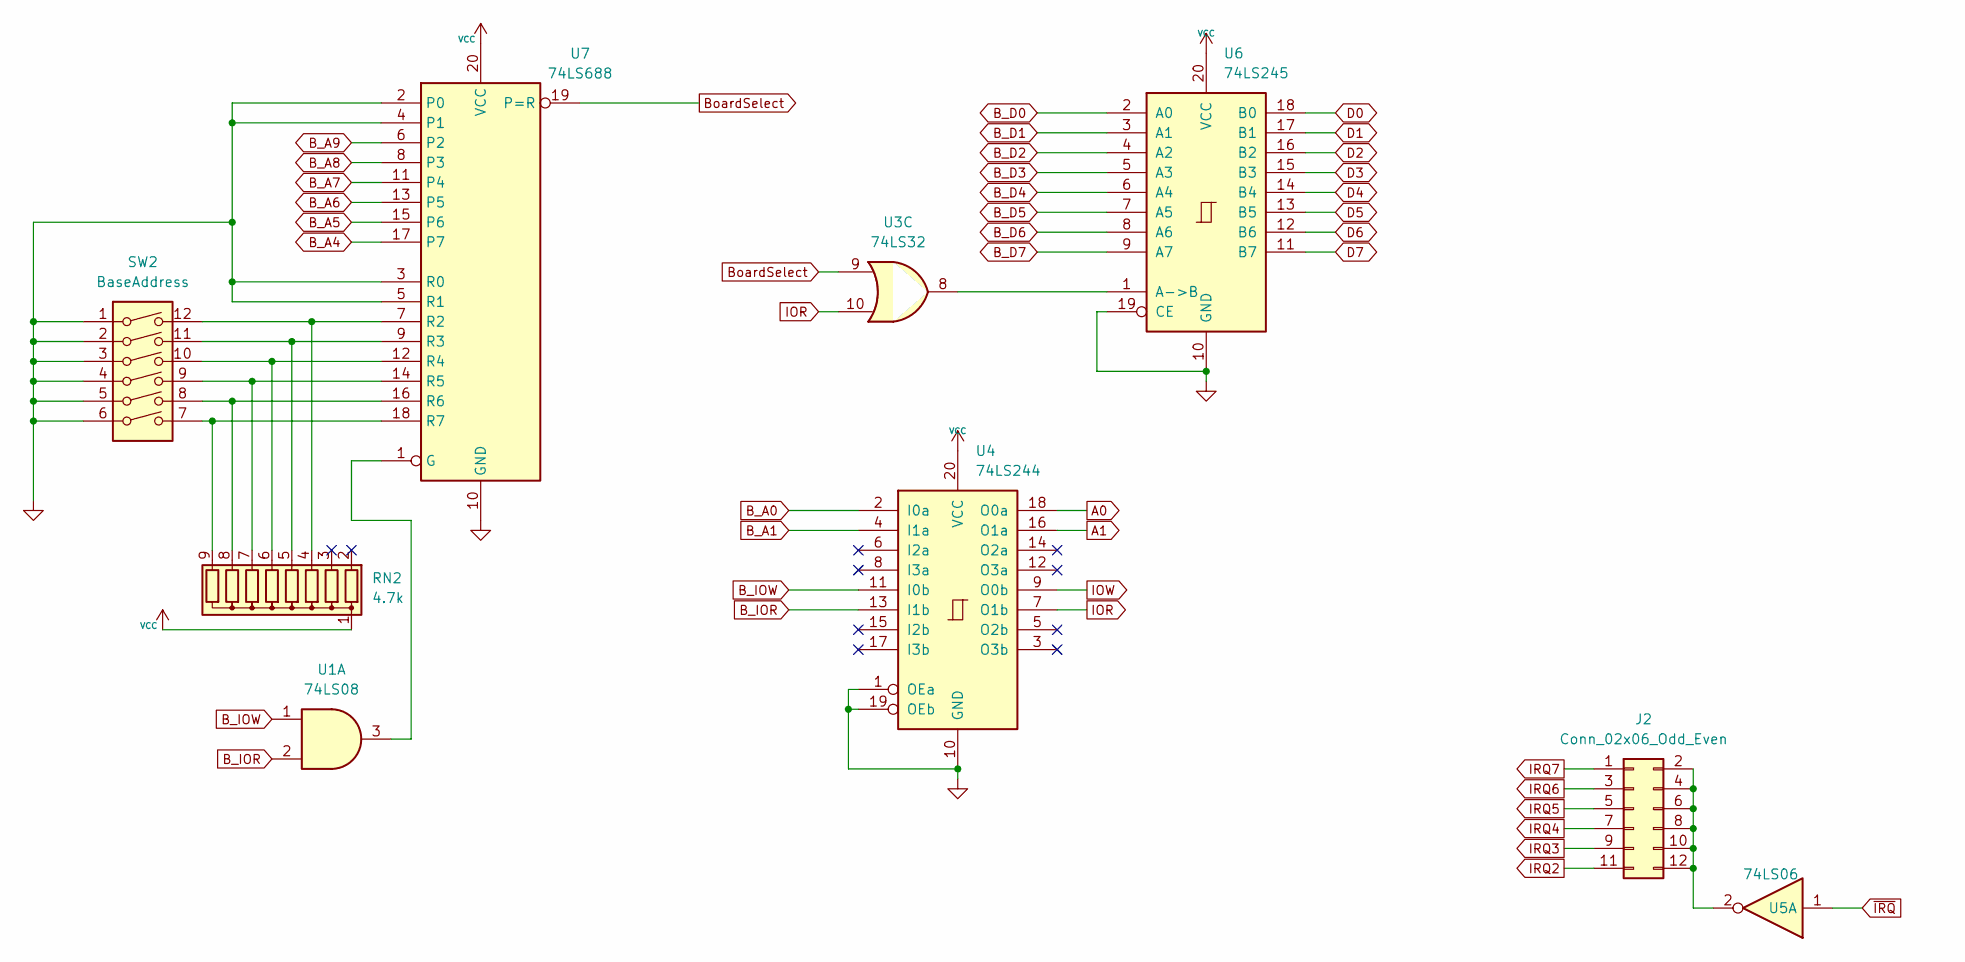
[picture p170: schematic CardSelect.kicad_sch, ISA SOUND]

Parts:
J2: Conn_02x06_Odd_Even; STD_DDW_PINHEAD_V_2x06
RN2: 4.7k; STD_DDW_SIP9
SW2: BaseAddress; DIP-12_W7.62mm_Socket_LongPads
U1: 74LS08; STD_DDW_DIP14
U3: 74LS32; STD_DDW_DIP14
U4: 74LS244; STD_DDW_DIP20
U5: 74LS06; STD_DDW_DIP14
U6: 74LS245; STD_DDW_DIP20
U7: 74LS688; STD_DDW_DIP20

Connections:
A0: U4.18 (O0a); also elsewhere on the board
A1: U4.16 (O1a); also elsewhere on the board
B_A0: U4.2 (I0a); also elsewhere on the board
B_A1: U4.4 (I1a); also elsewhere on the board
B_A4: U7.17 (P7); also elsewhere on the board
B_A5: U7.15 (P6); also elsewhere on the board
B_A6: U7.13 (P5); also elsewhere on the board
B_A7: U7.11 (P4); also elsewhere on the board
B_A8: U7.8 (P3); also elsewhere on the board
B_A9: U7.6 (P2); also elsewhere on the board
B_D0: U6.2 (A0); also elsewhere on the board
B_D1: U6.3 (A1); also elsewhere on the board
B_D2: U6.4 (A2); also elsewhere on the board
B_D3: U6.5 (A3); also elsewhere on the board
B_D4: U6.6 (A4); also elsewhere on the board
B_D5: U6.7 (A5); also elsewhere on the board
B_D6: U6.8 (A6); also elsewhere on the board
B_D7: U6.9 (A7); also elsewhere on the board
B_IOR: U1.2, U4.13 (I1b); also elsewhere on the board
B_IOW: U1.1, U4.11 (I0b); also elsewhere on the board
BoardSelect: U3.9, U7.19 (P=R); also elsewhere on the board
D0: U6.18 (B0); also elsewhere on the board
D1: U6.17 (B1); also elsewhere on the board
D2: U6.16 (B2); also elsewhere on the board
D3: U6.15 (B3); also elsewhere on the board
D4: U6.14 (B4); also elsewhere on the board
D5: U6.13 (B5); also elsewhere on the board
D6: U6.12 (B6); also elsewhere on the board
D7: U6.11 (B7); also elsewhere on the board
GND: SW2.1, SW2.2, SW2.3, SW2.4, SW2.5, SW2.6, U4.1 (OEa), U4.10 (GND), U4.19 (OEb), U6.10 (GND), U6.19 (CE), U7.2 (P0), U7.3 (R0), U7.4 (P1), U7.5 (R1), U7.10 (GND); also elsewhere on the board
IOR: U3.10, U4.7 (O1b); also elsewhere on the board
IOW: U4.9 (O0b); also elsewhere on the board
IRQ2: J2.11; also elsewhere on the board
IRQ3: J2.9; also elsewhere on the board
IRQ4: J2.7; also elsewhere on the board
IRQ5: J2.5; also elsewhere on the board
IRQ6: J2.3; also elsewhere on the board
IRQ7: J2.1; also elsewhere on the board
unnamed: J2.2, J2.4, J2.6, J2.8, J2.10, J2.12, U5.2
unnamed: RN2.4 (R3), SW2.12, U7.7 (R2)
unnamed: RN2.5 (R4), SW2.11, U7.9 (R3)
unnamed: RN2.6 (R5), SW2.10, U7.12 (R4)
unnamed: RN2.7 (R6), SW2.9, U7.14 (R5)
unnamed: RN2.8 (R7), SW2.8, U7.16 (R6)
unnamed: RN2.9 (R8), SW2.7, U7.18 (R7)
unnamed: U3.8, U6.1 (A->B)
unnamed: U1.3, U7.1 (G)
VCC: RN2.1 (common), U4.20 (VCC), U6.20 (VCC), U7.20 (VCC); also elsewhere on the board
~IRQ: U5.1; also elsewhere on the board

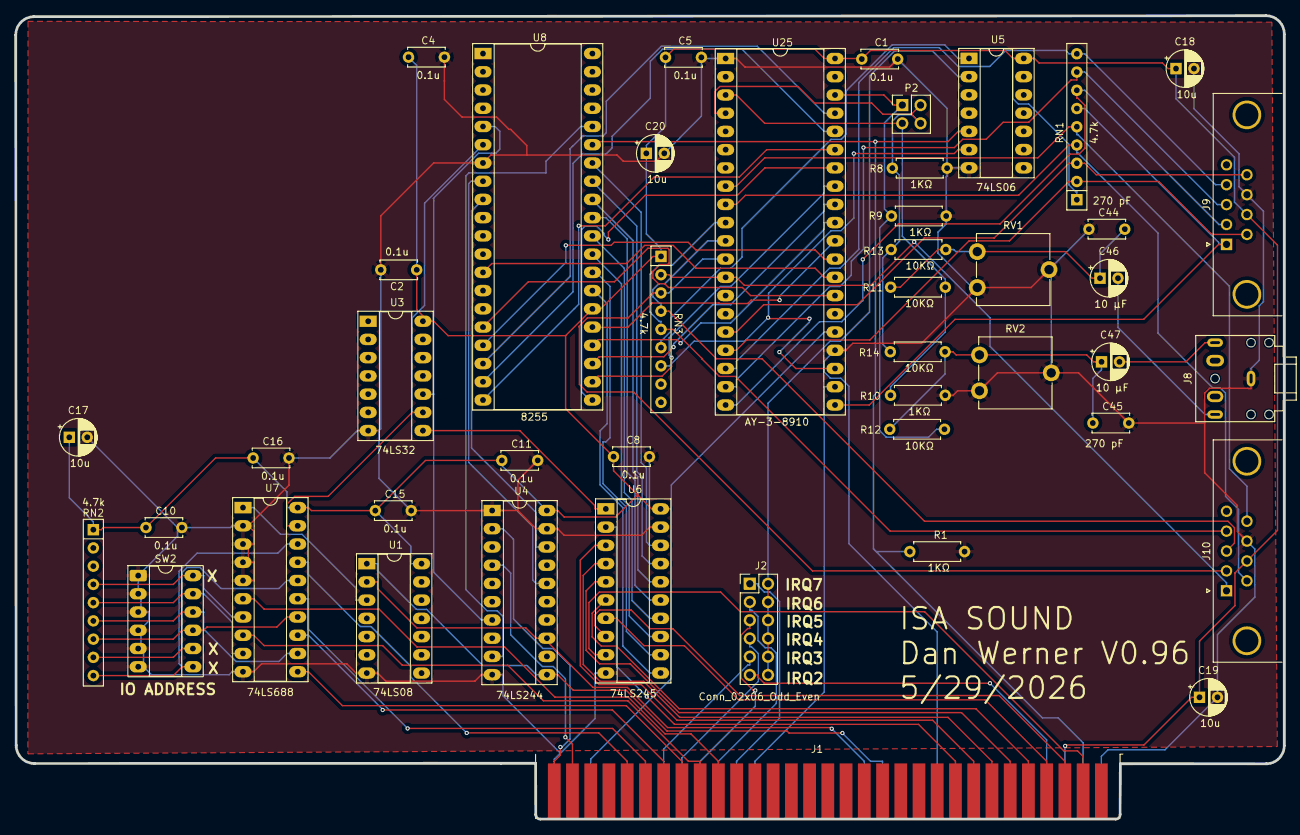
[picture p171: board SOUND.kicad_pcb from above]

Board: 2 copper layers, 176.7 x 111.9 mm, 45 parts (0 on the bottom side), 82 nets.
