danwerner21/ISA_IO/VIDEO/HARDWARE/video.kicad_pcb

## KiCad design VIDEO/HARDWARE/video.kicad_pcb (2026-03-22)

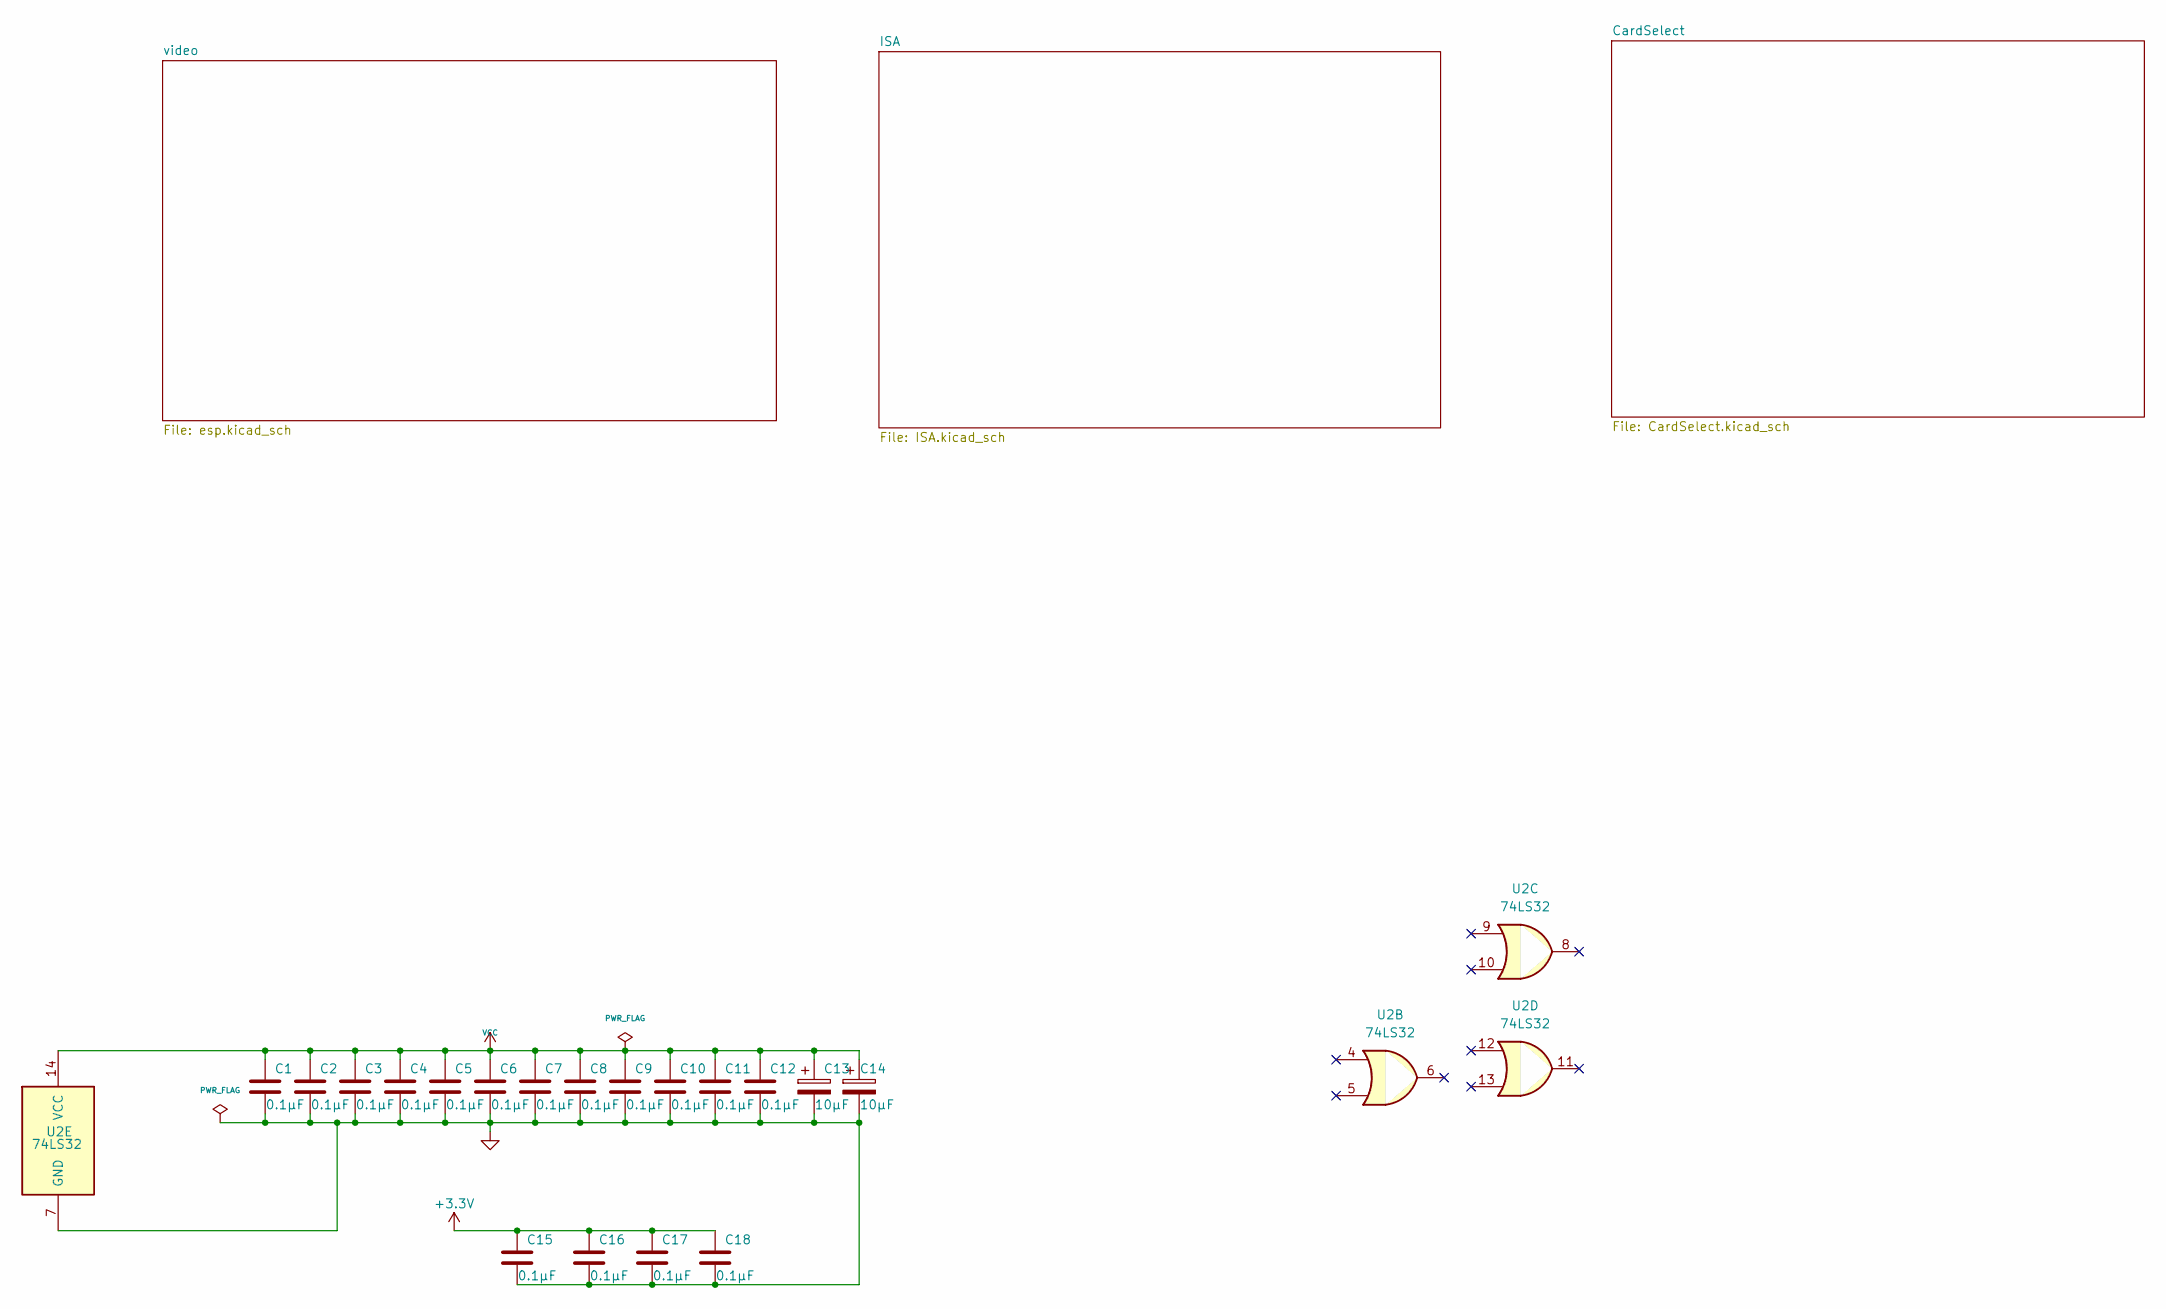
[picture p172: schematic video.kicad_sch, ISA VIDEO]

Parts:
C1, C2, C3, C4, C5, C6, C7, C8, C9, C10, C11, C12, C15, C16, C17, C18: 0.1µF; STD_DDW_CAP
C13, C14: 10µF; STD_DDW_PCAP
U2: 74LS32; STD_DDW_DIP14

Connections:
+3.3V: C15.1, C16.1, C17.1, C18.1; also elsewhere on the board
GND: C1.2, C2.2, C3.2, C4.2, C5.2, C6.2, C7.2, C8.2, C9.2, C10.2, C11.2, C12.2, C13.2, C14.2, C15.2, C16.2, C17.2, C18.2, U2.7 (GND); also elsewhere on the board
VCC: C1.1, C2.1, C3.1, C4.1, C5.1, C6.1, C7.1, C8.1, C9.1, C10.1, C11.1, C12.1, C13.1, C14.1, U2.14 (VCC); also elsewhere on the board

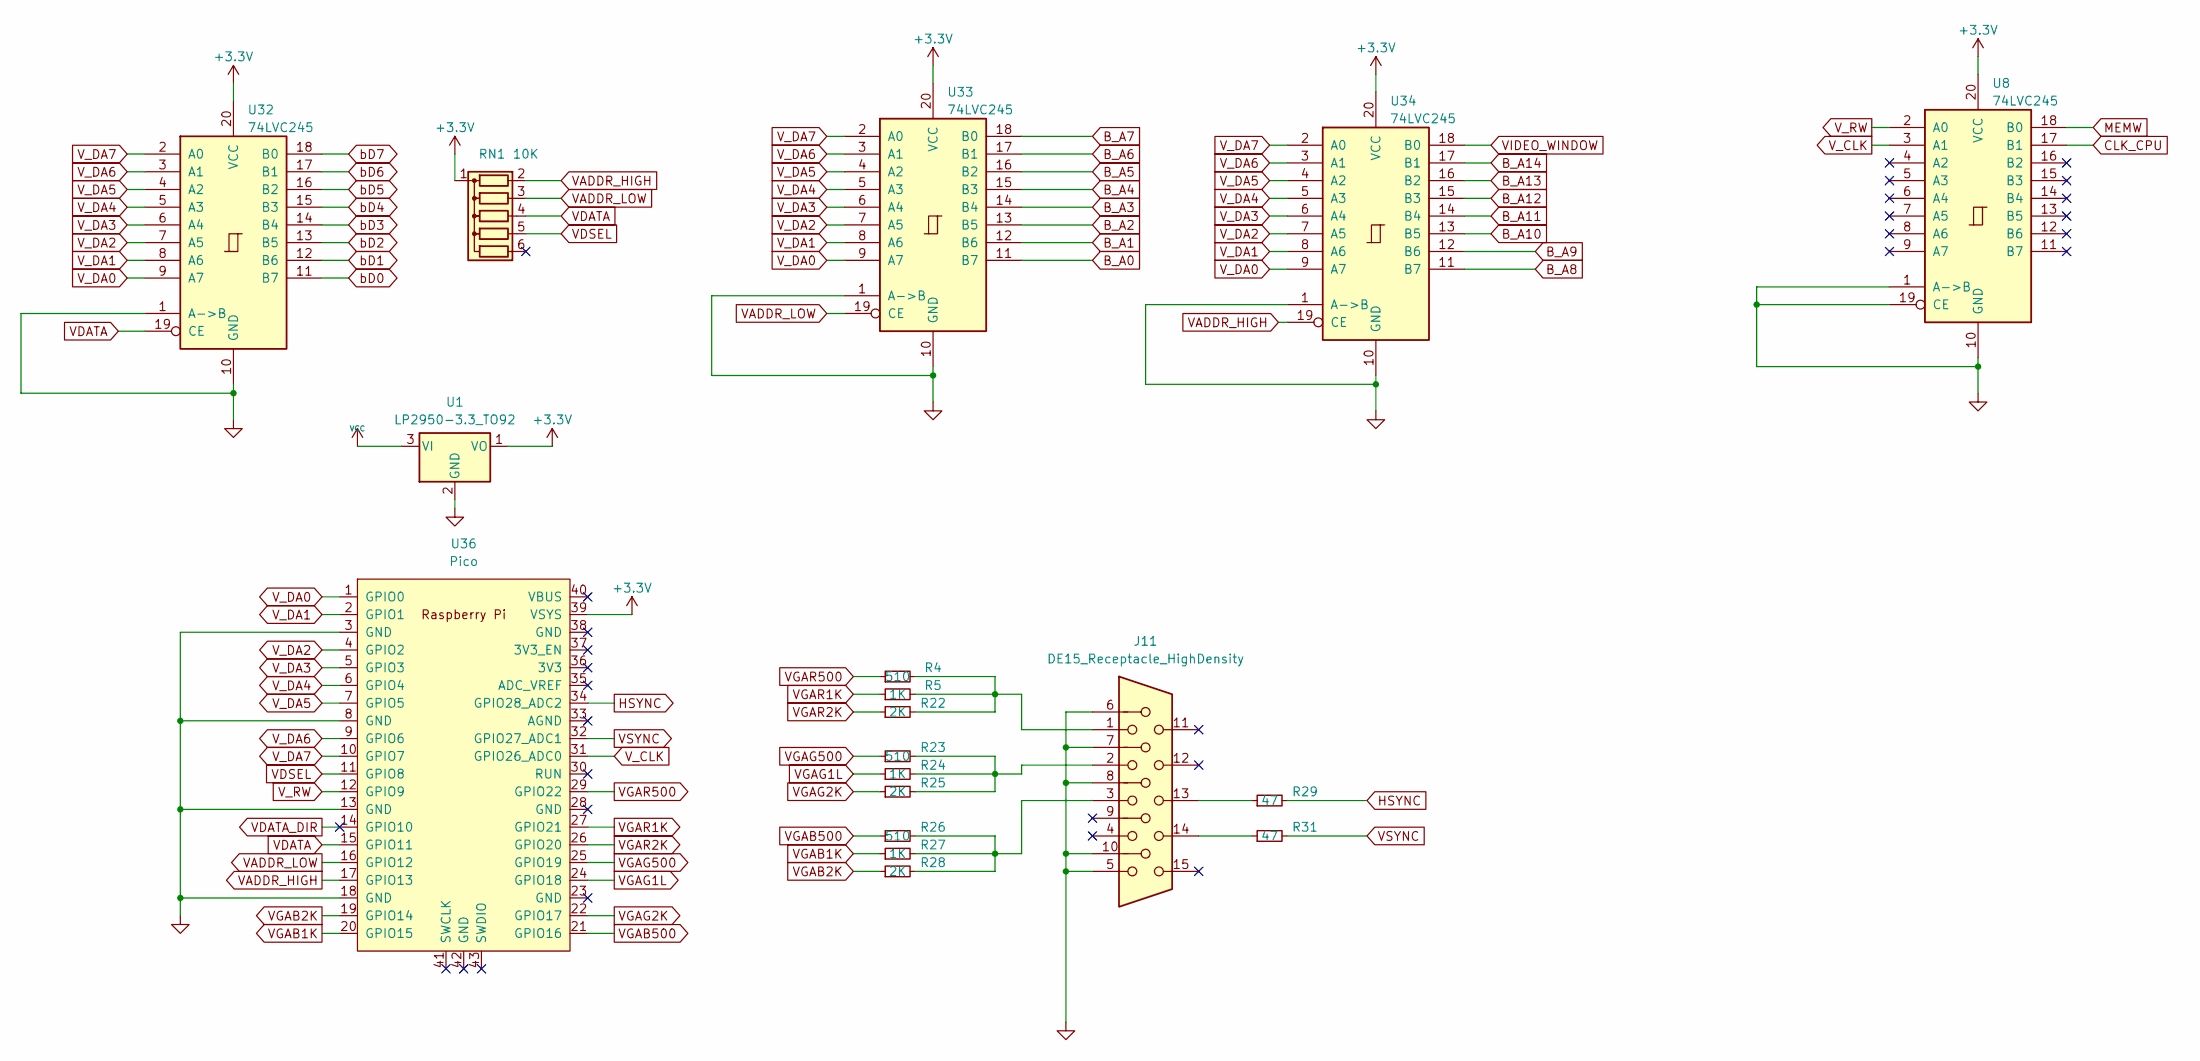
[picture p173: schematic esp.kicad_sch, ISA VIDEO]

Parts:
J11: DE15_Receptacle_HighDensity; STD_DDW_VGA
R4, R23, R26: 510; STD_DDW_RESISTOR
R5, R24, R27: 1K; STD_DDW_RESISTOR
R22, R25, R28: 2K; STD_DDW_RESISTOR
R29, R31: 47; STD_DDW_RESISTOR
RN1: 10K; R_Array_SIP6
U1: LP2950-3.3_TO92; TO-92_Inline
U8, U32, U33, U34: 74LVC245; STD_DDW_DIP20
U36: Pico; RPi_Pico_SMD_TH_DDW

Connections:
+3.3V: RN1.1 (common), U1.1 (VO), U8.20 (VCC), U32.20 (VCC), U33.20 (VCC), U34.20 (VCC), U36.39 (VSYS); also elsewhere on the board
B_A0: U33.11 (B7); also elsewhere on the board
B_A1: U33.12 (B6); also elsewhere on the board
B_A2: U33.13 (B5); also elsewhere on the board
B_A3: U33.14 (B4); also elsewhere on the board
B_A4: U33.15 (B3); also elsewhere on the board
B_A5: U33.16 (B2); also elsewhere on the board
B_A6: U33.17 (B1); also elsewhere on the board
B_A7: U33.18 (B0); also elsewhere on the board
B_A8: U34.11 (B7); also elsewhere on the board
B_A9: U34.12 (B6); also elsewhere on the board
B_A10: U34.13 (B5); also elsewhere on the board
B_A11: U34.14 (B4); also elsewhere on the board
B_A12: U34.15 (B3); also elsewhere on the board
B_A13: U34.16 (B2); also elsewhere on the board
B_A14: U34.17 (B1); also elsewhere on the board
CLK_CPU: U8.17 (B1); also elsewhere on the board
GND: J11.5, J11.6, J11.7, J11.8, J11.10, U1.2 (GND), U8.1 (A->B), U8.10 (GND), U8.19 (CE), U32.1 (A->B), U32.10 (GND), U33.1 (A->B), U33.10 (GND), U34.1 (A->B), U34.10 (GND), U36.3 (GND), U36.8 (GND), U36.13 (GND), U36.18 (GND); also elsewhere on the board
HSYNC: R29.2, U36.34 (GPIO28_ADC2)
MEMW: U8.18 (B0); also elsewhere on the board
unnamed: J11.1, R4.2, R5.2, R22.2
unnamed: J11.2, R23.2, R24.2, R25.2
unnamed: J11.3, R26.2, R27.2, R28.2
unnamed: J11.13, R29.1
unnamed: J11.14, R31.1
VADDR_HIGH: RN1.2 (R1), U34.19 (CE), U36.17 (GPIO13)
VADDR_LOW: RN1.3 (R2), U33.19 (CE), U36.16 (GPIO12)
VCC: U1.3 (VI); also elsewhere on the board
VDATA: RN1.4 (R3), U32.19 (CE), U36.15 (GPIO11)
VDATA_DIR: U36.14 (GPIO10)
VDATA_DIR_1: U36.14 (GPIO10)
VDSEL: RN1.5 (R4), U36.11 (GPIO8)
VGAB1K: R27.1, U36.20 (GPIO15)
VGAB2K: R28.1, U36.19 (GPIO14)
VGAB500: R26.1, U36.21 (GPIO16)
VGAG1L: R24.1, U36.24 (GPIO18)
VGAG2K: R25.1, U36.22 (GPIO17)
VGAG500: R23.1, U36.25 (GPIO19)
VGAR1K: R5.1, U36.27 (GPIO21)
VGAR2K: R22.1, U36.26 (GPIO20)
VGAR500: R4.1, U36.29 (GPIO22)
VIDEO_WINDOW: U34.18 (B0); also elsewhere on the board
VSYNC: R31.2, U36.32 (GPIO27_ADC1)
V_CLK: U8.3 (A1), U36.31 (GPIO26_ADC0)
V_DA0: U32.9 (A7), U33.9 (A7), U34.9 (A7), U36.1 (GPIO0)
V_DA1: U32.8 (A6), U33.8 (A6), U34.8 (A6), U36.2 (GPIO1)
V_DA2: U32.7 (A5), U33.7 (A5), U34.7 (A5), U36.4 (GPIO2)
V_DA3: U32.6 (A4), U33.6 (A4), U34.6 (A4), U36.5 (GPIO3)
V_DA4: U32.5 (A3), U33.5 (A3), U34.5 (A3), U36.6 (GPIO4)
V_DA5: U32.4 (A2), U33.4 (A2), U34.4 (A2), U36.7 (GPIO5)
V_DA6: U32.3 (A1), U33.3 (A1), U34.3 (A1), U36.9 (GPIO6)
V_DA7: U32.2 (A0), U33.2 (A0), U34.2 (A0), U36.10 (GPIO7)
V_RW: U8.2 (A0), U36.12 (GPIO9)
bD0: U32.11 (B7); also elsewhere on the board
bD1: U32.12 (B6); also elsewhere on the board
bD2: U32.13 (B5); also elsewhere on the board
bD3: U32.14 (B4); also elsewhere on the board
bD4: U32.15 (B3); also elsewhere on the board
bD5: U32.16 (B2); also elsewhere on the board
bD6: U32.17 (B1); also elsewhere on the board
bD7: U32.18 (B0); also elsewhere on the board
