danwerner21/ISA_IO/VIDEO/HARDWARE/video.kicad_pcb

## KiCad design VIDEO/HARDWARE/video.kicad_pcb (continued)

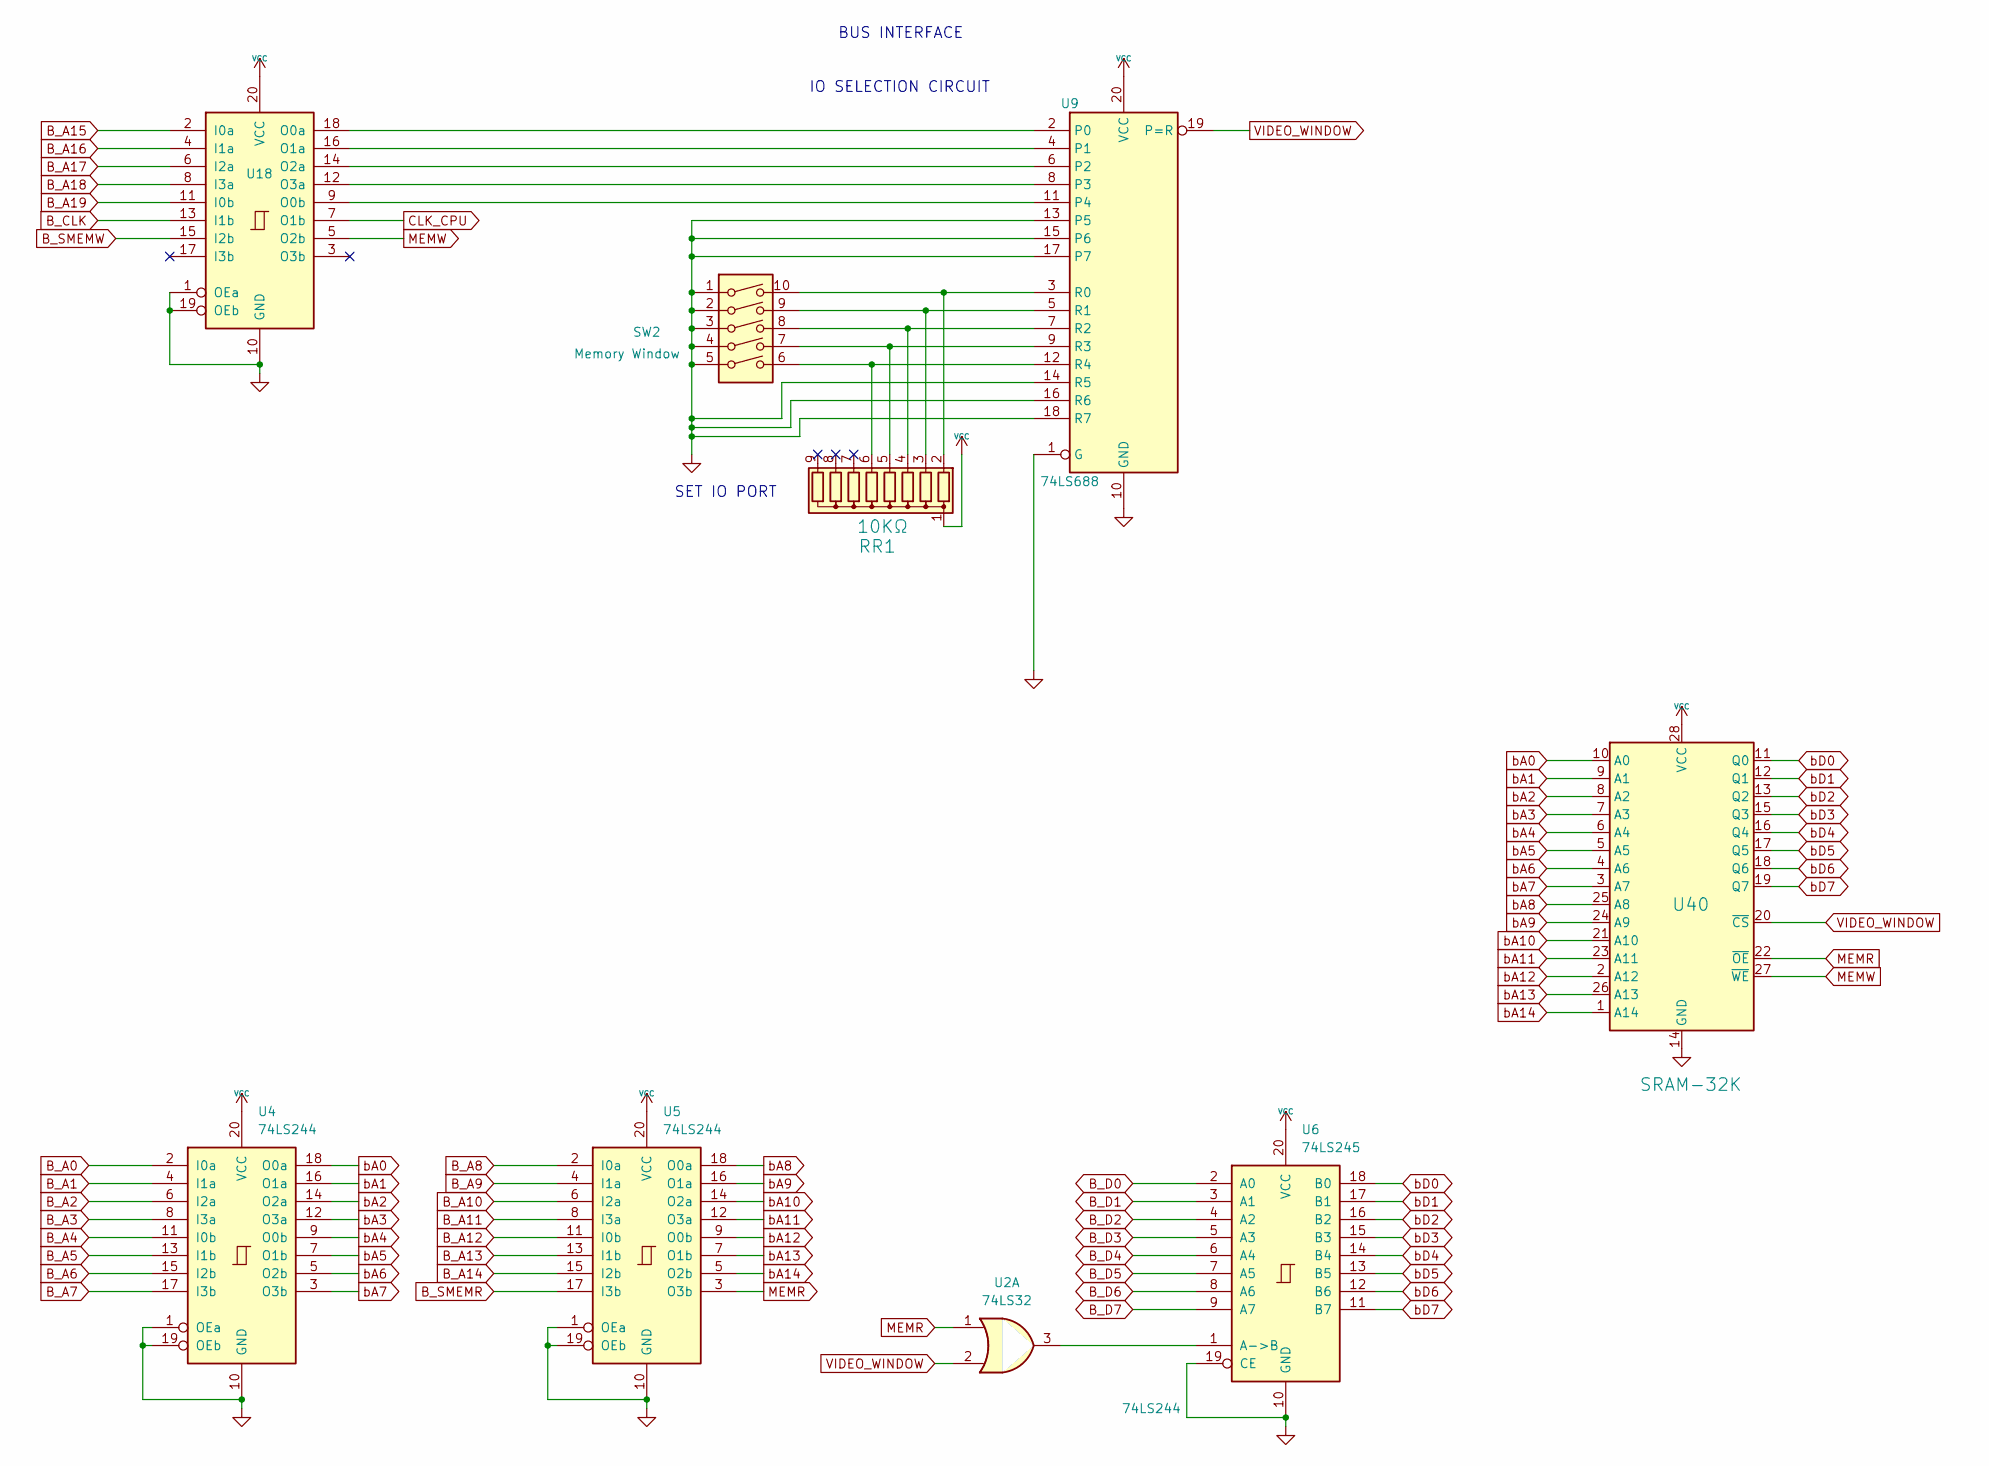
[picture p174: schematic CardSelect.kicad_sch, ISA VIDEO]

Parts:
RR1: 10KΩ; STD_DDW_SIP9
SW2: Memory Window; STD_DDW_DIP10
U2: 74LS32; STD_DDW_DIP14
U4, U5, U18: 74LS244; STD_DDW_DIP20
U6: 74LS245; STD_DDW_DIP20
U9: 74LS688; STD_DDW_DIP20
U40: SRAM-32K; STD_DDW_DIP28_SKINNY

Connections:
B_A0: U4.2 (I0a); also elsewhere on the board
B_A1: U4.4 (I1a); also elsewhere on the board
B_A2: U4.6 (I2a); also elsewhere on the board
B_A3: U4.8 (I3a); also elsewhere on the board
B_A4: U4.11 (I0b); also elsewhere on the board
B_A5: U4.13 (I1b); also elsewhere on the board
B_A6: U4.15 (I2b); also elsewhere on the board
B_A7: U4.17 (I3b); also elsewhere on the board
B_A8: U5.2 (I0a); also elsewhere on the board
B_A9: U5.4 (I1a); also elsewhere on the board
B_A10: U5.6 (I2a); also elsewhere on the board
B_A11: U5.8 (I3a); also elsewhere on the board
B_A12: U5.11 (I0b); also elsewhere on the board
B_A13: U5.13 (I1b); also elsewhere on the board
B_A14: U5.15 (I2b); also elsewhere on the board
B_A15: U18.2 (I0a); also elsewhere on the board
B_A16: U18.4 (I1a); also elsewhere on the board
B_A17: U18.6 (I2a); also elsewhere on the board
B_A18: U18.8 (I3a); also elsewhere on the board
B_A19: U18.11 (I0b); also elsewhere on the board
B_CLK: U18.13 (I1b); also elsewhere on the board
B_D0: U6.2 (A0); also elsewhere on the board
B_D1: U6.3 (A1); also elsewhere on the board
B_D2: U6.4 (A2); also elsewhere on the board
B_D3: U6.5 (A3); also elsewhere on the board
B_D4: U6.6 (A4); also elsewhere on the board
B_D5: U6.7 (A5); also elsewhere on the board
B_D6: U6.8 (A6); also elsewhere on the board
B_D7: U6.9 (A7); also elsewhere on the board
B_SMEMR: U5.17 (I3b); also elsewhere on the board
B_SMEMW: U18.15 (I2b); also elsewhere on the board
CLK_CPU: U18.7 (O1b); also elsewhere on the board
GND: SW2.1, SW2.2, SW2.3, SW2.4, SW2.5, U4.1 (OEa), U4.10 (GND), U4.19 (OEb), U5.1 (OEa), U5.10 (GND), U5.19 (OEb), U6.10 (GND), U6.19 (CE), U9.1 (G), U9.10 (GND), U9.13 (P5), U9.14 (R5), U9.15 (P6), U9.16 (R6), U9.17 (P7), U9.18 (R7), U18.1 (OEa), U18.10 (GND), U18.19 (OEb), U40.14 (GND); also elsewhere on the board
MEMR: U2.1, U5.3 (O3b), U40.22 (~OE)
MEMW: U18.5 (O2b), U40.27 (~WE); also elsewhere on the board
unnamed: RR1.2 (R1), SW2.10, U9.3 (R0)
unnamed: RR1.3 (R2), SW2.9, U9.5 (R1)
unnamed: RR1.4 (R3), SW2.8, U9.7 (R2)
unnamed: RR1.5 (R4), SW2.7, U9.9 (R3)
unnamed: RR1.6 (R5), SW2.6, U9.12 (R4)
unnamed: U2.3, U6.1 (A->B)
unnamed: U9.2 (P0), U18.18 (O0a)
unnamed: U9.11 (P4), U18.9 (O0b)
unnamed: U9.4 (P1), U18.16 (O1a)
unnamed: U9.6 (P2), U18.14 (O2a)
unnamed: U9.8 (P3), U18.12 (O3a)
VCC: RR1.1 (common), U4.20 (VCC), U5.20 (VCC), U6.20 (VCC), U9.20 (VCC), U18.20 (VCC), U40.28 (VCC); also elsewhere on the board
VIDEO_WINDOW: U2.2, U9.19 (P=R), U40.20 (~CS); also elsewhere on the board
bA0: U4.18 (O0a), U40.10 (A0)
bA1: U4.16 (O1a), U40.9 (A1)
bA2: U4.14 (O2a), U40.8 (A2)
bA3: U4.12 (O3a), U40.7 (A3)
bA4: U4.9 (O0b), U40.6 (A4)
bA5: U4.7 (O1b), U40.5 (A5)
bA6: U4.5 (O2b), U40.4 (A6)
bA7: U4.3 (O3b), U40.3 (A7)
bA8: U5.18 (O0a), U40.25 (A8)
bA9: U5.16 (O1a), U40.24 (A9)
bA10: U5.14 (O2a), U40.21 (A10)
bA11: U5.12 (O3a), U40.23 (A11)
bA12: U5.9 (O0b), U40.2 (A12)
bA13: U5.7 (O1b), U40.26 (A13)
bA14: U5.5 (O2b), U40.1 (A14)
bD0: U6.18 (B0), U40.11 (Q0); also elsewhere on the board
bD1: U6.17 (B1), U40.12 (Q1); also elsewhere on the board
bD2: U6.16 (B2), U40.13 (Q2); also elsewhere on the board
bD3: U6.15 (B3), U40.15 (Q3); also elsewhere on the board
bD4: U6.14 (B4), U40.16 (Q4); also elsewhere on the board
bD5: U6.13 (B5), U40.17 (Q5); also elsewhere on the board
bD6: U6.12 (B6), U40.18 (Q6); also elsewhere on the board
bD7: U6.11 (B7), U40.19 (Q7); also elsewhere on the board

Notes on the sheet:
SET IO PORT
IO SELECTION CIRCUIT
BUS INTERFACE

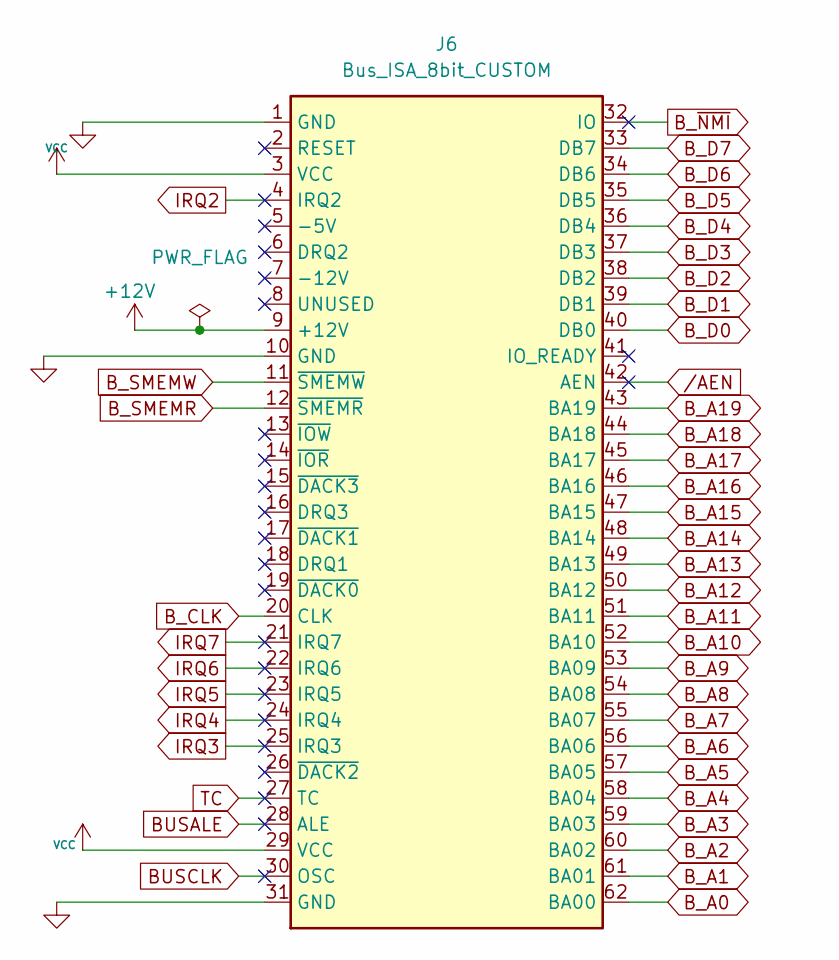
[picture p175: schematic ISA.kicad_sch, ISA VIDEO]

Parts:
J6: Bus_ISA_8bit_CUSTOM; BUSEDGE_XT

Connections:
+12V: J6.9 (+12V)
BUSALE: J6.28 (ALE)
BUSCLK: J6.30 (OSC)
B_A0: J6.62 (BA00); also elsewhere on the board
B_A1: J6.61 (BA01); also elsewhere on the board
B_A2: J6.60 (BA02); also elsewhere on the board
B_A3: J6.59 (BA03); also elsewhere on the board
B_A4: J6.58 (BA04); also elsewhere on the board
B_A5: J6.57 (BA05); also elsewhere on the board
B_A6: J6.56 (BA06); also elsewhere on the board
B_A7: J6.55 (BA07); also elsewhere on the board
B_A8: J6.54 (BA08); also elsewhere on the board
B_A9: J6.53 (BA09); also elsewhere on the board
B_A10: J6.52 (BA10); also elsewhere on the board
B_A11: J6.51 (BA11); also elsewhere on the board
B_A12: J6.50 (BA12); also elsewhere on the board
B_A13: J6.49 (BA13); also elsewhere on the board
B_A14: J6.48 (BA14); also elsewhere on the board
B_A15: J6.47 (BA15); also elsewhere on the board
B_A16: J6.46 (BA16); also elsewhere on the board
B_A17: J6.45 (BA17); also elsewhere on the board
B_A18: J6.44 (BA18); also elsewhere on the board
B_A19: J6.43 (BA19); also elsewhere on the board
B_CLK: J6.20 (CLK); also elsewhere on the board
B_D0: J6.40 (DB0); also elsewhere on the board
B_D1: J6.39 (DB1); also elsewhere on the board
B_D2: J6.38 (DB2); also elsewhere on the board
B_D3: J6.37 (DB3); also elsewhere on the board
B_D4: J6.36 (DB4); also elsewhere on the board
B_D5: J6.35 (DB5); also elsewhere on the board
B_D6: J6.34 (DB6); also elsewhere on the board
B_D7: J6.33 (DB7); also elsewhere on the board
B_SMEMR: J6.12 (~SMEMR); also elsewhere on the board
B_SMEMW: J6.11 (~SMEMW); also elsewhere on the board
B_~NMI: J6.32 (IO)
GND: J6.1 (GND), J6.10 (GND), J6.31 (GND); also elsewhere on the board
IRQ2: J6.4 (IRQ2)
IRQ3: J6.25 (IRQ3)
IRQ4: J6.24 (IRQ4)
IRQ5: J6.23 (IRQ5)
IRQ6: J6.22 (IRQ6)
IRQ7: J6.21 (IRQ7)
TC: J6.27 (TC)
VCC: J6.3 (VCC), J6.29 (VCC); also elsewhere on the board
/AEN: J6.42 (AEN)

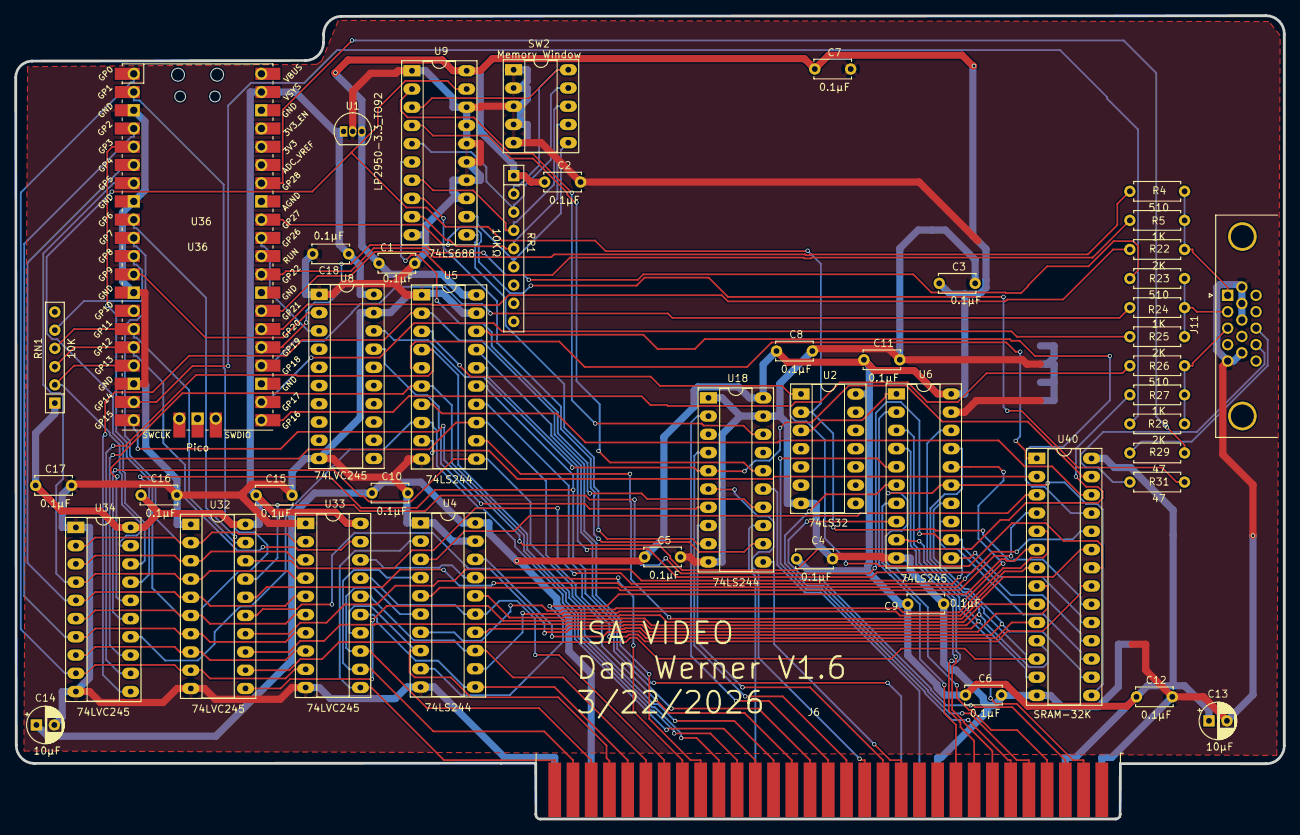
[picture p176: board video.kicad_pcb from above]

Board: 2 copper layers, 176.7 x 111.9 mm, 47 parts (0 on the bottom side), 102 nets.
