danwerner21/ISA_IO/DUALESP/HARDWARE/DUALESP.kicad_pcb

## KiCad design DUALESP/HARDWARE/DUALESP.kicad_pcb (2025-12-29)

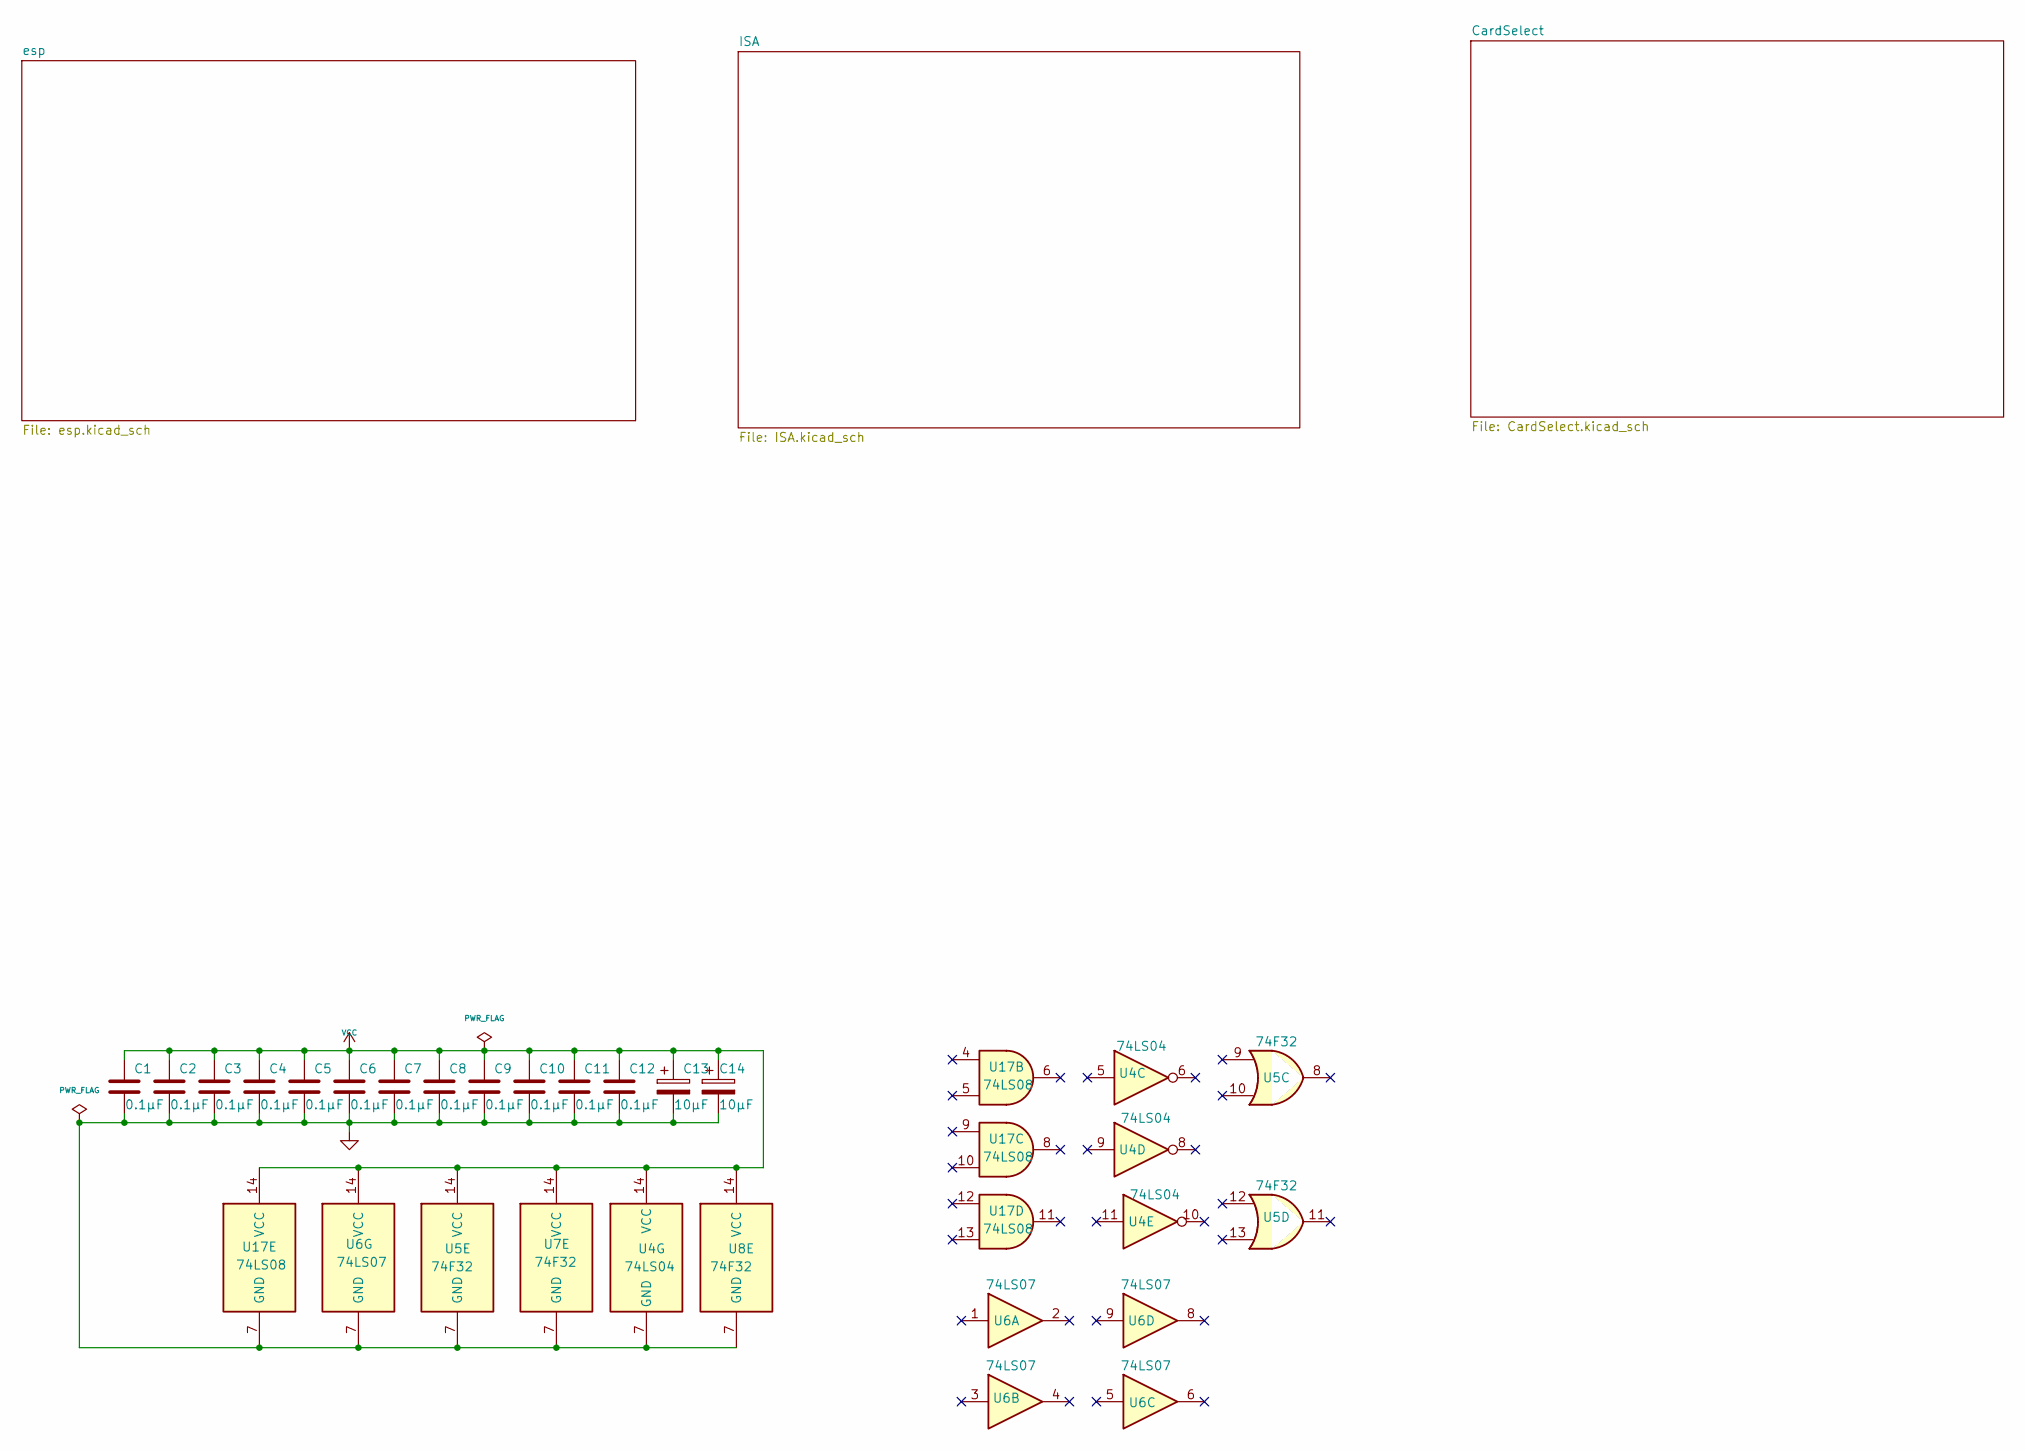
[picture p177: schematic DUALESP.kicad_sch, ISA DUAL ESP32]

Parts:
C1, C2, C3, C4, C5, C6, C7, C8, C9, C10, C11, C12: 0.1µF; STD_DDW_CAP
C13, C14: 10µF; STD_DDW_PCAP
U4: 74LS04; STD_DDW_DIP14
U5, U7, U8: 74F32; STD_DDW_DIP14
U6: 74LS07; STD_DDW_DIP14
U17: 74LS08; STD_DDW_DIP14

Connections:
GND: C1.2, C2.2, C3.2, C4.2, C5.2, C6.2, C7.2, C8.2, C9.2, C10.2, C11.2, C12.2, C13.2, C14.2, U4.7 (GND), U5.7 (GND), U6.7 (GND), U7.7 (GND), U8.7 (GND), U17.7 (GND); also elsewhere on the board
VCC: C1.1, C2.1, C3.1, C4.1, C5.1, C6.1, C7.1, C8.1, C9.1, C10.1, C11.1, C12.1, C13.1, C14.1, U4.14 (VCC), U5.14 (VCC), U6.14 (VCC), U7.14 (VCC), U8.14 (VCC), U17.14 (VCC); also elsewhere on the board

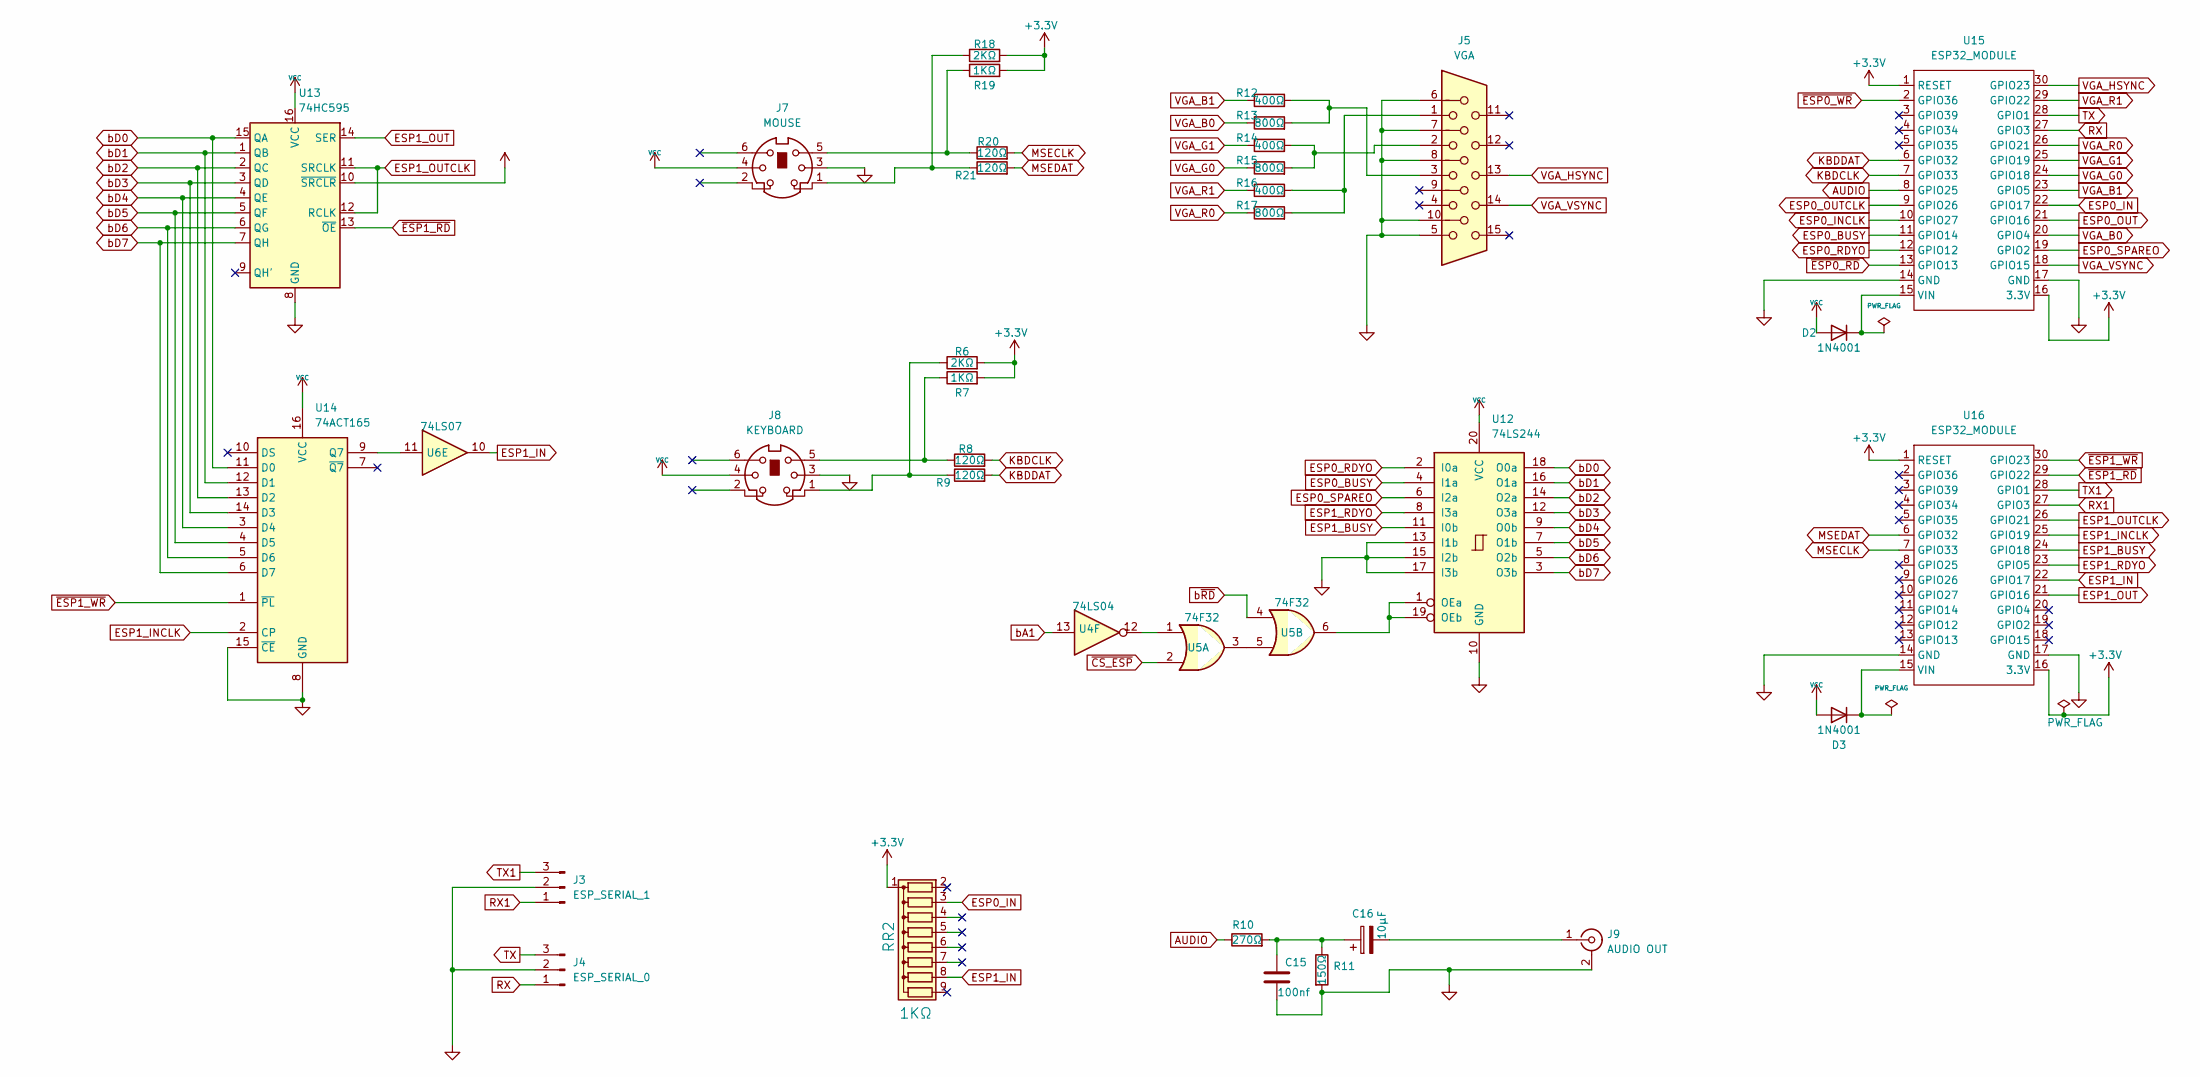
[picture p178: schematic esp.kicad_sch, ISA DUAL ESP32]

Parts:
C15: 100nf; STD_DDW_CAP
C16: 10µF; STD_DDW_PCAP
D2, D3: 1N4001; D_DO-41_SOD81_P10.16mm_Horizontal
J3: ESP_SERIAL_1; STD_DDW_PINHEAD_V_1x03
J4: ESP_SERIAL_0; STD_DDW_PINHEAD_V_1x03
J5: VGA; STD_DDW_VGA
J7: MOUSE; PS2_DIN
J8: KEYBOARD; PS2_DIN
J9: AUDIO OUT; STD_DDW_RCA
R6, R18: 2KΩ; STD_DDW_RESISTOR
R7, R19: 1KΩ; STD_DDW_RESISTOR
R8, R9, R20, R21: 120Ω; STD_DDW_RESISTOR
R10: 270Ω; STD_DDW_RESISTOR
R11: 150Ω; STD_DDW_RESISTOR
R12, R14, R16: 400Ω; STD_DDW_RESISTOR
R13, R15, R17: 800Ω; STD_DDW_RESISTOR
RR2: 1KΩ; R_Array_SIP9
U4: 74LS04; STD_DDW_DIP14
U5: 74F32; STD_DDW_DIP14
U6: 74LS07; STD_DDW_DIP14
U12: 74LS244; STD_DDW_DIP20
U13: 74HC595; STD_DDW_DIP16
U14: 74ACT165; STD_DDW_DIP16
U15, U16: ESP32_MODULE; ESP32_Module

Connections:
+3.3V: R6.2, R7.2, R18.2, R19.2, RR2.1 (common), U15.1 (RESET), U15.16 (3.3V), U16.1 (RESET), U16.16 (3.3V)
AUDIO: R10.1, U15.8 (GPIO25)
ESP0_BUSY: U12.4 (I1a), U15.11 (GPIO14)
ESP0_IN: RR2.3 (R2), U15.22 (GPIO17); also elsewhere on the board
ESP0_INCLK: U15.10 (GPIO27); also elsewhere on the board
ESP0_OUT: U15.21 (GPIO16); also elsewhere on the board
ESP0_OUTCLK: U15.9 (GPIO26); also elsewhere on the board
ESP0_RDYO: U12.2 (I0a), U15.12 (GPIO12)
ESP0_SPAREO: U12.6 (I2a), U15.19 (GPIO2)
ESP1_BUSY: U12.11 (I0b), U16.24 (GPIO18)
ESP1_IN: RR2.8 (R7), U6.10, U16.22 (GPIO17)
ESP1_INCLK: U14.2 (CP), U16.25 (GPIO19)
ESP1_OUT: U13.14 (SER), U16.21 (GPIO16)
ESP1_OUTCLK: U13.11 (SRCLK), U13.12 (RCLK), U16.26 (GPIO21)
ESP1_RDYO: U12.8 (I3a), U16.23 (GPIO5)
GND: C15.2, J3.2, J4.2, J5.5, J5.6, J5.7, J5.8, J5.10, J7.3, J8.3, J9.2 (Ext), R11.2, U12.10 (GND), U12.13 (I1b), U12.15 (I2b), U12.17 (I3b), U13.8 (GND), U14.8 (GND), U14.15 (~CE), U15.14 (GND), U15.17 (GND), U16.14 (GND), U16.17 (GND); also elsewhere on the board
KBDCLK: R8.2, U15.7 (GPIO33)
KBDDAT: R9.2, U15.6 (GPIO32)
MSECLK: R20.2, U16.7 (GPIO33)
MSEDAT: R21.2, U16.6 (GPIO32)
unnamed: C15.1, C16.1, R10.2, R11.1
unnamed: D2.1 (K), U15.15 (VIN)
unnamed: D3.1 (K), U16.15 (VIN)
unnamed: J5.1, R16.2, R17.2
unnamed: J5.2, R14.2, R15.2
unnamed: J5.3, R12.2, R13.2
unnamed: J7.1, R18.1, R21.1
unnamed: J7.5, R19.1, R20.1
unnamed: J8.1, R6.1, R9.1
unnamed: J8.5, R7.1, R8.1
unnamed: C16.2, J9.1 (In)
unnamed: U4.12, U5.1
unnamed: U5.3, U5.5
unnamed: U5.6, U12.1 (OEa), U12.19 (OEb)
unnamed: U6.11, U14.9 (Q7)
RX: J4.1, U15.27 (GPIO3)
RX1: J3.1, U16.27 (GPIO3)
TX: J4.3, U15.28 (GPIO1)
TX1: J3.3, U16.28 (GPIO1)
VCC: D2.2 (A), D3.2 (A), J7.4, J8.4, U12.20 (VCC), U13.10 (~SRCLR), U13.16 (VCC), U14.16 (VCC); also elsewhere on the board
VGA_B0: R13.1, U15.20 (GPIO4)
VGA_B1: R12.1, U15.23 (GPIO5)
VGA_G0: R15.1, U15.24 (GPIO18)
VGA_G1: R14.1, U15.25 (GPIO19)
VGA_HSYNC: J5.13, U15.30 (GPIO23)
VGA_R0: R17.1, U15.26 (GPIO21)
VGA_R1: R16.1, U15.29 (GPIO22)
VGA_VSYNC: J5.14, U15.18 (GPIO15)
bA1: U4.13; also elsewhere on the board
bD0: U12.18 (O0a), U13.15 (QA), U14.11 (D0); also elsewhere on the board
bD1: U12.16 (O1a), U13.1 (QB), U14.12 (D1); also elsewhere on the board
bD2: U12.14 (O2a), U13.2 (QC), U14.13 (D2); also elsewhere on the board
bD3: U12.12 (O3a), U13.3 (QD), U14.14 (D3); also elsewhere on the board
bD4: U12.9 (O0b), U13.4 (QE), U14.3 (D4); also elsewhere on the board
bD5: U12.7 (O1b), U13.5 (QF), U14.4 (D5); also elsewhere on the board
bD6: U12.5 (O2b), U13.6 (QG), U14.5 (D6); also elsewhere on the board
bD7: U12.3 (O3b), U13.7 (QH), U14.6 (D7); also elsewhere on the board
b~RD: U5.4; also elsewhere on the board
~CS_ESP: U5.2; also elsewhere on the board
~ESP0_RD: U15.13 (GPIO13); also elsewhere on the board
~ESP0_WR: U15.2 (GPIO36); also elsewhere on the board
~ESP1_RD: U13.13 (~OE), U16.29 (GPIO22); also elsewhere on the board
~ESP1_WR: U14.1 (~PL), U16.30 (GPIO23); also elsewhere on the board

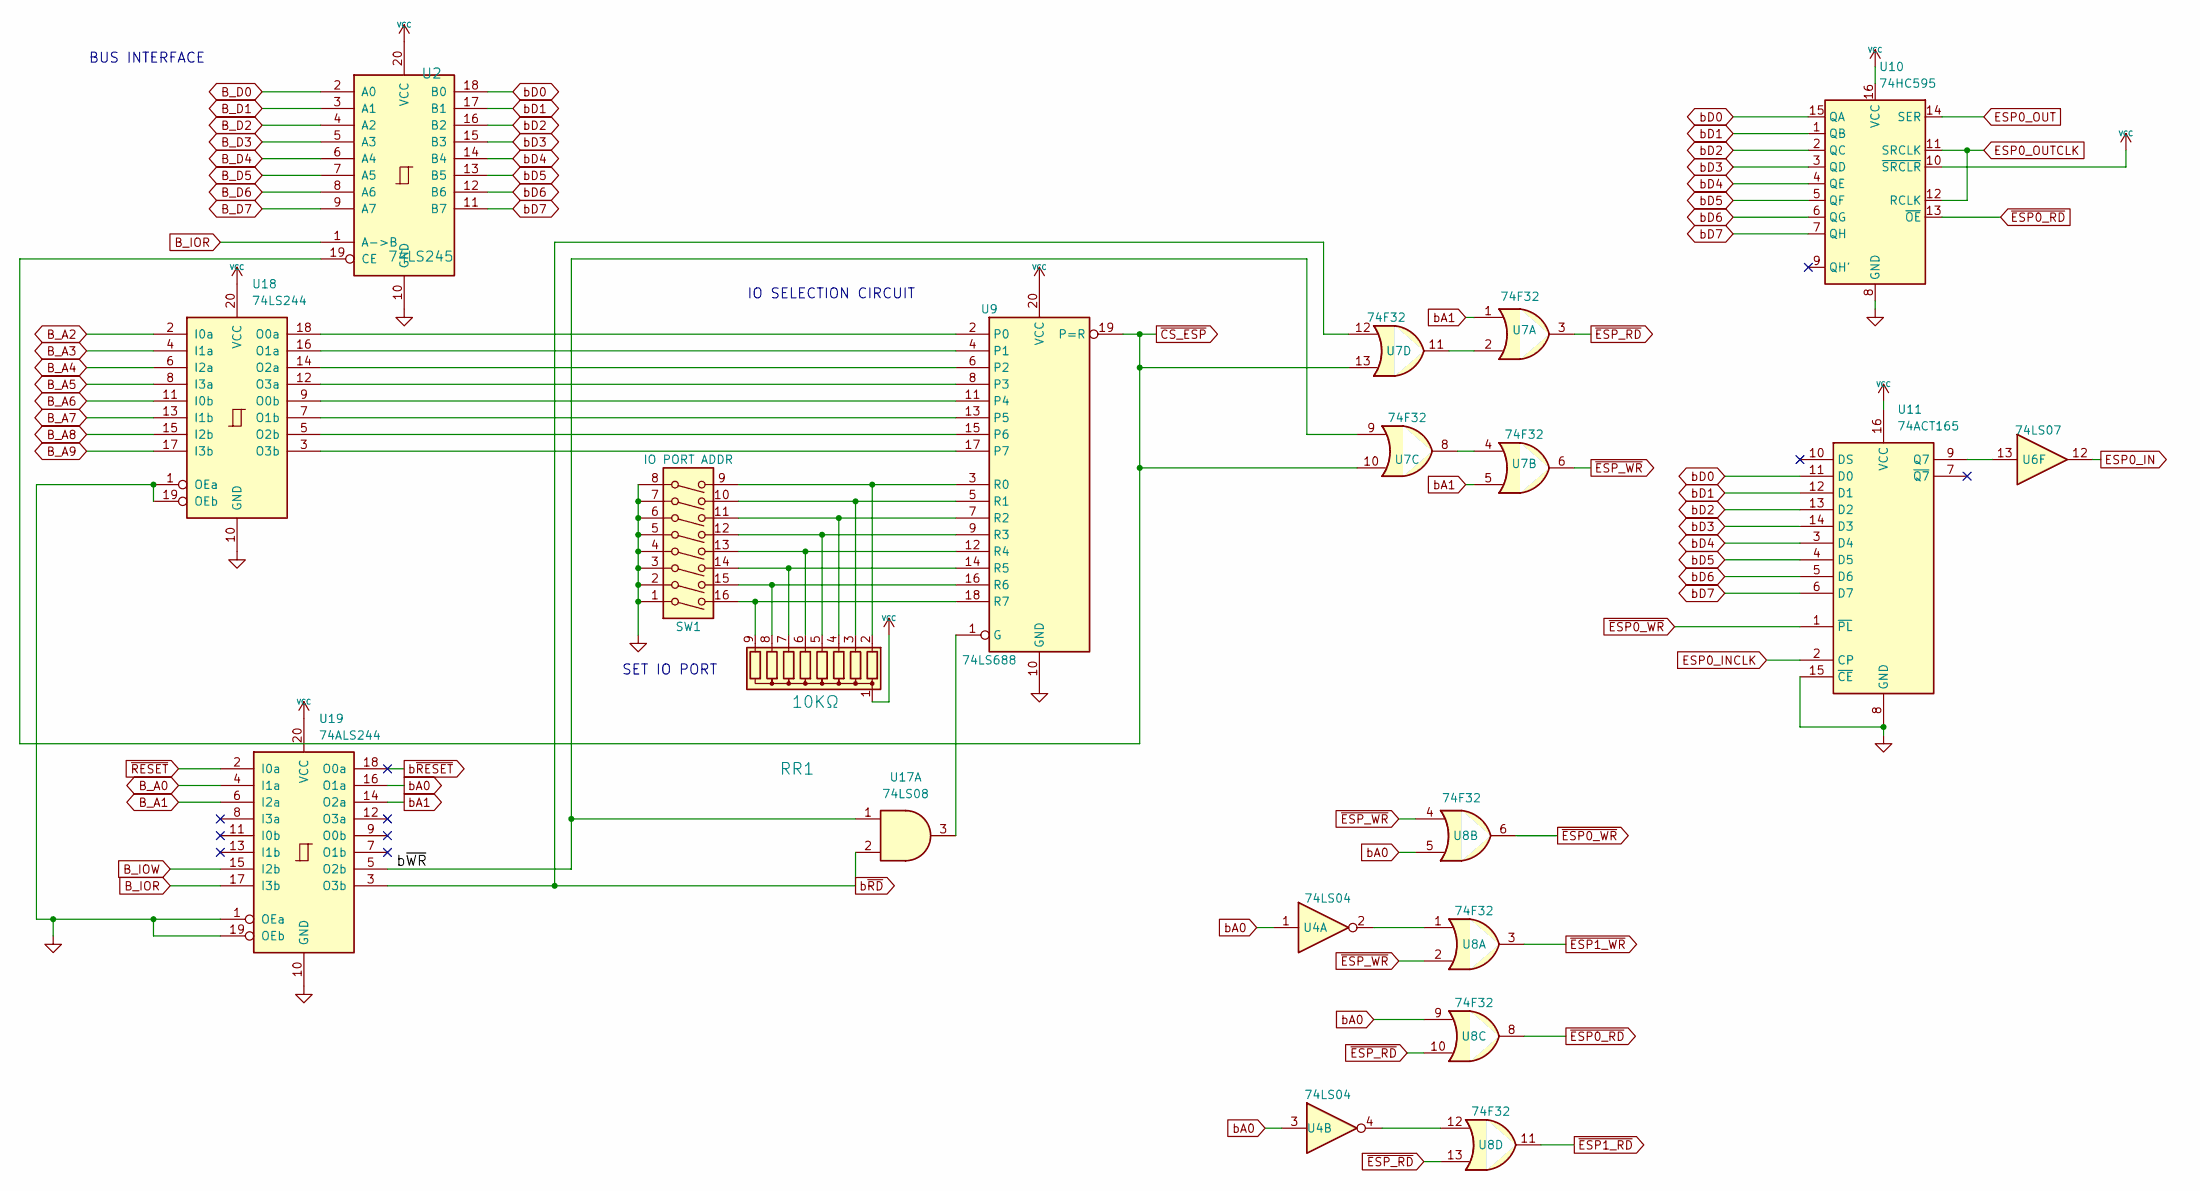
[picture p179: schematic CardSelect.kicad_sch, ISA DUAL ESP32]

Parts:
RR1: 10KΩ; R_Array_SIP9
SW1: IO PORT ADDR; STD_DDW_DIP16
U2: 74LS245; STD_DDW_DIP20
U4: 74LS04; STD_DDW_DIP14
U6: 74LS07; STD_DDW_DIP14
U7, U8: 74F32; STD_DDW_DIP14
U9: 74LS688; STD_DDW_DIP20
U10: 74HC595; STD_DDW_DIP16
U11: 74ACT165; STD_DDW_DIP16
U17: 74LS08; STD_DDW_DIP14
U18: 74LS244; STD_DDW_DIP20
U19: 74ALS244; STD_DDW_DIP20

Connections:
/CardSelect/b~WR: U7.9, U17.1, U19.5 (O2b)
B_A0: U19.4 (I1a); also elsewhere on the board
B_A1: U19.6 (I2a); also elsewhere on the board
B_A2: U18.2 (I0a); also elsewhere on the board
B_A3: U18.4 (I1a); also elsewhere on the board
B_A4: U18.6 (I2a); also elsewhere on the board
B_A5: U18.8 (I3a); also elsewhere on the board
B_A6: U18.11 (I0b); also elsewhere on the board
B_A7: U18.13 (I1b); also elsewhere on the board
B_A8: U18.15 (I2b); also elsewhere on the board
B_A9: U18.17 (I3b); also elsewhere on the board
B_D0: U2.2 (A0); also elsewhere on the board
B_D1: U2.3 (A1); also elsewhere on the board
B_D2: U2.4 (A2); also elsewhere on the board
B_D3: U2.5 (A3); also elsewhere on the board
B_D4: U2.6 (A4); also elsewhere on the board
B_D5: U2.7 (A5); also elsewhere on the board
B_D6: U2.8 (A6); also elsewhere on the board
B_D7: U2.9 (A7); also elsewhere on the board
B_IOR: U2.1 (A->B), U19.17 (I3b); also elsewhere on the board
B_IOW: U19.15 (I2b); also elsewhere on the board
ESP0_IN: U6.12; also elsewhere on the board
ESP0_INCLK: U11.2 (CP); also elsewhere on the board
ESP0_OUT: U10.14 (SER); also elsewhere on the board
ESP0_OUTCLK: U10.11 (SRCLK), U10.12 (RCLK); also elsewhere on the board
GND: SW1.1, SW1.2, SW1.3, SW1.4, SW1.5, SW1.6, SW1.7, SW1.8, U2.10 (GND), U9.10 (GND), U10.8 (GND), U11.8 (GND), U11.15 (~CE), U18.1 (OEa), U18.10 (GND), U18.19 (OEb), U19.1 (OEa), U19.10 (GND), U19.19 (OEb); also elsewhere on the board
unnamed: RR1.2 (R1), SW1.9, U9.3 (R0)
unnamed: RR1.3 (R2), SW1.10, U9.5 (R1)
unnamed: RR1.4 (R3), SW1.11, U9.7 (R2)
unnamed: RR1.5 (R4), SW1.12, U9.9 (R3)
unnamed: RR1.6 (R5), SW1.13, U9.12 (R4)
unnamed: RR1.7 (R6), SW1.14, U9.14 (R5)
unnamed: RR1.8 (R7), SW1.15, U9.16 (R6)
unnamed: RR1.9 (R8), SW1.16, U9.18 (R7)
unnamed: U4.2, U8.1
unnamed: U4.4, U8.12
unnamed: U7.4, U7.8
unnamed: U7.2, U7.11
unnamed: U9.1 (G), U17.3
unnamed: U6.13, U11.9 (Q7)
unnamed: U9.2 (P0), U18.18 (O0a)
unnamed: U9.11 (P4), U18.9 (O0b)
unnamed: U9.4 (P1), U18.16 (O1a)
unnamed: U9.13 (P5), U18.7 (O1b)
unnamed: U9.6 (P2), U18.14 (O2a)
unnamed: U9.15 (P6), U18.5 (O2b)
unnamed: U9.8 (P3), U18.12 (O3a)
unnamed: U9.17 (P7), U18.3 (O3b)
VCC: RR1.1 (common), U2.20 (VCC), U9.20 (VCC), U10.10 (~SRCLR), U10.16 (VCC), U11.16 (VCC), U18.20 (VCC), U19.20 (VCC); also elsewhere on the board
bA0: U4.1, U4.3, U8.5, U8.9, U19.16 (O1a)
bA1: U7.1, U7.5, U19.14 (O2a); also elsewhere on the board
bD0: U2.18 (B0), U10.15 (QA), U11.11 (D0); also elsewhere on the board
bD1: U2.17 (B1), U10.1 (QB), U11.12 (D1); also elsewhere on the board
bD2: U2.16 (B2), U10.2 (QC), U11.13 (D2); also elsewhere on the board
bD3: U2.15 (B3), U10.3 (QD), U11.14 (D3); also elsewhere on the board
bD4: U2.14 (B4), U10.4 (QE), U11.3 (D4); also elsewhere on the board
bD5: U2.13 (B5), U10.5 (QF), U11.4 (D5); also elsewhere on the board
bD6: U2.12 (B6), U10.6 (QG), U11.5 (D6); also elsewhere on the board
bD7: U2.11 (B7), U10.7 (QH), U11.6 (D7); also elsewhere on the board
b~RD: U7.12, U17.2, U19.3 (O3b); also elsewhere on the board
b~RESET: U19.18 (O0a)
~CS_ESP: U2.19 (CE), U7.10, U7.13, U9.19 (P=R); also elsewhere on the board
~ESP0_RD: U8.8, U10.13 (~OE); also elsewhere on the board
~ESP0_WR: U8.6, U11.1 (~PL); also elsewhere on the board
~ESP1_RD: U8.11; also elsewhere on the board
~ESP1_WR: U8.3; also elsewhere on the board
~ESP_RD: U7.3, U8.10, U8.13
~ESP_WR: U7.6, U8.2, U8.4
~RESET: U19.2 (I0a); also elsewhere on the board

Notes on the sheet:
SET IO PORT
IO SELECTION CIRCUIT
BUS INTERFACE
