danwerner21/ISA_IO/DUALESP/HARDWARE/DUALESP.kicad_pcb

## KiCad design DUALESP/HARDWARE/DUALESP.kicad_pcb (continued)

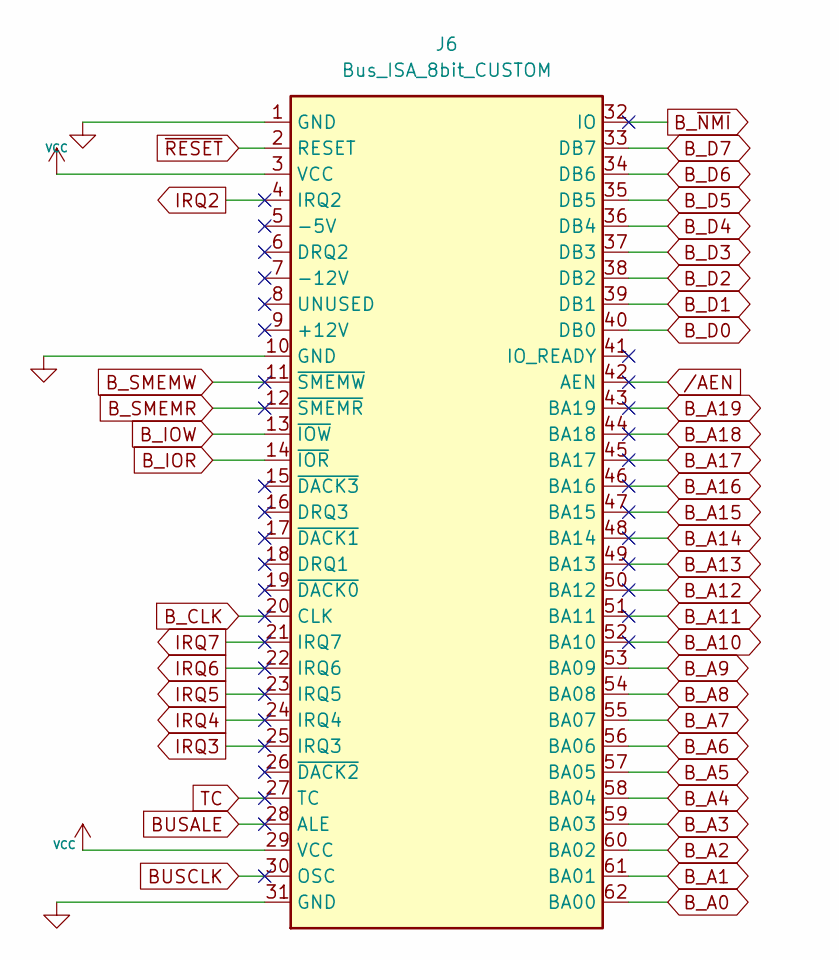
[picture p180: schematic ISA.kicad_sch, ISA DUAL ESP32]

Parts:
J6: Bus_ISA_8bit_CUSTOM; BUSEDGE_XT

Connections:
BUSALE: J6.28 (ALE)
BUSCLK: J6.30 (OSC)
B_A0: J6.62 (BA00); also elsewhere on the board
B_A1: J6.61 (BA01); also elsewhere on the board
B_A2: J6.60 (BA02); also elsewhere on the board
B_A3: J6.59 (BA03); also elsewhere on the board
B_A4: J6.58 (BA04); also elsewhere on the board
B_A5: J6.57 (BA05); also elsewhere on the board
B_A6: J6.56 (BA06); also elsewhere on the board
B_A7: J6.55 (BA07); also elsewhere on the board
B_A8: J6.54 (BA08); also elsewhere on the board
B_A9: J6.53 (BA09); also elsewhere on the board
B_A10: J6.52 (BA10)
B_A11: J6.51 (BA11)
B_A12: J6.50 (BA12)
B_A13: J6.49 (BA13)
B_A14: J6.48 (BA14)
B_A15: J6.47 (BA15)
B_A16: J6.46 (BA16)
B_A17: J6.45 (BA17)
B_A18: J6.44 (BA18)
B_A19: J6.43 (BA19)
B_CLK: J6.20 (CLK)
B_D0: J6.40 (DB0); also elsewhere on the board
B_D1: J6.39 (DB1); also elsewhere on the board
B_D2: J6.38 (DB2); also elsewhere on the board
B_D3: J6.37 (DB3); also elsewhere on the board
B_D4: J6.36 (DB4); also elsewhere on the board
B_D5: J6.35 (DB5); also elsewhere on the board
B_D6: J6.34 (DB6); also elsewhere on the board
B_D7: J6.33 (DB7); also elsewhere on the board
B_IOR: J6.14 (~IOR); also elsewhere on the board
B_IOW: J6.13 (~IOW); also elsewhere on the board
B_SMEMR: J6.12 (~SMEMR)
B_SMEMW: J6.11 (~SMEMW)
B_~NMI: J6.32 (IO)
GND: J6.1 (GND), J6.10 (GND), J6.31 (GND); also elsewhere on the board
IRQ2: J6.4 (IRQ2)
IRQ3: J6.25 (IRQ3)
IRQ4: J6.24 (IRQ4)
IRQ5: J6.23 (IRQ5)
IRQ6: J6.22 (IRQ6)
IRQ7: J6.21 (IRQ7)
TC: J6.27 (TC)
VCC: J6.3 (VCC), J6.29 (VCC); also elsewhere on the board
/AEN: J6.42 (AEN)
~RESET: J6.2 (RESET); also elsewhere on the board

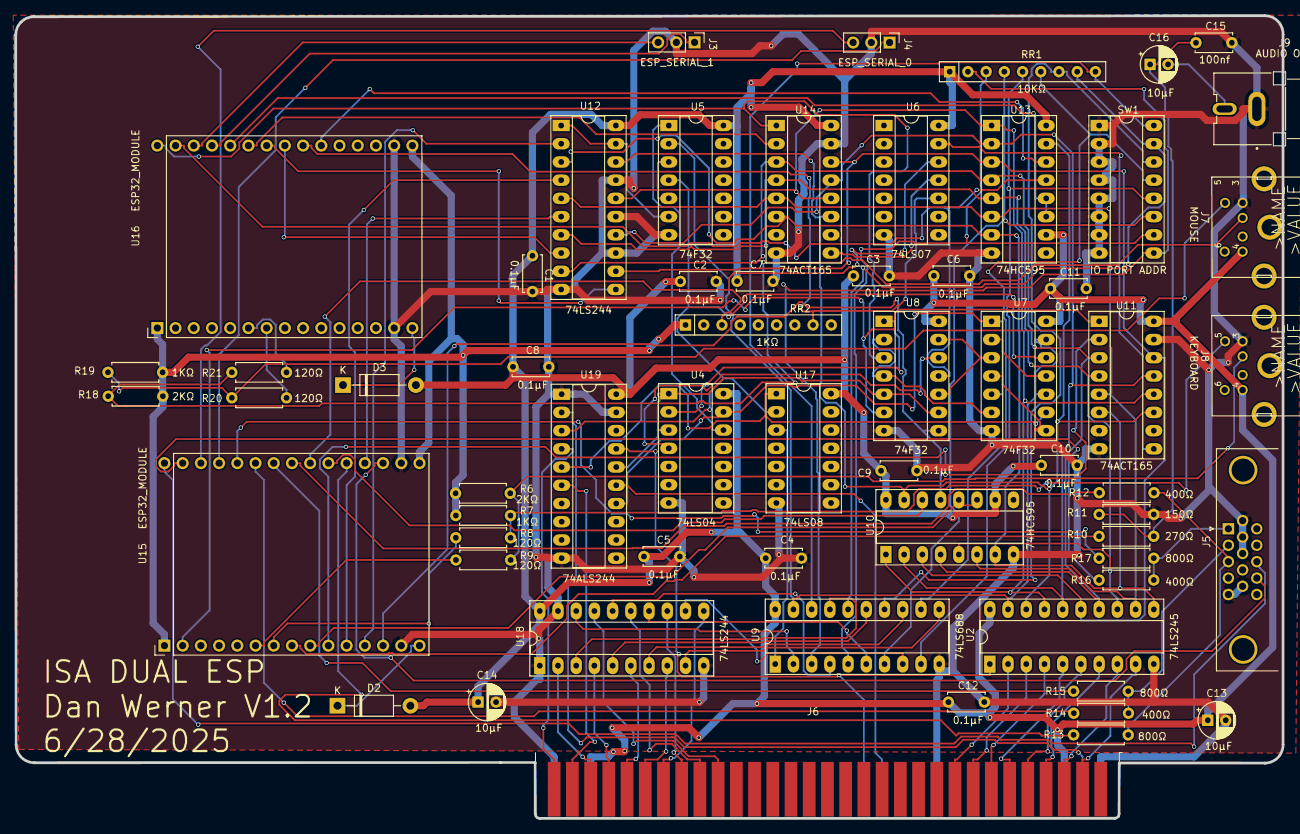
[picture p181: board DUALESP.kicad_pcb from above]

Board: 2 copper layers, 176.7 x 111.9 mm, 61 parts (0 on the bottom side), 110 nets.
