danwerner21/ISA_IO/MULTIIO/MULTIIO/MULTIIO.kicad_pcb

## KiCad design MULTIIO/MULTIIO/MULTIIO.kicad_pcb (2025-07-20)

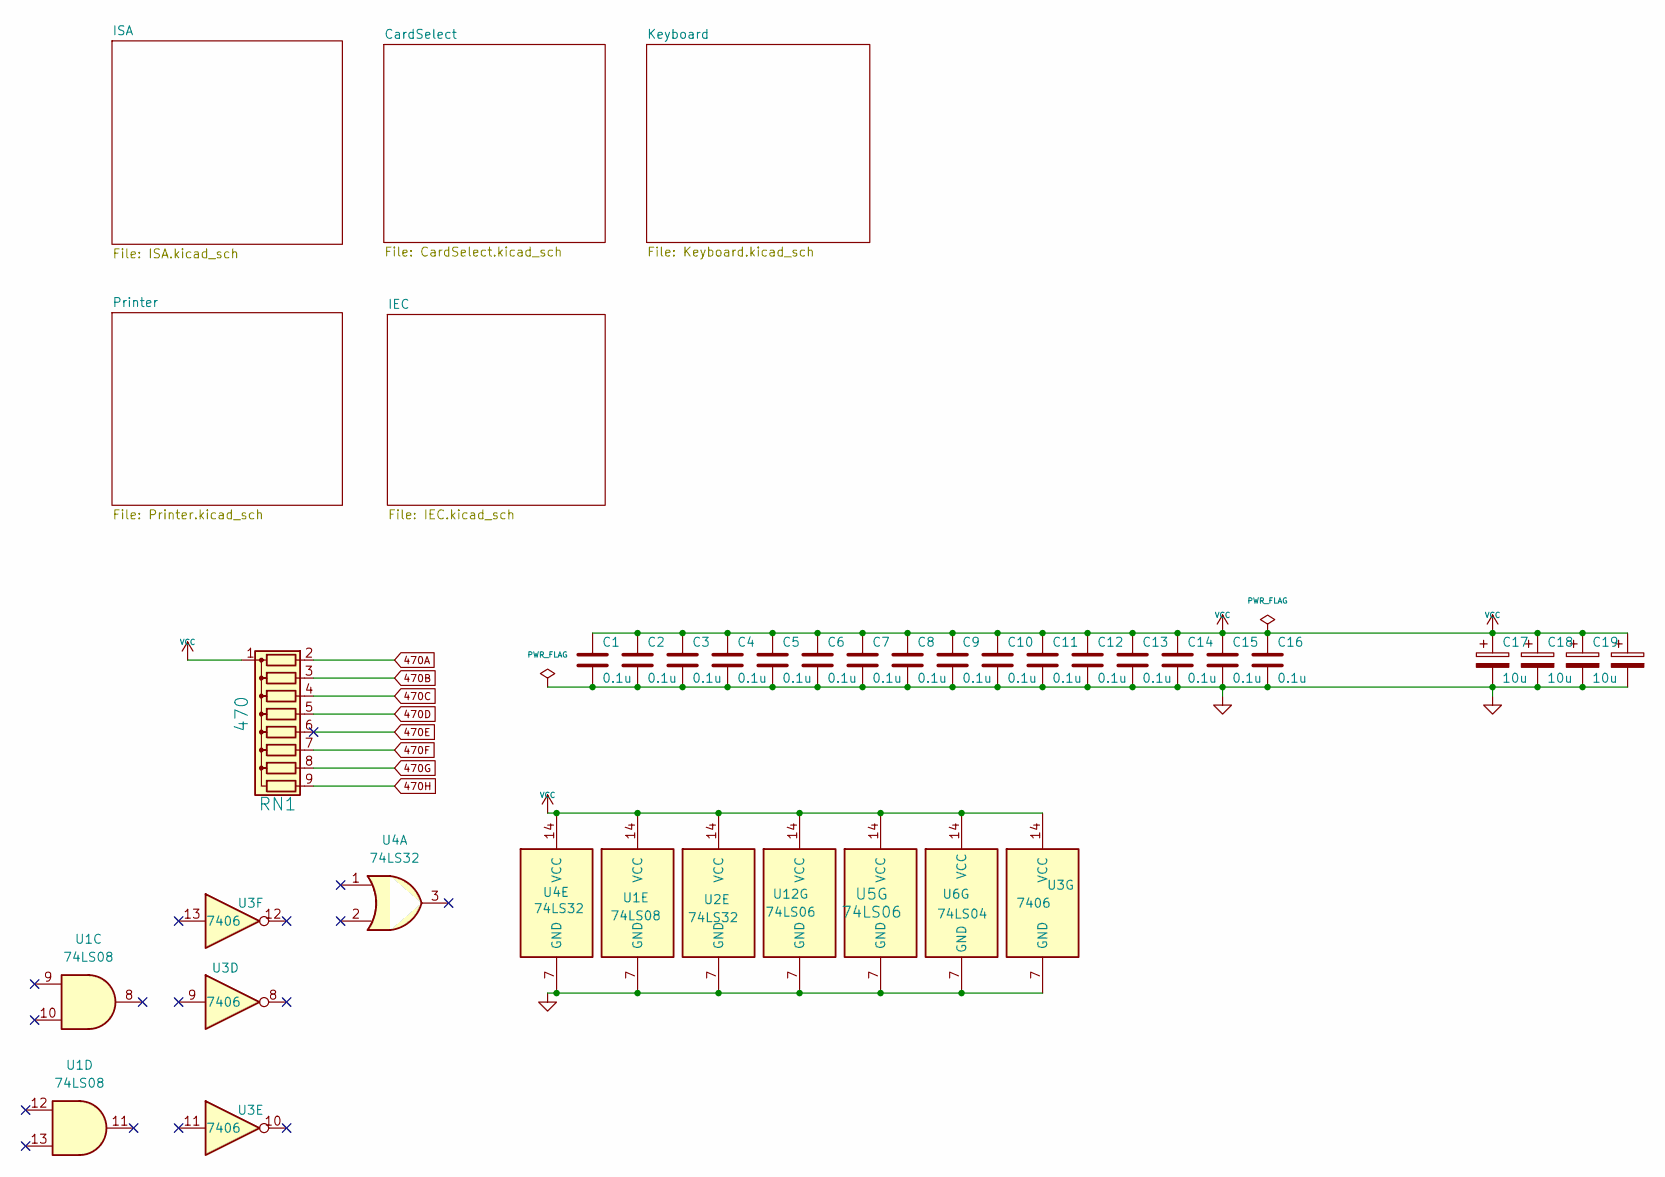
[picture p182: schematic MULTIIO.kicad_sch, ISA MULTI IO]

Parts:
C1, C2, C3, C4, C5, C6, C7, C8, C9, C10, C11, C12, C13, C14, C15, C16: 0.1u; STD_DDW_CAP
C17, C18, C19, C20: 10u; STD_DDW_PCAP
RN1: 470; STD_DDW_SIP9
U1: 74LS08; STD_DDW_DIP14
U2, U4: 74LS32; STD_DDW_DIP14
U3: 7406; STD_DDW_DIP14
U5, U12: 74LS06; STD_DDW_DIP14
U6: 74LS04; STD_DDW_DIP14

Connections:
470A: RN1.2 (R1); also elsewhere on the board
470B: RN1.3 (R2); also elsewhere on the board
470C: RN1.4 (R3); also elsewhere on the board
470D: RN1.5 (R4); also elsewhere on the board
470E: RN1.6 (R5)
470F: RN1.7 (R6); also elsewhere on the board
470G: RN1.8 (R7); also elsewhere on the board
470H: RN1.9 (R8); also elsewhere on the board
GND: C1.2, C2.2, C3.2, C4.2, C5.2, C6.2, C7.2, C8.2, C9.2, C10.2, C11.2, C12.2, C13.2, C14.2, C15.2, C16.2, C17.2, C18.2, C19.2, C20.2, U1.7 (GND), U2.7 (GND), U3.7 (GND), U4.7 (GND), U5.7 (GND), U6.7 (GND), U12.7 (GND); also elsewhere on the board
VCC: C1.1, C2.1, C3.1, C4.1, C5.1, C6.1, C7.1, C8.1, C9.1, C10.1, C11.1, C12.1, C13.1, C14.1, C15.1, C16.1, C17.1, C18.1, C19.1, C20.1, RN1.1 (common), U1.14 (VCC), U2.14 (VCC), U3.14 (VCC), U4.14 (VCC), U5.14 (VCC), U6.14 (VCC), U12.14 (VCC); also elsewhere on the board

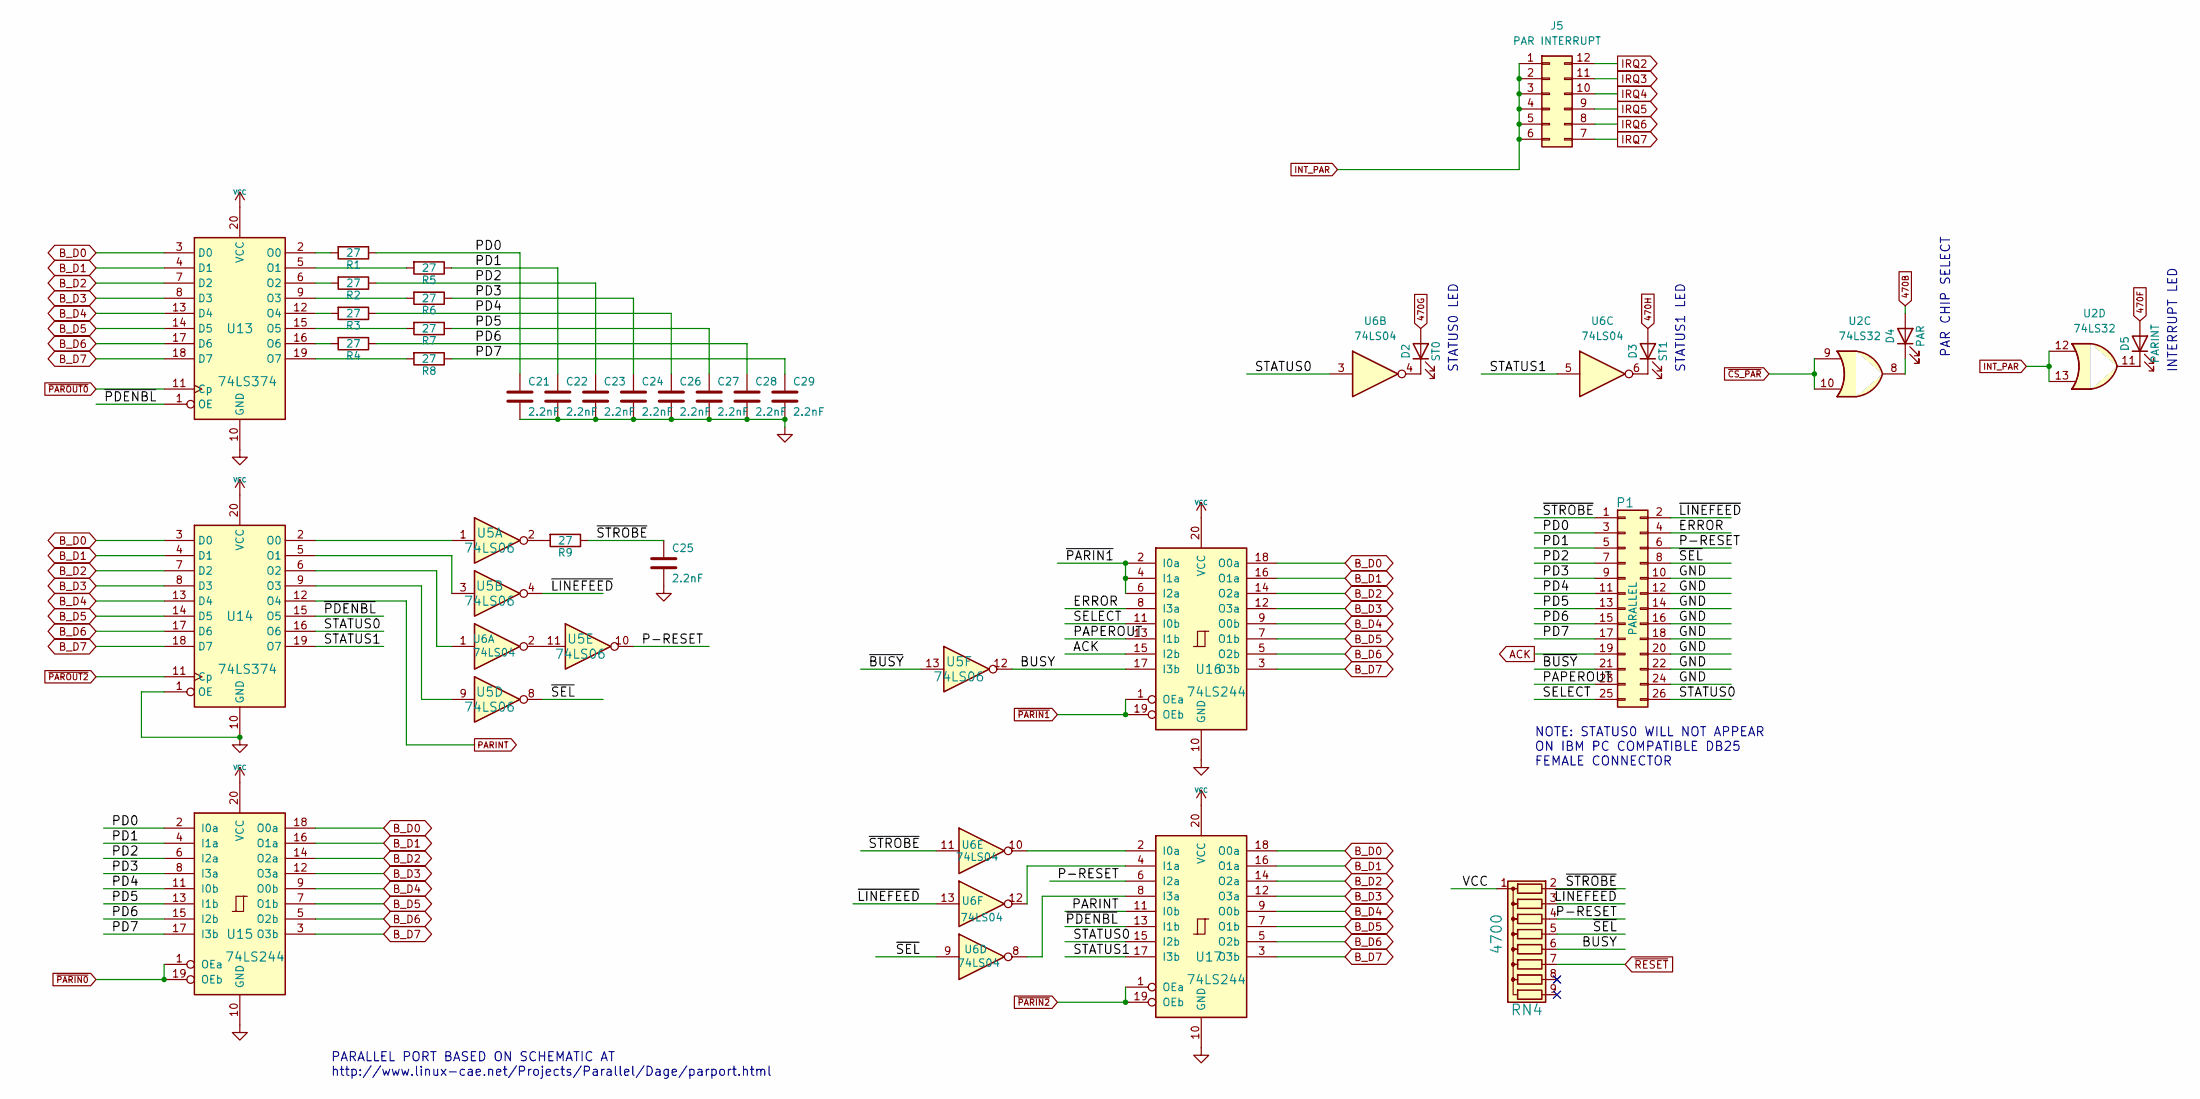
[picture p183: schematic Printer.kicad_sch, ISA MULTI IO]

Parts:
C21, C22, C23, C24, C25, C26, C27, C28, C29: 2.2nF; STD_DDW_CAP
D2: ST0; STD_DDW_LED5
D3: ST1; STD_DDW_LED5
D4: PAR; STD_DDW_LED5
D5: PARINT; STD_DDW_LED5
J5: PAR INTERRUPT; STD_DDW_PINHEAD_V_2x06
P1: PARALLEL; STD_DDW_PINHEAD_V_2x13
R1, R2, R3, R4, R5, R6, R7, R8, R9: 27; STD_DDW_RESISTOR
RN4: 4700; STD_DDW_SIP9
U2: 74LS32; STD_DDW_DIP14
U5: 74LS06; STD_DDW_DIP14
U6: 74LS04; STD_DDW_DIP14
U13, U14: 74LS374; STD_DDW_DIP20
U15, U16, U17: 74LS244; STD_DDW_DIP20

Connections:
470B: D4.2 (A); also elsewhere on the board
470F: D5.2 (A); also elsewhere on the board
470G: D2.2 (A); also elsewhere on the board
470H: D3.2 (A); also elsewhere on the board
/Printer/BUSY: RN4.6 (R5), U5.12, U16.17 (I3b)
/Printer/ERROR: P1.4, U16.8 (I3a)
/Printer/P-RESET: P1.6, RN4.4 (R3), U5.10, U17.6 (I2a)
/Printer/PAPEROUT: P1.23, U16.13 (I1b)
/Printer/PD0: C21.1, P1.3, R1.1, U15.2 (I0a)
/Printer/PD1: C22.1, P1.5, R5.1, U15.4 (I1a)
/Printer/PD2: C23.1, P1.7, R2.1, U15.6 (I2a)
/Printer/PD3: C24.1, P1.9, R6.1, U15.8 (I3a)
/Printer/PD4: C26.1, P1.11, R3.1, U15.11 (I0b)
/Printer/PD5: C27.1, P1.13, R7.1, U15.13 (I1b)
/Printer/PD6: C28.1, P1.15, R4.1, U15.15 (I2b)
/Printer/PD7: C29.1, P1.17, R8.1, U15.17 (I3b)
/Printer/SELECT: P1.25, U16.11 (I0b)
/Printer/STATUS0: P1.26, U6.3, U14.16 (O6), U17.15 (I2b)
/Printer/STATUS1: U6.5, U14.19 (O7), U17.17 (I3b)
/Printer/~BUSY: P1.21, U5.13
/Printer/~LINEFEED: P1.2, RN4.3 (R2), U5.4, U6.13
/Printer/~PDENBL: U13.1 (OE), U14.15 (O5), U17.13 (I1b)
/Printer/~SEL: P1.8, RN4.5 (R4), U5.8, U6.9
/Printer/~STROBE: C25.1, P1.1, R9.1, RN4.2 (R1), U6.11
ACK: P1.19, U16.15 (I2b)
B_D0: U13.3 (D0), U14.3 (D0), U15.18 (O0a), U16.18 (O0a), U17.18 (O0a); also elsewhere on the board
B_D1: U13.4 (D1), U14.4 (D1), U15.16 (O1a), U16.16 (O1a), U17.16 (O1a); also elsewhere on the board
B_D2: U13.7 (D2), U14.7 (D2), U15.14 (O2a), U16.14 (O2a), U17.14 (O2a); also elsewhere on the board
B_D3: U13.8 (D3), U14.8 (D3), U15.12 (O3a), U16.12 (O3a), U17.12 (O3a); also elsewhere on the board
B_D4: U13.13 (D4), U14.13 (D4), U15.9 (O0b), U16.9 (O0b), U17.9 (O0b); also elsewhere on the board
B_D5: U13.14 (D5), U14.14 (D5), U15.7 (O1b), U16.7 (O1b), U17.7 (O1b); also elsewhere on the board
B_D6: U13.17 (D6), U14.17 (D6), U15.5 (O2b), U16.5 (O2b), U17.5 (O2b); also elsewhere on the board
B_D7: U13.18 (D7), U14.18 (D7), U15.3 (O3b), U16.3 (O3b), U17.3 (O3b); also elsewhere on the board
GND: C21.2, C22.2, C23.2, C24.2, C25.2, C26.2, C27.2, C28.2, C29.2, P1.10, P1.12, P1.14, P1.16, P1.18, P1.20, P1.22, P1.24, U13.10 (GND), U14.1 (OE), U14.10 (GND), U15.10 (GND), U16.10 (GND), U17.10 (GND); also elsewhere on the board
INT_PAR: J5.1, J5.2, J5.3, J5.4, J5.5, J5.6, U2.12, U2.13
IRQ2: J5.12; also elsewhere on the board
IRQ3: J5.11; also elsewhere on the board
IRQ4: J5.10; also elsewhere on the board
IRQ5: J5.9; also elsewhere on the board
IRQ6: J5.8; also elsewhere on the board
IRQ7: J5.7; also elsewhere on the board
unnamed: D2.1 (K), U6.4
unnamed: D3.1 (K), U6.6
unnamed: D4.1 (K), U2.8
unnamed: D5.1 (K), U2.11
unnamed: R9.2, U5.2
unnamed: U5.11, U6.2
unnamed: R1.2, U13.2 (O0)
unnamed: R5.2, U13.5 (O1)
unnamed: R2.2, U13.6 (O2)
unnamed: R6.2, U13.9 (O3)
unnamed: R3.2, U13.12 (O4)
unnamed: R7.2, U13.15 (O5)
unnamed: R4.2, U13.16 (O6)
unnamed: R8.2, U13.19 (O7)
unnamed: U5.1, U14.2 (O0)
unnamed: U5.3, U14.5 (O1)
unnamed: U6.1, U14.6 (O2)
unnamed: U5.9, U14.9 (O3)
unnamed: U6.10, U17.2 (I0a)
unnamed: U6.12, U17.4 (I1a)
unnamed: U6.8, U17.8 (I3a)
PARINT: U14.12 (O4), U17.11 (I0b)
VCC: RN4.1 (common), U13.20 (VCC), U14.20 (VCC), U15.20 (VCC), U16.20 (VCC), U17.20 (VCC); also elsewhere on the board
~CS_PAR: U2.9, U2.10; also elsewhere on the board
~PARIN0: U15.1 (OEa), U15.19 (OEb); also elsewhere on the board
~PARIN1: U16.1 (OEa), U16.2 (I0a), U16.4 (I1a), U16.6 (I2a), U16.19 (OEb); also elsewhere on the board
~PARIN2: U17.1 (OEa), U17.19 (OEb); also elsewhere on the board
~PAROUT0: U13.11 (Cp); also elsewhere on the board
~PAROUT2: U14.11 (Cp); also elsewhere on the board
~RESET: RN4.7 (R6); also elsewhere on the board

Notes on the sheet:
NOTE: STATUS0 WILL NOT APPEAR ON IBM PC COMPATIBLE DB25 FEMALE CONNECTOR
STATUS0 LED
INTERRUPT LED
STATUS1 LED
PARALLEL PORT BASED ON SCHEMATIC AT http://www.linux-cae.net/Projects/Parallel/Dage/parport.html
PAR CHIP SELECT

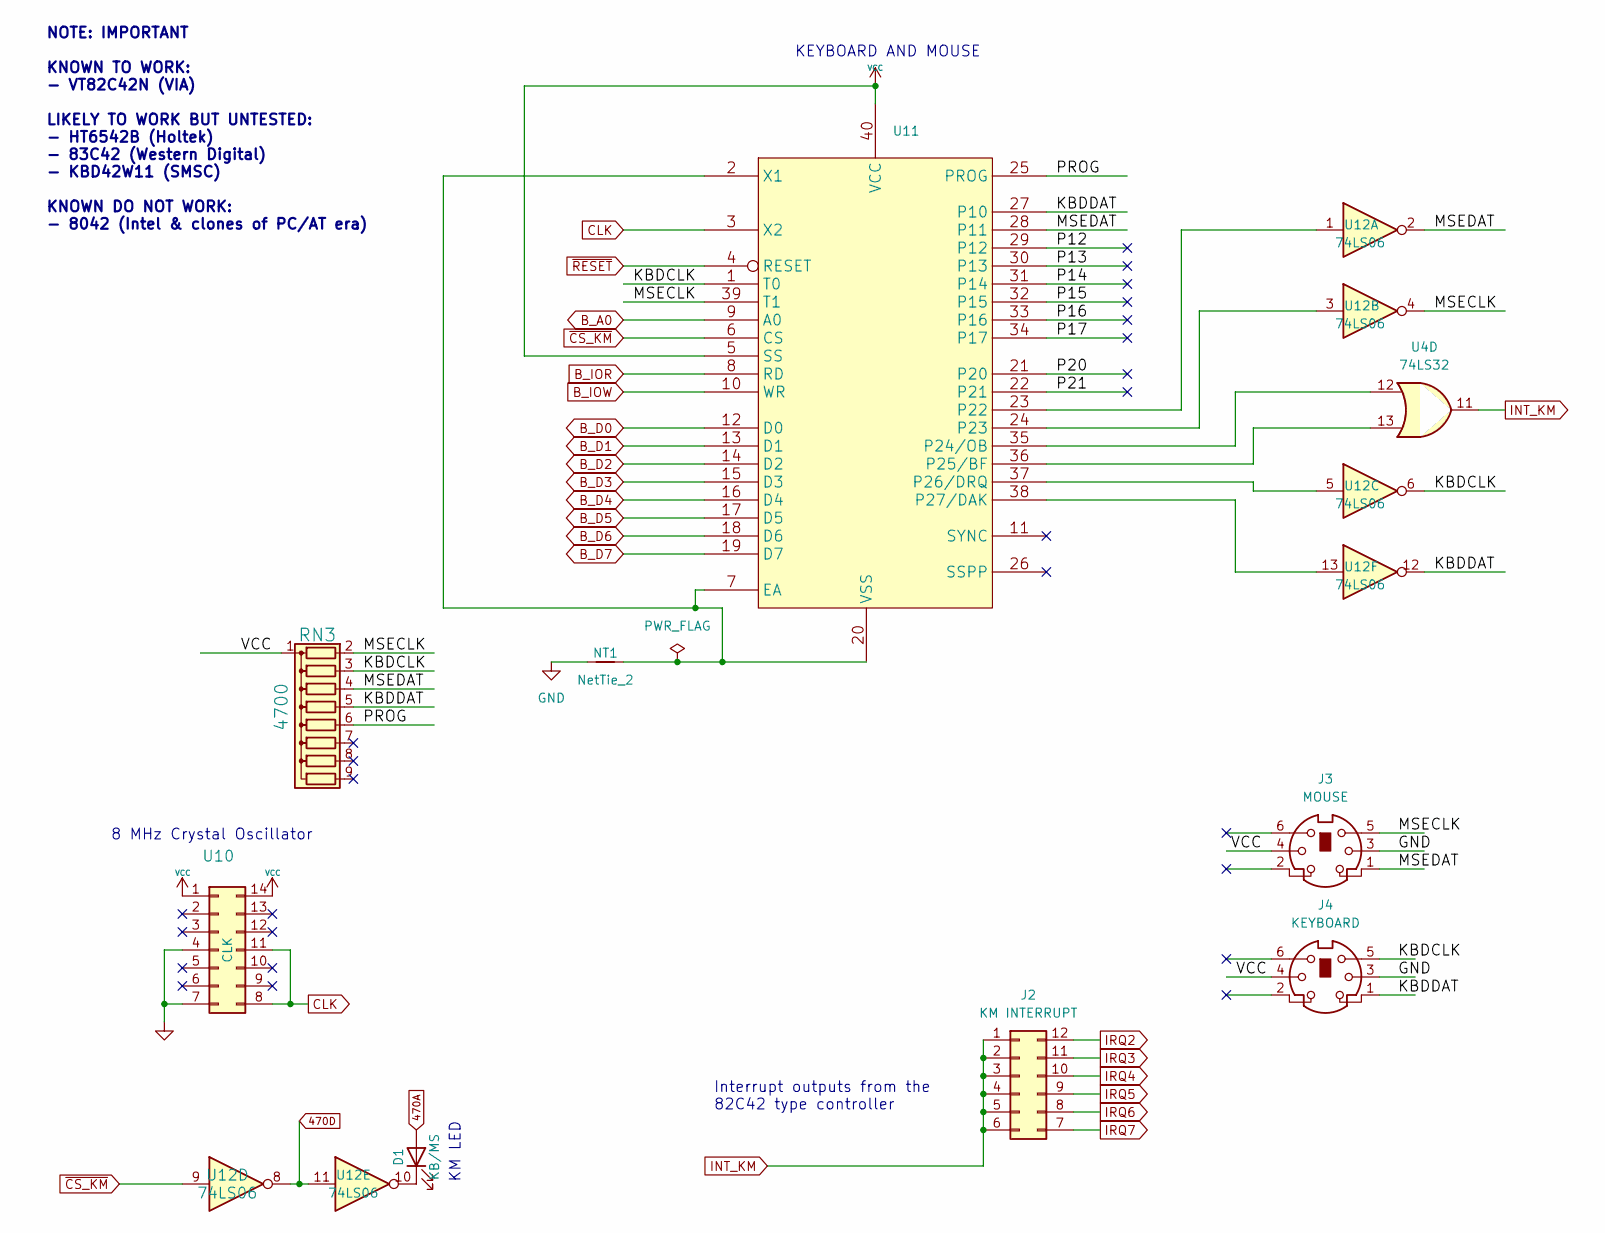
[picture p184: schematic Keyboard.kicad_sch, ISA MULTI IO]

Parts:
D1: KB/MS; STD_DDW_LED5
J2: KM INTERRUPT; STD_DDW_PINHEAD_V_2x06
J3: MOUSE; PS2_DIN
J4: KEYBOARD; PS2_DIN
NT1: NetTie_2; NetTie-2_THT_Pad0.3mm
RN3: 4700; STD_DDW_SIP9
U4: 74LS32; STD_DDW_DIP14
U10: CLK; STD_DDW_DIP14
U11: STD_DDW_DIP40
U12: 74LS06; STD_DDW_DIP14

Connections:
470A: D1.2 (A); also elsewhere on the board
470D: U12.8, U12.11; also elsewhere on the board
/Keyboard/KBDCLK: J4.5, RN3.3 (R2), U11.1 (T0), U12.6
/Keyboard/KBDDAT: J4.1, RN3.5 (R4), U11.27 (P10), U12.12
/Keyboard/MSECLK: J3.5, RN3.2 (R1), U11.39 (T1), U12.4
/Keyboard/MSEDAT: J3.1, RN3.4 (R3), U11.28 (P11), U12.2
/Keyboard/P12: U11.29 (P12)
/Keyboard/P13: U11.30 (P13)
/Keyboard/P14: U11.31 (P14)
/Keyboard/P15: U11.32 (P15)
/Keyboard/P16: U11.33 (P16)
/Keyboard/P17: U11.34 (P17)
/Keyboard/P20: U11.21 (P20)
/Keyboard/P21: U11.22 (P21)
/Keyboard/PROG: RN3.6 (R5), U11.25 (PROG)
B_A0: U11.9 (A0); also elsewhere on the board
B_D0: U11.12 (D0); also elsewhere on the board
B_D1: U11.13 (D1); also elsewhere on the board
B_D2: U11.14 (D2); also elsewhere on the board
B_D3: U11.15 (D3); also elsewhere on the board
B_D4: U11.16 (D4); also elsewhere on the board
B_D5: U11.17 (D5); also elsewhere on the board
B_D6: U11.18 (D6); also elsewhere on the board
B_D7: U11.19 (D7); also elsewhere on the board
B_IOR: U11.8 (RD); also elsewhere on the board
B_IOW: U11.10 (WR); also elsewhere on the board
CLK: U10.8, U10.11, U11.3 (X2)
GND: J3.3, J4.3, NT1.1, U10.4, U10.7; also elsewhere on the board
INT_KM: J2.1, J2.2, J2.3, J2.4, J2.5, J2.6, U4.11
IRQ2: J2.12; also elsewhere on the board
IRQ3: J2.11; also elsewhere on the board
IRQ4: J2.10; also elsewhere on the board
IRQ5: J2.9; also elsewhere on the board
IRQ6: J2.8; also elsewhere on the board
IRQ7: J2.7; also elsewhere on the board
unnamed: D1.1 (K), U12.10
unnamed: NT1.2, U11.2 (X1), U11.7 (EA), U11.20 (VSS)
unnamed: U11.23 (P22), U12.1
unnamed: U11.24 (P23), U12.3
unnamed: U4.12, U11.35 (P24/OB)
unnamed: U4.13, U11.36 (P25/BF)
unnamed: U11.37 (P26/DRQ), U12.5
unnamed: U11.38 (P27/DAK), U12.13
VCC: J3.4, J4.4, RN3.1 (common), U10.1, U10.14, U11.5 (SS), U11.40 (VCC); also elsewhere on the board
~CS_KM: U11.6 (CS), U12.9; also elsewhere on the board
~RESET: U11.4 (RESET); also elsewhere on the board

Notes on the sheet:
KM LED
NOTE: IMPORTANT KNOWN TO WORK: - VT82C42N (VIA) LIKELY TO WORK BUT UNTESTED: - HT6542B (Holtek) - 83C42 (Western Digital) - KBD42W11 (SMSC) KNOWN DO NOT WORK: - 8042 (Intel & clones of PC/AT era)
KEYBOARD AND MOUSE
Interrupt outputs from the 82C42 type controller
8 MHz Crystal Oscillator

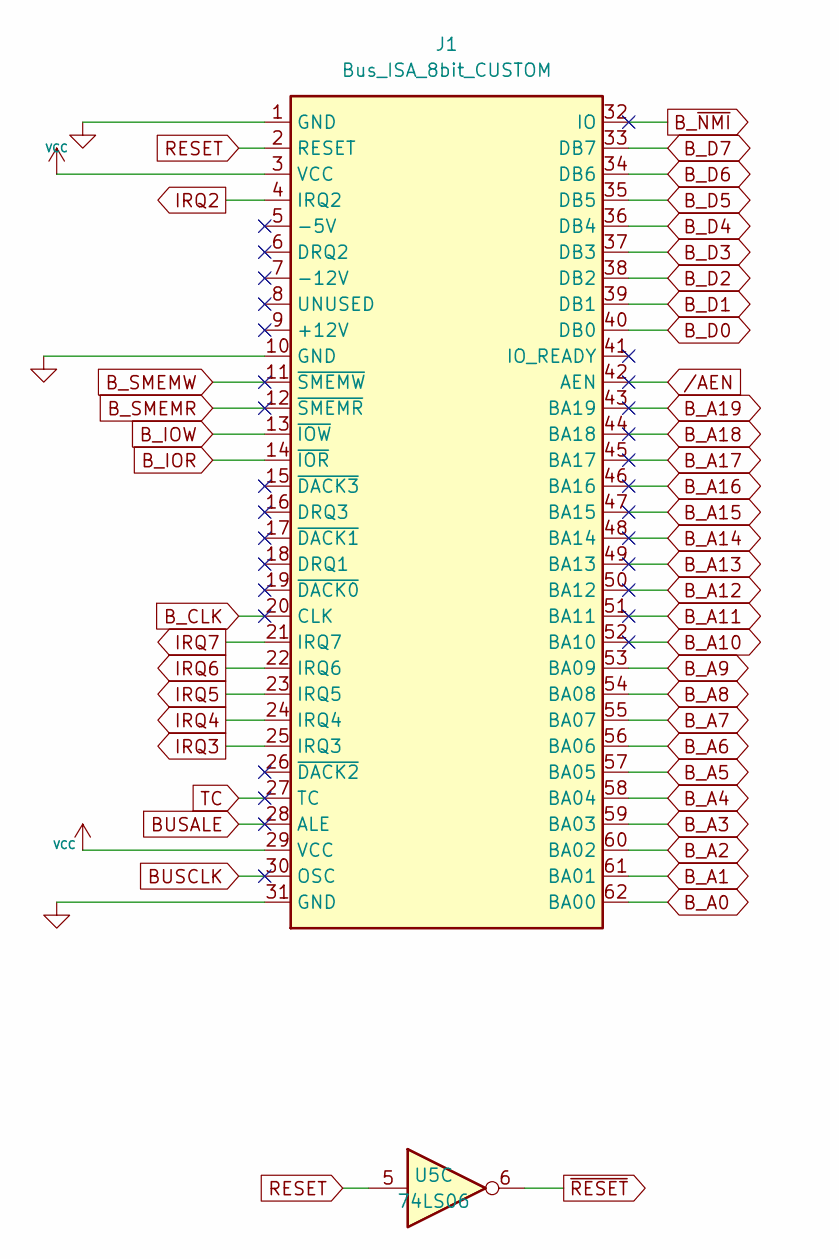
[picture p185: schematic ISA.kicad_sch, ISA MULTI IO]

Parts:
J1: Bus_ISA_8bit_CUSTOM; BUSEDGE_XT
U5: 74LS06; STD_DDW_DIP14

Connections:
BUSALE: J1.28 (ALE)
BUSCLK: J1.30 (OSC)
B_A0: J1.62 (BA00); also elsewhere on the board
B_A1: J1.61 (BA01); also elsewhere on the board
B_A2: J1.60 (BA02); also elsewhere on the board
B_A3: J1.59 (BA03); also elsewhere on the board
B_A4: J1.58 (BA04); also elsewhere on the board
B_A5: J1.57 (BA05); also elsewhere on the board
B_A6: J1.56 (BA06); also elsewhere on the board
B_A7: J1.55 (BA07); also elsewhere on the board
B_A8: J1.54 (BA08); also elsewhere on the board
B_A9: J1.53 (BA09); also elsewhere on the board
B_A10: J1.52 (BA10)
B_A11: J1.51 (BA11)
B_A12: J1.50 (BA12)
B_A13: J1.49 (BA13)
B_A14: J1.48 (BA14)
B_A15: J1.47 (BA15)
B_A16: J1.46 (BA16)
B_A17: J1.45 (BA17)
B_A18: J1.44 (BA18)
B_A19: J1.43 (BA19)
B_CLK: J1.20 (CLK)
B_D0: J1.40 (DB0); also elsewhere on the board
B_D1: J1.39 (DB1); also elsewhere on the board
B_D2: J1.38 (DB2); also elsewhere on the board
B_D3: J1.37 (DB3); also elsewhere on the board
B_D4: J1.36 (DB4); also elsewhere on the board
B_D5: J1.35 (DB5); also elsewhere on the board
B_D6: J1.34 (DB6); also elsewhere on the board
B_D7: J1.33 (DB7); also elsewhere on the board
B_IOR: J1.14 (~IOR); also elsewhere on the board
B_IOW: J1.13 (~IOW); also elsewhere on the board
B_SMEMR: J1.12 (~SMEMR)
B_SMEMW: J1.11 (~SMEMW)
B_~NMI: J1.32 (IO)
GND: J1.1 (GND), J1.10 (GND), J1.31 (GND); also elsewhere on the board
IRQ2: J1.4 (IRQ2); also elsewhere on the board
IRQ3: J1.25 (IRQ3); also elsewhere on the board
IRQ4: J1.24 (IRQ4); also elsewhere on the board
IRQ5: J1.23 (IRQ5); also elsewhere on the board
IRQ6: J1.22 (IRQ6); also elsewhere on the board
IRQ7: J1.21 (IRQ7); also elsewhere on the board
RESET: J1.2 (RESET), U5.5
TC: J1.27 (TC)
VCC: J1.3 (VCC), J1.29 (VCC); also elsewhere on the board
/AEN: J1.42 (AEN)
~RESET: U5.6; also elsewhere on the board

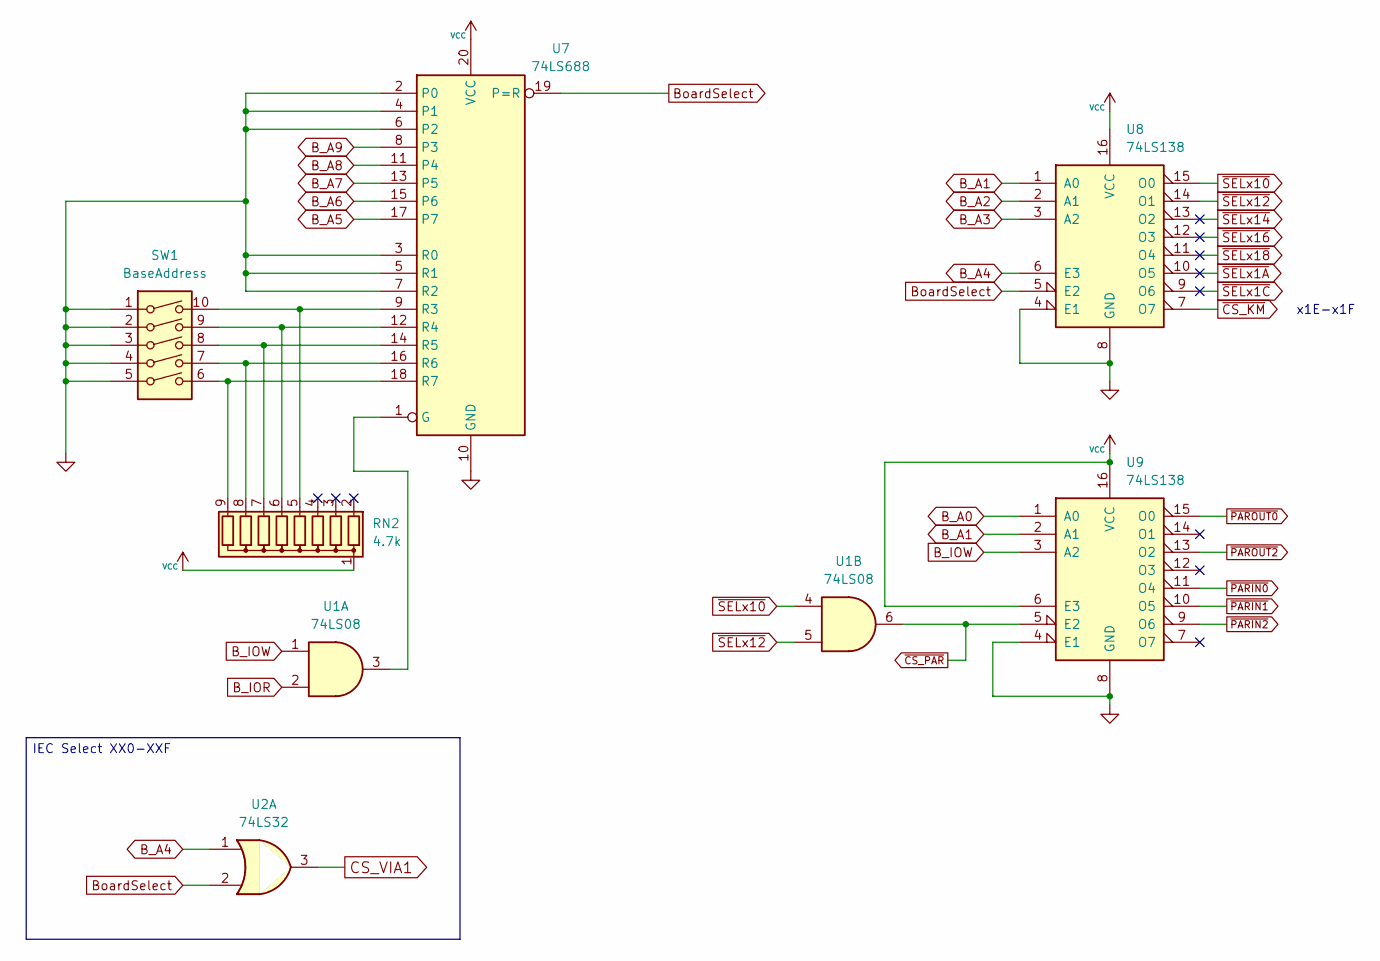
[picture p186: schematic CardSelect.kicad_sch, ISA MULTI IO]

Parts:
RN2: 4.7k; STD_DDW_SIP9
SW1: BaseAddress; STD_DDW_DIP10
U1: 74LS08; STD_DDW_DIP14
U2: 74LS32; STD_DDW_DIP14
U7: 74LS688; STD_DDW_DIP20
U8, U9: 74LS138; STD_DDW_DIP16

Connections:
B_A0: U9.1 (A0); also elsewhere on the board
B_A1: U8.1 (A0), U9.2 (A1); also elsewhere on the board
B_A2: U8.2 (A1); also elsewhere on the board
B_A3: U8.3 (A2); also elsewhere on the board
B_A4: U2.1, U8.6 (E3); also elsewhere on the board
B_A5: U7.17 (P7); also elsewhere on the board
B_A6: U7.15 (P6); also elsewhere on the board
B_A7: U7.13 (P5); also elsewhere on the board
B_A8: U7.11 (P4); also elsewhere on the board
B_A9: U7.8 (P3); also elsewhere on the board
B_IOR: U1.2; also elsewhere on the board
B_IOW: U1.1, U9.3 (A2); also elsewhere on the board
BoardSelect: U2.2, U7.19 (P=R), U8.5 (E2)
CS_VIA1: U2.3; also elsewhere on the board
GND: SW1.1, SW1.2, SW1.3, SW1.4, SW1.5, U7.2 (P0), U7.3 (R0), U7.4 (P1), U7.5 (R1), U7.6 (P2), U7.7 (R2), U7.10 (GND), U8.4 (E1), U8.8 (GND), U9.4 (E1), U9.8 (GND); also elsewhere on the board
unnamed: RN2.5 (R4), SW1.10, U7.9 (R3)
unnamed: RN2.6 (R5), SW1.9, U7.12 (R4)
unnamed: RN2.7 (R6), SW1.8, U7.14 (R5)
unnamed: RN2.8 (R7), SW1.7, U7.16 (R6)
unnamed: RN2.9 (R8), SW1.6, U7.18 (R7)
unnamed: U1.3, U7.1 (G)
VCC: RN2.1 (common), U7.20 (VCC), U8.16 (VCC), U9.6 (E3), U9.16 (VCC); also elsewhere on the board
~CS_KM: U8.7 (O7); also elsewhere on the board
~CS_PAR: U1.6, U9.5 (E2); also elsewhere on the board
~PARIN0: U9.11 (O4); also elsewhere on the board
~PARIN1: U9.10 (O5); also elsewhere on the board
~PARIN2: U9.9 (O6); also elsewhere on the board
~PAROUT0: U9.15 (O0); also elsewhere on the board
~PAROUT2: U9.13 (O2); also elsewhere on the board
~SELx1A: U8.10 (O5)
~SELx1C: U8.9 (O6)
~SELx10: U1.4, U8.15 (O0)
~SELx12: U1.5, U8.14 (O1)
~SELx14: U8.13 (O2)
~SELx16: U8.12 (O3)
~SELx18: U8.11 (O4)

Notes on the sheet:
IEC Select XX0-XXF
x1E-x1F

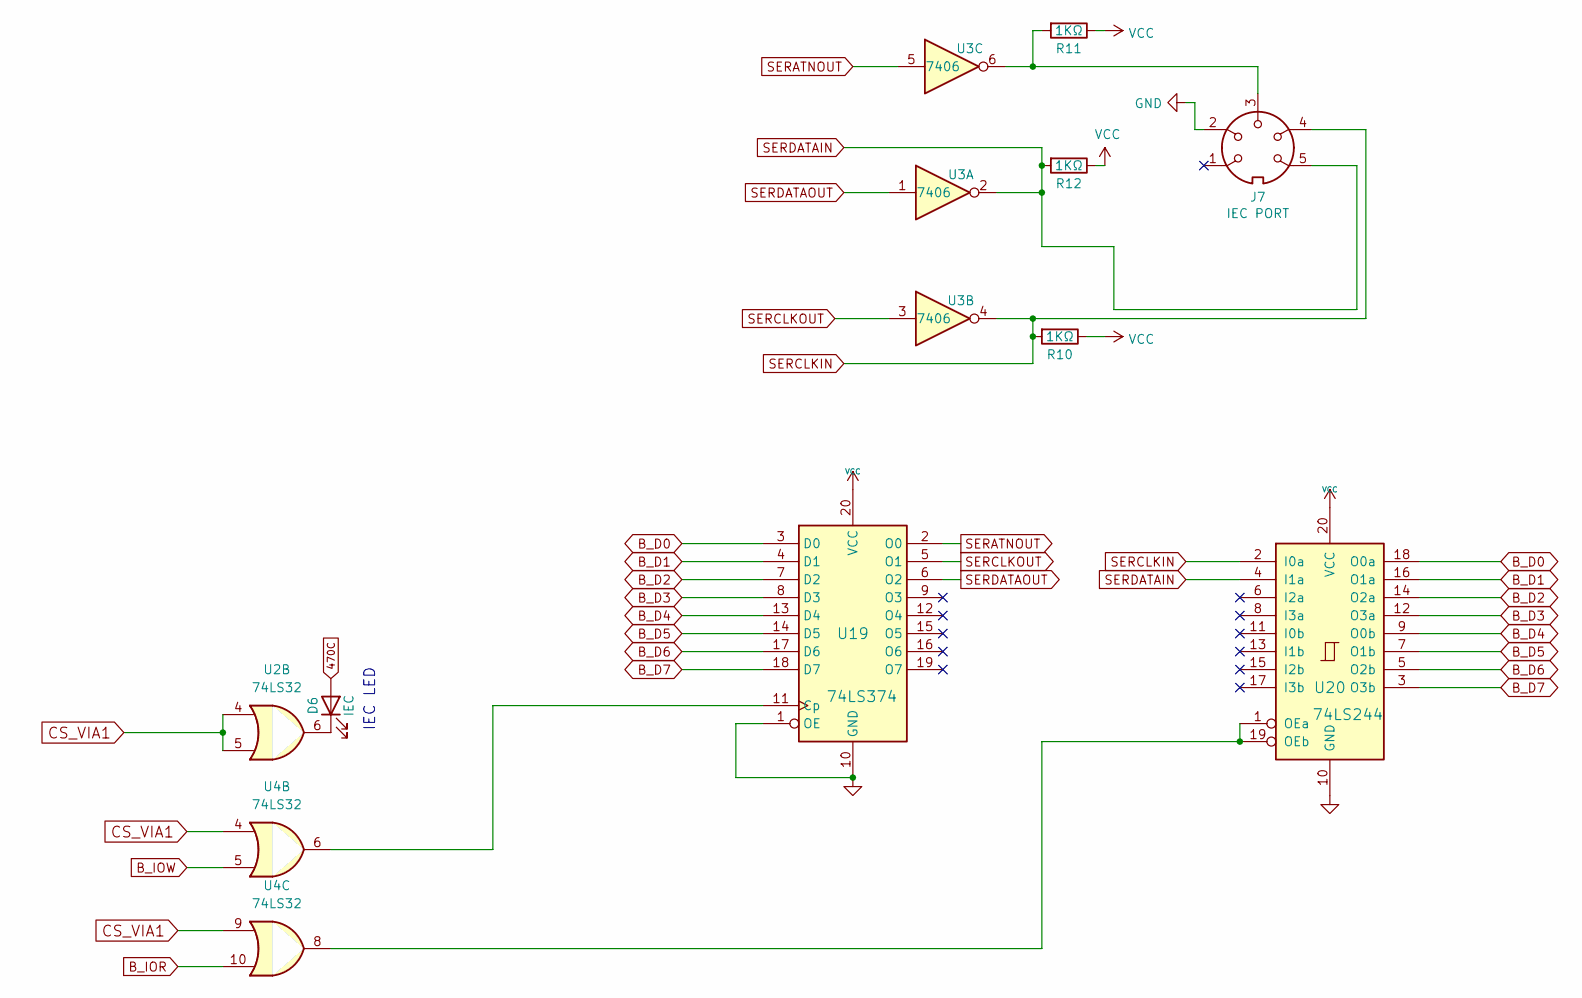
[picture p187: schematic IEC.kicad_sch, ISA MULTI IO]

Parts:
D6: IEC; STD_DDW_LED5
J7: IEC PORT; iec_din6
R10, R11, R12: 1KΩ; STD_DDW_RESISTOR
U2, U4: 74LS32; STD_DDW_DIP14
U3: 7406; STD_DDW_DIP14
U19: 74LS374; STD_DDW_DIP20
U20: 74LS244; STD_DDW_DIP20

Connections:
470C: D6.2 (A); also elsewhere on the board
B_D0: U19.3 (D0), U20.18 (O0a); also elsewhere on the board
B_D1: U19.4 (D1), U20.16 (O1a); also elsewhere on the board
B_D2: U19.7 (D2), U20.14 (O2a); also elsewhere on the board
B_D3: U19.8 (D3), U20.12 (O3a); also elsewhere on the board
B_D4: U19.13 (D4), U20.9 (O0b); also elsewhere on the board
B_D5: U19.14 (D5), U20.7 (O1b); also elsewhere on the board
B_D6: U19.17 (D6), U20.5 (O2b); also elsewhere on the board
B_D7: U19.18 (D7), U20.3 (O3b); also elsewhere on the board
B_IOR: U4.10; also elsewhere on the board
B_IOW: U4.5; also elsewhere on the board
CS_VIA1: U2.4, U2.5, U4.4, U4.9; also elsewhere on the board
GND: J7.2, U19.1 (OE), U19.10 (GND), U20.10 (GND); also elsewhere on the board
unnamed: D6.1 (K), U2.6
unnamed: J7.3, R11.2, U3.6
unnamed: U4.6, U19.11 (Cp)
unnamed: U4.8, U20.1 (OEa), U20.19 (OEb)
SERATNOUT: U3.5, U19.2 (O0)
SERCLKIN: J7.4, R10.2, U3.4, U20.2 (I0a)
SERCLKOUT: U3.3, U19.5 (O1)
SERDATAIN: J7.5, R12.2, U3.2, U20.4 (I1a)
SERDATAOUT: U3.1, U19.6 (O2)
VCC: R10.1, R11.1, R12.1, U19.20 (VCC), U20.20 (VCC); also elsewhere on the board

Notes on the sheet:
IEC LED

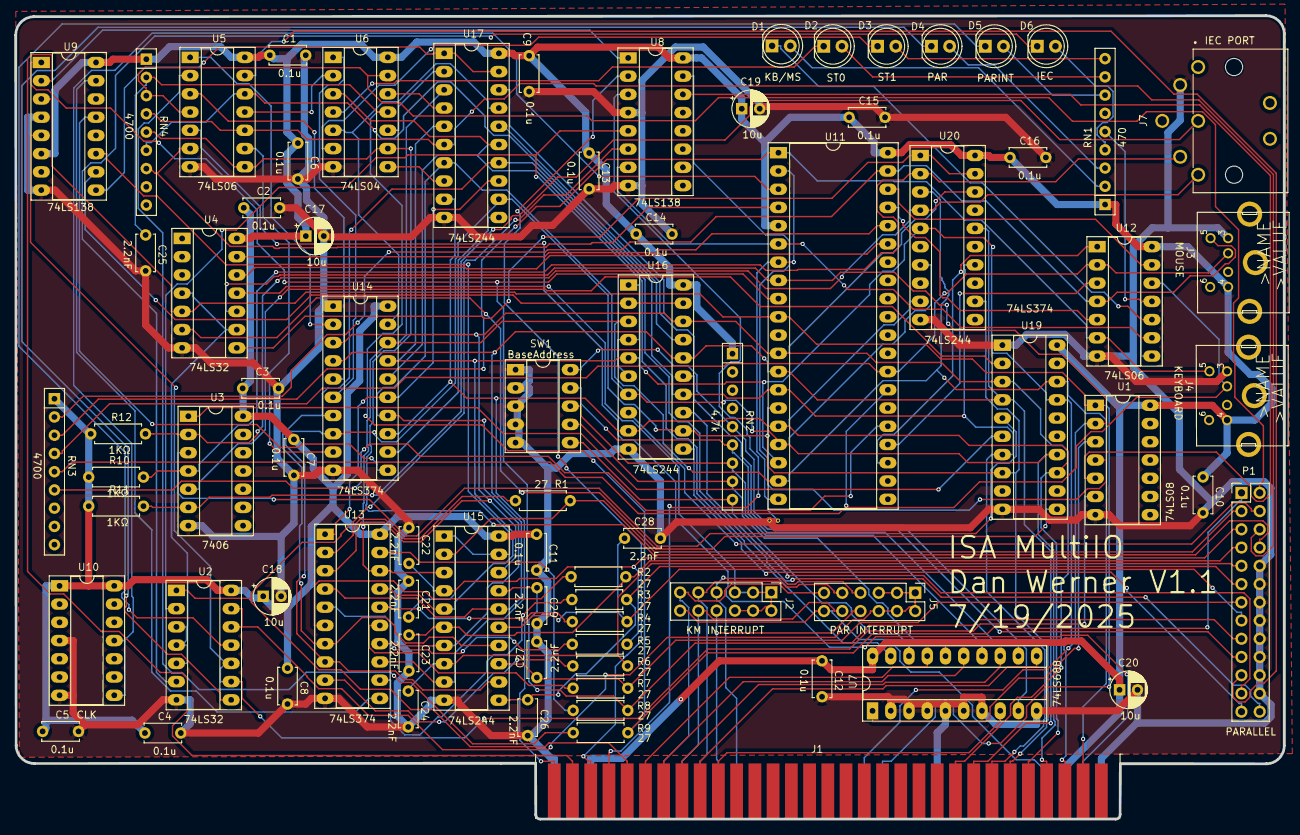
[picture p188: board MULTIIO.kicad_pcb from above]

Board: 2 copper layers, 176.7 x 111.9 mm, 79 parts (0 on the bottom side), 122 nets.
