danwerner21/ISA_IO/(commit log)

2025-06-21 fix ESP layout issues
    [CardSelect.kicad_sch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]
2025-06-29 ESPIO updates
    [CardSelect.kicad_sch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]
2025-07-20 multi io work
    [CardSelect.kicad_sch, IEC.kicad_sch, ISA.kicad_sch, Keyboard.kicad_sch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]
2026-01-18 video card updates
    [CardSelect.kicad_sch, ISA.kicad_sch, audio.kicad_sch, esp.kicad_sch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]
2026-02-01 version 1.1
    [CardSelect.kicad_sch, ISA.kicad_sch, audio.kicad_sch, esp.kicad_sch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]
2026-03-22 sound updates
    [CardSelect.kicad_sch, ISA.kicad_sch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]
2026-06-07 sound card working
    [CardSelect.kicad_sch, ISA.kicad_sch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]
2026-06-15 fix 80 col render
    [render_text.c]
